kopiecki/anc/docs/polsl/sd1/main.tex

\documentclass{beamer}

\usetheme{Boadilla}
\usepackage{polski}
\usepackage{times}
\usepackage[T1]{fontenc}
\usepackage{graphicx}
\usepackage{listings}
\usepackage{hyperref}
\usefonttheme{serif}

\title{Seminarium dyplomowe}
\subtitle{Układ aktywnego tłumienia hałasu pod nadzorem jądra systemu Linux z rozszerzeniami real-time}

\author{Daniel Kopiecki}
\institute{Politechnika Śląska}
\date{\today}

\begin{document}

\begin{frame}
\titlepage
\end{frame}

\begin{frame}
\frametitle{Część sprzętowa}
\framesubtitle{Uproszczony schemat architektury}
\begin{figure}[H]
\centering
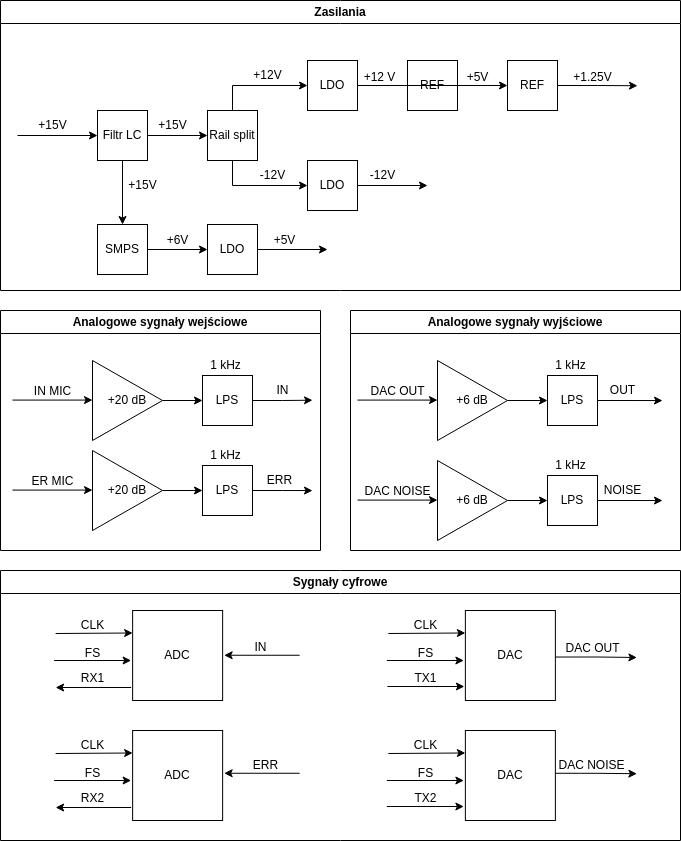
[picture p46: docs/polsl/sd1/build/images/arch.png]

\caption{Architektura sprzętowa}
\end{figure}
\end{frame}

\begin{frame}
\frametitle{Część sprzętowa}
\framesubtitle{Warstwa przednia}

\begin{figure}[H]
\centering
\begin{minipage}{.4\textwidth}
  \centering
  
\end{minipage}%
\begin{minipage}{.4\textwidth}
  \centering
  
\end{minipage}
\caption{Warstwa przednia, 1}
\end{figure}

\end{frame}

\begin{frame}
\frametitle{Część sprzętowa}
\framesubtitle{Warstwa przednia}

\begin{figure}[H]
\centering
\begin{minipage}{.4\textwidth}
  \centering
  
\end{minipage}%
\begin{minipage}{.4\textwidth}
  \centering
  
\end{minipage}
\caption{Warstwa przednia, 2}
\end{figure}

\end{frame}

\begin{frame}
\frametitle{Część sprzętowa}
\framesubtitle{Warstwy środkowe}

\begin{figure}[H]
\begin{minipage}{.4\textwidth}
  \centering
  
\end{minipage}%
\begin{minipage}{.4\textwidth}
  \centering
  
\end{minipage}
\caption{Warstwy środkowe}
\end{figure}

\end{frame}

\begin{frame}
\frametitle{Część sprzętowa}
\framesubtitle{Warstwa dolna}

\begin{figure}[H]
\begin{minipage}{.4\textwidth}
  \centering
  
\end{minipage}%
\begin{minipage}{.4\textwidth}
  \centering
  
\end{minipage}
\caption{Warstwa dolna}
\end{figure}
\end{frame}

\begin{frame}
\frametitle{Część sprzętowa}
\framesubtitle{Kilka ciekawych kwestii implementacyjnych}
\begin{itemize}
\item Wszystko wpływa na wszystko
\item Odległość pomiędzy ścieżkami ma \textbf{kolosalne znaczenie}
\item Kwestie obligatoryjne - rozłożenie warst (\textit{stackup}) oraz umiejscowienie komponentów
\end{itemize}
\begin{figure}[H]
\centering

\end{figure}
\end{frame}

\begin{frame}
\frametitle{Część sprzętowa}
\framesubtitle{Kilka ciekawych kwestii implementacyjnych}
\begin{itemize}
\item Płaszczyzną odniesienia dla relatywnie szybkich sygnałów cyfrowych może w równym stopniu być płaszczyzna masy, jak i płaszczyzna \textbf{zasilania}
\item Z Henry W. Ott, \textit{Electromagnetic Compatibility Engineering} - układ scalony \textbf{nie jest źródłem prądu} sam w sobie, lecz stanowi jedynie jego \textbf{sterownik}. Prawdziwym źródłem jest kondensator odsprzęgający lub/i pasożytnicza pojemność pomiędzy ścieżkami/płaszczyznami.
\end{itemize}
\begin{figure}[H]
\centering
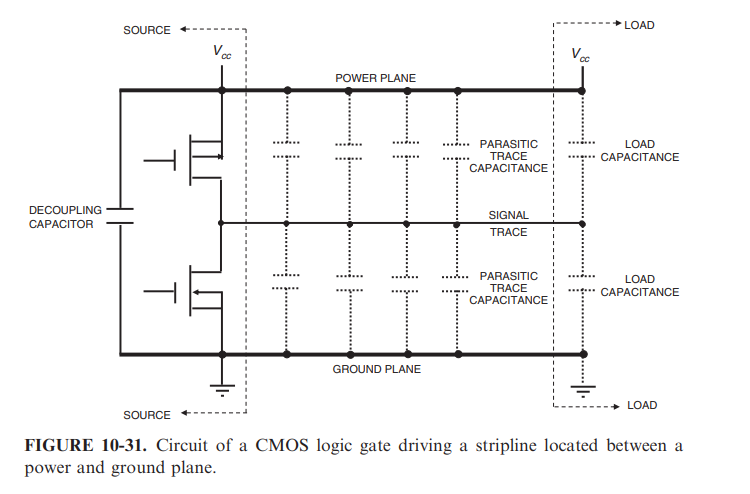
[picture p47: docs/polsl/sd1/images/l_current_flow.png]

\caption{Możliwe drogi sygnałów cyfrowych}
\end{figure}
\end{frame}

\begin{frame}
\frametitle{Część sprzętowa}
\framesubtitle{Wykorzystywany protokół cyfrowy}
\begin{itemize}
\item Bardzo ważną kwestią implementacyjną jest opracowanie synchronicznego próbkowania wszystkich przetworników. Aby to uzyskać, konieczny jest protokół cyfrowy, który zapewni zegar, odpowiednią manipulację selektorem, dwie linie RX oraz dwie linie TX.
\end{itemize}
\begin{figure}[H]
\centering
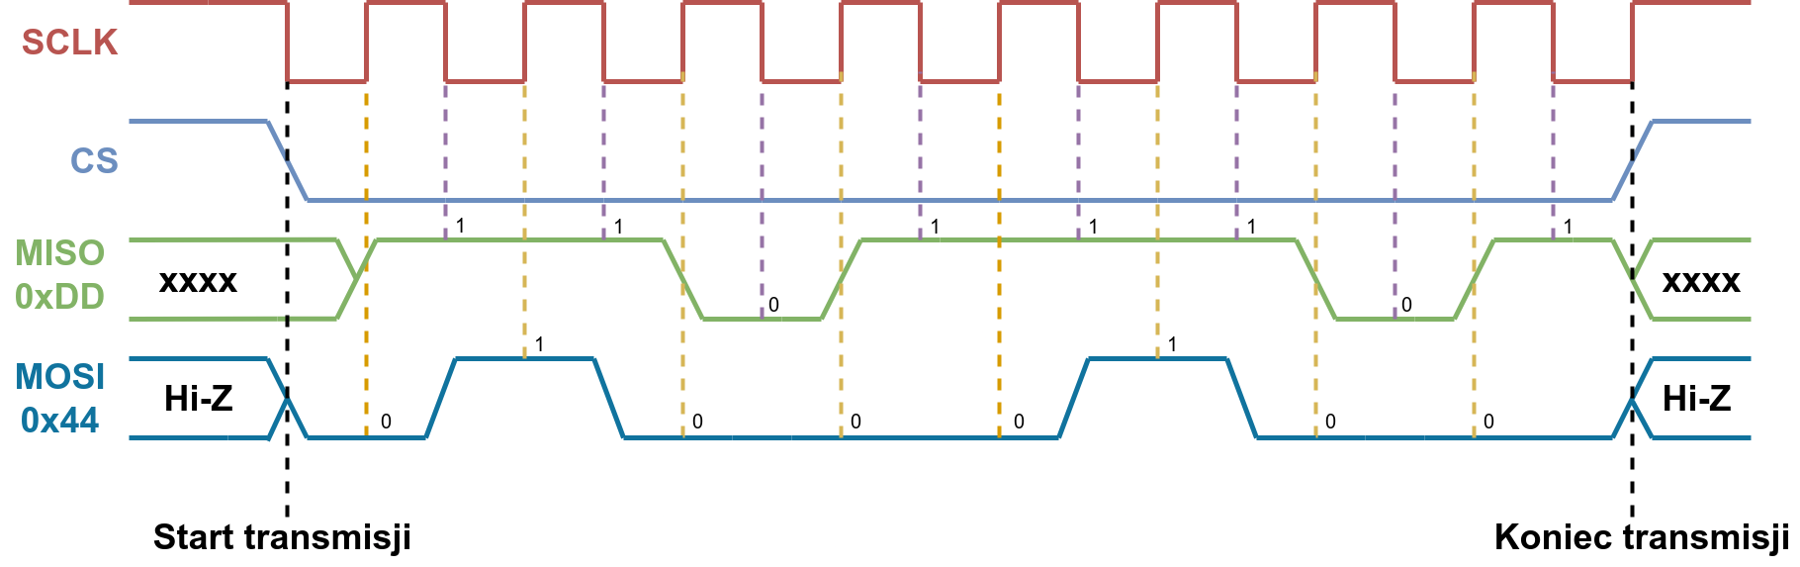
[picture p48: docs/polsl/thesis/graf/hw/spi.png]

\caption{Protokół SPI - \textit{Serial Peripheral Interface}}
\end{figure}

\end{frame}

\begin{frame}
\frametitle{Część sprzętowa}
\framesubtitle{Protokół cyfrowy - możliwe rozwiązania}
\begin{itemize}
\item McASP - protokół cyfrowy opracowany przez Texas Instruments w celu interakcji z wielokanałowymi kartami dźwiękowymi - podejście \textbf{optymalne}
\end{itemize}
\begin{figure}[H]
\centering
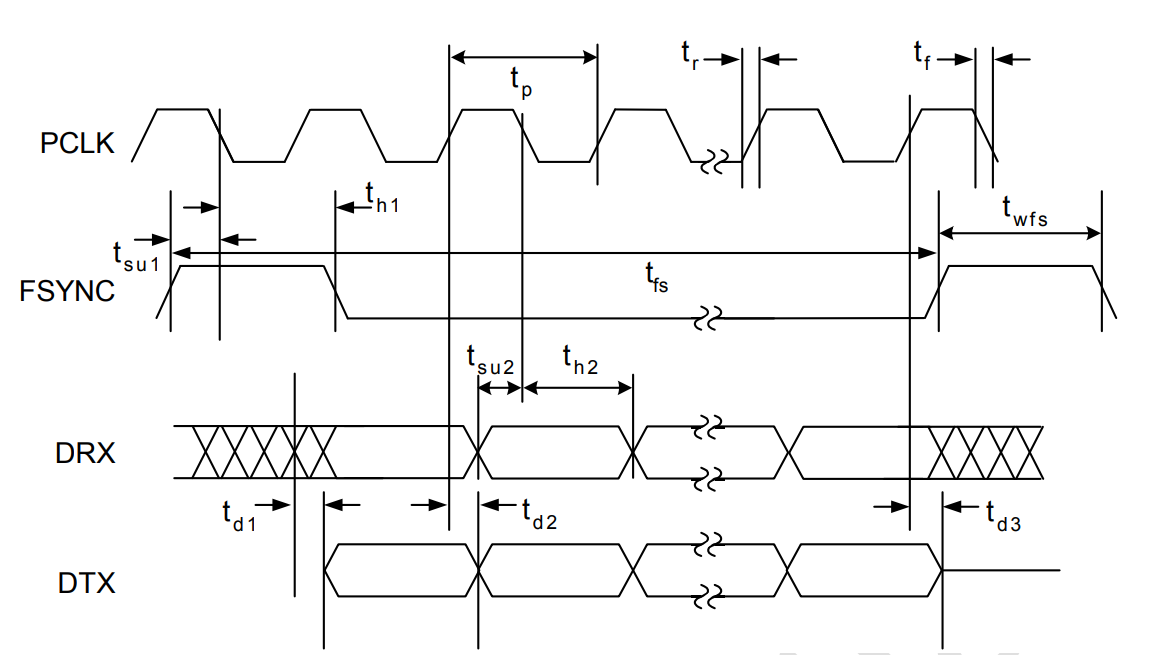
[picture p49: docs/polsl/temporary_project/build/images/mcasp.png]

\caption{Protokół McASP - \textit{Multichannel Audio Serial Port}}
\end{figure}

\end{frame}

\begin{frame}
\frametitle{Część sprzętowa}
\framesubtitle{Protokół cyfrowy - możliwe rozwiązania}
\begin{itemize}
\item \textit{Bit banging} - metoda transmisji danych oparta na implementacji dedykowanego protokołu cyfrowego z wykorzystaniem dwustanowych pinów wejściowo-wyjściowych (\textit{GPIOs}) - podejście \textbf{ostateczne}. Wymaga implementacji sterownika na najniższym poziomie.
\end{itemize}
\end{frame}

\begin{frame}[fragile]
\frametitle{Część sprzętowo-programowa}
\framesubtitle{Protokół cyfrowy - bit banging, przykład}

\begin{lstlisting}[frame=single, language=C, basicstyle=\tiny]
void tx_byte(uint8_t data)
{
	gpio_low(SD_CS);
	for (uint8_t i = 0u; i < 8u; ++i) {
		if (data & 0x80u)
			gpio_high(SD_DI);
		else
			gpio_low(SD_DI);
		
		gpio_low(SD_CLK);
		delay();
		gpio_high(SD_CLK);
		
		data <<= 1u;
	}
	
	gpio_low(SD_CS);
}
\end{lstlisting}
\end{frame}

\begin{frame}
\frametitle{Część programowa}
\framesubtitle{ALSA}
\begin{itemize}
\item Na chwilę obecną wybrana została ścieżka \textbf{optymalna}.
\item Tak jak pisano wcześniej, protokół McASP wykorzystywany jest do interakcji z kartami dźwiękowymi. 
\item Głównym środowiskiem do interakcji z urządzeniami audio pod systemem operacyjnym GNU/Linux jest \textbf{ALSA} (\textit{Advanced Linux Sound Architecture})

\begin{figure}[H]
\centering
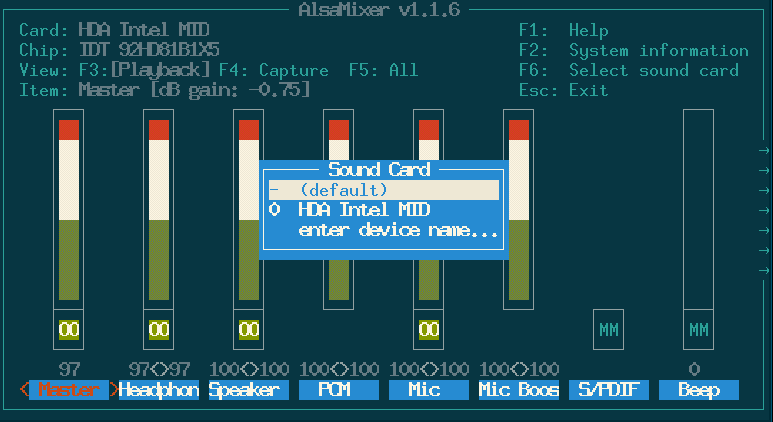
[picture p50: docs/polsl/sd1/images/alsamixer.png]

\caption{ALSA - widok aplikacji \textit{AlsaMixer} (\$ alsamixer)}
\end{figure}

\end{itemize}
\end{frame}

\begin{frame}
\frametitle{Część programowa}
\framesubtitle{ALSA}
\begin{itemize}
\item \textbf{ALSA} udostępnia duże, niskopoziomowe API do interakcji z kartami dźwiękowymi z poziomu przestrzeni użytkownika (\textit{userspace}).
\item Plik nagłówkowy biblioteki nosi nazywę \textit{asoundlib.h} a sama biblioteka \textit{libasound}
\end{itemize}

\begin{figure}[H]
\centering
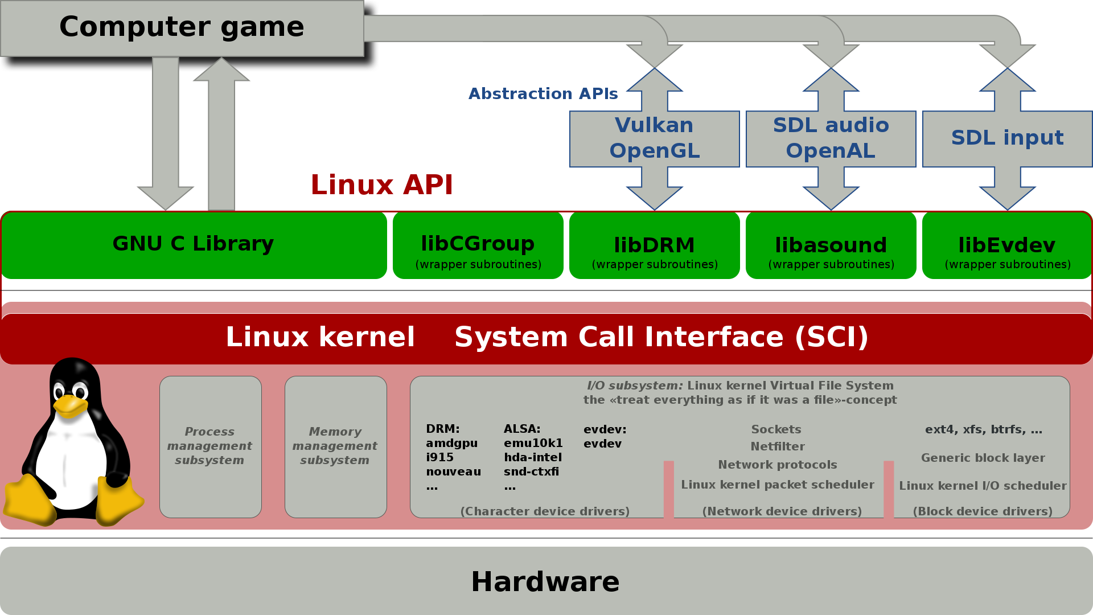
[picture p51: docs/polsl/sd1/images/alsa.png]

\caption{Schemat interkacji jądro - przestrzeń użytkownika}
\end{figure}

\end{frame}

\begin{frame}
\frametitle{Część programowa}
\framesubtitle{Cyfrowa reprezentacja dźwięku}
\begin{itemize}
\item Cyfrową reprezentacją dźwięku, wykorzystywaną przez środowisko \textbf{ALSA} jest modulacja pulsowo-kodowa (\textit{PCM - Pulse Code Modulation})

\begin{figure}[H]
\centering
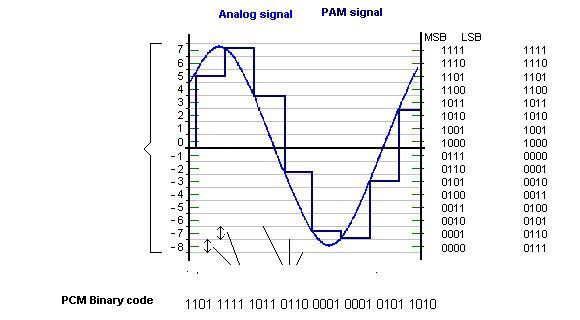
[picture p52: docs/polsl/sd1/build/images/pcm.jpg]

\caption{Modulacja pulsowo-kodowa}
\end{figure}

\end{itemize}

\end{frame}

\begin{frame}
\frametitle{Część programowa}
\framesubtitle{ALSA}
\begin{itemize}
\item ALSA korzysta ze specjalnego nazewnictwa urządzeń dźwiękowych dostępnych dla użytkownika. Mogą to być rzeczywiste urządzenia (karty dźwiękowe), lub ich wirtualne reprezentacje.
\item W przypadku fizycznych urządzeń, korzysta się z formatu \textit{hw:i,j}, gdzie \textit{i} oznacza numer karty, a \textit{j} numer urządzenia kontrolowanego przez kartę, czyli przypkładowo zestawu głośników lub mikrofonu.
\item W przpyadku wirtualnych urządzeń, korzysta się z formatu \textit{plughw:i, j}.
\end{itemize}

\begin{figure}[H]
\centering
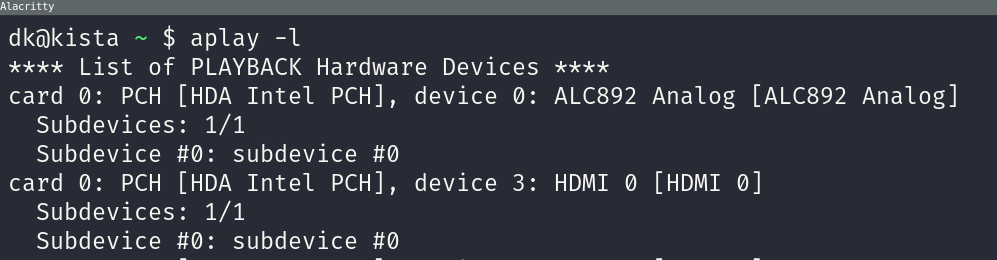
[picture p53: docs/polsl/sd1/build/images/aplay.png]

\caption{Rezultat polecenia \textit{aplay -l}}
\end{figure}

\end{frame}

\begin{frame}
\frametitle{Część programowa}
\framesubtitle{ALSA - lokowanie próbek}
\begin{itemize}
\item Na poziomie sterownika jądra sprzętu audio, \textbf{ALSA} tworzy bufor cykliczny, którego długość można modyfikować używając udostępnionego API.
\item Jeżeli bufor jest zapełniony, sterownik jądra generuje przerwanie. Rolę obsługi przerwania obejmuje DMA (\textit{Direct Memory Access}), które nieblokująco przenosi próbki z bufora sterownika do bufora aplikacji.
\end{itemize}

\begin{figure}[H]
\centering

\caption{Bufor cykliczny}
\end{figure}
\end{frame}

\begin{frame}
\frametitle{Część programowa}
\framesubtitle{ALSA - lokowanie próbek}
\begin{itemize}
\item Bufor tworzony przez sterownik jądra zapełniany jest przez \textbf{fragmenty} (lub okresy, \textit{periods}).
\item \textbf{Fragmenty} składają się z określonej liczby \textbf{ramek} (\textit{frames}).
\item \textbf{Ramka} składa się z próbek dla każdego kanału karty dźwiękowej (liczba kanałów może być wyspecifikowana, tak jak format próbki).
\end{itemize}

\begin{figure}[H]
\centering
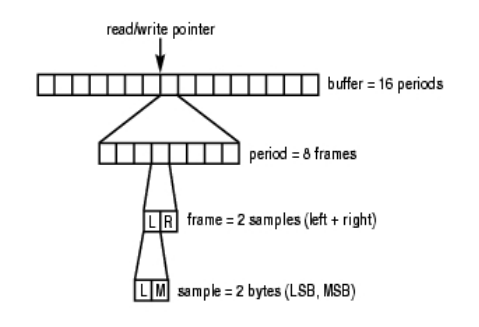
[picture p54: docs/polsl/sd1/images/alsa_frames.png]

\caption{Podział danych}
\end{figure}
\end{frame}
\begin{frame}
\frametitle{Część programowa}
\frametitle{ALSA - bufory}
\begin{itemize}
\item Jeżeli aplikacja jest uruchomiona, to dane w nieprzerwany sposób są transportowane z/do bufora cyklicznego sterownika jądra do/z bufora aplikacji.
\item W przypadku odczytywania danych (\textit{capture}), jeżeli nie są one odpowiednio szybko czytane, to może dojść do sytuacji, kiedy dane w buforze cyklicznym zostaną nadpisane nowymi. Taka sytuacja nosi nazwę \textbf{buffer overrun}.
\item W przypadku zapisywania danych (\textit{playback}), jeżeli nie są one odpowiednio szybko wysyłane, to może dojść do odwrotnej sytuacji, czyli bufor cykliczny w pewnym momencie się całkowicie opróżni. Taka sytuacja nosi nazwę \textbf{buffer underrun}.
\end{itemize}

\end{frame}

\begin{frame}
\frametitle{Część programowa}
\framesubtitle{ALSA - latencja}
\begin{itemize}
\item Bardzo ważnym pojęciem związanym z przetwarzaniem sygnału audio jest \textbf{latencja}
\item \textbf{Latencja} to nic innego jak opóźnienie, które towarzyszy sygnałowi audio od momentu trafienia na wejście systemu do jego opuszczenia.
\item W środowisku \textbf{ALSA} latencja definiowana jest następującą zależnością:
\begin{equation}
	T_L = \frac{n_fF_{rb}}{f_sP_{rb}}
\end{equation}
gdzie $n_f$ - ilość fragmentów, $F_{rb}$ - rozmiar fragmentu w bajtach, $f_s$ - częstotliwość próbkowania, $P_{rb}$ - rozmiar próbki w bajtach. 
\item Licznik równania to nic innego jak zadeklarowany rozmiar bufora w bajtach, czyli całe wyrażenie odpowiada czasowi potrzebnemu na przesłanie całego bufora (zbuforowaniu danych).
\end{itemize}
\end{frame}

\begin{frame}
\frametitle{Część programowa}
\framesubtitle{ALSA - latencja}
Przykładowo
\begin{itemize}
\item Chcąc odtworzyć dźwięk z szesnatostobitowego systemu stereo (dwa kanały, głośnik lewy i prawy, próbki po 16 bitów $=$ 2 bajty) z typową częstotliwością audio równą 44100 kHz, nasza \textbf{ramka} ma rozmiar 4 bajtów (dwie dwu-bajtowe próbki, jedna na kanał). Deklarując rozmiar \textbf{fragmentu} na 2048 \textbf{ramek}, otrzymujemy długość \textbf{fragmentu} w bajtach równą 8192 bajtów.
\item Deklarując rozmiar bufora na dwa fragmenty, otrzymujemy rozmiar bufora równy 16384 bajtów.
\item Zbuforowanie tych danych, definiujące latencję, w tak skonstruowanym systemie zajmie $\frac{16384}{44100 * 4} \approx 0.093$ s.
\end{itemize}
\end{frame}

\begin{frame}[fragile]
\frametitle{Część programowa}
\framesubtitle{ALSA - przykładowy prosty program}
\begin{lstlisting}[language=C, basicstyle=\tiny]
int playback(uint8_t* const buffer, size_t size)
{
        const uint8_t channels        = 1;
        const uint32_t rate           = 48000;
        const char* pcm_name          = "hw:0,0";
        const snd_pcm_stream_t stream = SND_PCM_STREAM_PLAYBACK;
        const snd_pcm_format_t format = SND_PCM_FORMAT_U8;
        const snd_pcm_access_t access = SND_PCM_ACCESS_RW_INTERLEAVED;
        const uint32_t latency_us     = 500000u;

        snd_pcm_t* pcm_handle = NULL;
        int error             = snd_pcm_open(&pcm_handle, pcm_name, stream, 0);
        if (error < 0)
                return error;

        error = snd_pcm_set_params(
                pcm_handle, format, access, channels, rate, true, latency_us);
        if (error < 0)
                return error;

        for (uint8_t i = 0u; i < 16u; ++i) {
                snd_pcm_sframes_t transfered_frames =
                        snd_pcm_writei(pcm_handle, buffer, size);
                if (transfered_frames < 0)
                        xrun_recover(pcm_handle, transfered_frames, 0);
                else if ((transfered_frames > 0) && (transfered_frames < size))
                        LOG_ERROR("Short write!");
        }

        snd_pcm_drain(pcm_handle);
        snd_pcm_close(pcm_handle);
}
\end{lstlisting}

\end{frame}
\begin{frame}
\frametitle{Wykorzystane materiały}
\begin{itemize}
\item Henry W. Ott, \textit{Electromagnetic Compatibillity Engineering}
\item \href{www.alsa-project.org/wiki}{Strona domowa projektu ALSA}
\item \href{https://www.linuxjournal.com/article/6735}{Jeff Tranter, \textit{Introduction to Sound Programming with ALSA}}, Linux Journal
\end{itemize}
\end{frame}

\end{document}
