kopiecki/anc/docs/polsl/SD1.pdf

## UKŁAD AKTYWNEGO TŁUMIENIA HAŁASU POD NADZOREM JĄDRA SYSTEMU LINUX Z ROZSZERZENIAMI REAL-TIME

Daniel Kopiecki
Promotor: dr inż. Krzysztof Mazur

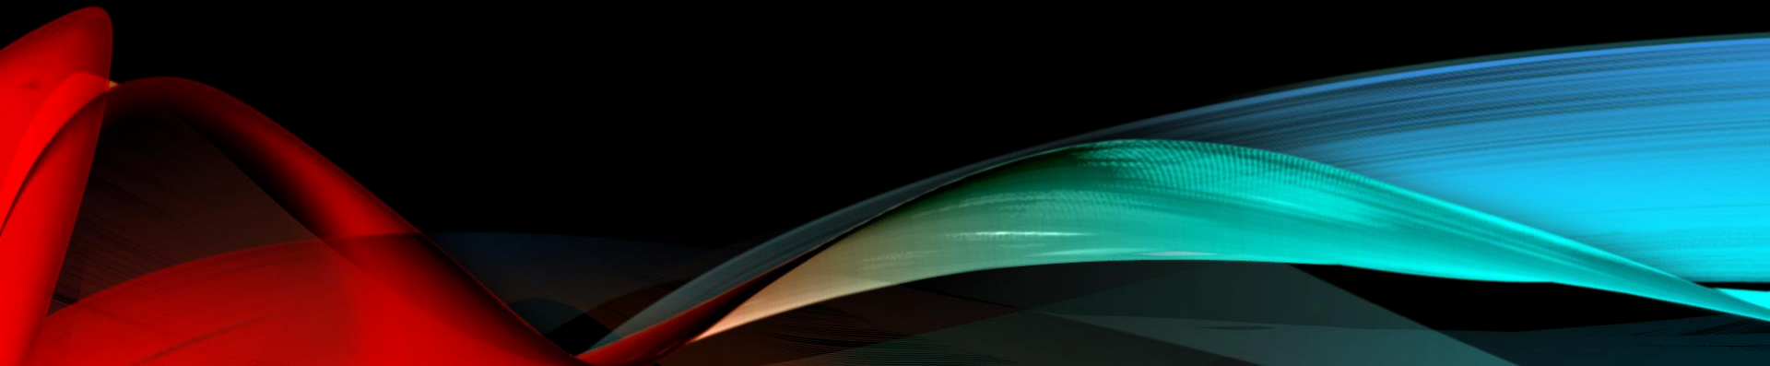
[picture p130: figure]

## PLAN PREZENTACJI

- Główna idea, cel projektu
- Zasada działania
- Schematy ideowe docelowego układu
- Wykorzystywane narzędzia i sprzęt
- Poczynione prace
- Plan na najbliższy czas
- Podsumowanie

## GŁÓWNA IDEA, CEL PROJEKTU

- Zaprojektowanie i sporządzenie sprzętu pozwalającego na akwizycję pomiarów z dwóch mikrofonów, cyfrowe przetwarzanie uzyskanych danych oraz odpowiednie wysterowanie głośnika sygnałem wyjściowym (PCB)
- Kompilacja niestandardowego systemu operacyjnego GNU/Linux na architekturę ARM z uwzględnionymi odpowiednimi sterownikami oraz włączonymi rozszerzeniami real-time
- Implementacja oprogramowania cyfrowego przetwarzania uzyskanych danych, identyfikacji odpowiedzi impulsowej toru dźwięku oraz regulatora adaptacyjnego

CEL: Stworzenie układu pozwalającego na aktywne tłumienie hałasu generowanego sztucznie (zakres do 500 Hz)

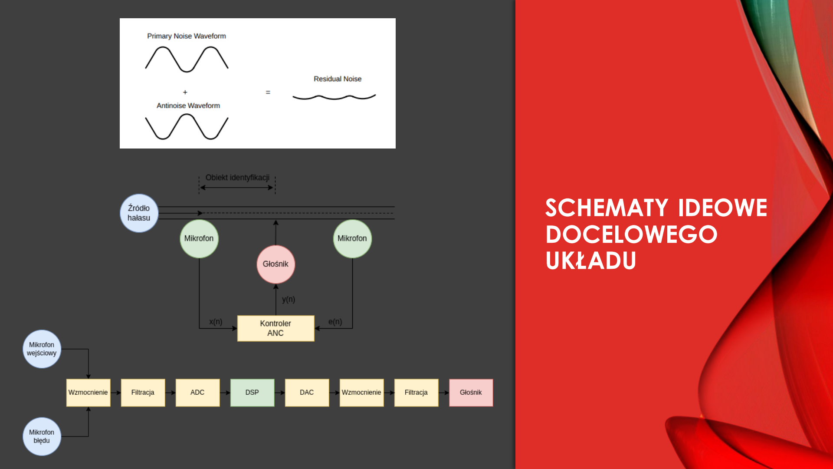
[picture p131: page 4]

SCHEMATY IDEOWE
DOCELOWEGO
UKŁADU

## WYKORZYSTYWANY SPRZĘT

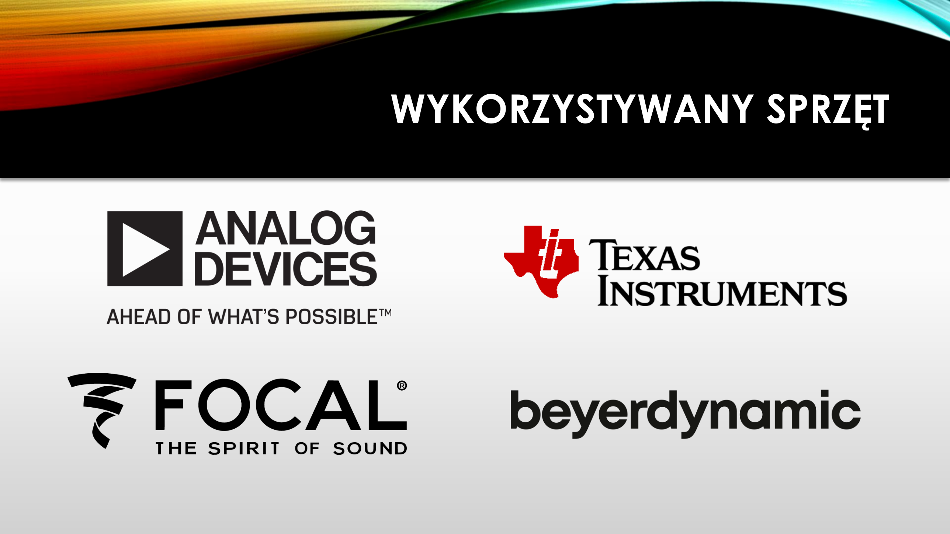
[picture p132: page 5]

## WYKORZYSTYWANE OPROGRAMOWANIE

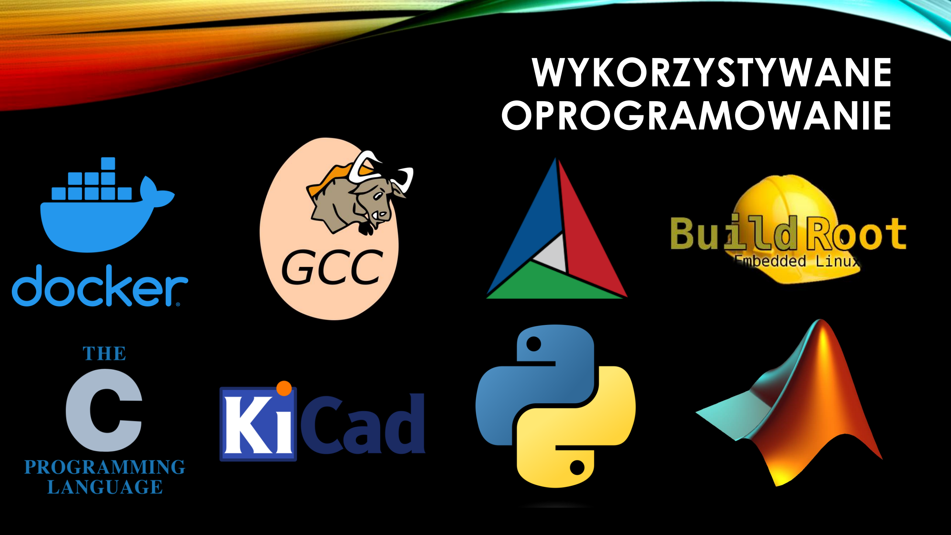
[picture p133: page 6]
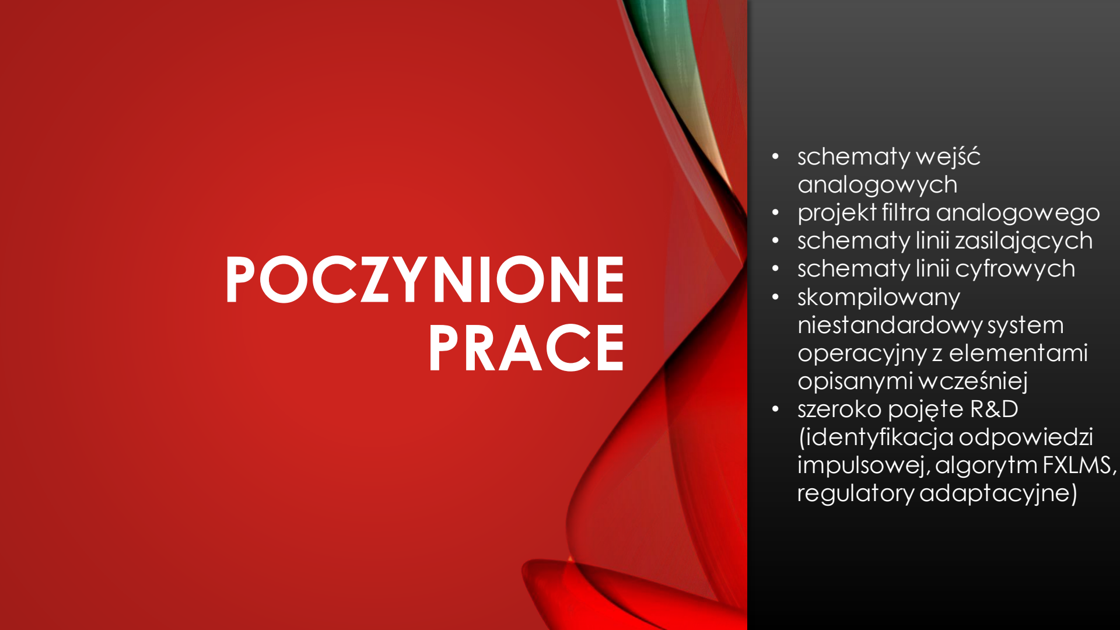
[picture p134: page 7]

# POCZYNIONE PRACE

- schematy wejść
analogowych
- projekt filtra analogowego
- schematy linii zasilających
- schematy linii cyfrowych
- skompilowany
niestandardowy system
operacyjny z elementami
opisanymi wcześniej
- szeroko pojęte R&D
(identyfikacja odpowiedzi
impulsowej, algorytm FXLMS, regulatory adaptacyjne)

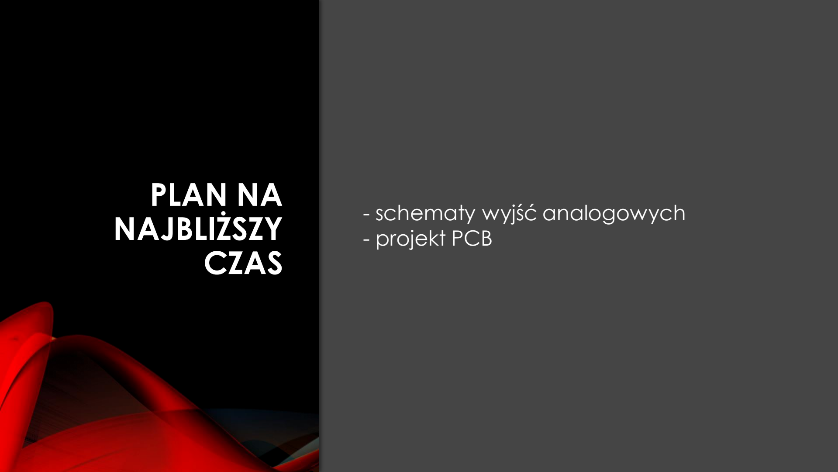
[picture p135: page 8]

## PLAN NA NAJBLIŻSZY CZAS

- schematy wyjść analogowych
- projekt PCB

## DZIEKUJĘ ZA UWAGĘ
