kopiecki/anc/docs/polsl/thesis/chapters/04.tex

\chapter{Implementacja części sprzętowej}

Diagram opisujący zaimplementowaną architekturę sprzętową przedstawiono na
rysunku \ref{hw::arch}:

\begin{figure}[H]
    \centering
    
    \caption{Architektura sprzętowa --- najwyższy poziom.}
    \label{hw::arch}
\end{figure}

\par Jak można zauważyć, na architekturę zaprojekowanej płytki drukowanej
składają się cztery główne sekcje, które komunikują się z~elementami
zewnętrznymi zaznaczonymi na szaro. Z~sekcji można wyróżnić:
\begin{itemize}
    \item Sekcję zasilania (\textbf{PSU}, ang. \textit{Power supply unit}).
    \item Sekcję wejściowych torów analogowych (\textbf{Input}, wejście).
    \item Sekcję wyjściowych torów analogowych (\textbf{Output}, wyjście).
    \item Sekcję przetworników (\textbf{ADC/DAC}).
\end{itemize}

Na diagramie konektory o~najmniejszej grubości reprezentują sygnały analogowe,
z~których można wyróżnić:
\begin{itemize}
    \item $x(t)$ --- sygnał z~mikrofonu referencyjnego przy źródle hałasu.
    \item $e(t)$ --- sygnał z~mikrofonu błędu, mierzącego superpozycję hałasu
    i~antyhałasu.
    \item $y_n(t)$ --- sygnał reperezentujący wygenerowany hałas.
    \item $y_{\text{an}}(t)$ --- sygnał reperezentujący obliczony antyhałas.
\end{itemize}

Każdy z wyszczególnionych wyżej sygnałów analogowych posiada swoje przetworzone
odpowiedniki, które na schemacie zaznaczono z~apostrofem. Pogrubionymi
konektorami zaznaczono szyny zasilania i~są to odpowiednio:
\begin{itemize}
    \item \textbf{AP} (ang. \textit{Analog power}) --- zasilanie sekcji
    analogowych.
    \item \textbf{DP} (ang. \textit{Digital power}) --- zasilanie sekcji
    cyfrowych.
\end{itemize}

Dużą strzałką zaznaczono wykorzystywany protokół cyfrowy, czyli McASP (ang.
\textit{Multi-channel serial port}), który dokładniej opisywany będzie w~sekcji
interfejsu cyfrowego.

\section{Urządzenia zewnętrzne}

\subsection{Mikrofony}

W projekcie wykorzystano mikrofony Behringer ECM8000. Są one bardzo często
wybierane przez amatorów jak i~profesjonalistów w~zastosowaniach pomiarowych
oraz cieszą się dobrymi opiniami. Ich droższym odpowiednikiem jest flagowy
Beyerdynamic MM1, a~najbardziej znaczące parametry \cite{bib:behringer}
przedstawiono poniżej:
\begin{enumerate}
    \item \textbf{Typ} --- pojemnościowy, phantom 15~V do 48 V.
    \item \textbf{Charakterystyka kierunkowa} --- kulista.
    \item \textbf{Odpowiedź częstotliwościowa} --- relatywnie płaska,
    z~pofalowaniami w~paśmie od 5~kHz do 10 kHz i~zakresie od 20~Hz do 20000 Hz.
    \item \textbf{Czułość} --- $15 \text{ }\frac{\text{mV}}{{\text{Pa}}}$.
\end{enumerate}
Czułość mikrofonów informuje o~wartości napięcia dla danego ciśnienia
aktustycznego i~opisuje ją zależność:
\begin{equation} 
        S_{\text{dBV}} = 20 \text{log}_{10} \frac{S_{\text{mV/Pa}}}{U_{\text{ref}}},
        \qquad U_{\text{ref}} = 1000 \text{ }\frac{\text{mV}}{\text{Pa}}.
\end{equation}

Na podstawie tego parametru dobiera się wzmocnienie przedwzmacniacza
\cite{bib:mic}. Dla wybranych mikrofonów z~czułością na poziomie $15 \text{
}\frac{\text{mV}}{{\text{Pa}}}$, uzyskuje się 15~mV dla 1~Pa, co odpowiada 94 dB
SPL. Pracując na hałasach w zakresie od 85 dB SPL do 105 dB SPL, dla górnej
granicy otrzymuje się około 3.5~Pa, czyli odpowiednio około 52.5~mV RMS, co
odpowiada amplitudzie $52.5\sqrt{2}$~mV. W~przypadku przetwornika
analogowo-cyfrowego, pracującego w przedziale od 0 V do 5~V, $52.5\sqrt{2}$~mV z
mikrofonu powinno odpowiadać maksymalnemu zakresowi 2.5~V, co pozwala na
obliczenie wzmocnienia:
\begin{equation}
        k = \frac{U_{\text{out}}}{U_{\text{mic}}} = 
	    \frac{2.5}{0.0525\sqrt{2}} =  33.6717.
        \label{eq::k_preamp}
\end{equation}

\subsection{Zestaw głośnikowy}

Na użytek prywatny, autor posiada parę monitorów studyjnych KRK Classic 8,
spełniających wszystkie wyszczególnione dla zestawu głośników wymagania. Nie
wchodząc w techniczne szczegóły, z~najbardziej znaczących parametrów
\cite{bib:krk} można wyróżnić:

\begin{enumerate}
    \item \textbf{Typ i~konfiguracja} --- aktywny, głośnik wysoko i~nisko tonowy.
    \item \textbf{Maksymalny zakres poziomu akustycznego} --- 103 dB SPL.
    \item \textbf{Charakterystyka częstotliwościowa} --- od 42.5~Hz do 35000 Hz
    do $\pm 3$ dB.
    \item \textbf{SNR} --- powyżej 100 dB.
\end{enumerate}

\subsection{Platforma obliczeniowa}

Analizując rynek w~poszukiwaniu tanich i~popularnych układów spełniających
założone wymagania, wyboru można dokonać tak właściwie spośród dwóch platform.
Jest to oparte na module BCM2837B0 firmy Broadcom Raspberry Pi \cite{bib:rpi}
oraz oparty na module Sitara AM3358 firmy Texas Instruments
BeagleBone\textsuperscript{\textregistered} Black \cite{bib:bbb}. Platformy są
w~podobnych cenach i~wykorzystuje się je w~równie podobnych zastosowaniach. \par
Argumentem przemawiającym za wyborem jednej z~nich były wspierane interfejsy
cyfrowe, których przeglądu i~analizy dokonano na podstawie założeń projektowych.
W trakcie tego przeglądu, przeanalizowana została nota aplikacyjna
\cite{bib:sitara}, opisująca akwizycję danych z~macierzy mikrofonowej w~oparciu
o interfejs McASP (ang. \textit{Multi-channel audio serial port}) z
wykorzystaniem procesora sygnałowego oraz układu
BeagleBone\textsuperscript{\textregistered} Black. Opisywany interfejs jest
dedykowanym mechanizmem komunikacji w~wielokanałowych systemach audio
realizowanych w~układach firmy Texas Instruments i~nie posiada swojego
odpowiednika na platformach Raspberry Pi. Z~tego powodu wybór okazał się prosty
i jako wykorzystaną platformą obliczeniową wykorzystano płytkę
BeagleBone\textsuperscript{\textregistered} Black. Z~kwestii dodatkowych, moduł
Sitara AM3358 posiada sprzętową realizację działań zmiennoprzecinkowych (FPU)
oraz koprocesor NEON\textsuperscript{\texttrademark} (SIMD).

\section{Zasilanie}

Diagram dystrybucji zasilania przedstawiono na rysunku \ref{hw::power_dist}:

\begin{figure}[H]
    \centering
    
    \caption{Diagram dystrybucji zasilania.}
    \label{hw::power_dist}
\end{figure}

Wykorzystane symbole zostały wyjaśnione poniżej:
\begin{itemize}
    \item \textbf{EXT} (ang. \textit{External}) --- zasilanie zewnętrzne.
    \item \textbf{LDO} (ang. \textit{Low dropout regulator}) --- linowy regulator
    napięcia niskiego spadku.
    \item \textbf{REF} (ang. \textit{Reference voltage}) --- generator napięcia
    referencyjnego.
    \item \textbf{SMPS} (ang. \textit{Switching-mode power supply}) --- zasilacz
    impulsowy.
\end{itemize}

\subsection{Sekcja wejściowa}

Układ zasilany jest z~zewnętrznego zasilacza impulsowego o~napięciu wyjściowym
15 V. Zasilacze impulsowe znane są wysokiej, wynikającej z~przełączania
wewnętrznego klucza tranzystorowego, fluktuacji napięcia wyjściowego (ang.
\textit{ripple}), które w~przypadku dobranego zasilacza wynosi maksymalnie 240
mV p-p \cite{bib:xp}. Na uwadze należy również mieć zakłócenia pochodzące
z~sieci, dlatego typowym rozwiązaniem stosowanym w sekcjach wejściowych układów
elektronicznych jest zastosowanie dolnoprzepustowego filtru LC
\cite{bib:tietze}, mającego za zadanie wygładzenie zewnętrznego zasilania jak
i~zapewnienie bufora do dalszych konwersji. Taki filtr opisany jest zależnością,
wynikającą z uogólnionego równania dzielnika napięciowego:
\begin{equation}
    U_{wy}(s) = U_{\text{we}}(s) \frac{Z_1}{Z_1 + Z_2} = U_{we}(s)\frac{\frac{1}{Cs}}{Ls + \frac{1}{Cs}}
        \implies K_{LC}(s) = \frac{1}{LCs^2 + 1}.
    \label{eq:lc_lp}
\end{equation}
w dziedzinie symbolicznej natomiast $(s = j\omega)$:
\begin{equation}
    K_{LC}(j\omega) = \frac{1}{1 - \omega^2LC}.
\end{equation}

Częstotliwość rezonansowa takiego układu wynosi:
\begin{equation}
    \omega_c = 2\pi f_c \implies f_c = \frac{1}{2\pi\sqrt{LC}}.
\end{equation}

Zależność \ref{eq:lc_lp} przedstawia idealny model układu LC. W~rzeczywistości
każdy element pasywny posiada swoją rezystancję, przez co układ LC staje się
układem RLC, określonym zależnością:
\begin{equation}
    U_{wy}(s) = U_{we}(s) \frac{Z_1}{Z_1 + Z_2} = U_{we}(s)\frac{\frac{1}{Cs}}{R + Ls + \frac{1}{Cs}}
        \implies K_{LP}(s) = \frac{1}{LCs^2 + RCs + 1}.
    \label{eq:lc_lp}
\end{equation}

Rezystor w takim układzie wprowadza tłumienie, z~czego wynika współczynnik
tłumienia oraz dobroć. Wielkości te określone są odpowiednio:
\begin{equation}
    \zeta = \frac{1}{2Q}, \qquad
    \label{eq::zeta}
\end{equation}
\begin{equation}
    Q = \frac{1}{R}\sqrt{\frac{L}{C}}.
\end{equation}

Współczynnik tłumienia może znajdować się w~czterech typach zakresów:
\begin{enumerate}
    \item $\zeta = 0$ --- brak tłumienia, nieskończone oscylacje.
    \item $\zeta > 0$ i~$\zeta < 1$ --- tłumienie subkrytyczne, oscylacje są
    wygaszane po pewnym czasie.
    \item $\zeta = 1$ --- tłumienie krytyczne bez oscylacji.
    \item $\zeta > 1$ --- nadmierne tłumienie.
\end{enumerate}

Przy projektowaniu tego typu układów oczekuje się, że będą tłumione krytycznie.
Oznacza to, że układ jest na granicy oscylacji, a~pik rezonansowy na
charakterystyce częstotliwościowej jest nabliższy zakresowi pasma przenoszenia,
które nie jest tłumione (możliwe płaskie) \cite{bib:lc}. Podstawiając $\zeta =
1$ w równaniu \ref{eq::zeta} otrzymuje się:
\begin{equation}
    L = \frac{R\sqrt{2}}{\omega_0}, \qquad 
    C = \frac{1}{\omega_0 R\sqrt{2}}.
\end{equation}

Jako rezystancję przyjęto rezystancję wewnętrzną cewki. W~zaprojektowanym
układzie $L = 4.7 \text{ }\mu$H i~$C = 1080 \text{ }\mu$F, z~czego wynika $f_c
\approx 2.47$ kHz oraz warunek na rezystancję cewki:
\begin{equation}
    R = \sqrt{\frac{L}{2C}} = \sqrt{\frac{4.7}{2160}} \approx 46.6 \text{ m}\Omega.
\end{equation}

W układzie dobrano dostępną wartość najbliższą obliczeniom i~wynosi ona $74.8
\text{ m}\Omega$. Warto zaznaczyć, że przy doborze rzeczywistych wartości
elementów, w~tym przypadku lepiej wybrać element o~wartości zawyżonej niż
zaniżonej, ponieważ bardziej oczekiwane jest uzyskanie większego tłumienia, niż
wzmocnienie pasma rezonansowego. Omawiany schemat układu wraz z dołożonymi
kondensatorami zapewniającymi dodatkowe buforowanie i~filtrację średnich
częstotliwości przedstawiono na rysunku \ref{hw::input}:

\begin{figure}[H]
    \centering
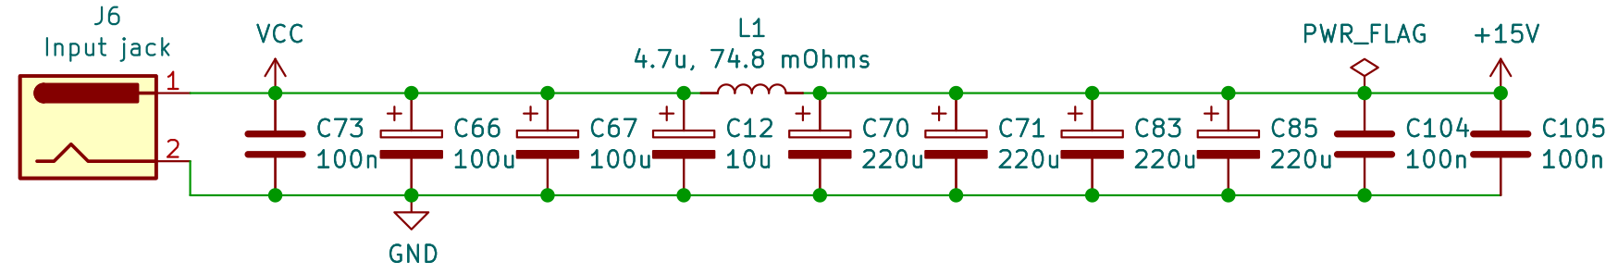
[picture p148: docs/polsl/thesis/graf/hw/input.png]
    
    \caption{Sekcja wejściowa.}
    \label{hw::input}
\end{figure}

Tak przygotowanie napięcie 15 V jest podstawą do generacji pozostałych zasilań
w~układzie, jak i~również wykorzystywane jest jako zasilanie phantomowe
mikrofonów.

\subsection{Symetryzacja szyn zasilających}

Przetwarzany sygnał akustyczny jest symetryczny wokół zera, więc jednym
z~możliwych rozwiązań jest generacja symetrycznego zasilania dla wzmacniaczy w
sekcji torów analogowych, odpowiednio wysokiego, aby nie doporowadzać do
saturacji ich wyjść. Wybranym zasilaniem jest $\pm$12 V, a~szczegóły dotyczące
tego wyboru będą dokładniej opisywane w~sekcji torów analogowych. \par
Stosunkowo sporo czasu poświęcono kwesti generacji ujemnego zasilania.
W~literaturze \cite{bib:art} \cite{bib:tietze} opisanych jest wiele sposobów
implementacji tego typu układów, z~czego najbardziej popularnymi są inwertery
napięciowe zaimplementowane w~oparciu o wzmacniacze operacyjne lub dedykowane
przetwornice (ang. \textit{buck-boost}). Rozwiązanie oparte o~skonstruowanie
układu inwerterów zostało odrzucone z~powodu dodatkowego nakładu pracy. Taki
system, poza układem odwracającym napięcie (ang. \textit{rail splitter})
wymagałby dodatkowego wzmacniacza mocy na wyjściu, co jest spowodowane
zapotrzebowaniem prądowym wzmacniaczy, według specyfikacji wynoszącym typowo 1.4
mA na układ. Jako, że w projekcie wykorzystywanych jest pięć wzmacniaczy
operacyjnych na kanał, a kanałów jest cztery, to wymaganiem jest, aby wydajność
prądowa wykorzystanego generatora ujemnego napięcia wynosiła 28 mA. Wyborów
dedykowanej przetwornicy został odrzucony z powodu niskiej dostępności układów
zgodnych z~założoną specyfikacją na rynku. \par Wynikowo zdecydowano się na
wykorzystanie układu odwracającej pompy ładunków, który spełnia wszystkie
założenia projektowe~i jest wydajna prądowo (maksymalny pobierany prąd równy 100
mA). Minusem układu jest mała dokładność napięcia wyjściowego z~fluktuacjami,
które według dokumentacji \cite{bib:ltc3261} dla wybranego trybu pracy wyniosą
10 mV. Dodatkowo, układ generuje spadek napięcia w zależności od wyjściowego
prądu, który w~przypadku 30 mA wyniesie około 750 mV. Dopuszczenie takiego
napięcia na wzmacniacze w~sekcji analogowej jest niedopuszczalne, między innymi
zważając na wskaźnik PSRR, który dla wybranych wzmacniaczy wynosi około 40 dB
dla częstotliwości 500 kHz \cite{bib:tl071} oraz niską dokładność. W związku
z~tym, napięcie wyjściowe pompy ładunków należy filtrować i~stabilizować. Jako
filtr zastosowano ponownie układ LC (rzeczywisty RLC) o~niższej częstotliwości
rezonansowej, ponieważ celem jest filtracja fluktuacji wprowadzanych przez pompę
ładunków. Dla dobranego $L = 3.3 \text{ }\mu$H i~$C = 57 \text{ }\mu$F uzyskano
$f_c \approx 12.18$ kHz oraz warunek na rezystancję cewki $R \approx 170 \text{
m}\Omega$, który spełniono wybierając najbliższą dostepną wartość równą 250
m$\Omega$. Przefiltrowane ujemne napięcie trafia następnie wraz z~jego dodatnim
odpowiednikim na układy liniowych regulatorów napięcia o~małym spadku (LDO, ang.
\textit{Low-dropout}), których celem jest stabilizacja oraz zwiększenie
dokładności. Wykorzystane układy według specyfikacji dla zakresu pracy od 12 V
do 15 V posiadają dokładność równą 2.5\%, wydajność prądową równą maksymalnie 1
A oraz średni stosunek tłumienia zakłóceń równy 66 dB dla częstotliwości powyżej
100 kHz i~prądu wyjściowego równego 10 mA \cite{bib:lm2940} \cite{bib:lm2990}.
Omawiany układ wraz z~dołożonymi kondensatorami odsprzęgającym, których wartości
dobierane były według not aplikacyjnych producenta przedstawiono na rysunku
\ref{hw::split}.

\begin{figure}[H]
    \centering
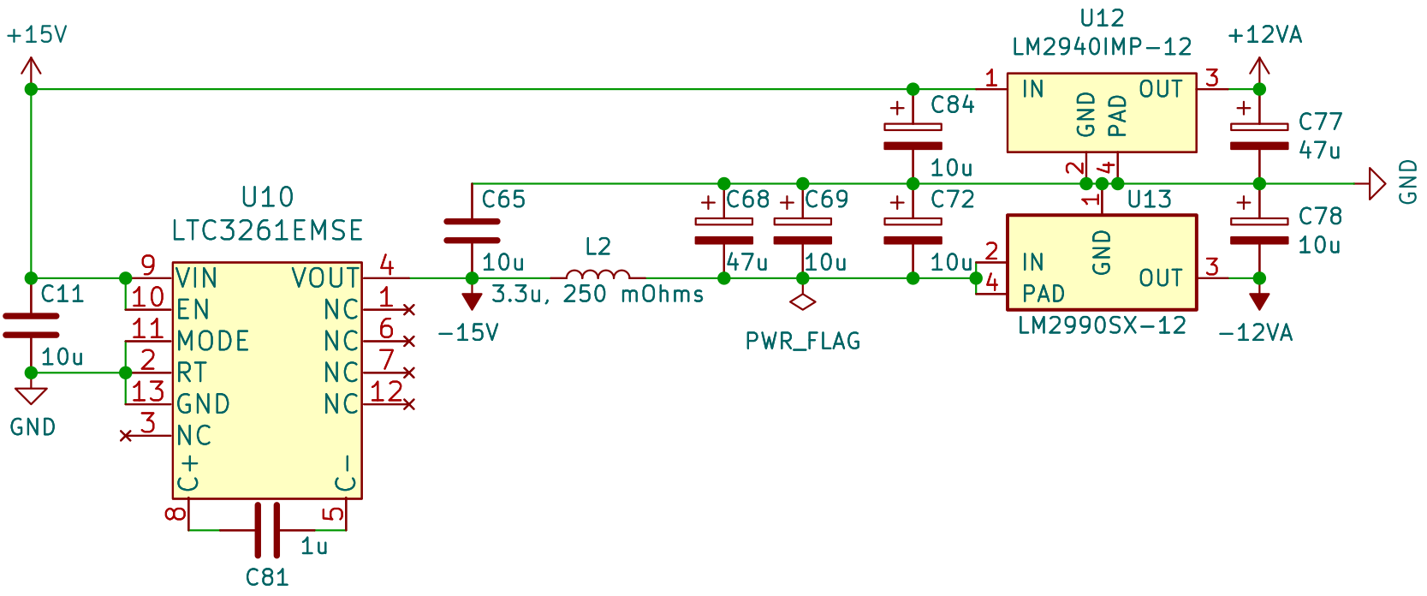
[picture p149: docs/polsl/thesis/graf/hw/split.png]
    
    \caption{Symetryzacja szyn zasilających.}
    \label{hw::split}
\end{figure}

\subsection{Zasilanie domeny cyfrowej}

Celem sekcji jest wygenerowanie napięcia równego 5 V, będącego zasilaniem
przetworników cyfrowo-analogowych oraz wybranej platformy obliczeniowej.
Maksymalne zapotrzebowanie prądowe tych elementów wynosi odpowiednio 200 $\mu$A
\cite{bib:tl071} (100 $\mu$A na układ wzmacniacza) oraz około 2 A na platformę
\cite{bib:bbb}. Wykorzystywana jednostka obliczeniowa posiada własną sekcję
stabilizacji i~filtracji napięcia wejściowego, a~wybrane przetworniki
cyfrowe-analogowe, w~przeciwieństwie do analogowo-cyfrowych, generują wyjście na
podstawie dodatkowego sygnału referencyjnego, więc wymagania nałożone na
dokładność wygenerowanego zasilania są zdecydowanie mniej rygorystyczne niż
w~przypadku zasilań i~referencji domeny analogowej. W celu generacji napięcia
wykorzystano układ impulsowej przetwornicy napięcia (SMPS, ang. \textit{Switched
mode power supply}), który jest tani, prosty w implementacji oraz zapewnia
wysoką wydajność prądową, według dokumentacji wynoszącą do 3 A
\cite{bib:tps562209}. \par Zależność opisująca napięcie wyjściowe wykorzystanego
układu podana jest przez producenta i~zdefiniowana jest poniższym równaniem:
\begin{equation} 
    U_{\text{out}} = 0.765 \cdot (1 + \frac{R_1}{R_2}).
    \label{eq::smps}
\end{equation}

Jak opisywano w sekcji dotyczącej filtracji i~stabilizacji zasilania
wejściowego, przetwornice generują fluktuacje na wyjściu, które należy
filtrować. W przypadku tego układu, producent w~nocie aplikacyjnej
\cite{bib:tps562209} przedstawił zalecane parametry wyjściowego filtru LC,
z~których skorzystano. Napięcie z przetwornicy trafia końcowo na regulator
napięcia o wydajności prądowej równej 3 A \cite{bib:lm1085} w~celu stabilizacji
oraz zostaje wyprowadzone na pozostałe sekcje. Omowiany układ przedstawiono na
rysunku \ref{hw::smps}.

\begin{figure}[H]
    \centering
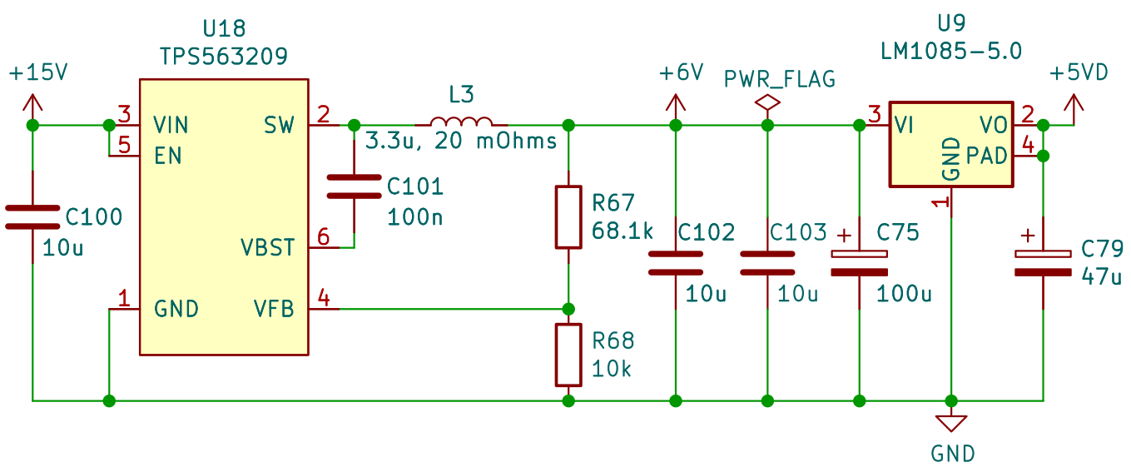
[picture p150: docs/polsl/thesis/graf/hw/smps.png]
    
    \caption{Zasilanie domeny cyfrowej.}
    \label{hw::smps}
\end{figure}

Napięcie wyjściowe przetwornicy zgodnie z~zależnością \ref{eq::smps} dla
wykorzystanych rezystorów wynosi 5.97 V, co pozwala poprawną stabilizację
z~wykorzystaniem regulatora niskiego spadku. Do wygenerowanego zasilania
równolegle wraz z~rezystorem ograniczającym prąd dodatkowo podłączono diodę LED,
działającą jako indykator informujący o~włączonym układzie.

\subsection{Referencja domeny analogowo-cyfrowej}

Wykorzystane przetworniki wymagają zasilania referencyjnego, na bazie którego
przeprowadzane są konwersje. W~przypadku przetworników cyfrowo-analogowych,
zależność wynosi \cite{bib:ad7680}:
\begin{equation}
    U_{out} = \frac{DU_{\text{ref}}}{2^{N}},
\end{equation}
gdzie $D$ to dane załadowane do rejestru przetwornika, a~$N$ to rozdzielczość.
\par W przypadku przetwornika analogowo-cyfrowego, referencja wpływa
bezpośrednio na rozmiar kwantu \cite{bib:ad5541}:
\begin{equation}
    q = \frac{U_{\text{ref}}}{2^{N}}.
\end{equation}

Z powyższych równań wynika, że sygnał referencyjny musi być bardzo dokładny. Aby
to uzyskać, zastosowano precyzyjny regulator napięcia niskiego spadku, zdolny do
generacji napięcia wyjściowego z maksymalnym błędem równym 2 mV i~maksymalnym
obciążeniem równym 30 mA \cite{bib:ref195}, wystarczającym dla wykorzystanych
przetworników. Zakres wejściowych napięć układu zawiera się w przedziale od -0.3
V do +18 V, więc wejściowe napięcie (równe +12 V) jest odpowiednie. Omawiany
układ wraz z~kondensatorami odsprzęgającymi przedstawiono na rysunku
\ref{hw::ref}:

\begin{figure}[H]
    \centering
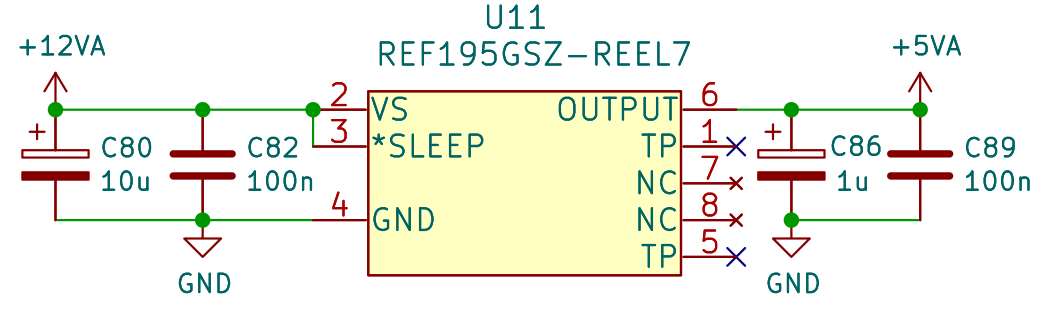
[picture p151: docs/polsl/thesis/graf/hw/ref.png]
    
    \caption{Referencja domeny analogowo-cyfrowej.}
    \label{hw::ref}
\end{figure}

Warto dodać, że napięcie referencyjne, prócz przetworników, trafia również na
ograniczniki diodowe zastosowane w~sekcji wejściowych torów analogowych.

\subsection{Generacja składowej stałej}

Jak dokładniej będzie opisywane w~sekcji torów analogowych, w~celu zapewnienia
pełnego zakresu dynamicznego przetworników analogowo-cyfrowych, niezbędny jest
dokładny i~stabilny sygnał referencyjny zapewniający odpowiednią składową stałą
w~przetworzonym sygnale dźwiękowym trafiającym na wejście przetwornika. Od
układu generującego taki sygnał nie jest wymagana obsługa dużych obciążeń,
ponieważ sygnał na jego wyjściu w~zaimplementowanym rozwiązaniu trafia na
wejście nieodwracające wzmiacniaczy operacyjnych w sekcji analogowej, których
impedancja wejściowa jest liczona w M$\Omega$ (teoretycznie impedancja wejściowa
wzmacniacza operacyjnego jest nieskończona \cite{bib:art}). \par W~celu
generacji takiego sygnału posłużono się układem napięcia odniesienia
\cite{bib:max6001}, który wraz z kondensatorami odsprzęgającymi przedstawiono na
rysunku \ref{hw::off}:

\begin{figure}[H]
    \centering
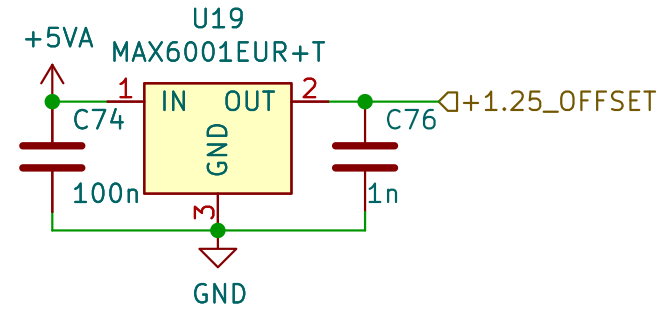
[picture p152: docs/polsl/thesis/graf/hw/off.png]
    
    \caption{Układ napięcia odniesienia.}
    \label{hw::off}
\end{figure}

\section{Wejściowe tory analogowe}

Schemat blokowy wejściowego toru analogowego przedstawiono na rysunku
\ref{hw::analog}:

\begin{figure}[H]
    \centering
    
    \caption{Schemat blokowy wejściowego toru analogowego.}
    \label{hw::analog}
\end{figure}

\subsection{Wejście zbalansowane}

Dźwięk trafia na sekcję torów analogowych poprzez trzy-pinowe złącze XLR. Oprócz
masy, ze złącza odprowadzane są dwa sygnały, z~czego drugi jest odwrócony w
fazie względem pierwszego. Tak zrealizowane połączenia, wraz z~odpowiednim
ekranowaniem w przewodzie, pozwalają na minimalizację zakłóceń oraz strat. \par
Bezpośrednio po doprowadzeniu sygnałów na układ, poprzez rezystory podciągające
(ang. \textit{pull-up resistors}) do sygnałów doprowadzone jest zasilanie
phantomowe o~wartości 15 V. Standard IEC 61938 definiuje wartości rezystancji
dla poszczególnych wartości napięć zasilania phantomowego i~wynoszą one 6.81
k$\Omega$ dla zasilania 48 V, 1.2 k$\Omega$ dla zasilania 24 V i~680 $\Omega$
dla zasilania 12 V. Jako, że wybrana wartość zasilania jest niestandardowa ze
względu na specyfikację mikrofonów, to jako rezystancje dobrano te, dla których
wartości napięcia w standardzie jest najbliższa, czyli 680 $\Omega$. Po
doprowadzeniu zasilania sygnały trafiają na kondensatory odcinające składową
stałą. Omawianą część schematu przedstawiono na rysunku \ref{hw::xlr}:

\begin{figure}[H]
    \centering
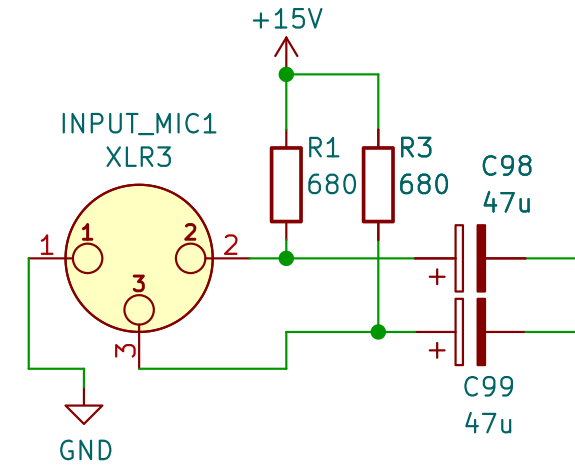
[picture p153: docs/polsl/thesis/graf/hw/xlr.png]
    
    \caption{Wejście zbalansowane.}
    \label{hw::xlr}
\end{figure}

\subsection{Początkowa filtracja i~saturacja}

W celu zabezpieczenia się przed wysokoczęstotliwościowymi zakłóceniami
z~zewnętrznych źródeł, następnym etapem przetwarzania jest zastosowanie
dolnoprzepustowych filtrów EMI (ang. \textit{Electromagnetic-interference
filtering}). Obecność wysokoczęstotliwościowych szumów w~przetwarzanym sygnale
wchodzącym na wejście wzmacniacza różnicowego może doprowadzić do niekorzystnych
zmian sygnału wyjściowego. Takie zachowanie opisywane jest przez wskaźnik CMRR
(ang. \textit{Common-mode rejection ratio}), który zdefiniowany jest jako
stosunek wzmocnienia różnicowego do wzmocnienia sygnału zgodnego \cite{bib:art}.
Dla wykorzystywanych wzmacniaczy powyżej częstotliwości 100 kHz, CMRR osiąga
wartość około 80 dB. Rzeczywiste CMRR, poza obecnością wysokoczęstotliwościowych
szumów w~sygnale wejściowym można również pogorszyć niezbalansowaniem układów
przed wzmacniaczem, co należy mieć na uwadze projektując układ składający się
z~szeregowego połączenia układów scalonych. \par Zaprojektowany filtr jest
dolnoprzepustowym filtrem RC pierwszego rzędu, którego opisuje następująca
zależność \cite{bib:tietze}:
\begin{equation}
    U_{\text{wy}}(s) = U_{\text{we}}(s)\frac{Z_1}{Z_1 + Z_2} = 
    U_{\text{we}}(s)\frac{\frac{1}{Cs}}{R + \frac{1}{Cs}}
        \implies K(s) = \frac{1}{RCs + 1},
    \label{eq::rc}
\end{equation}

Stała czasowa $\tau$ oraz częstotliwość odcięcia 3 dB dane są zależnościami:
\begin{equation}
    \tau = RC, \quad f_c = \frac{1}{2\pi RC}.
\end{equation}

Dobierając $R = 2$ k$\Omega$ i~$C = 10$ nF uzyskano $f_c \approx 7.957$ kHz.
Poza filtrem, w~sekcji zaimplementowano saturację w~postaci ogranicznika
diodowego ograniczającego amplitudy sygnału wejściowego do limitu 12 V.
Omawiany układ przedstawiono na rysunku \ref{hw::emif}:

\begin{figure}[H]
    \centering
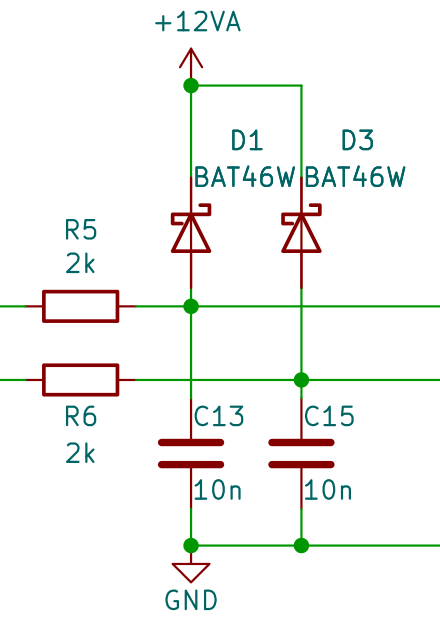
[picture p154: docs/polsl/thesis/graf/hw/emif.png]
    
    \caption{Filtr EMI wraz z ogranicznikiem diodowym.}
    \label{hw::emif}
\end{figure}

\subsection{Wzmocnienie różnicowe}

Symetryczny sygnał z~mikrofonów w~kolejnym etapie należy przekonwertować do
pojedynczej, odpowiednio wzmocnionej sumy. Układem wykorzystywanym do tego typu
zastosowań jest wzmacniacz różnicowy, a~jego topologię przedstawiono na rysunku
\ref{hw::op_diff}.

\begin{figure}[H]
    \centering
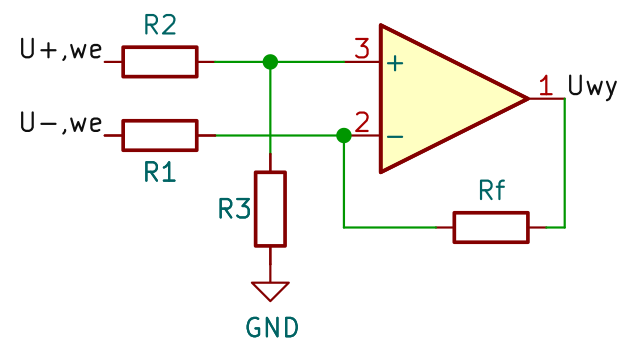
[picture p155: docs/polsl/thesis/graf/hw/op_diff.png]
    
    \caption{Wzmacniacz różnicowy.}
    \label{hw::op_diff}
\end{figure}

\par Zależność opisująca układ opiera się na wykorzystaniu zasady superpozycji.
Równanie opisujące wyjście w~układu w~stosunku do wejścia odwracającego przy
wirtualnie wyzerowanym wejściu nieodwracającym jest zależnością opisującą
wzmocnienie wzmacniacza w~topologii odwracającej \cite{bib:tietze}, opisaną jako:
\begin{equation}
    U_{-,\text{wy}} = -U_{-,\text{we}}\left(\frac{R_f}{R_{1}}\right).
    \label{eq::op_diff_inv}
\end{equation}

Wyjście wzmacniacza w stosunku do wejścia nieodwracającego przy wirtualnie
wyzerowanym wejściu odwracającym jest zdefiniowane zależnością opisującą
wzmacniacz w~topologii nieodwracającej w połączeniu z~dzielnikiem występującym
na wejściu nieodwracającym:
\begin{equation}
    U_{+,\text{wy}} = U_{+,\text{we}}\left(\frac{R_3}{R_2 + R_3}\right)
    \left(1 + \frac{R_f}{R_1}\right).
    \label{eq::op_diff_ninv}
\end{equation}

Korzystając z zasady superpozycji otrzymuje się
\begin{equation}
    U_{\text{wy}} = U_{+,\text{we}} - U_{-,\text{wy}} = U_{+,\text{we}}
    \left(\frac{R_3}{R_2 + R_3}\right)\left(1 + \frac{R_f}{R_1}\right)
    - U_{-,\text{we}}\left(\frac{R_f}{R_{1}}\right).
    \label{eq::op_diff}
\end{equation}

Dla $R_1 = R_2$ i~$R_3 = R_f$ równanie \ref{eq::op_diff} upraszcza się do
postaci:
\begin{equation}
    U_{\text{wy}} = \frac{R_f}{R_1}(U_{+,\text{we}} - U_{-,\text{we}}).
\end{equation}

Jako wzmocnienie wybrano obliczone wcześniej \ref{eq::k_preamp} z~zaokrągleniem
w~górę, przyjmując $k = 40$, oraz $R_f = 100$ k$\Omega$ i~$R_1 = 2.5$ k$\Omega$
w~symobolach schematu \ref{hw::op_diff}. Omawiany układ przedstawiono na rysunku
\ref{hw::preamp}.

\begin{figure}[H]
    \centering
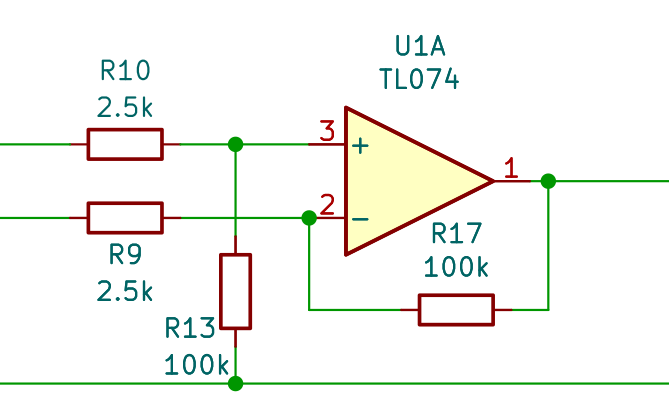
[picture p156: docs/polsl/thesis/graf/hw/preamp.png]
    
    \caption{Wzmocnienie różnicowe.}
    \label{hw::preamp}
\end{figure}

\subsection{Filtracja antyaliasingowa}

Jako, że pasmo interesujących częstotliwości, wynikających z~założeń
projektowych zamyka się w~500 Hz, zdecydowano się na implementację analogowego
filtru Butterwortha szóstego rzędu o~częstotliwości graniczej $f_c = 500$ Hz.
Filtr ten spełnia rolę filtru antyaliasingowego, umożliwijąc próbkowanie
\cite{bib:lyons} wynikające z~twierdzenia Nyquista-Shannona:
\begin{equation}
    f_p > 2f_s.
\end{equation}

Dla $f_s = f_g = 500$ Hz sygnał może zostać spróbkowany z~częstotliwościami
większymi niż 1 kHz. \par Projektując układ posłużono się topologią Sellena-Keya
z~jednostkowym wzmocnieniem \cite{bib:tietze}, którą przedstawiono na rysunku
\ref{hw::sellen_key}:

\begin{figure}[H]
    \centering
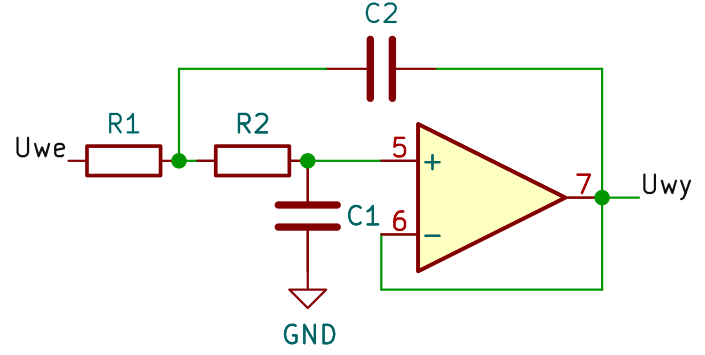
[picture p157: docs/polsl/thesis/graf/hw/sellen_key.png]
    
    \caption{Topologia Sellena-Keya z jednostkowym wzmocnieniem.}
    \label{hw::sellen_key}
\end{figure}

Transmitancję takiego układu, będącego aktywnym filtrem dolnoprzepustowym
drugiego rzędu opisuje:
\begin{equation}
    K_f(s) = \frac{1}{b_1s^2 + a_1s + 1},
    \label{eq::filter}
\end{equation}
gdzie:
\begin{equation}
    b_1 = R_1R_2C_1C_2, \quad a_1 = C_1(R_1 + R_2).
    \label{eq::ba}
\end{equation}

Transmitancję filtru szóstego rzędu można zapisać jako iloczyn trzech filtrów:
\ref{eq::filter}
\begin{equation}
    K(s) = K_1(s)K_2(s)K_3(s) = \prod_{i = 1}^{3} \frac{1}{(b_is^2 + a_is + 1)}.
    \label{eq::ffilter}
\end{equation}

Z wykorzystaniem funkcji wspomagających projektowanie filtrów analogowych języka
programowania Python (biblioteka \textit{SciPy}, funkcje \textit{signal.butter}
i~\textit{signal.zp2tf}) uzyskano wartości współczynników transmitancji
\ref{eq::ffilter} dla $f_c = 500$ Hz:
\begin{equation}
    b_1 = b_2 = b_3 = 1.0132\text{e-07},
\end{equation}
\begin{equation}
    \textbf{A} = \begin{bmatrix}
        a_1 \\
        a_2 \\
        a_3
    \end{bmatrix} = \begin{bmatrix}
        6.1493\text{e-04} \\
        4.5016\text{e-04} \\
        1.6477\text{e-04}
    \end{bmatrix}.
\end{equation}

Mając policzone współczynniki transmitancji \ref{eq::ffilter}, z~równań
\ref{eq::ba} można obliczyć wartości poszczególnych elementów układu. Dla
przyjętych pojemności wartości rezystancji określone są zależnościami:
\begin{equation}
    R_{1_{i},2_{i}} = \frac{C_2a_i \pm \sqrt{C_2(C_2a^2_i - 4C_1b_i)}}{2C_1C_2},
    \qquad \text{dla } i = 1,2,3.
\end{equation}

Dla następujących rzeczywistych wartości pojemności:
\begin{equation}
    \textbf{C} = \begin{bmatrix}
        C_{1,1} & C_{1,2} \\
        C_{2,1} & C_{2,2} \\
        C_{3,1} & C_{3,2}
    \end{bmatrix} = \begin{bmatrix}
        4.7\text{e-09}& 5.6\text{e-09} \\
        2.7\text{e-09} & 6.8\text{e-09} \\
        560\text{e-12} & 22\text{e-09}
    \end{bmatrix} \text{ F},
\end{equation}
otrzymano następujące teoretyczne wartości rezystancji:
\begin{equation}
        \textbf{R} = \begin{bmatrix}
            R_{1,1} & R_{1,2} \\
            R_{2,1} & R_{2,2} \\
            R_{3,1} & R_{3,2}
        \end{bmatrix} = \begin{bmatrix}
            4.4683\text{e+04} & 8.6151\text{e+04} \\
            4.5537\text{e+04} & 1.2118\text{e+05} \\
            3.1276\text{e+04} & 2.6295\text{e+05}
        \end{bmatrix} \text{ }\Omega.
\end{equation}

Charakterystykę amplitudową i~fazową układu przedstawiono na rysunku
\ref{hw::freqs}:

\begin{figure}[H]
    \centering
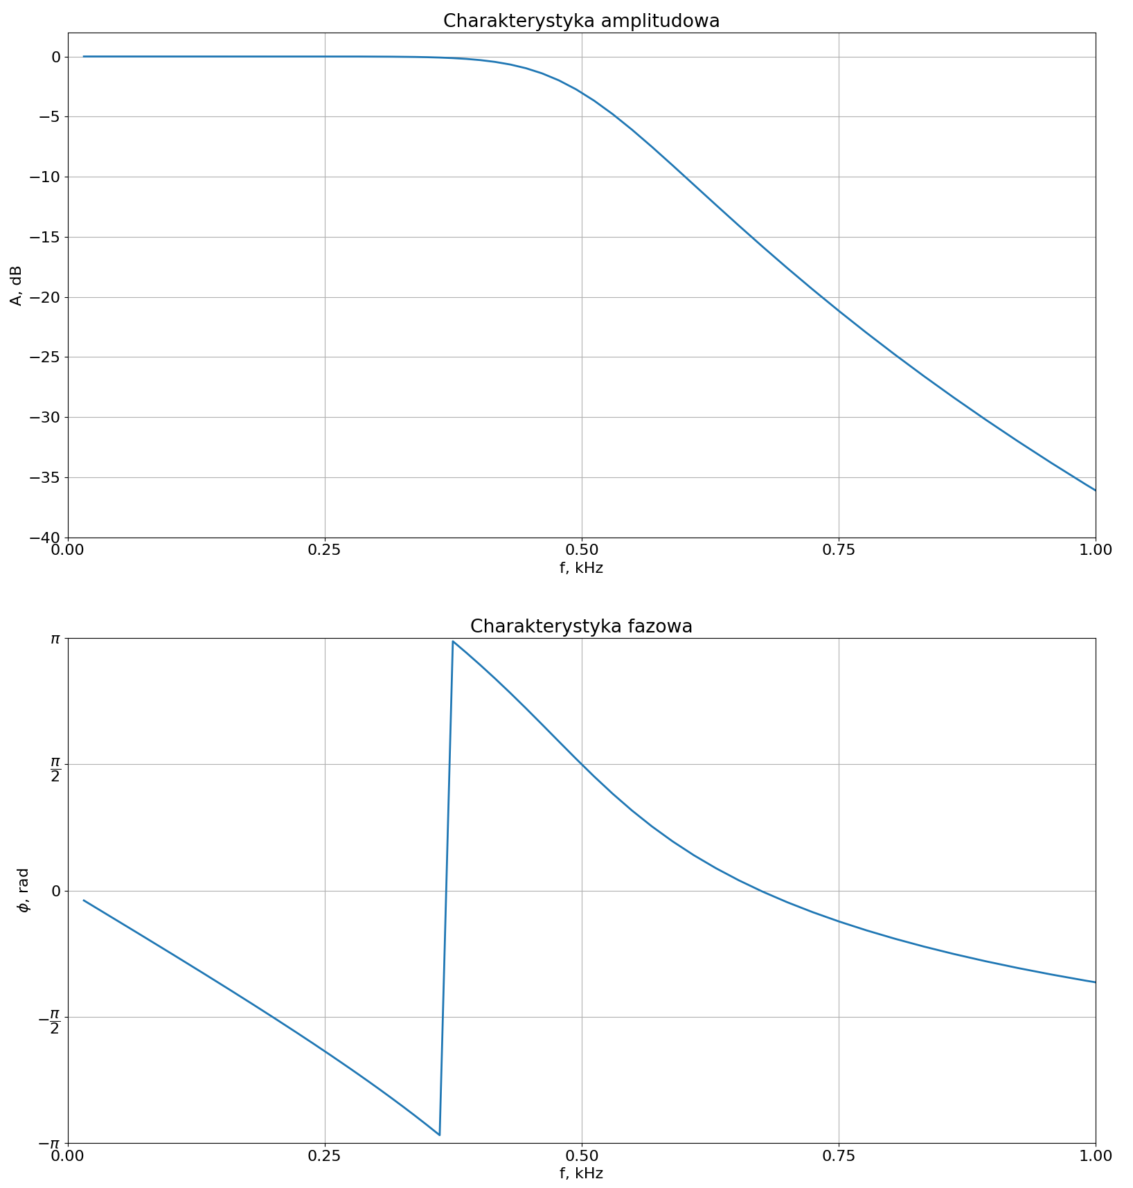
[picture p158: docs/polsl/thesis/graf/hw/freqs.png]
    
    \caption{Charakterystyka aplitudowa i~fazowa układu filtra.}
    \label{hw::freqs}
\end{figure}

Po wybraniu rzeczywistch wartości rezystancji najbliższych teoretycznym,
omawiany układ przedstawiono na rysunku \ref{hw::filt}.

\begin{figure}[H]
    \centering
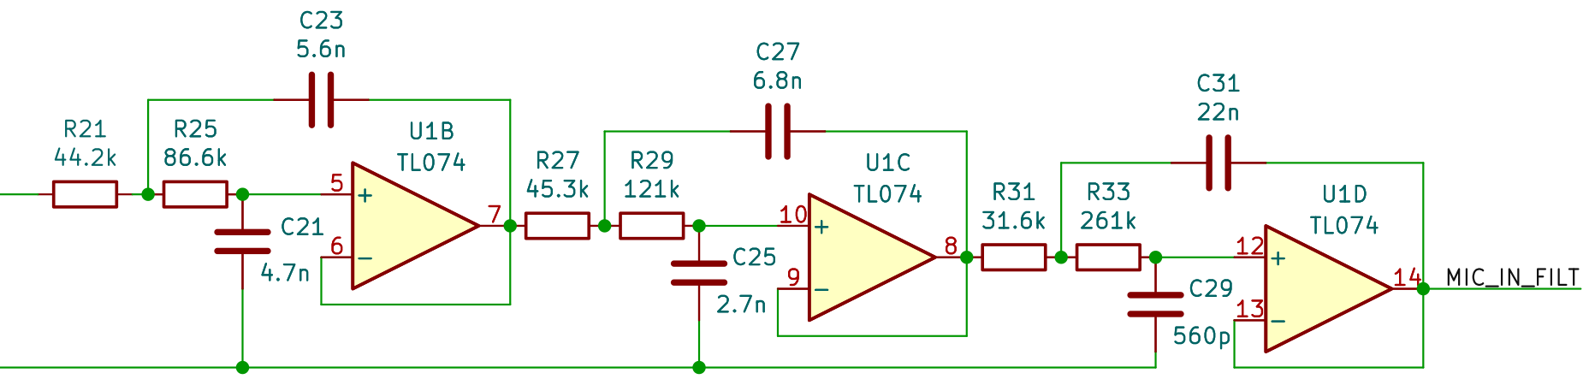
[picture p159: docs/polsl/thesis/graf/hw/filter.png]
    
    \caption{Filtr antyaliasingowy.}
    \label{hw::filt}
\end{figure}

\subsection{Pozycjonowanie}

Celem układu pozycjonującego jest zapewnienie, że sygnał wejściowy przetwornika
analogowo-cyfrowego jest wyskalowany do jego pełnego zakresu dynamicznego,
wynoszącego od 0 V do 5 V. Sygnał przed trafieniem na omawianą sekcję jest już
odpowiednio wzmocniony i~przefiltrowany, więc jedynym zadaniem układu jest
dodanie do niego składowej stałej, będącej środkiem zakresu przetwornika. \par
Zadanie te zrealizowano poprzez zastosowanie układu wzmacniacza różnicowego
przedstawionego na rysunku \ref{hw::op_diff}, z~modyfikacją wykluczającą
dzielnik napięciowy złożony z~rezystorów $R_1$ i~$R_2$. To implikuje zmianę
równania \ref{eq::op_diff_ninv} na klasyczną zależność opisującą wzmocnienie
wzmacniacza w~topologii nieodwracającej \cite{bib:tietze}:
\begin{equation}
    U_{+,\text{wy}} = U_{+,\text{we}}\left(1 + \frac{R_f}{R_1}\right).
    \label{eq::op_ninv}
\end{equation}
gdzie zależność opisująca wyjście ze względu na wejście $U_{-,\text{we}}$ pozostaje
niezmienna. \par Zważając na powyższe, wyjście układu wynikające z~zasady
superpozycji jest opisane zmodyfikowaną zależnością \ref{eq::op_diff}:
\begin{equation}
    U_{\text{wy}} = U_{+, \text{we}} - U_{-,\text{wy}} = U_{+, \text{we}}\left(1 + \frac{R_f}{R_1}\right) - 
        U_{-, \text{we}}\left(\frac{R_f}{R_1}\right).
\end{equation}

Dla arbitralnej wartości $R_f = R_1$ otrzymuje się:
\begin{equation}
    U_{wy} = 2U_{+, \text{we}} - U_{-, \text{we}}.
    \label{eq::offset}
\end{equation}

Chcąc uzyskać stałe przesunięcie sygnału $U_{-, we}$ o~środek zakresu
przetwornika~$U_c = 2.5$~V uzyskuje się warunek na pierwszy składnik równania
\ref{eq::offset}:
\begin{equation}
    2U_{+,\text{we}} = 2.5 \text{ V} \implies U_{+, \text{we}} = 1.25 \text{ V}.
\end{equation}

Jak można zauważyć z~równiania \ref{eq::offset} sygnał $U_{-, \text{we}}$ zostaje w tym
etapie odwrócony. Omawiany układ wraz z~kondensatorem pełniącym rolę lokalnego
bufora składowej stałej przedstawiono na rysunku \ref{hw::offset}.

\begin{figure}[H]
    \centering
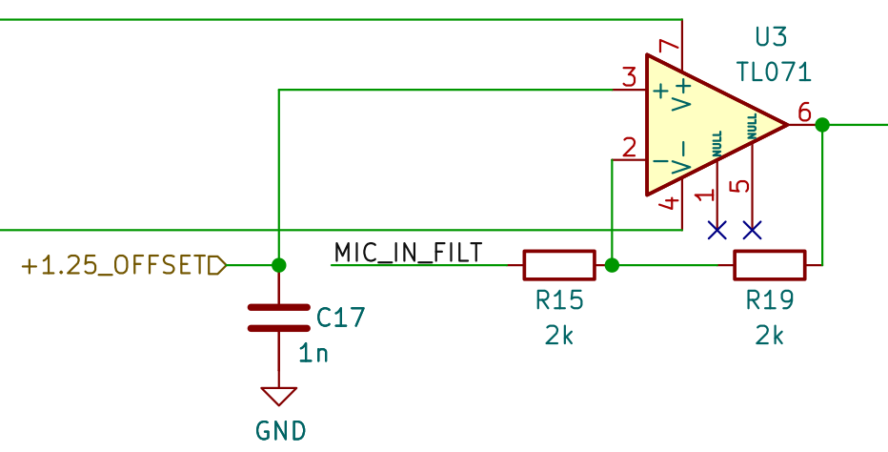
[picture p160: docs/polsl/thesis/graf/hw/offset.png]
    
    \caption{Układ pozycjonujący.}
    \label{hw::offset}
\end{figure}

\subsection{Filtr końcowy i~saturacja}

\par Bezpośrednio przed wejściem przetwornika dołączono dodatkowy filtr
dolnoprzepustowy RC pierwszego rzędu \ref{eq::rc}, odcinający możliwe szumy
powstałe w~wyniku zastosowanych wzmacniaczy operacyjnych oraz zapewniający
lokalny bufor energii dla kondensatora próbkującego wewnątrz przetwornika.
Wymagania na taki filtr nie są surowe, ponieważ niechciane pasmo zostało
odfiltrowane przez wcześniejszy filtr antyaliasingowy, dlatego zdecydowano się
na wartości $R = 1$ k$\Omega$ i~$C = 10$ nF, uzyskując w~ten sposób $f_c \approx
15.91$ kHz. \par Wejście przetwornika analogowo-cyfrowego należy zabezpieczyć
przed napięciami przekraczającymi jego zakres. O~układzie realizującym to
zadanie wspominano już w~sekcji wejścia zbalansowanego, lecz w~tym przypadku,
limiter ogranicza amplitudy sygnału wejściowego do zakresu przetwornika. Z~tego
wynika, że diody w~układzie będą połączone z~zasilaniem 5 V i~masą (0 V).
Omawiany układ przedstawiono na rysunku \ref{hw::safe}:

\begin{figure}[H]
    \centering
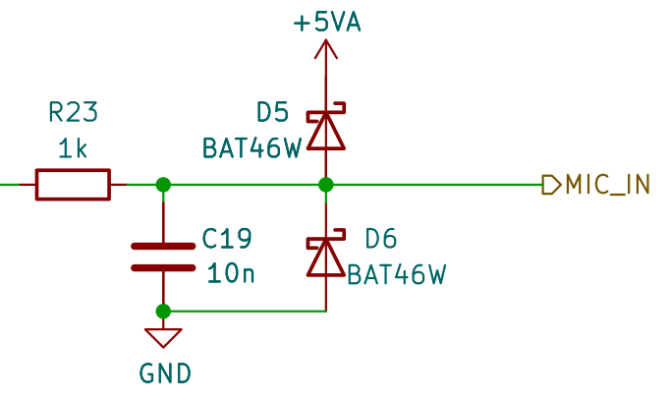
[picture p161: docs/polsl/thesis/graf/hw/safe.png]
    
    \caption{Filtr dolnoprzepustowy i~limiter.}
    \label{hw::safe}
\end{figure}

\subsection{Pełen schemat sekcji}

Pełen schemat omawianej sekcji przedstawiono na rysunku
\ref{hw::analog_in_full}:

\begin{figure}[H]
    \centering
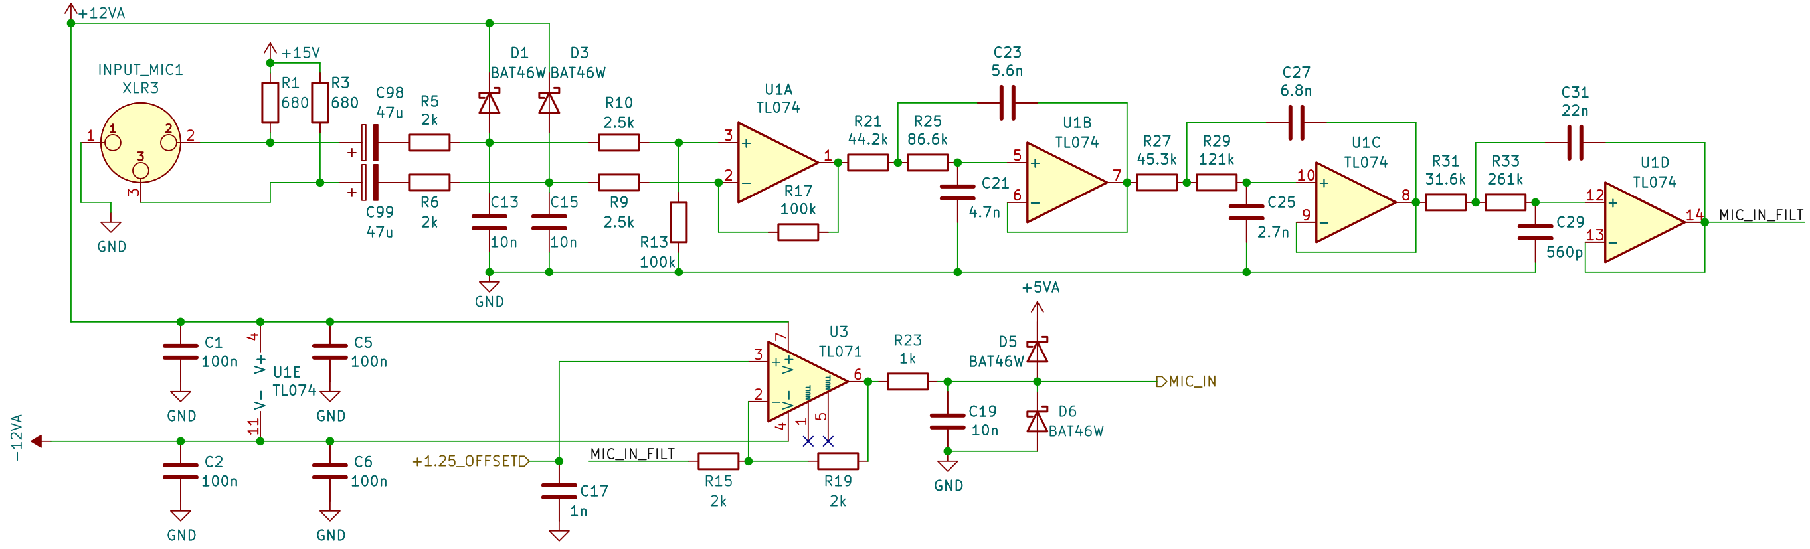
[picture p162: docs/polsl/thesis/graf/hw/analog_in_full.png]
    
    \caption{Pełen schemat wejściowej sekcji analogowej.}
    \label{hw::analog_in_full}
\end{figure}

Do symetrycznych linii zasilających wzmacniaczy operacyjnych dołączono
kondensatory odsprzęgające, filtrujące szumy zasilania. Jako wartości dobrano
typowe $100$ nF na każdy pin zasilający wzmacniacza.

\section{Wyjściowe tory analogowe}

Schemat blokowy wyjściowego toru analogowego przedstawiono na rysunku
\ref{hw::analog_out}:

\begin{figure}[H]
    \centering
    
    \caption{Schemat blokowy wyjściowego toru analogowego.}
    \label{hw::analog_out}
\end{figure}

\subsection{Filtracja początkowa}

Sygnał wychodzący bezpośrednio z przetwornika cyfrowo-analogowego wymaga
wstępnej filtracji, mającej na celu usunięcie wysokoczęstotliwościowych
artefaktów kowersji jak i~składowej stałej 2.5 V wynikającej z~zakresu od 0 V do
5 V. Jako, że późniejszym etapem przetwarzania jest stromy dolnoprzepustowy
filtr rekonstukcyjny, to wymagania stawiane omawianemu układowi nie są surowe.
\par Jako układ realizujący opisane wyżej zadanie wybrano pasywny filtr
pasmowoprzepustowy, złożony z~szeregowego połączenia dolnoprzepustowego
i~górnoprzepustowego filtru RC. Dla sekcji dolnoprzepustowej dobrano $R = 1$
k$\Omega$ i~$C = 10$~nF, uzyskujac w~ten sposób $f_c \approx 15.91$ kHz,
natomiast dla sekcji górnoprzepustowej dobrano $R = 100$ k$\Omega$ i~$C = 47
\text{ }\mu$F, uzyskując $f_c < 1$ Hz. Omawiany układ przedstawiono na rysunku
\ref{hw::in_bandpass}:

\begin{figure}[H]
    \centering
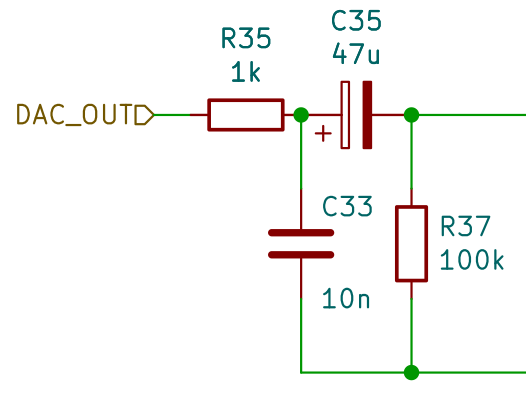
[picture p163: docs/polsl/thesis/graf/hw/in_bandpass.png]
    
    \caption{Wejściowy filtr pasmowoprzepustowy.}
    \label{hw::in_bandpass}
\end{figure}

\subsection{Wzmocnienie}

Przefiltrowany sygnał w następnej kolejności trafia na sekcję wzmacniacza
zaimplementowanego w topologii nieodwracającej \ref{eq::op_ninv}. Z~racji, że
wykorzystywane głośniki posiadają regulację głośności, jedynym obligatoryjnym
wymaganiem przy doborze wzmocnienia układu jest uniknięcie saturacji wyjścia,
które ograniczone jest przez symetryczne zasilanie układu, równe $\pm$12 V. W
związku z~tym, zdecydowano się wzmocnienie $k = 4$ poprzez zastosowanie
rezystorów $R_1 = 6$ k$\Omega$ i~$R_f = 18$ k$\Omega$. Taki wybór skutkuje
$U_{\text{wy}} = 10$~V dla $U_{\text{we}} = 2.5$~V, czyli górnego zakresu
przetwornika, co daje zalecane dla tego układu 2~V zapasu. Omawiany układ
przedstawiono na rysunku \ref{hw::gain_out}:

\begin{figure}[H]
    \centering
    
    \caption{Wzmocnienie sekcji wyjściowej.}
    \label{hw::gain_out}
\end{figure}

\subsection{Filtracja rekonstrukcyjna}

Zaimplementowany filtr rekonstrukcyjny jest powieleniem filtru antyaliasingowego
implementowanego w sekcji analogowych torów wejściowych. Jest to typowe
podejście przy projektowaniu układów, posiadających analogowe wejście i~wyjście
\cite{bib:art} będące efektem przetwarzania wejścia. W wyniku tej decyzji,
wyjście układu jest ograniczone do założonego pasma wejściowego.

\subsection{Symetryzacja}

Wyjście analogowe projektowane jest z myślą o złączach XLR, co oznacza, że
sygnał wyjściowy, tak jak wejściowy, musi być symetryczny (zbalansowany). W celu
jego wytworzenia zastosowano układ wzmacniacza operacyjnego w topologii
odwracającej z jednostkowym wzmocnieniem \ref{eq::op_diff_inv} ($R_1 = R_f$).
Sygnał wyjściowy ($-$) takiego układu jest odwrócony w fazie względem
wejściowego ($+$), co pozwala na uzyskanie symetrycznej pary wyprowadzanej
docelowo na złącze XLR. Przy wykorzystaniu takiego układu należy mieć na uwadze,
że wzmacniacz generujący sygnał odwrócony ($-$) jest elementem nie mającym
odpowiednika w~torze sygnału nieodwróconego ($+$). Układy sterujące wyjściem tej
sekcji, czyli odpowiednio ostatni wzmacniacz w układzie filtra dla sygnału
nieodwróconego ($+$) oraz wzmacniacz odwracający dla sygnału odwróconego ($-$)
mogą zachowywać się znacząco inaczej. Możliwym rozwiązaniem byłoby dodanie
wtórnika napięciowego w~ścieżce sygnału nieodwróconego ($+$), lecz wiązałoby się
to z~dodatkowymi wzmacniaczami operacyjnymi na kanał wyjściowy. Jako,
że~wykorzystywanych wzmacniaczy na tym etapie jest już stosunkowo dużo (pięć na
kanał), z~pomysłu zrezygnowano, mając świadomość kompromisu. Omawiany fragment
schematu przedstawiono na rysunku \ref{hw::synch}:

\begin{figure}[H]
    \centering
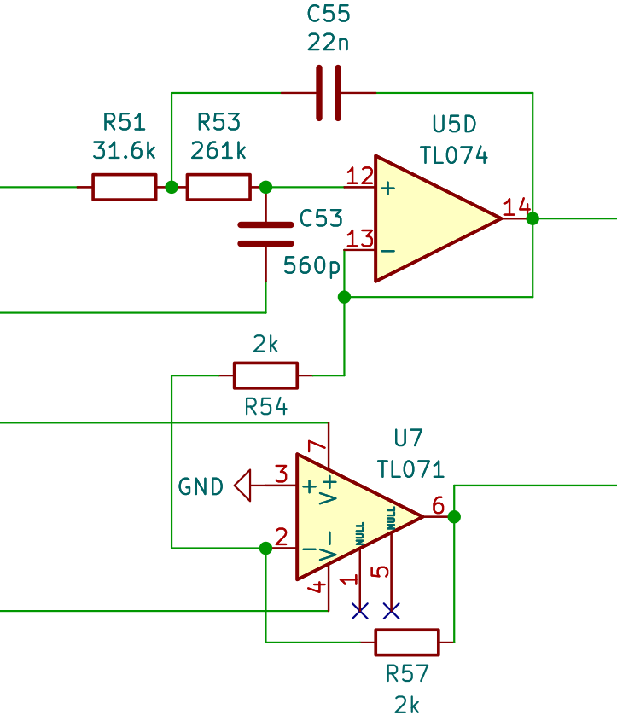
[picture p164: docs/polsl/thesis/graf/hw/synch.png]
    
    \caption{Układy sterujące wyjściem analogowym.}
    \label{hw::synch}
\end{figure}

\subsection{Filtracja końcowa}

Bezpośrednio przed złączem XLR zastosowano filtr pasmowoprzepustowy, chroniący
przed możliwie wystąpującymi w~przetworzonym sygnale szumami powstałymi w~wyniku
zastosowanych wzmacniaczy operacyjnych, jak i~możliwie występującą składową
stałą, której obecność może okazać się destrukcyjna dla głośnika. \par Przyjęte
parametry są podobne do filtra na wejściu sekcji, jednak w~tym przypadku
zmniejszono rezystancję opornika w~układzie dolnoprzepustowym, aby nie zwiększać
impedancji wyjściowej toru. Skutkuje to przemnożeniem częstotliwości granicznej
filtru przez 10, co daje $f_c \approx 159.1$ kHz. Dodatkowo, zmieniono kolejność
elementów w~układzie, starając się umieścić kondensator równolegle jak najbliżej
złącza. Omawianą część schematu przedstawiono na rysunku \ref{hw::out_filter}:

\begin{figure}[H]
    \centering
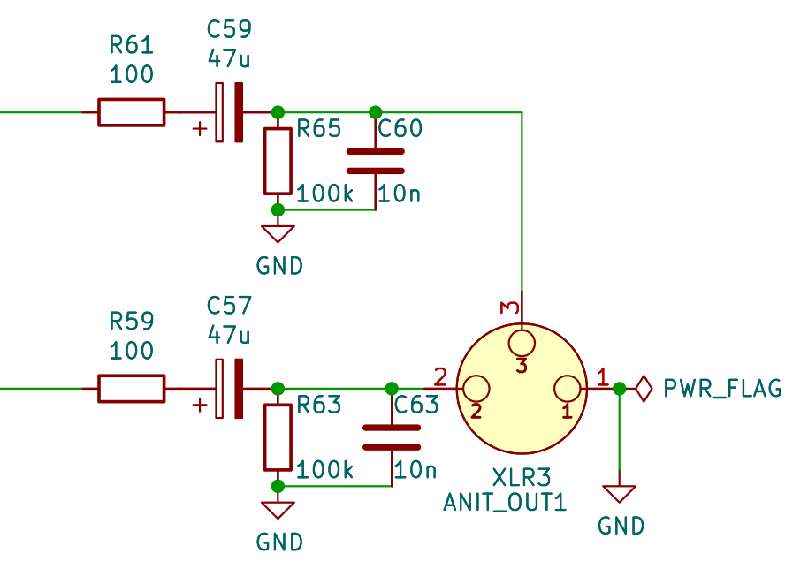
[picture p165: docs/polsl/thesis/graf/hw/out_filter.png]
    
    \caption{Filtracja końcowa toru analogowego.}
    \label{hw::out_filter}
\end{figure}

\subsection{Pełen schemat sekcji}
Pełen schemat omawianej sekcji przedstawiono na rysunku
\ref{hw::analog_out_full}:

\begin{figure}[H]
    \centering
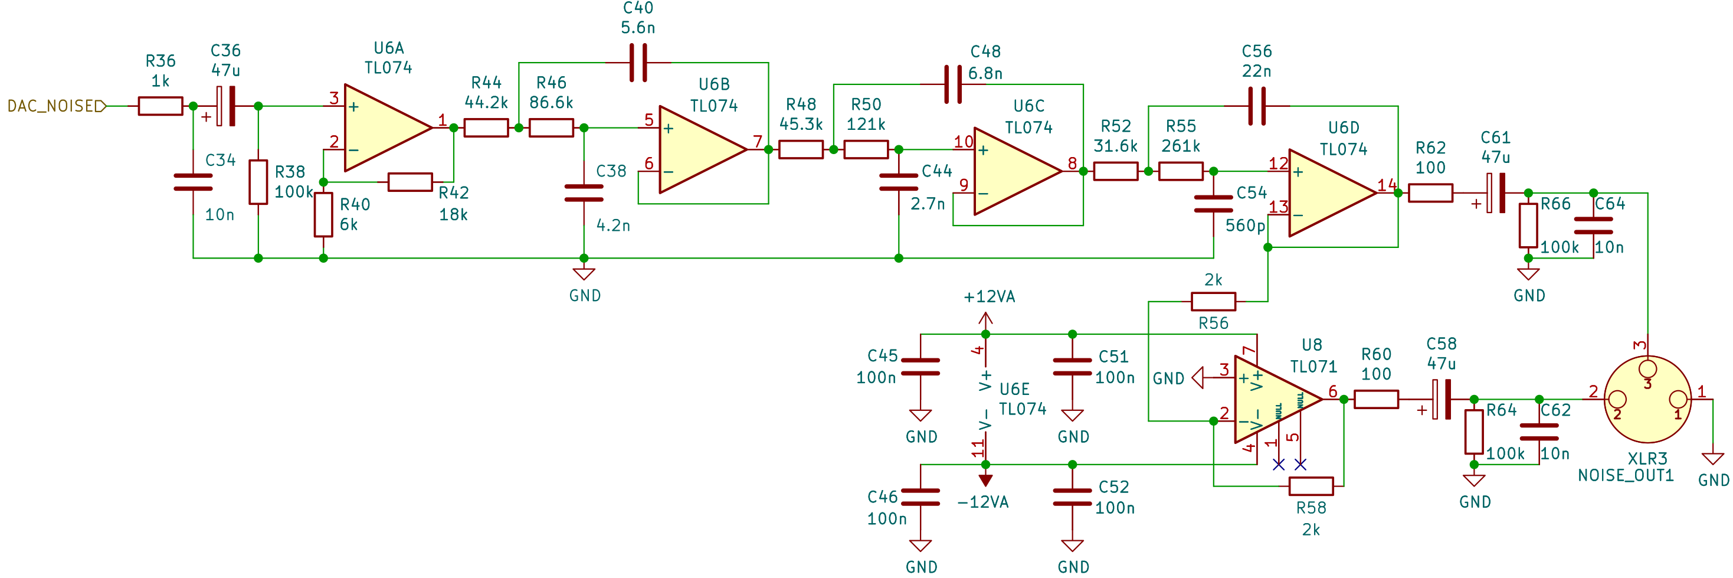
[picture p166: docs/polsl/thesis/graf/hw/analog_out_full.png]
    
    \caption{Pełen schemat wyjściowej sekcji analogowej.}
    \label{hw::analog_out_full}
\end{figure}

Analogicznie jak w~wejściowej sekcji analogowej, na każdy pin zasilania
wzmacniaczy zastosowano kondensator odsprzęgający o~typowej wartości $100$ nF.

\section{Sekcja cyfrowa}

\subsection{Interfejs cyfrowy}

McASP (ang. \textit{Multi-channel audio serial port}) jest cyfrowym interfejsem
komunikacyjnym opracowanym przez firmę Texas Instruments w~celu obsługi
wielokanałowych systemów audio. W zależności od aplikacji, interfejs
wykorzystywany jest do realizacji transferów multipleksowanych metodą TDM (ang.
\textit{Time-division Multiplexing}) z wyszczególnieniem konfiguracji I$^2$S
(ang. \textit{Inter-IC Sound}), będących standardowym protokołem komunikacyjnym
z~urządzeniami wysyłającymi dane cyfrowe reprezentujące dźwięk w~formacie PCM
(ang. \textit{Pulse Code Modulation}). Piny obsługiwane przez interfejs McASP
można podzielić na trzy grupy \cite{bib:mcasp}:
\begin{enumerate}

    \item \textbf{Piny zegarowe} - dzielone na trzy podgrupy:
    \begin{enumerate}

        \item Wysokoczęstotliwościowe (\textbf{AHCLK}) --- wykorzystywane do
        generacji zegarów bitowych (\textbf{ACLK}) i~selektorów (\textbf{AFS})
        poprzez wykorzystanie odpowiednio skonfigurowanych dzielników
        częstotliwości.

        \item Bitowe (\textbf{ACLK}) --- wykorzystywane do taktowania danych
        wejściowych i~wyjściowych względem odpowiednich zboczy.

        \item Selektory (\textbf{AFS}) --- definują aktualnie wysyłany kanał.
        W~terminologii dla trybu stereo (dwukanałowego), w~stanie niskim
        przesyłane jest lewy, a~w~wysokim prawy kanał. Oznacza to, że na jednej
        linii danych można wysłać dane pochodzące z~dwóch kanałów audio.

    \end{enumerate}

    \item \textbf{Piny resetujące} --- umożliwiają wyłączanie (w~kontekście
    audio wyciszanie) peryferiów w~zależności od zdefiniowanej logiki. Sygnały
    zazwyczaj podpinane są do wejść resetujących dane cyfrowe układy audio.

    \item \textbf{Piny danych} (\textbf{ARX}) --- nazwa jest samo wyjaśniająca. 

\end{enumerate}

Każdy pin z~przedstawionych wyżej grup może zostać skonfigurowany w~trybie
wejściowym lub wyjściowym. Dla trybu wejściowego, terminologia McASP definuje
nazwę z~postfiksem R, a dla wyjściowego z~postfiksem X (przykładowo
\textbf{ACLKX} jako wyjściowy zegar bitowy, \textbf{AFSR} jako wejściowy
selektor). Interfejs pracuje na bazie modelu \textit{master-slave}, gdzie
\textit{master} jest urządzeniem zapewniający główny zegar (\textbf{AHCLK})
służący do generacji pozostałych.

\subsubsection{Metody komunikacji}

Transfery z~wykorzystaniem trybu I$^2$S i~jego pochodnych realizowane są
z~wykorzystaniem linii zegarowej (ang. \textit{Bit Clock}, \textbf{BCLK}),
selektora kanału (ang. \textit{Frame Select}, \textbf{FS}) oraz danych (ang.
\textit{Serial Data}, \textbf{SDATA}). Dane przesyłane są w~formacie
definiującym najbardziej znaczący bit na początku transmisji (ang. \textit{MSB
First}), której rozpoczęcie definiowane jest przez określony stan selektora
kanału (\textbf{FS}). Typowo zbocze opadające selektora definuje transmisję
kanału lewego, a~narastające prawego, lecz możliwe są inne konfiguracje.

\par Zapis może odbywać na zboczu narastającym lub opadającym zegara
(\textbf{BCLK}), jednak wymagane jest, aby odbiornik czytał dane na zboczu
narastającym, co powoduje pewne komplikacje, kiedy zapis odbywa się w~identyczny
sposób. Domyślnie, zmiany selektora kanału (\textbf{FS}) odbywają się na
zboczach opadających. Standardowy tryb posiada charakterystyczne, zdefiniowane
w~standardzie opóźnienie o~jeden cykl zegara (\textbf{BCLK}), powodujące, że
najbardziej znaczący bit jest odczytywany dopiero na jego drugim zboczu
narastającym, liczonym od momentu rozpoczęcia transmisji dla określonego kanału.
Diagram czasowy transmisji z~wykorzystaniem trybu I$^2$S w domyślnej
konfiguracji przedstawiono na rysunku \ref{hw::i2s}.

\begin{figure}[H]
    \centering
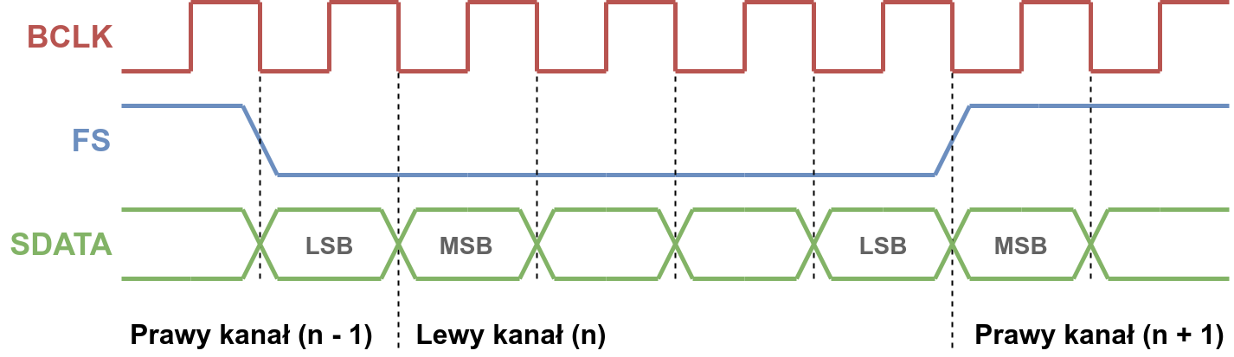
[picture p167: docs/polsl/thesis/graf/hw/i2s.png]
    
    \caption{Diagram czasowy komunikacji I$^2$S.}
    \label{hw::i2s}
\end{figure}

Zależność opisująca częstotliwość zegara bitowego (\textbf{BCLK}) zdefiniowana
jest:
\begin{equation}
    f_{\text{BCLK}} = NLf_{s},
\end{equation}
gdzie $N$ to ilość kanałów (od 1 do 2 dla jednej linii), $L$ to bitowa długość
transferu (typowo od 16 bitów do 32 bitów) a~$f_{s}$ to częstotliwość
próbkowania, za którą bezpośrednio odpowiada częstotliwość selektora kanałów:
\begin{equation}
    f_s = f_{\text{FS}}.
\end{equation}

W przypadku, kiedy komunikacja odbywa się z~peryferiami, dla których opóźnienie
standardowego trybu jest problematyczne, istnieje możliwość skorzystania z~trybu
pochodnego (ang. \textit{Left justified} I$^2$S), który umożliwa odczyt danych
na pierwszym wystąpieniu zbocza narastającego liczonego od momentu zmiany
selektora. Elimiuje to opóźnienie jednego cyklu, gdzie pozostała charakterystyka
komunikacji pozostaje taka sama. Diagram czasu z~wykorzystaniem omawianego trybu
pochodnego przedstawiono na rysunku \ref{hw::l_j}.

\begin{figure}[H]
    \centering
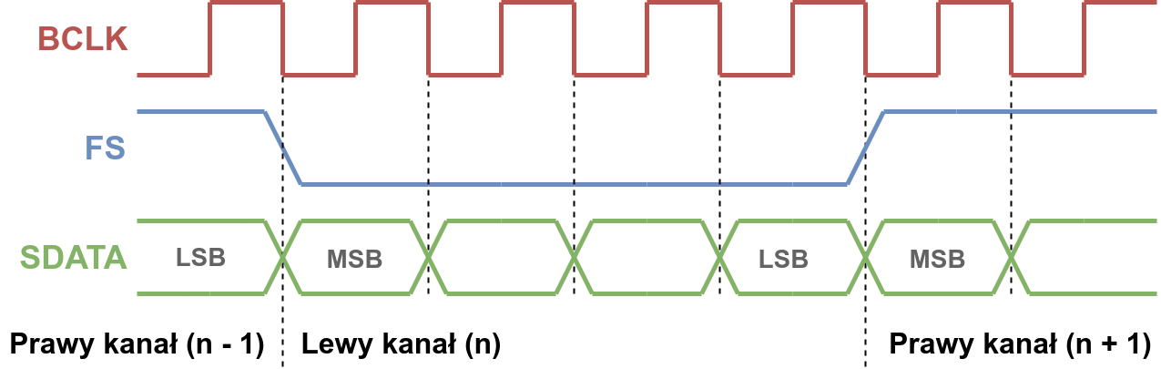
[picture p168: docs/polsl/thesis/graf/hw/l_j.png]
    
    \caption{Diagram czasowy komunikacji \textit{Left justified} I$^2$S.}
    \label{hw::l_j}
\end{figure}

\subsection{Interakcja z przetwornikami}

Wykorzystanie interfejsu McASP jest niezwykle elastyczne, głównie ze względu na
dostępne opcje zegarowe i~ilość możliwych linii danych. Nota \cite{bib:mcasp}
specyfikuje 16 serializatorów, co umożliwia uzyskanie aż 32 kanałów, jeżeli
wykorzystywany jest tryb I$^2$S. Główny zegar (\textbf{AHCLK}), na podstawie
którego generowane są pozostałe, pozwala na pełną synchronizację wszystkich
podpiętych urządzeń w systemie, co jest niezbędne dla systemu wymagającego
stałej częstotliwości próbkowania.

\par Kwestią o którą należy zadbać, jest sposób realizacji transferów.
W~przypadku przetworników analogowo-cyfrowych i~cyfrowo-analogowych,
najwcześniej wykorzystywanym interfejsem jest SPI (ang. \textit{Serial
Peripheral Interface}). Transmisja z~użyciem takiego interfejsu odbywa się
synchronicznie w~sposób dwukierunkowy z~wykorzystaniem linii danych wyjściowych
(ang. \textit{Master output, slave input}, \textbf{MOSI}), danych wejściowych
(ang. \textit{Master input, slave output}, \textbf{MISO}), zegarowej (ang.
\textit{Serial clock}, \textbf{SCLK}), oraz~selektora układu (ang. \textit{Chip
select}, \textbf{CS}). Interfejs SPI nie posiada ściśle zdefiniowanego standardu
działania. Charakterystykę transmisji typowo definiuje peryferium podrzędne
(\textit{slave}), do~której układ nadrzędny (\textit{master}) musi się
przystosować. Charakterystyki transmisji przyjęto definiować w~postaci czterech
trybów, które zależą od wartości parametrów opisujących polaryzację zegara
w~stanie bezczynności (\textit {idle state}, parametr \textbf{CPOL}), oraz~fazy
zegara (parameter \textbf{CPHA}), czyli rodzaju zbocza, na którym odbywa się
zapis/odczyt. 

Wpływ parametrów na charakterystykę transmisji przedstawiono w~tabelach
\ref{tab::cpol} i~\ref{tab::cpha}:

\begin{table}[H]
    \centering
    \begin{tabular}{|| c | c ||} 
        \hline
        \textbf{Wartość CPOL} & \textbf{Wpływ} \\ [0.5ex] \hline\hline
        0 & Zegar w stanie niskim (stan bezczynności) \\
        \hline
        1 & Zegar w stanie wysokim (stan bezczynności) \\
        \hline\hline
    \end{tabular}
    \caption{Wpływ wartości CPOL na charakterystyke transmisji.}
    \label{tab::cpol}
\end{table}

\begin{table}[H]
    \centering
    \begin{tabular}{|| c | c ||} 
        \hline
        \textbf{Wartość CPHA} & \textbf{Wpływ} \\ [0.5ex] \hline\hline
        0 & Zapis na zboczu opadającym, odczyt na narastającym \\
        \hline
        1 & Zapis na zboczu narastającym, odczyt na opadającym \\
        \hline\hline
    \end{tabular}
    \caption{Wpływ wartości CPHA na charakterystyke transmisji.}
    \label{tab::cpha}
\end{table}

Numer trybu otrzymywany jest poprzez połączenie wartości \textbf{CPOL}
i~\textbf{CPHA} w postać dwubitową, gdzie wartość \textbf{CPOL} definuje
najbardziej znaczący bit, a~\textbf{CPHA} najmniej. Przykładowo, ustawienie
$\textbf{CPOL} = 1$ i~$\textbf{CPHA} = 0$ da wynikowo tryb 2.

\par Transmisja SPI rozpoczyna się typowo od wyboru układu linią selektora
(\textbf{CS}), który schodząc na stan niski, inicjalizuje komunikację.
Niezależne selektory, których może być więcej niż jeden, pozwalają na
wykorzystanie pozostałych linii do komunikacji z~wieloma układami. Przykładowy
diagram czasowy komunikacji SPI w~trybie 3 przedstawiono na rysunku
\ref{hw::spi}:

\begin{figure}[H]
    \centering
    
    \caption{Ideowy diagram transmisji SPI w trybie 3.}
    \label{hw::spi}
\end{figure}

Bazując na powyższym opisie można stwierdzić, że transfer I$^2$S (w trybie
\textit{Left justified } I$^2$S). jest tak właściwie szczególnym,
jednokierunkowym transferem SPI realizowanym w trybie 3 (odczyt na zbocze
narastające, zapis na opadające, domyślnie wysoki stan zegara). W~związku z~tym,
interakcja układów komunikujących się po interfejsie SPI w~systemie bazującym na
transferach I$^2$S nie powinna być problematyczna. Realizację połączeń po
stronie dwóch interfejsów przedstawiono w tabeli \ref{tab::spi_to_i2s}:

\begin{table}[H]
    \centering
    \begin{tabular}{|| c | c ||} 
        \hline
        \textbf{Domena SPI} & \textbf{Domena I$^2$S} \\ [0.5ex] \hline\hline
        SCLK & BCLK \\
        \hline
        CS & FS \\
        \hline
        MISO/MOSI & SDATA \\
        \hline\hline
    \end{tabular}
    \caption{Realizacja połączeń SPI do I$^2$S.}
    \label{tab::spi_to_i2s}
\end{table}

Rolę selektora układu (\textbf{CS}) w~tak zrealizowanym połączeniu pełni
selektor kanału (\textbf{FS}) co powoduje, że dane otrzymywane są periodycznie
i~interpretowane jako jeden kanał (domyślnie lewy). Obligatoryjne jest, żeby
wykorzystane w~ten sposób układy nie wymagały dwukierunkowych transferów.
W~przypadku zapisywania/odczytywania danych, układy nie mogą wymagać dodatkowych
odczytów/zapisów. Podpinając jeden zegar (\textbf{BCLK}) i~selektor kanału
(\textbf{FS}) do wielu układów uzyskuje się synchroniczną transmisję
wielokanałową, gdzie jeden układ odpowiada jednemu kanałowi, wejściowemu, jeżeli
jest przetwornikiem analogowo-cyfrowym, lub wyjściowemu, jeżeli jest
przetwornikem cyfrowo-analogowym. Przy doborze przetworników należy zwrócić
szczególną uwagę na zgodność transferów. Tryb I$^2$S jest konfigurowany
globalnie dla całego interfejsu McASP, co oznacza, że konwencja zapisu na zbocze
narastające, odczytu na opadające oraz ilości bitów na transfer zostaje przyjęta
przez wszystkie linie danych. Diagram połączeń sekcji przetworników
przedstawiono na rysunku \ref{hw::adc_dac}:

\begin{figure}[H]
    \centering
    
    \caption{Diagram połączeń sekcji przetworników.}
    \label{hw::adc_dac}
\end{figure}

Wykorzystane przetworniki w~obu przypadkach posiadają rozdzielczość 16 bitów,
więc zapewniony jest wspólny format przetwarzanych danych.

\subsubsection{Przetworniki analogowo-cyfrowe}

W celu minimalizacji opóźnień w torze przetwarzania, wybrane przetworniki
analogowo-cyfrowe zrealizowane są w~architekturze SAR i~posiadają niski czas
konwersji, wynoszący 8 $\mu$s dla transferu 24 bitowego \cite{bib:ad7680}. Ich
specyfikacja komunikacji określa, że każdy transfer rozpoczynany jest czterami
bitami zerowymi liczonymi od momentu pojawienia się zbocza opadającego na
selektorze, po których następuje zapisanie wyniku konwersji. Jeżeli transmisja
jest dłuższa niż optymalne 20 bitów, to w~dodatkowe miejsca wpisywane są zera.
Wykorzystywany przez przetwornik sposób transmisji wprowadza zatem wymaganie
transferów równych lub dłuższych niż 20 bitów. Zapis odbywa się na zboczu
opadającym, a~dane przesyłane są w~formacie najbardziej znaczącego bitu na
początku (ang. \textit{MSB first}). Maksymalna prędkość transmisji wynosi 100
kSPS, a~układ zasilany jest napięciem 5 V, które pełni rolę referencji i~określa
zakres dynamiczny.

\subsubsection{Przetworniki cyfrowo-analogowe}

Komunikacja z~wybranymi przetwornikami cyfrowo-analogowymi odbywa się poprzez
transfery o~długości 16 bitów w~formacie najbardziej znaczącego bitu na
początku, gdzie ładowanie do wewnętrznego rejestru przetwornika odbywa się na
zboczach narastających, licząc od momentu wystąpienia zbocza opadającego na
selektorze \cite{bib:ad5541}. Wartość wyjściowa wystawiana jest w momencie
wystąpienia zbocza narastającego na selektorze~i jeżeli transfer jest dłuższy
niż 16 bitów, dodatkowe wartości są ignorowane. Umożliwia to komunikację z
przetwornikiem transferami dłuższymi niż 16 bitów. Przetwornik poza zasilaniem~o
wartości 5 V wymaga napięcia referencyjnego, które defniniuje wartości
wyjściowe~i zakres. Jako napięcie referencyjne wykorzystano również 5 V. 

\section{Dodatkowe kwestie sprzętowe}

Projektując płytkę drukowaną autor starał podążać się szeregiem zasad
projektowych \cite{bib:ott}, które opisano poniżej:

\begin{enumerate}

    \item \textbf{Minimalizacja długości scieżek} --- elementy powinny być
    umieszczone jak najbliżej siebie. Im dłuższa ścieżka, tym wpływ pojemności
    i~indukcyjności pasożytniczych większy, co powoduje niechciane efekty
    filtracji. Szczególną uwagę należy zwrócić na sekcje krytyczne, takie jak
    sprzężenia zwrotne wzmacniaczy operacyjnych i~wyjście przełączające
    przetwornic impulsowych.

    \item \textbf{Grubości ścieżek} --- im grubsza scieżka, tym jej impedancja
    mniejsza. Grubość należy dobierać na podstawie płynącego prądu, który zwykle
    większy jest dla ścieżek którymi poprowadzone jest zasilanie. W projekcie
    zastosowano 0.5 mm grubości na ścieżki sygnałowe i~1 mm grubości na ścieżki
    zasilania.

    \item \textbf{Kondensatory odsprzęgające} --- powinny być możliwie najbliżej
    docelowych układów. Jako, że mają zapewnić filtrację zasilania i~lokalny
    bufor energii, im dalej od docelowego układu, tym swoje zadanie spełniają
    gorzej. Mogą również służyć jako mosty pomiędzy wartstwami i~płaszczyznami,
    kiedy droga sygnału może wymagać ich zmiany, co przedstawiono na rysunkach
    \ref{hw::cap_1} i~\ref{hw::cap_0}:

    \begin{figure}[H]
        \centering
        
        \caption{Zapewnienie powrotów przez kondensatory odsprzęgające.}
        \label{hw::cap_1}
    \end{figure}

    \begin{figure}[H]
        \centering
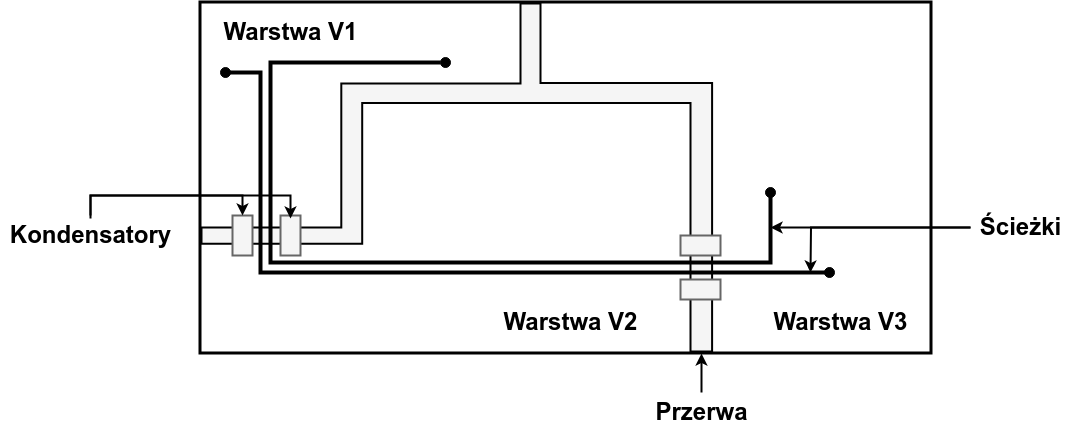
[picture p169: docs/polsl/thesis/graf/hw/cap_0.png]
        
        \caption{Zmiany warst przez kondensatory odsprzęgające.}
        \label{hw::cap_0}
    \end{figure}

    Omawianą sytuację w projekcie wykorzystano do zapewnienia częściowego
    powrotu sygnałów cyfrowych przez bliższą warstwę zasilania, co zaskutkowało
    krótszą drogą oraz stabilniejszą masą (brak spadków związanych ze szybkim
    przełączaniem sygnałów cyfrowych).

    \item \textbf{Powroty sygnałów i~rozmieszczenie elementów} --- sygnały
     najczęściej, jeżeli pod lub nad jest warstwa odniesienia, jako drogę
     powrotną wybiorą tą bezpośrednio pod lub nad ścieżką sygnałową, ponieważ
     jest to dla nich droga o~najmniejszej induktancji \cite{bib:ott}. Mając to
     na uwadze, elementy i~przelotki należy układać tak, aby nie zaburzać drogi
     powrotnej sygnałów. Duża ilość przelotek lub otworów (przykładowo na
     elementy THT) może skutkować zablokowaniem bezpośredniego powrotu, tworząc
     sloty. Dodatkowo, elementy należy ustawiać w~sposób zapewniający unikanie
     warstwowego krzyżowania się sygnałów różnych sekcji i~domen. Układając
     sekcje cyfrową należy zwrócić uwagę, czy sygnały powrotne, jeżeli
     odniesione są do tej samej płaszczyzny co sygnały analogowe, nie będą
     przechodzić bezpośrednio pod lub nad ścieżkami oraz układami analogowymi
     i~odwrotnie. Szybkozmienne sygnały cyfrowe w~powrocie mogą zakłócać sygnały
     analogowe. Opisywane sytuacje przedstawiono na rysunkach \ref{hw::returns}
     i~\ref{hw::sections}:

    \begin{figure}[H]
        \centering
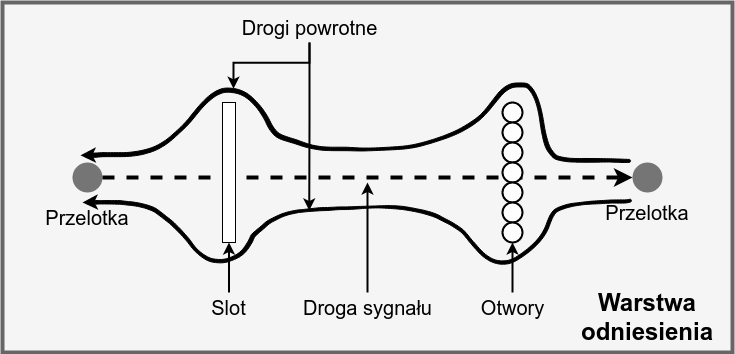
[picture p170: docs/polsl/thesis/graf/hw/return.png]
        
        \caption{Problematyczne powroty --- nieciągłość plaszczyzny odniesienia.}
        \label{hw::returns}
    \end{figure}

    \begin{figure}[H]
        \centering
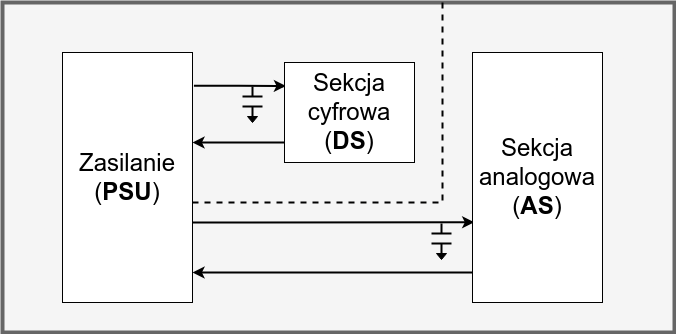
[picture p171: docs/polsl/thesis/graf/hw/sections.png]
        
        \caption{Poprawne ułożenie sekcji.}
        \label{hw::sections}
    \end{figure}

    \item \textbf{Rozmieszczenie warstw} (ang. \textit{stackup}) --- dla płytek
    wielowarstwowych powinno być realizowane z~myślą o~optymalnych powrotach
    sygnałów i~najniższej emisji, a~grubości warstw dobierane na podstawie
    docelowej impedancji ścieżek. Przy projektowaniu rozmieszczenia należy
    kierować się następującymi zasadami \cite{bib:ott}:
    \begin{enumerate}

        \item Warstwa sygnałowa powinna być zawsze bezpośrednio sąsiadująca
        z~warstwą odniesienia.
        
        \item Odległość między warstwą sygnałową i~odpowiedającą jej warstwą
        odniesienia powinna być jak najmniejsza.
        
        \item Warstwy odniesienia (zasilania i~masa) powinny być jak najbliżej
        siebie.

        \item Wysokoczęstotliwościowe sygnały powinny znajdować pomiędzy
        warstwami odniesienia.

        \item Im więcej warstw masy, tym lepiej.

        \item Kiedy sygnały krytyczne są prowadzone na więcej niż jednej
        wartswie, to nie powinny przechodzić przez więcej niż dwie bezpośrednio
        sąsiadujące.

    \end{enumerate}

    Większość płytek drukowanych nie może spełniać wszystkich sześciu warunków
    przedstawionych powyżej, dlatego sposób projektowania jest kompromisem.
    Przykładowo, projektując płytkę czterowarstwową, nie sposób spełnić dwóch
    pierwszych zasad jednocześnie. Wykorzystane w projekcie rozmieszczenie
    przedstawiono na rysunku \ref{hw::stackup}:

    \begin{figure}[H]
        \centering
        
        \caption{Rozłożenie warstw.}
        \label{hw::stackup}
    \end{figure}

    Rozmieszczenie \ref{hw::stackup} nie jest zbyt dobre, ponieważ każda warstwa
    odzielona jest od siebie o taką samą odległość. W takim przypadku
    ustatysfakcjonowana jest tylko pierwsza zasada i~znacznie lepiej byłoby,
    gdyby warstwy sygnałowe umieścić bliżej ich warst odniesienia, tak, aby
    również spełnić trzecią.

    \item \textbf{Terminatory} --- należy stosować w~celu kontroli impedancji
    ścieżek transmisyjnych. Dla szybkozmiennych sygnałów i~długich ścieżek
    z~powodu pojemności i~idukcyjności pasożytniczych w~torze mogą wystąpić
    niechcianie oscylacje, które należy wytłumić. Terminatory docelowo dobiera
    się na podstawie impedancji charakterystycznej ścieżki. Wykorzystane sygnały
    cyfrowe w~projekcie, mimo że~wolnozmienne częstotliwościowo, posiadają
    bardzo szybkie zbocze, więc wykorzystano terminatory szeregowe w~postaci
    rezystorów o~rezystancji 100 $\Omega$ bezpośrednio przy ich źródle.

    \item \textbf{Pola masowe} --- puste powierzchnie na warstwach sygnałowych
    należy wypełniać masą i~łączyć przelotkami z~warstwą masy (jeżeli jest).
    Przy układaniu przelotek należy uważać, żeby nie stworzyć odciętych od
    reszty powierzchni (slotów), powodujących problematyczne powroty, które
    przedstawiono na rysunku \ref{hw::returns}. Wypełnienie masą tworzy ekran
    jak i~również może zapewniać dodatkowe drogi powrotne dla sygnałów.
    
\end{enumerate}
