kopiecki/anc/docs/polsl/thesis/chapters/06.tex

\chapter{Testy i~badania}

\section{Weryfikacja części sprzętowej}

Sporządzoną płytkę drukowaną przedstawiono na rysunku \ref{ver::board}:

\begin{figure}[H]
    \centering
    
    \caption{Sporządzona płytka drukowana.}
    \label{ver::board}
\end{figure}

Widoczne na płyce przewody montażowe (kynary) są wynikiem błędu sprzętowego
związanego z~zasilaniem phantom, dla którego bez modyfikacji poprowadzono 12~V.
Z~racji, że wykorzystane mikrofony są wyspecyfikowane na zakres od 15~V do 48~V,
zasilanie 15~V dostarczono przez przewody z~dużych kondensatorów sekcji
filtrującej główne zasilanie. Później zweryfikowano, że wybrane mikrofony
również działają dobrze dla zasilania 12~V, pomiomo, że nie są na niego
wyspecyfikowane, więc finalnie przewody można usunąć i~zostawić początkowe
połączenia.

\subsection{Sekcja zasilania}

Pomiary sekcji zasilania przedstawiono w tabeli \ref{tab::psu}:
\begin{table}[H]
    \centering
    \begin{tabular}{|| c | c | c ||} 
        \hline
        \textbf{Nazwa} & \textbf{Spodziewany wynik} [V] & \textbf{Pomiar} [V] \\
        [0.5ex] \hline\hline
        +15V & 15 $\pm$ 0.75 (5\%) & 15.255 \\ 
        \hline
        -15V & -15 $\pm$ 0.75 (5\%) & \textbf{-13.784} \\
        \hline
        +12VA & 12 $\pm$ 0.24 (2\%) & 11.993 \\
        \hline
        -12VA & -12 $\pm$ 0.36 (3\%) & -11.971 \\
        \hline
        +5VD & 5 $\pm$ 0.1 (2\%) & 5.037 \\
        \hline
        +5VA & 5 $\pm$ 0.002 & 4.998 \\
        \hline
        +1.25\_OFFSET & 1.25 $\pm$ 0.0125 (1\%) & 1.252 \\
        \hline\hline
    \end{tabular}

    \caption{Pomiary sekcji zasilania.}
    \label{tab::psu}
\end{table}

Jak można zauważyć, zasilanie $-$15 V jest poza spodziewaną skalą. Jest to
problem, który nie wpływa drastycznie na pracę pozostałych sekcji, ponieważ
zasilanie później jest filtrowane i~stabilizowane przez liniowy regulator
napięcia niskiego spadku. Pozostałe wartości mieszczą się w~wyspecyfikowanych
zakresach.

\subsection{Wyjściowe sekcje analogowe i~przetworniki}

Pomiary wejść i~wyjść wzmacniacza \ref{hw::gain_out} dla wejściowego sinusa o
częstotliwości 200~Hz i~ampitudzie równej połowie zakresu przetwornika
przedstawiono na rysunku \ref{ver::gain_out}:

\begin{figure}[H]
    \centering
    
    \caption{Pomiary wzmacniacza wyjściowej sekcji analogowej.}
    \label{ver::gain_out}
\end{figure}

Przebieg zielony przedstawia wyjście, a~żółty wejście wzmacniacza
\ref{hw::gain_out}. Jak można zauważyć, wzmocnienie dość dobrze pokrywa się
z~obliczoną teoretycznie wartością $k \approx 4$, nie powoduje saturacji
i~pozostawia bezpieczny zakres 2 V. \par Pomiary wejść i~wyjść filtra
\ref{hw::filt} dla wejściowych sinusów o~częstotliwościach 100~Hz i~500~Hz oraz
amplitudach równych połowie zakresu przetwornika przedstawiono na rysunkach
\ref{ver::filter}:

\begin{figure}[H]
    \centering
    \begin{subfigure}[b]{\textwidth}
        \centering
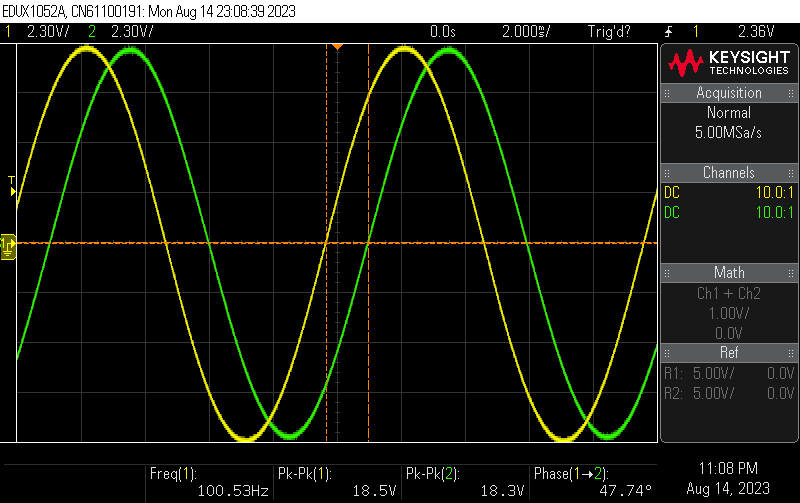
[picture p184: docs/polsl/thesis/graf/verification/100hz_out.png]
        
        \caption{Przebiegi dla częstotliwości 100 Hz.}
    \end{subfigure}
    \hfill
    \begin{subfigure}[b]{\textwidth}
        \centering
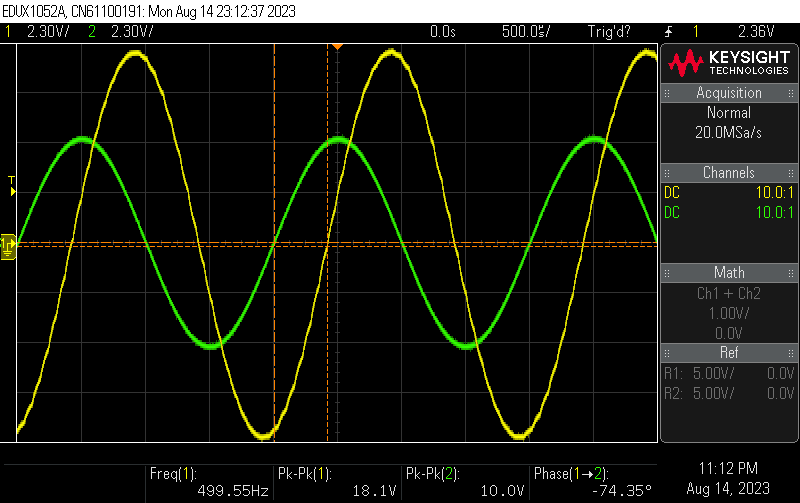
[picture p185: docs/polsl/thesis/graf/verification/500hz_out.png]
        
        \caption{Przebiegi dla częstotliwości 500 Hz.}
    \end{subfigure}
       \caption{Pomiary filtra wyjściowej sekcji analogowej.}
       \label{ver::filter}
\end{figure}
Przebiegi żółte są wyjściami wzmacniacza \ref{hw::gain_out}, a~przebiegi zielone
wyjściami filtra \ref{hw::filt}. Dla sygnału o częstotliwości 500 Hz, która jest
częstotliwością graniczną filtru \ref{hw::filt} można zaobserwować tłumienie
w~okolicach 5 dB. Oznacza to, że pasmo zaporowe zaczyna się wcześniej niż
obliczono, co może być spowodowane rzeczywistymi wartościami elementów wraz
z~ich niedokładnościami. Bliższe pasmo zaporowe filtrów sekcji wyjściowych nie
powoduje problemów, ponieważ sygnały do 500 Hz w dalszym ciągu są użyteczne.
\par Wyjście różnicowe sekcji analogowej dla sygnału sinusoidalnego
o~częsotliwości 200 Hz i~pełnego zakresu przetwornika cyfrowo-analogowego
przedstawiono na rysunku \ref{ver::diff_out}:

\begin{figure}[H]
    \centering
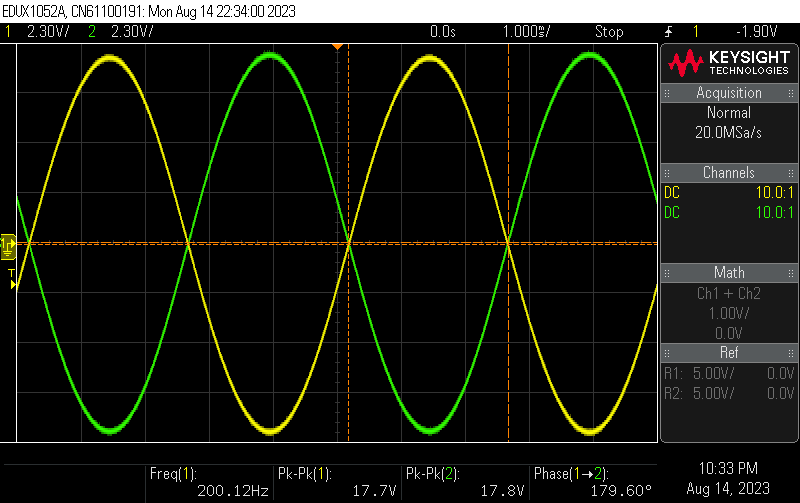
[picture p186: docs/polsl/thesis/graf/verification/diff_out.png]
    
    \caption{Wyjście różnicowe wyjściowej sekcji analogowej.}
    \label{ver::diff_out}
\end{figure}

Sygnały są względem siebie dokładnie odwrócone, a~ich amplituda jest jednakowa,
więc sekcja spełnia swoje zadanie tak jak w~teorii.

\subsection{Wejściowe sekcje analogowe i~przetworniki}

\par Pomiary wejść i~wyjść pełnego toru dla wejściowego sinusa o~częstotliwości
200 Hz i~natężeniu około 85 dB SPL przedstawiono na rysunku \ref{ver::200hz_in}.
Dźwięk odtworzono z~głośnika wykorzystywanego w systemie, a~mikrofon ustawiono
bezpośrednio przy membranie w~cichym pokoju.

\begin{figure}[H]
    \centering
    
    \caption{Pomiary wejściowego toru analogowego dla $f_s = 200$ Hz.}
    \label{ver::200hz_in}
\end{figure}

Przebieg zielony przedstawia wejście przetwornika analogowo-cyfrowego, a~żółty
wyjście wzmacniacza \ref{hw::preamp}. Sygnał na wejściu przetwornika jest
odpowiednio przesunięty o~dodaną składową stałą, a~amplitudy obu sygnałów są
takie same. Gęstość widmową mocy obliczoną metodą Welcha z~oknem Hanna dla $f_s
= 8$ kHz przedstawiono na rysunku \ref{ver::200hz_in_psd}:

\begin{figure}[H]
    \centering
    
    \caption{Gęstość widmowa mocy pomiaru dla $f_s = 200$ Hz.}
    \label{ver::200hz_in_psd}
\end{figure}

Na przebiegu \ref{ver::200hz_in_psd} dobrze widać wpływ filtra \ref{hw::filt},
który mocno wytłumia zakres powyżej 500 Hz. Pik nagranego sinusa jest dużej
mocy, widać jego harmoniczne a~tło szumu akceptowalne.

\par Pomiary wejść i~wyjść pełnego toru dla wejściowego sinusa o~częstotliwości
500 Hz i~natężeniu około 85 dB SPL przedstawiono na rysunku \ref{ver::500hz_in}.
Dźwięk odtworzono analogicznie jak w~poprzednim pomiarze.

\begin{figure}[H]
    \centering
    
    \caption{Pomiary wejściowego toru analogowego dla $f_s = 500$ Hz.}
    \label{ver::500hz_in}
\end{figure}

Przebieg zielony przedstawia wejście przetwornika analogowo-cyfrowego, a~żółty
wyjście wzmacniacza \ref{hw::preamp}. Poza obserwacjami analogicznymi jak
w~punkcie wyżej, można zaobserwować, że~filtr \ref{hw::filt} w~tej sekcji
zachowuje się zgodniej z~obliczeniami. Tłumienie dla sygnału o~częstotliwości
granicznej wynosi około 3.22 dB. Gęstość widmową mocy obliczoną metodą Welcha
z~oknem Hanna dla $f_s = 8$ kHz przedstawiono na rysunku
\ref{ver::500hz_in_psd}:

\begin{figure}[H]
    \centering
    
    \caption{Gęstość widmowa mocy pomiaru dla $f_s = 500$ Hz.}
    \label{ver::500hz_in_psd}
\end{figure}

Nagrany sinus jest mniejszej mocy niż na \ref{ver::500hz_in_psd}, a~jego
najbliższe harmoniczne mniej widoczne, co może być spodowowane kombinacją
filtracji i~jakością nagrania.

\section{Weryfikacja części programowej}

Sporządzony układ, stanowiący wykorzystane do badań stanowisko pomiarowe
przedstawiono na rysunku \ref{ver::stand}:

\begin{figure}[H]
    \centering
    
    \caption{Stanowisko pomiarowe.}
    \label{ver::stand}
\end{figure}

\subsection{Identyfikacja toru wtórnego}

Aby zweryfikować wpływ rozmiaru fragmentów na długość opóźnienia, identyfikację
przeprowadzono dla $n_f = 32$ i~$n_f = 64$. Sygnały wejściowe wygenerowano za
pomocą generatora \textit{xoroshiro16++}, a~eksperymenty przeprowadzano za pomocą
metody korelacyjnej w pięciosekundowym oknie. Zidentyfikowane odpowiedzi
impulsowe ograniczone do dwustu wartości przedstawiono na rysunku \ref{ver::ident}:

\begin{figure}[H]
    \centering
    
    \caption{Indentyfikacja toru wtórnego --- wpływ $n_f$.}
    \label{ver::ident}
\end{figure}

Jak można zauważyć z \ref{ver::ident}, buforowanie wpływa na zidentyfikowaną
odpowiedź impulsową, opóźniając ją o~ilość próbek równą długości fragmentu. Poza
opóźnieniem wynikającym z~buforowania, na przebiegu odpowiedzi impulsowej można
zaobserwować wpływ torów analogowych, objawiający się dodatkowym opóźnieniem,
wynikającym głównie z~filtracji.

\subsection{Badania procesu ANC --- wpływ parametrów}

Pomiary przeprowadzono na trzech sygnałach wejściowych zdefiniowanych poniżej:
\begin{enumerate}
    \item Sygnały sinusoidalne o~częstotliwościach $f = 120$ Hz i~$f = 220$ Hz,
    których nagrania mikrofonem błędu przedstawiono na rysunkach
    \ref{ver::sig_sine}:
    \begin{figure}[H]
        \centering
        \begin{subfigure}[b]{0.49\textwidth}
            \centering
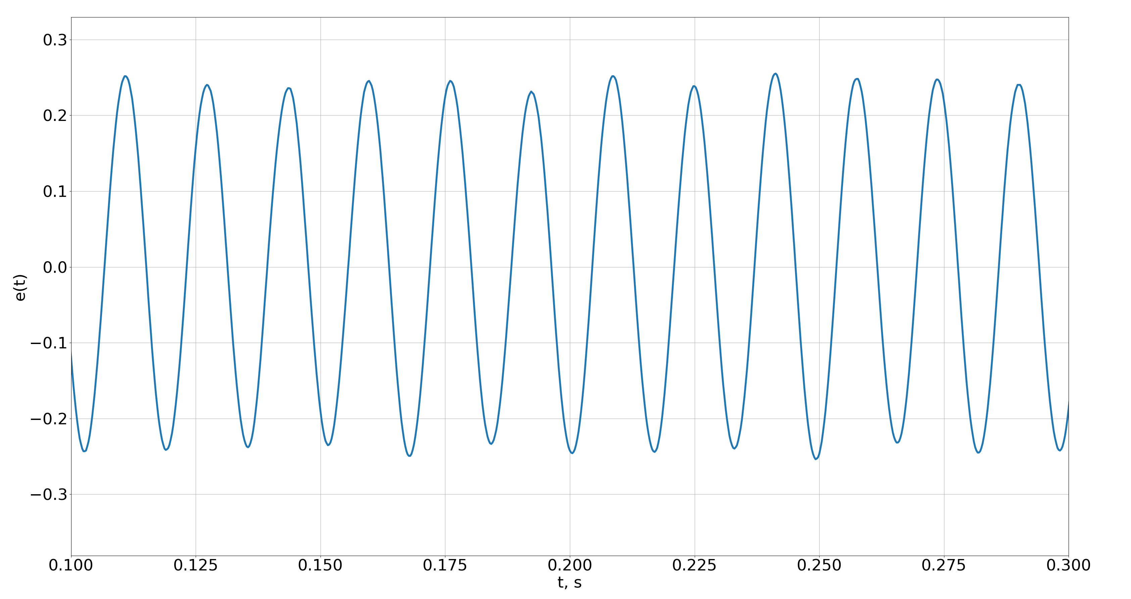
[picture p187: docs/polsl/thesis/graf/verification/raw_120hz.png]
            
            \caption{Sinusoida o $f = 120$ Hz.}
            \label{ver::120hz}
        \end{subfigure}
        \begin{subfigure}[b]{0.49\textwidth}
            \centering
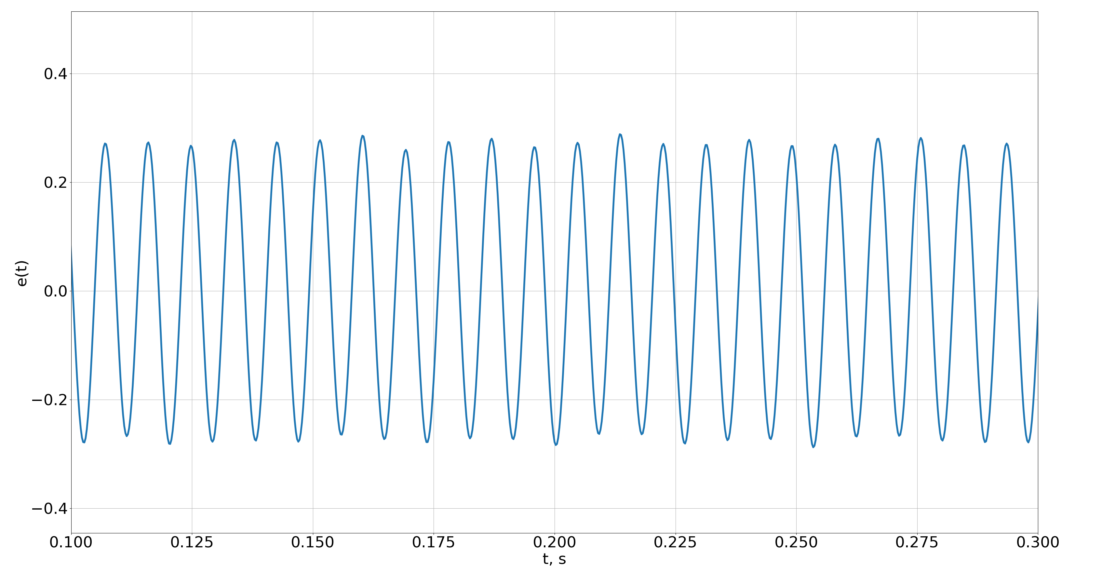
[picture p188: docs/polsl/thesis/graf/verification/raw_220hz.png]
            
            \caption{Sinusoida o $f = 220$ Hz.}
            \label{ver::220hz}
        \end{subfigure}
           \caption{Przebiegi referencyjne.}
           \label{ver::sig_sine}
    \end{figure}

    \item Sumy dwóch sinusoid o~częstotliwościach $f_0 = 120$ Hz i~$f_1 = 160$
    Hz, których nagranie mikrofonem błędu przedstawiono na rysunku
    \ref{ver::sig_sum}:

    \begin{figure}[H]
        \centering
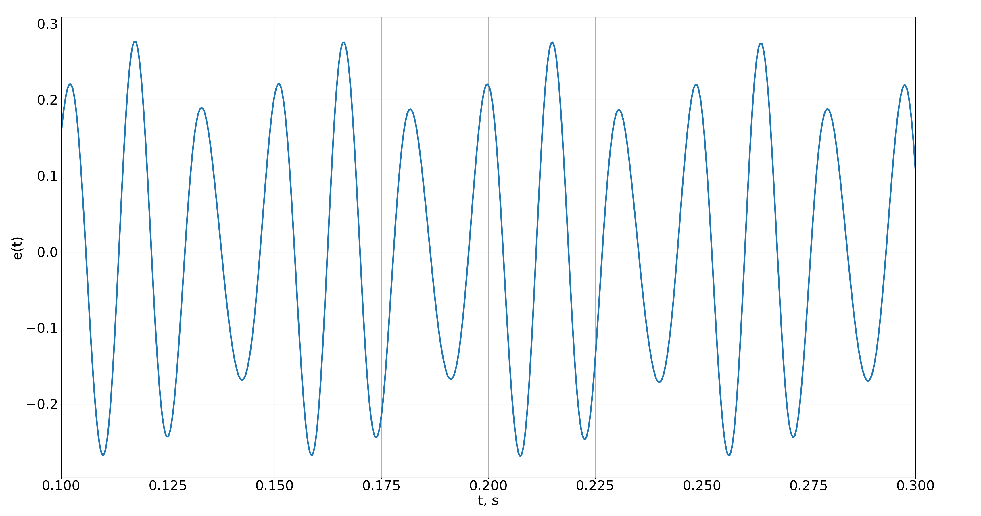
[picture p189: docs/polsl/thesis/graf/verification/raw_sum.png]
        
        \caption{Suma sinusoid o $f_0 = 120$ Hz i~$f_1 = 160$ Hz.}
        \label{ver::sig_sum}
    \end{figure} 
\end{enumerate}

Dla każdego sygnału starano utrzymać nateżenie w~okolicach 80 dB SPL, badania
przeprowadzano w~oknie czasowym o~długości pięciu sekund, a~wyniki poddawno
skalowaniu do zakresu -1 do 1. Z parametrów poddawanych ocenie wyróżniono:
\begin{enumerate}
    \item Wielkość kroku adaptacji $\alpha$ algorytmu NLMS 
    \item Długość filtra $W(z^{-1})$ 
    \item Długość fragmentu $n_f$
    \item Częstotliwość próbkowania $f'_s$
    \item Poziom priorytetu $P$ i~wytyczna planisty
\end{enumerate}

Oceny wpływów poszczególnych parametrów realizowano dla stałych wartości
pozostałych. Zestaw parametrów stanowiących punkt referencjny
do reszty badań przedstawiono w tabeli \ref{tab::ref}:

\begin{table}[H]
    \centering
    \begin{tabular}{|| c | c | c | c | c | c ||} 
        \hline
        $f'_s$, Hz & $n_f$, ramki & $\alpha$ & $L$ & $P$ & Wytyczna planisty \\ 
        \hline\hline
        $2000$ & $32$ & 0.1 & $128$ & 99 & SCHED\_RR \\
        \hline\hline
    \end{tabular}
    \caption{Wybrany zestaw parametrów referencyjnych.}
    \label{tab::ref}
\end{table}

Częstotliwość $f'_s$ w tabeli \ref{tab::ref} jest częstotliwością uzyskiwaną po
przeprowadzeniu decymacji z $M = 4$ i~tak określony dzielnik pozostał niezmienny
w trakcie badań. W celu dobrania odpowiedniego kroku, wstępnie przeprowadzono
serię kilku pomiarów, mających na celu wyłonienie wartości $\alpha$, dla której
układ zachowuje się najzgodniej z oczekiwaniami. W ich trakcie zauważono, że dla
kroku $\alpha > 0.1$ system zaczyna działać niepoprawnie, co~objawia się
kompletnym brakiem tłumienia i~generacją sygnału wyjściowego, powodującego
sumarycznie większy hałas, niż w przypadku wyłączonego układu. W związku z~tym,
krok $\alpha = 0.1$ przyjęto jako granicę, stanowiącą parametr referencyjny oraz
ogaraniczenie dla reszty badań. \par Aby uniknąć duplikacji wykresów, dla
parametrów zdefiniowanych w \ref{tab::ref} uzyskane przebiegi błędu $e(n)$
przedstawiono na rysunkach \ref{ver::ref_sig}.

\begin{figure}[H]
    \centering
    \begin{subfigure}[b]{0.49\textwidth}
        \centering
        
        \caption{Pierwszy sygnał testowy.}
    \end{subfigure}
    \begin{subfigure}[b]{0.49\textwidth}
        \centering
        
        \caption{Drugi sygnał testowy.}
    \end{subfigure}
    \begin{subfigure}[b]{0.49\textwidth}
        \centering
        
        \caption{Trzeci sygnał testowy.}
    \end{subfigure}
       \caption{Przebiegi referencyjne $e(n)$ dla sygnałów testowych.}
       \label{ver::ref_sig}
\end{figure}

Jak można wywnioskować z rysunków \ref{ver::ref_sig}, sinusoidy są idealnie
tłumione, a~czas zbieżności można oszacować na około 0.4 s w obu przypadkach.
Dlu sumy sinusów algorytm zbiega się zdecydowanie dłużej i~czas, do którego błąd
osiąga wartości bardzo bliskie zeru, można oszacować na około 2 s, a tłumienie,
realizowane przez system jest wyczuwalne przez słuchacza, nawet kiedy nie stoi
bezpośrednio przy mikrofonie błędu.

\subsubsection{Wpływ wielkości kroku}

Do badania wpływu wielkości kroku $\alpha$ przyjęto zestaw parametrów
referencyjnych zgodnie z~tabelą \ref{tab::ref}, a~krok algorytmu NLMS $\alpha$
dobierano zgodnie z~zależnością:
\begin{equation}
    \alpha(i) = \frac{i}{50}, \qquad \text{dla } i = 1, 2, 3, 4.
\end{equation}

Rezultaty dla pierwszego sygnału testowego \ref{ver::120hz} przedstawiono na
rysunkach \ref{ver::alpha_120hz}:

\begin{figure}[H]
    \centering
    \begin{subfigure}[b]{0.49\textwidth}
        \centering
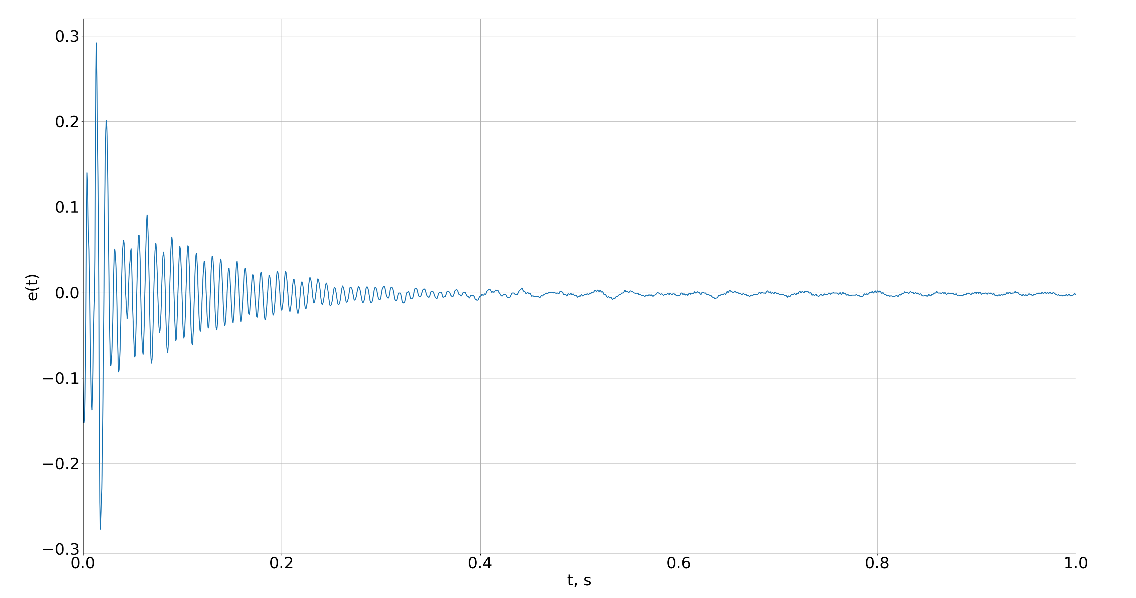
[picture p190: docs/polsl/thesis/graf/verification/alpha_120hz_08.png]
        
        \caption{$\alpha = 0.08$.}
    \end{subfigure}
    \begin{subfigure}[b]{0.49\textwidth}
        \centering
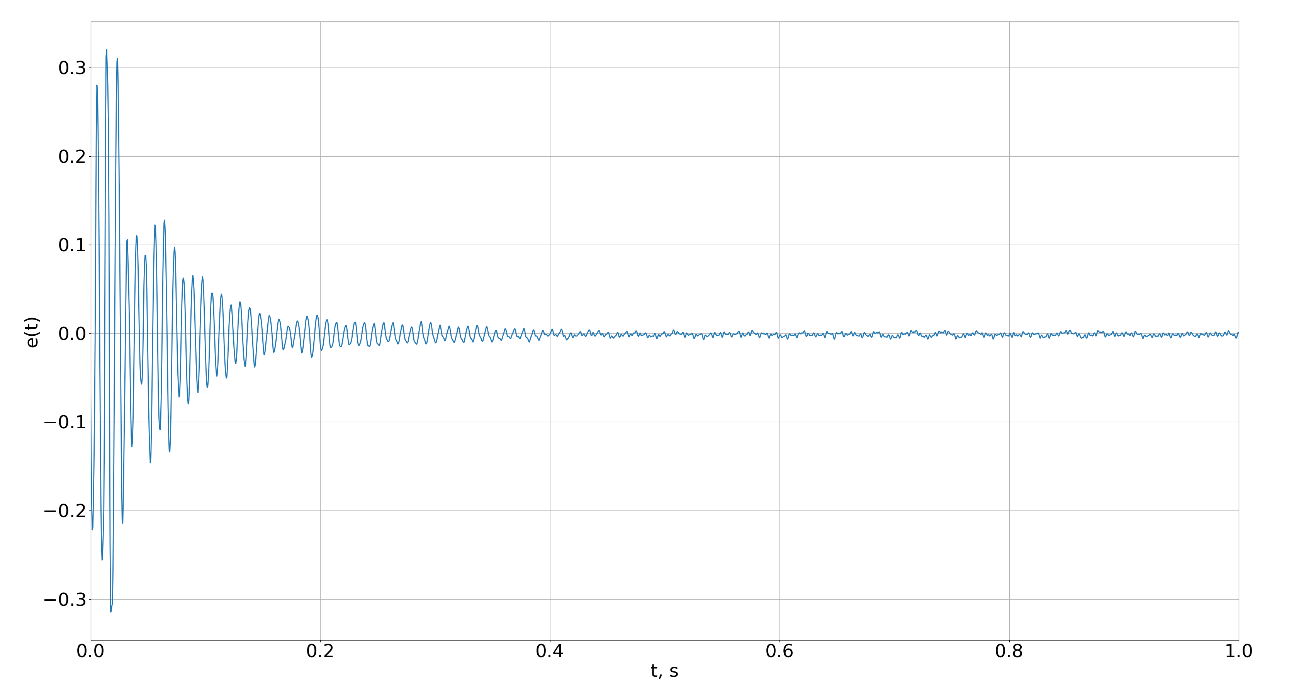
[picture p191: docs/polsl/thesis/graf/verification/alpha_120hz_06.png]
        
        \caption{$\alpha = 0.06$.}
    \end{subfigure}
    \begin{subfigure}[b]{0.49\textwidth}
        \centering
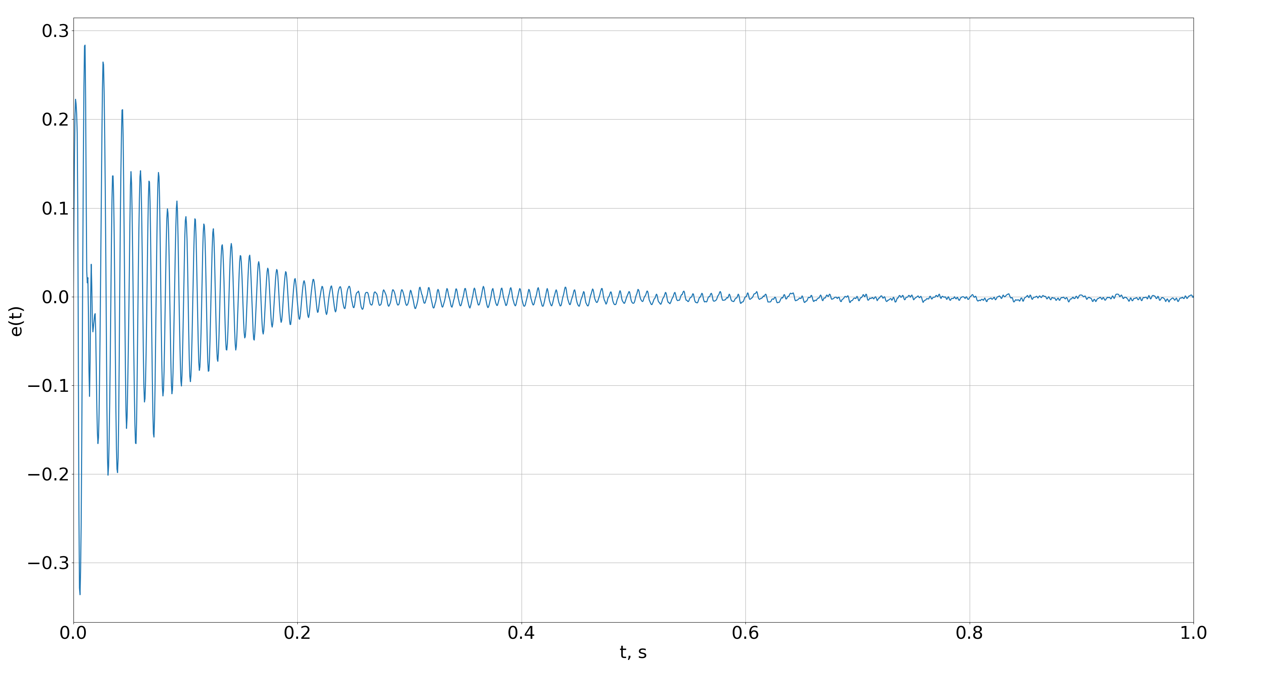
[picture p192: docs/polsl/thesis/graf/verification/alpha_120hz_04.png]
        
        \caption{$\alpha = 0.04$.}
    \end{subfigure}
    \begin{subfigure}[b]{0.49\textwidth}
        \centering
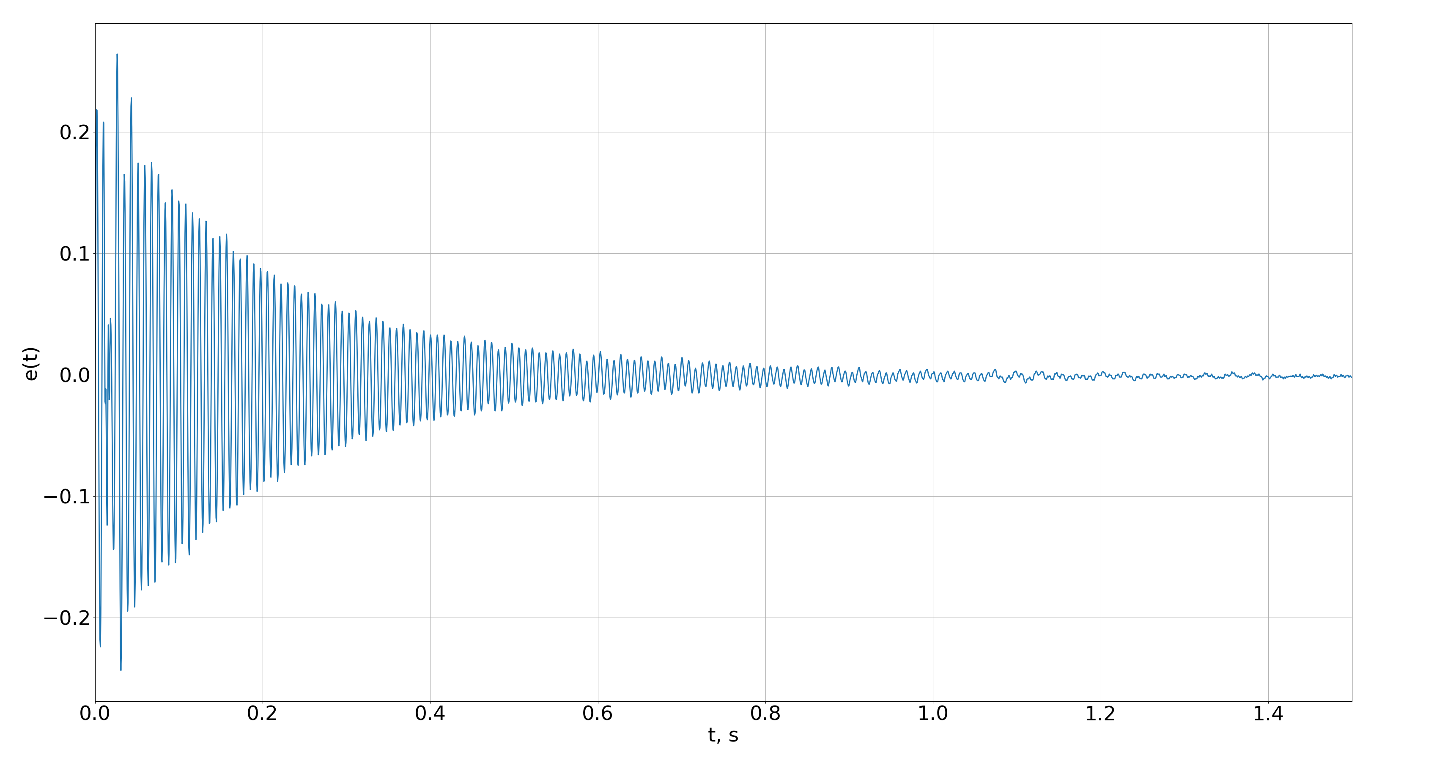
[picture p193: docs/polsl/thesis/graf/verification/alpha_120hz_02.png]
        
        \caption{$\alpha = 0.02$.}
    \end{subfigure}
    \caption{Przebiegi $e(t)$ dla sygnału pierwszego --- wpływ $\alpha$.}
       \label{ver::alpha_120hz}
\end{figure}

Rezultaty dla drugiego sygnału testowego \ref{ver::220hz} przedstawiono na
rysunkach \ref{ver::alpha_220hz}:

\begin{figure}[H]
    \centering
    \begin{subfigure}[b]{0.49\textwidth}
        \centering
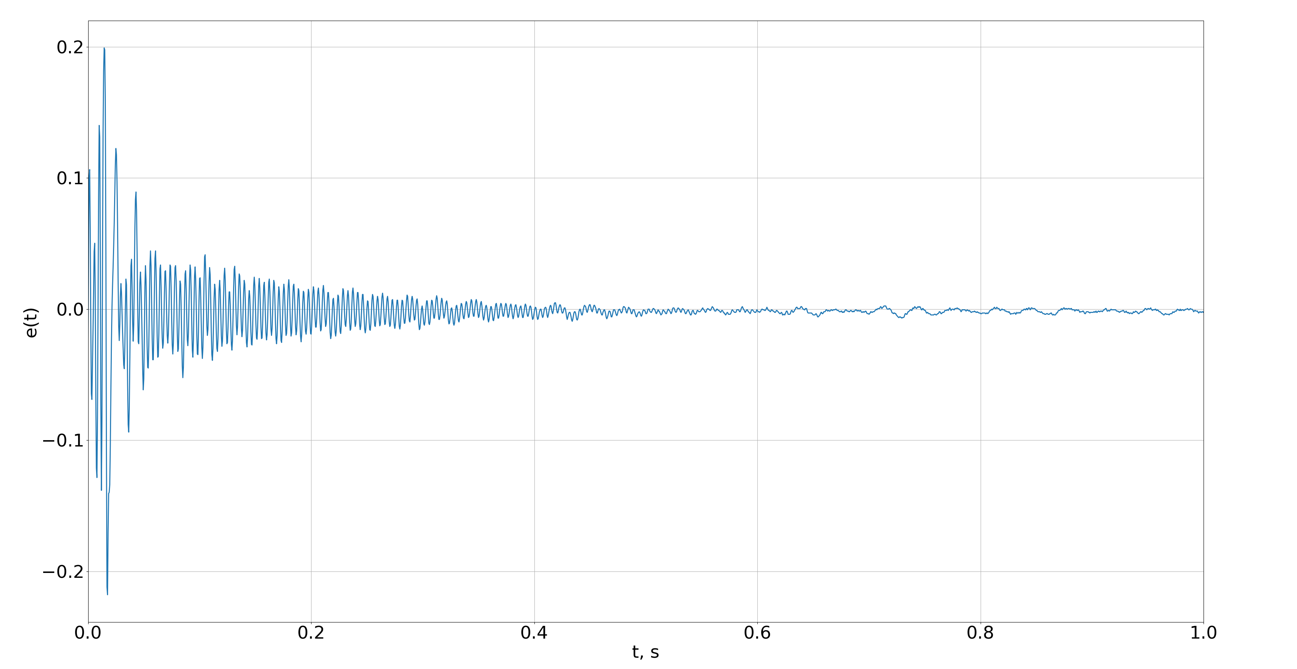
[picture p194: docs/polsl/thesis/graf/verification/alpha_220hz_08.png]
        
        \caption{$\alpha = 0.08$.}
    \end{subfigure}
    \begin{subfigure}[b]{0.49\textwidth}
        \centering
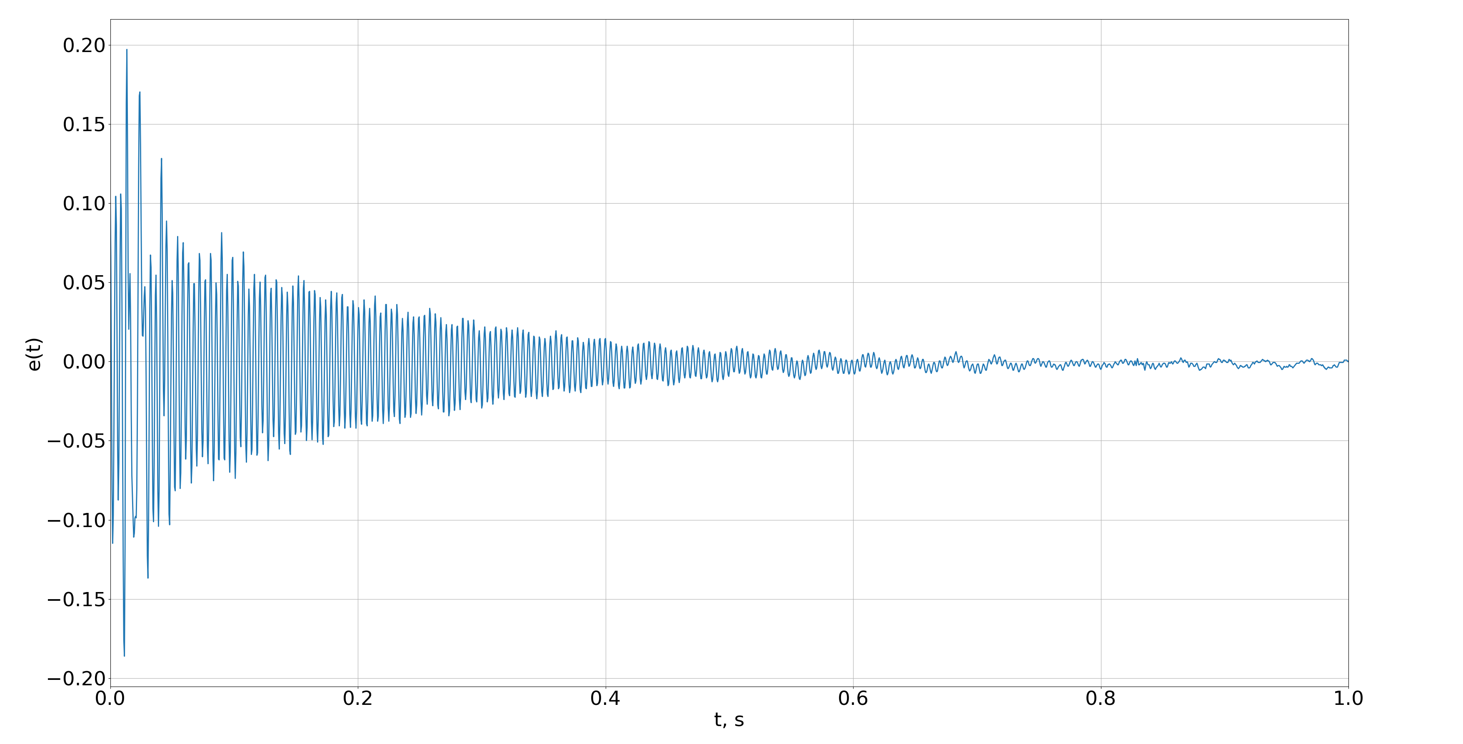
[picture p195: docs/polsl/thesis/graf/verification/alpha_220hz_06.png]
        
        \caption{$\alpha = 0.06$.}
    \end{subfigure}
    \begin{subfigure}[b]{0.49\textwidth}
        \centering
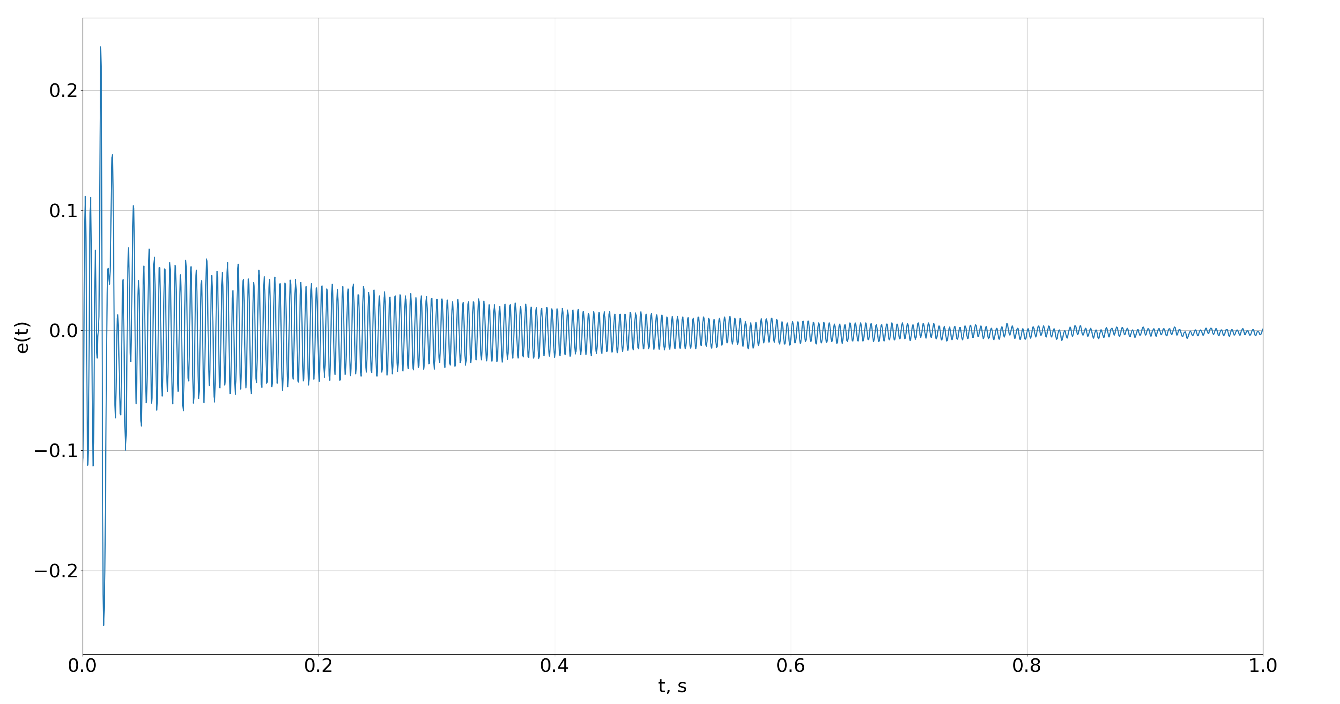
[picture p196: docs/polsl/thesis/graf/verification/alpha_220hz_04.png]
        
        \caption{$\alpha = 0.04$.}
    \end{subfigure}
    \begin{subfigure}[b]{0.49\textwidth}
        \centering
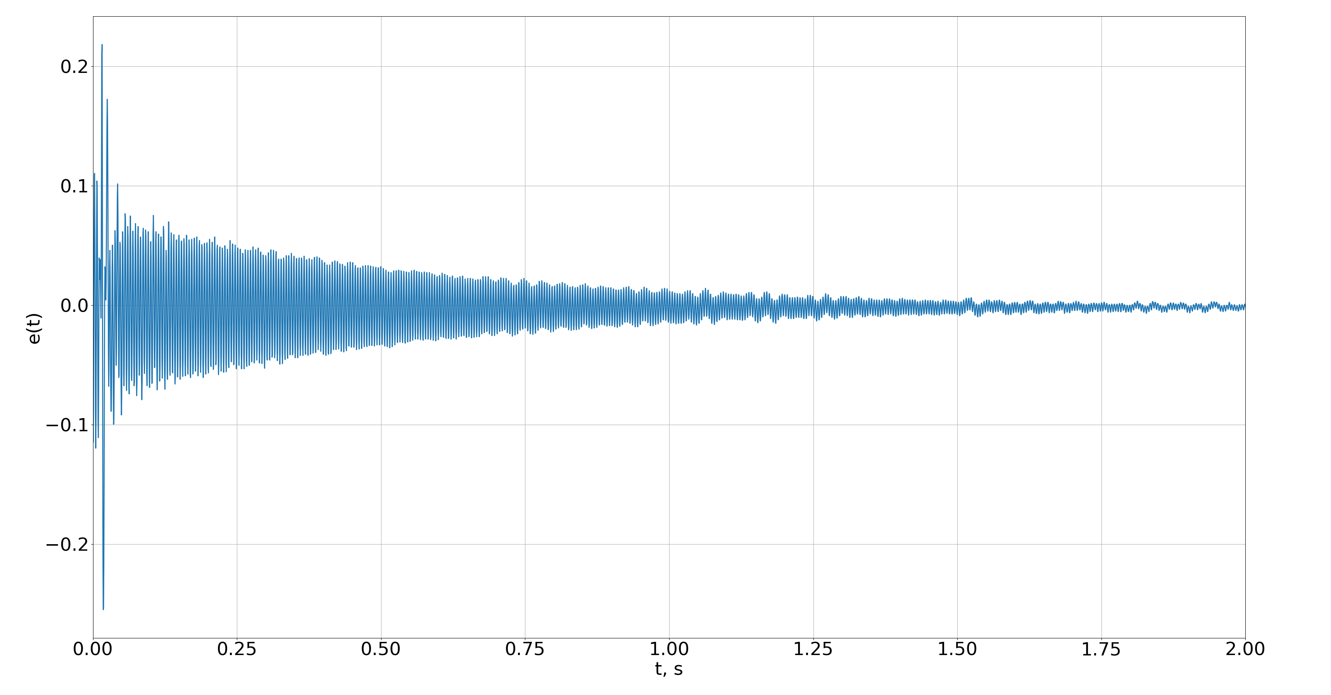
[picture p197: docs/polsl/thesis/graf/verification/alpha_220hz_02.png]
        
        \caption{$\alpha = 0.02$.}
    \end{subfigure}
    \caption{Przebiegi $e(t)$ dla sygnału drugiego --- wpływ $\alpha$.}
       \label{ver::alpha_220hz}
\end{figure}

Rezultaty dla trzeciego sygnału testowego \ref{ver::sig_sum} przedstawiono na
rysunkach \ref{ver::alpha_sum}:

\begin{figure}[H]
    \centering
    \begin{subfigure}[b]{0.49\textwidth}
        \centering
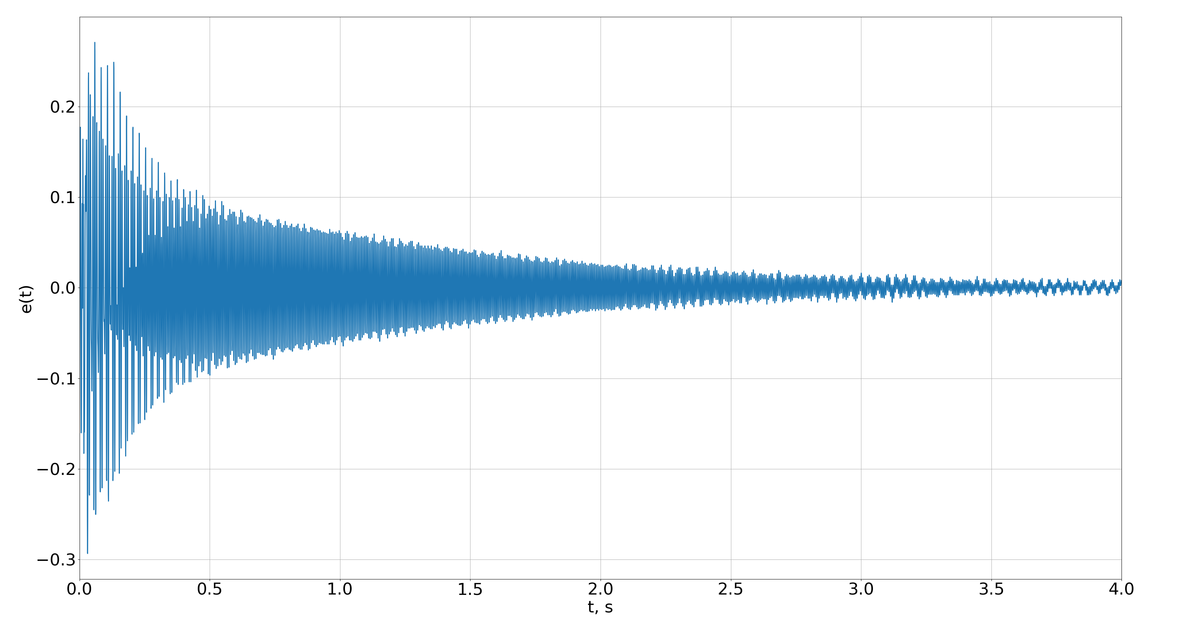
[picture p198: docs/polsl/thesis/graf/verification/alpha_sum_08.png]
        
        \caption{$\alpha = 0.08$.}
    \end{subfigure}
    \begin{subfigure}[b]{0.49\textwidth}
        \centering
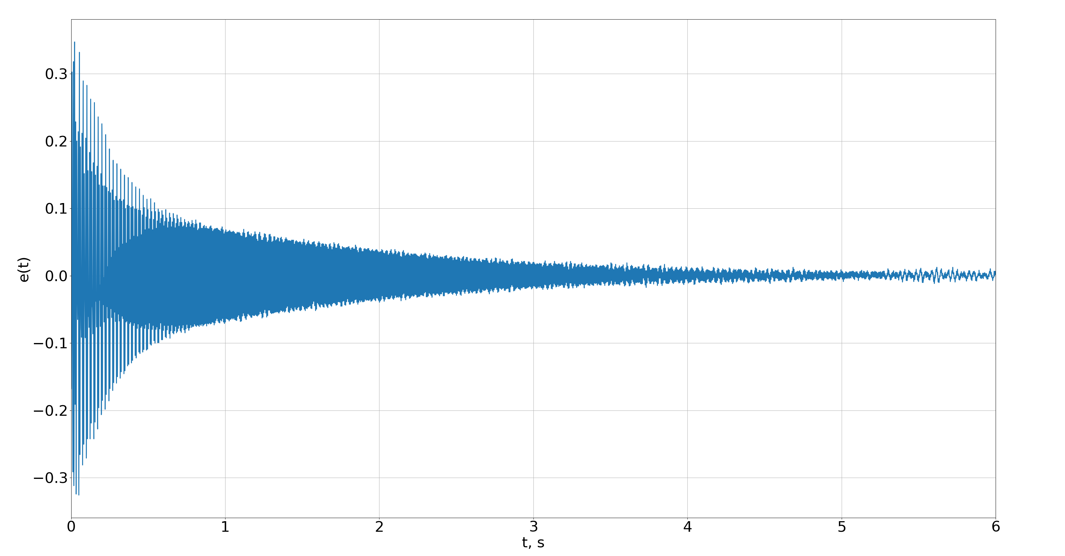
[picture p199: docs/polsl/thesis/graf/verification/alpha_sum_06.png]
        
        \caption{$\alpha = 0.06$.}
    \end{subfigure}
    \begin{subfigure}[b]{0.49\textwidth}
        \centering
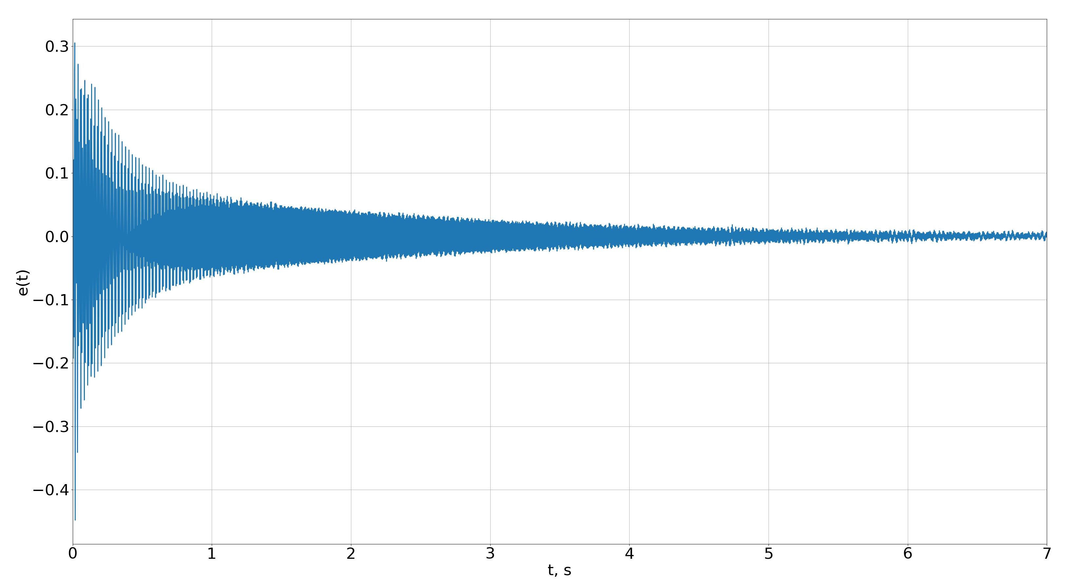
[picture p200: docs/polsl/thesis/graf/verification/alpha_sum_04.png]
        
        \caption{$\alpha = 0.04$.}
    \end{subfigure}
    \begin{subfigure}[b]{0.49\textwidth}
        \centering
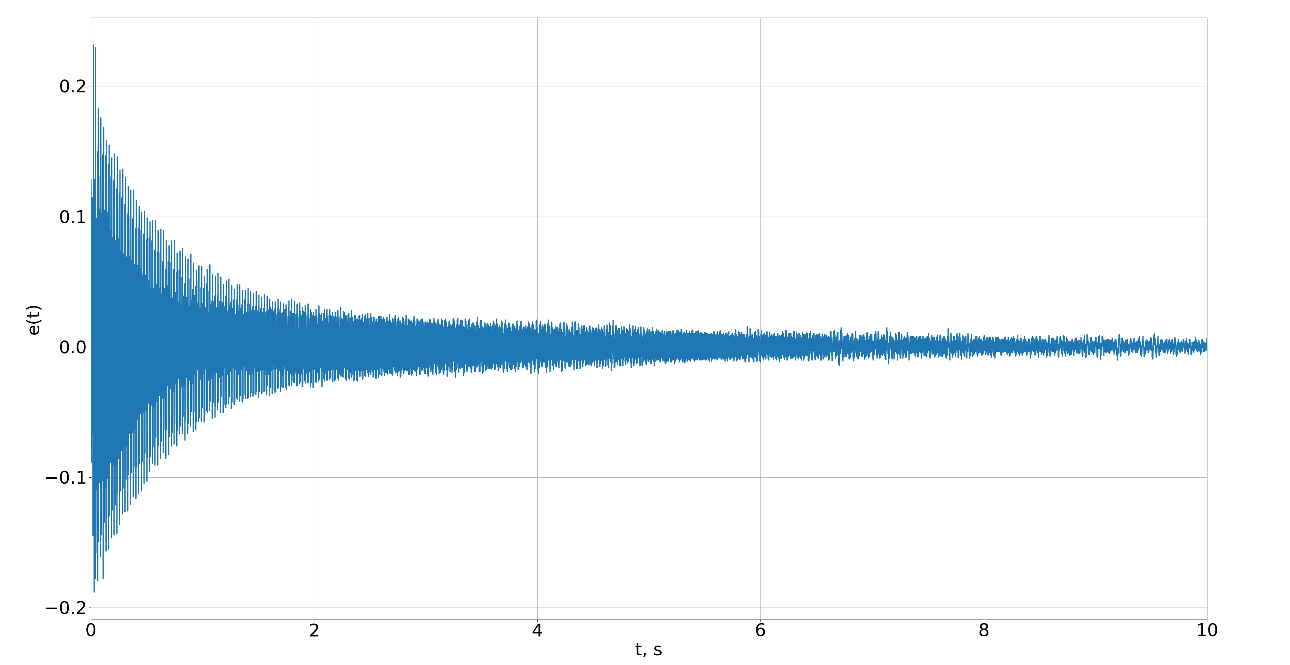
[picture p201: docs/polsl/thesis/graf/verification/alpha_sum_02.png]
        
        \caption{$\alpha = 0.02$.}
    \end{subfigure}
    \caption{Przebiegi $e(t)$ dla sygnału trzeciego --- wpływ $\alpha$.}
       \label{ver::alpha_sum}
\end{figure}

Jak można zauważyć z rysunków \ref{ver::alpha_120hz}, \ref{ver::alpha_220hz} i
\ref{ver::alpha_sum}, krok $\alpha$ algorytmu NLMS wpływa na szybkość zbieżności, co
pokrywa się z teorią. Szacowane czasy zbieżności dla poszczególnych wartości
kroku i~sygnałów testowych przedstawiono w tabeli \ref{tab::alpha}:

\begin{table}[H]
    \centering
    \begin{adjustbox}{width=\textwidth}
        \begin{tabular}{|| c | c | c | c | c | c ||} 
        \hline
        Sygnał & $t_z$ dla $\alpha = 0.1$ & $t_z$ dla $\alpha = 0.08$ & $t_z$
        dla $\alpha = 0.06$ & $t_z$ dla $\alpha = 0.04$ & $t_z$ dla $\alpha =
        0.02$ \\ 
        \hline
        Sinusoida o $f = 120$ Hz & 0.36 & 0.42 & 0.56 & 0.67 & 1.11 \\
        \hline
        Sinusoida o $f = 120$ Hz & 0.46 & 0.55 & 0.80 & 0.92 & 1.87 \\
        \hline
        Suma sinusoid & 1.8 & 3.6 & 4.54 & 6.16 & $>10$ \\
        \hline\hline
    \end{tabular}
    \end{adjustbox}
    \caption{Wybrany zestaw parametrów referencyjnych.}
    \label{tab::alpha}
\end{table}

Zmniejszenie kroku powoduje wolniejsze zbieganie się algorytmu, a największą
różnicę widać w momencie zmiany kroku z 0.04 na 0.02. Jak można zauważyć z
\ref{tab::ref}, z sygnałów testowych najwolniej zbiega się suma sinusoid i~dla
tego sygnału zaobserwowano również największe różnice pomiędzy kolejnymi
wartościami kroku.

\subsubsection{Wpływ długości filtrów}

Do badania wpływu długości $L$ filtra $W(z^{-1})$ przyjęto zestaw parametrów
referencyjnych zgodnie z tabelą \ref{tab::ref}, a wartość $L$ dobierano zgodnie
z zależnością:
\begin{equation}
    L(i) = 2^i \qquad \text{dla } i = 8, 9, 10.
\end{equation}

Rezultaty dla pierwszego sygnału testowego \ref{ver::120hz} przedstawiono na
rysunkach \ref{ver::l_120hz}:

\begin{figure}[H]
    \centering
    \begin{subfigure}[b]{0.49\textwidth}
        \centering
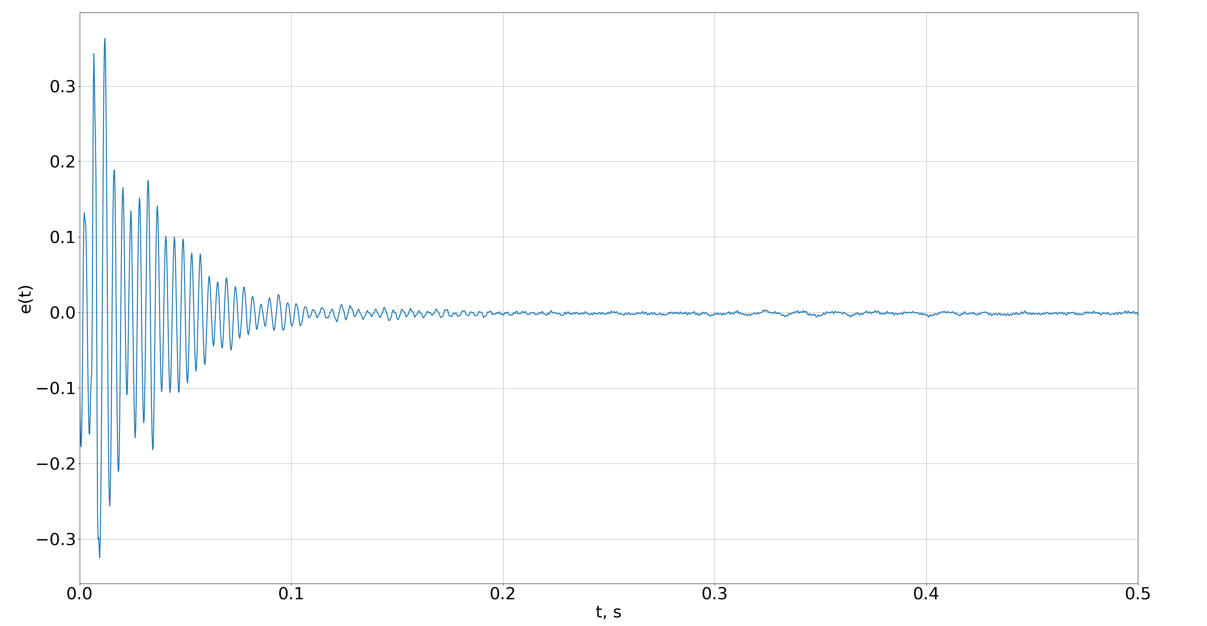
[picture p202: docs/polsl/thesis/graf/verification/l_120hz_256.png]
        
        \caption{$L = 256$.}
    \end{subfigure}
    \begin{subfigure}[b]{0.49\textwidth}
        \centering
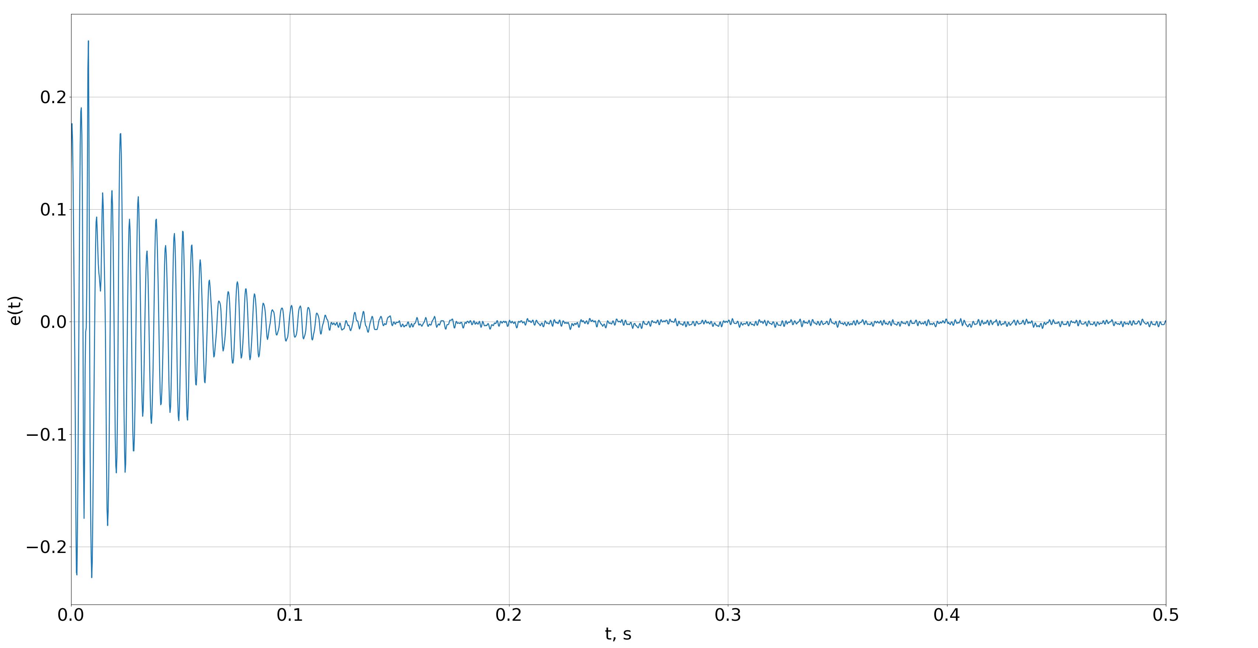
[picture p203: docs/polsl/thesis/graf/verification/l_120hz_512.png]
        
        \caption{$L = 512$.}
    \end{subfigure}
    \begin{subfigure}[b]{0.49\textwidth}
        \centering
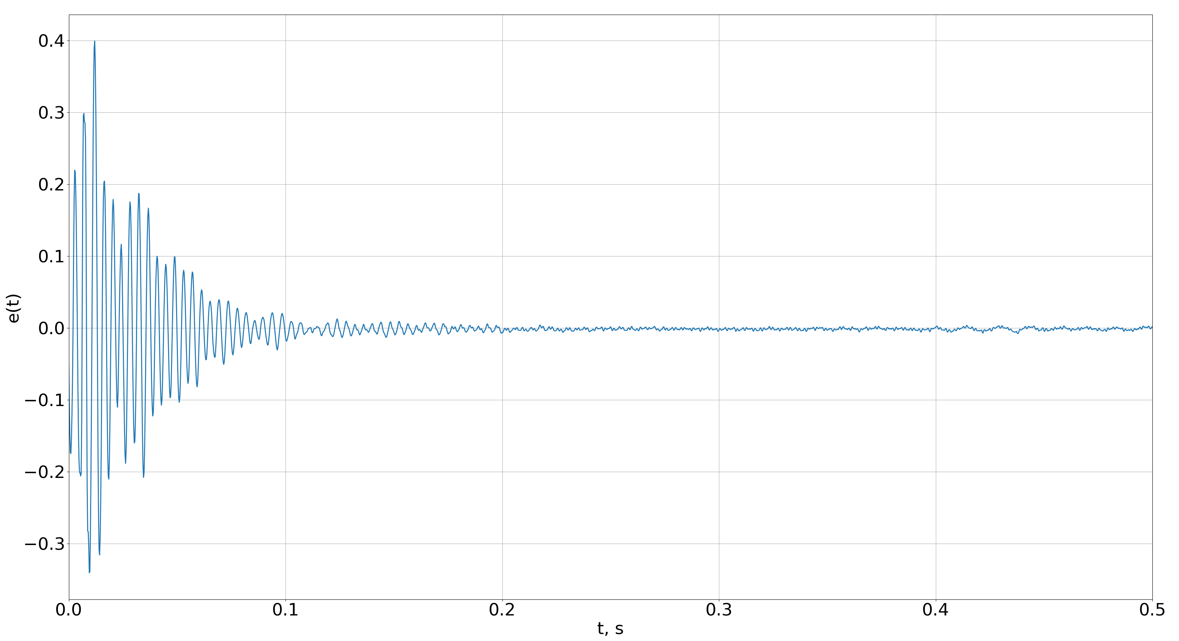
[picture p204: docs/polsl/thesis/graf/verification/l_120hz_1024.png]
        
        \caption{$L = 1024$.}
    \end{subfigure}
    \caption{Przebiegi $e(t)$ dla sygnału pierwszego --- wpływ $L$.}
       \label{ver::l_120hz}
\end{figure}

Rezultaty dla drugiego sygnału testowego \ref{ver::220hz} przedstawiono na
rysunkach \ref{ver::l_220hz}:

\begin{figure}[H]
    \centering
    \begin{subfigure}[b]{0.49\textwidth}
        \centering
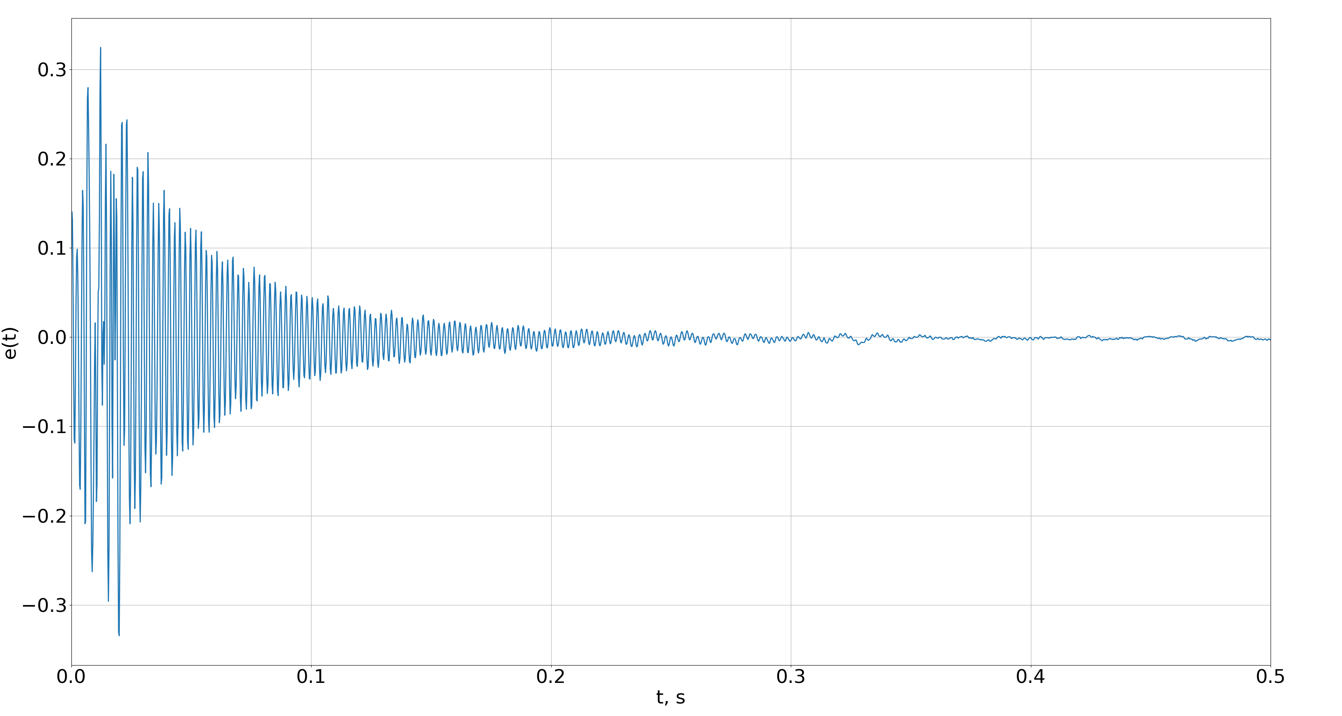
[picture p205: docs/polsl/thesis/graf/verification/l_220hz_256.png]
        
        \caption{$L = 256$.}
    \end{subfigure}
    \begin{subfigure}[b]{0.49\textwidth}
        \centering
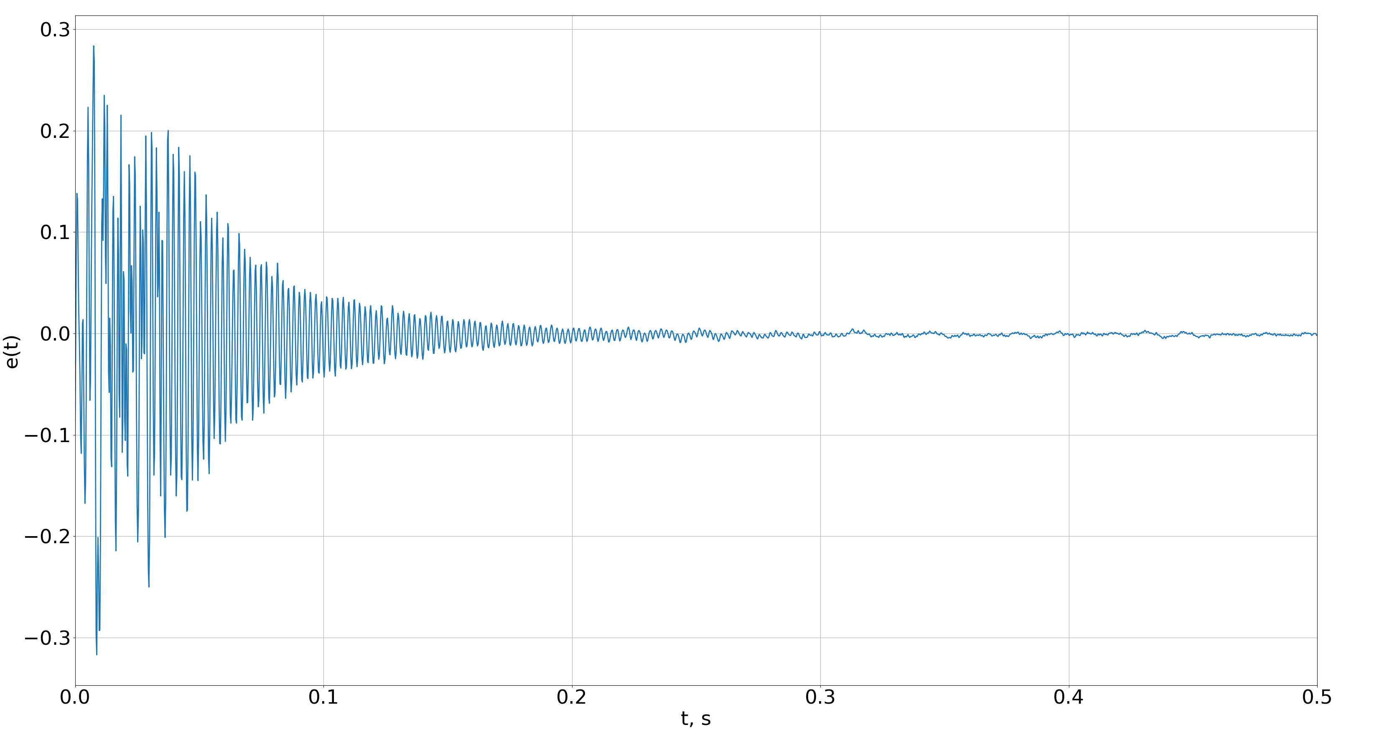
[picture p206: docs/polsl/thesis/graf/verification/l_220hz_512.png]
        
        \caption{$L = 512$.}
    \end{subfigure}
    \begin{subfigure}[b]{0.49\textwidth}
        \centering
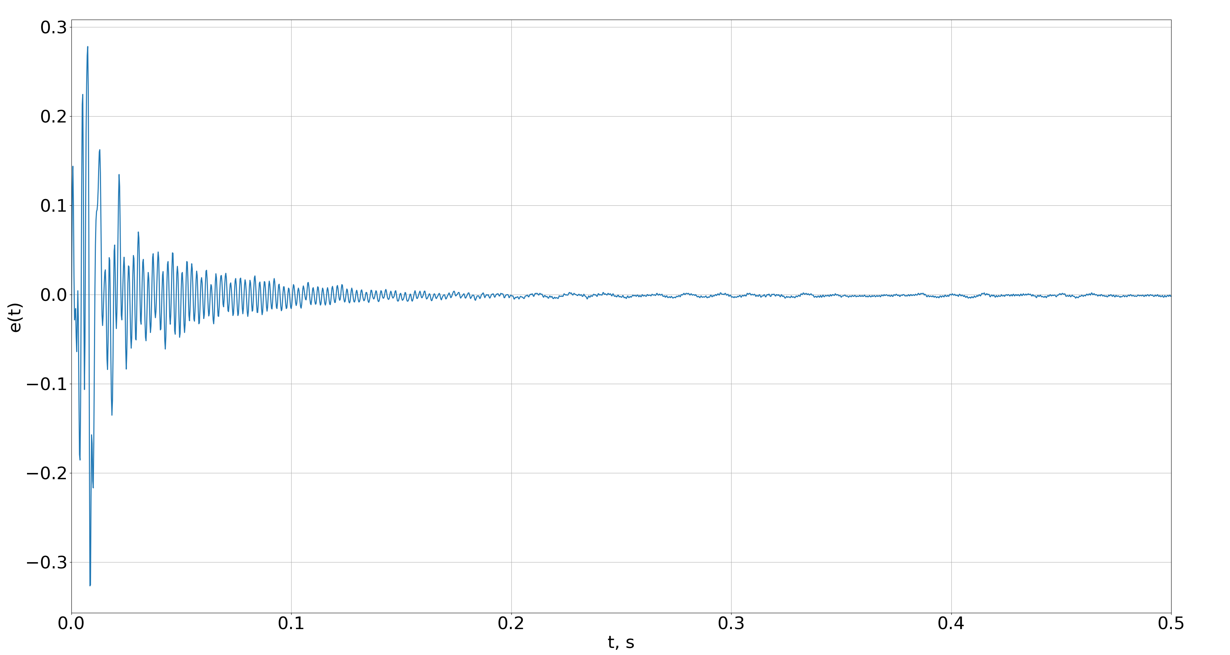
[picture p207: docs/polsl/thesis/graf/verification/l_220hz_1024.png]
        
        \caption{$L = 1024$.}
    \end{subfigure}
    \caption{Przebiegi $e(t)$ dla sygnału drugiego --- wpływ $L$.}
    \label{ver::l_220hz}
\end{figure}

Rezultaty dla trzeciego sygnału testowego \ref{ver::sig_sum} przedstawiono na
rysunkach \ref{ver::l_sum}:

\begin{figure}[H]
    \centering
    \begin{subfigure}[b]{0.49\textwidth}
        \centering
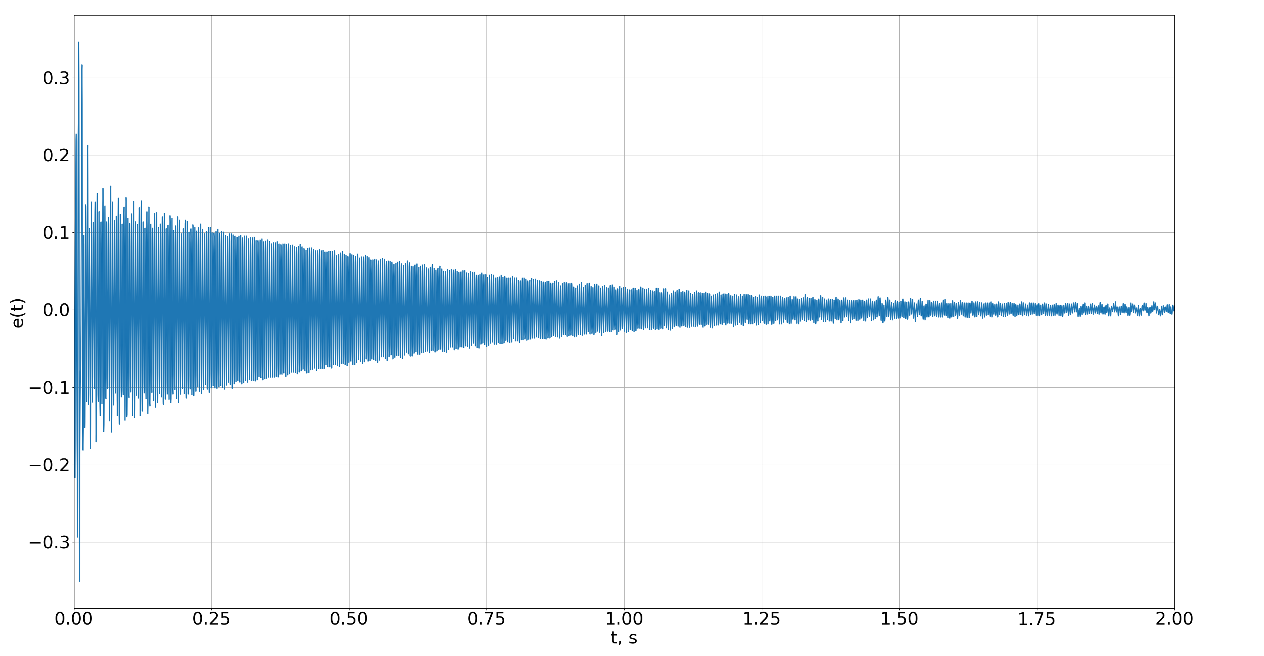
[picture p208: docs/polsl/thesis/graf/verification/l_sum_256.png]
        
        \caption{$L = 256$.}
    \end{subfigure}
    \begin{subfigure}[b]{0.49\textwidth}
        \centering
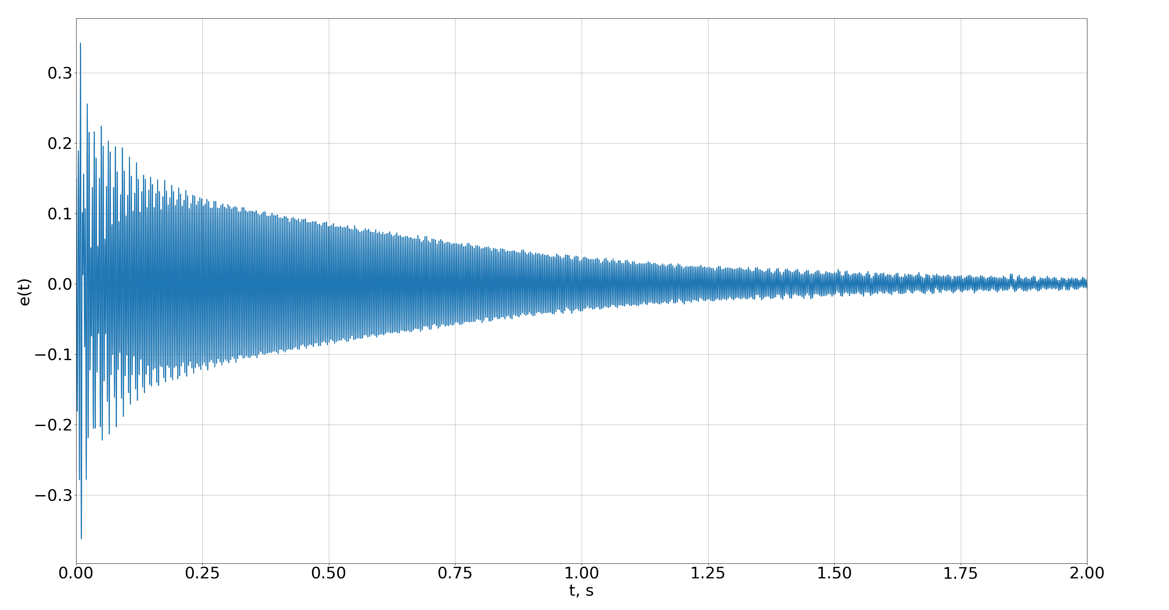
[picture p209: docs/polsl/thesis/graf/verification/l_sum_512.png]
        
        \caption{$L = 512$.}
    \end{subfigure}
    \begin{subfigure}[b]{0.49\textwidth}
        \centering
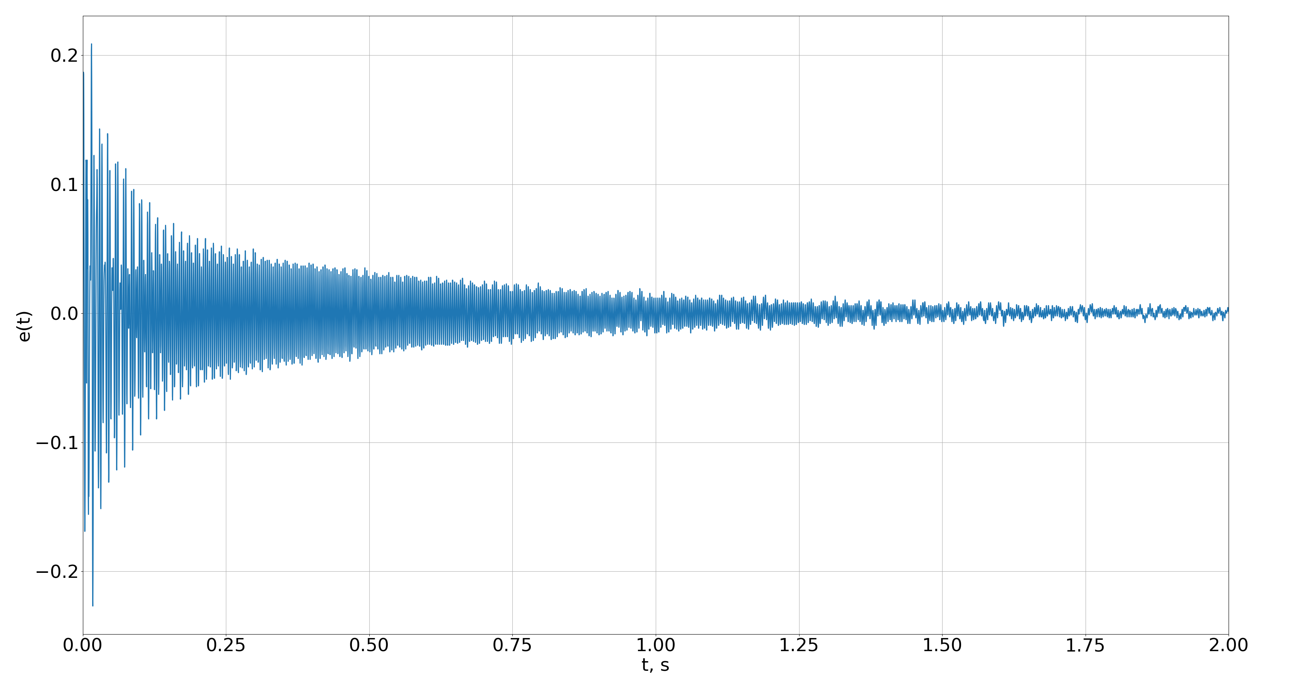
[picture p210: docs/polsl/thesis/graf/verification/l_sum_1024.png]
        
        \caption{$L = 1024$.}
    \end{subfigure}
        \caption{Przebiegi $e(t)$ dla sygnału trzeciego --- wpływ $L$.}
       \label{ver::l_sum}
\end{figure}

Jak można zauważyć z rysunków \ref{ver::l_120hz}, \ref{ver::l_220hz} i
\ref{ver::l_sum}, długość filtra wpływa nieznacznie na zebrane przebiegi. Czas
zbieżności jest w przybliżeniu taki sam w przypadku różnych wartości $L$ dla
poszczególnych sygnałów testowych. \par Kwestią znaczącą przy doborze wartości
$L$ jest natomiast długość okna czasowego w którym przetwarzane są dane.
Zwiększenie wartości $L$ powoduje zwiększenie ilości obliczeń w pętli
przetwarzania (więcej obliczeń na wykonanie filtracji i obliczenie algorytmu
NLMS) i w czasie pomiarów zaobserwowano, że dla długości filtra $W(z^{-1})$
większej niż 1024 ($L > 1024$) obliczenia zaczynają trwać zbyt długo, co
skutkuje przerwami w transmisji, spowodowanymi stanami \textit{xrun\_recovery}
systemu ALSA (próbki nie są odpowiednio szybko czytane/zapisywane). Takie
przerwy wpływają destrukcyjnie na działanie systemu i objawiają się
destabilizacją pętli przetwarzania, co skutkuje generacją dodatkowego hałasu
przez głośnik mający emitować antyhałas.

\subsubsection{Wpływ częstotliwości próbkowania}

Do badania wpływu częstotliwości próbkowania $f_s$ przyjęto zestaw parametrów
referencyjnych zgodnie z tabelą \ref{tab::ref}, a~jako nową wartość $f_s$
przyjęto:
\begin{equation}
    f'_s = 2f'_{s,\text{ref}} = 4000 \text{ Hz}.
\end{equation}

Rezultaty dla sygnałów testowych \ref{ver::120hz}, \ref{ver::220hz} i
\ref{ver::sig_sum} przedstawiono na rysunkach \ref{ver::16_khz}:

\begin{figure}[H]
    \centering
    \begin{subfigure}[b]{0.49\textwidth}
        \centering
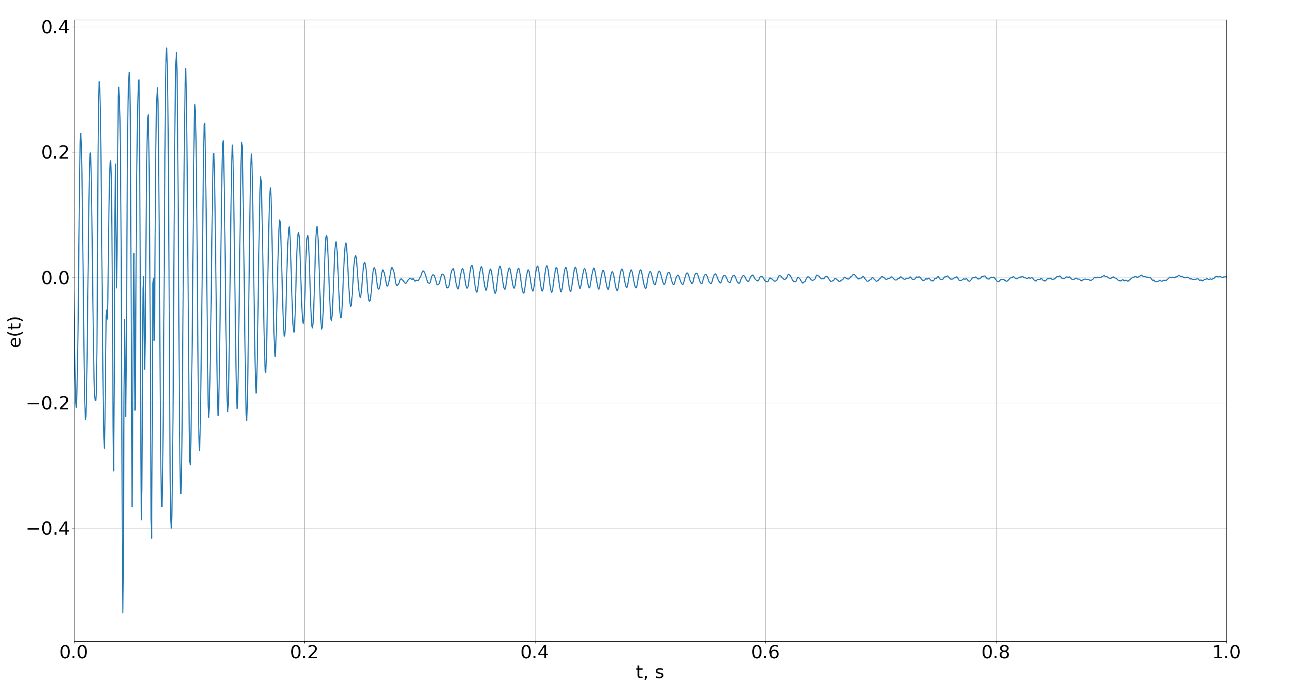
[picture p211: docs/polsl/thesis/graf/verification/120hz_128.png]
        
        \caption{Pierwszy sygnał testowy.}
    \end{subfigure}
    \begin{subfigure}[b]{0.49\textwidth}
        \centering
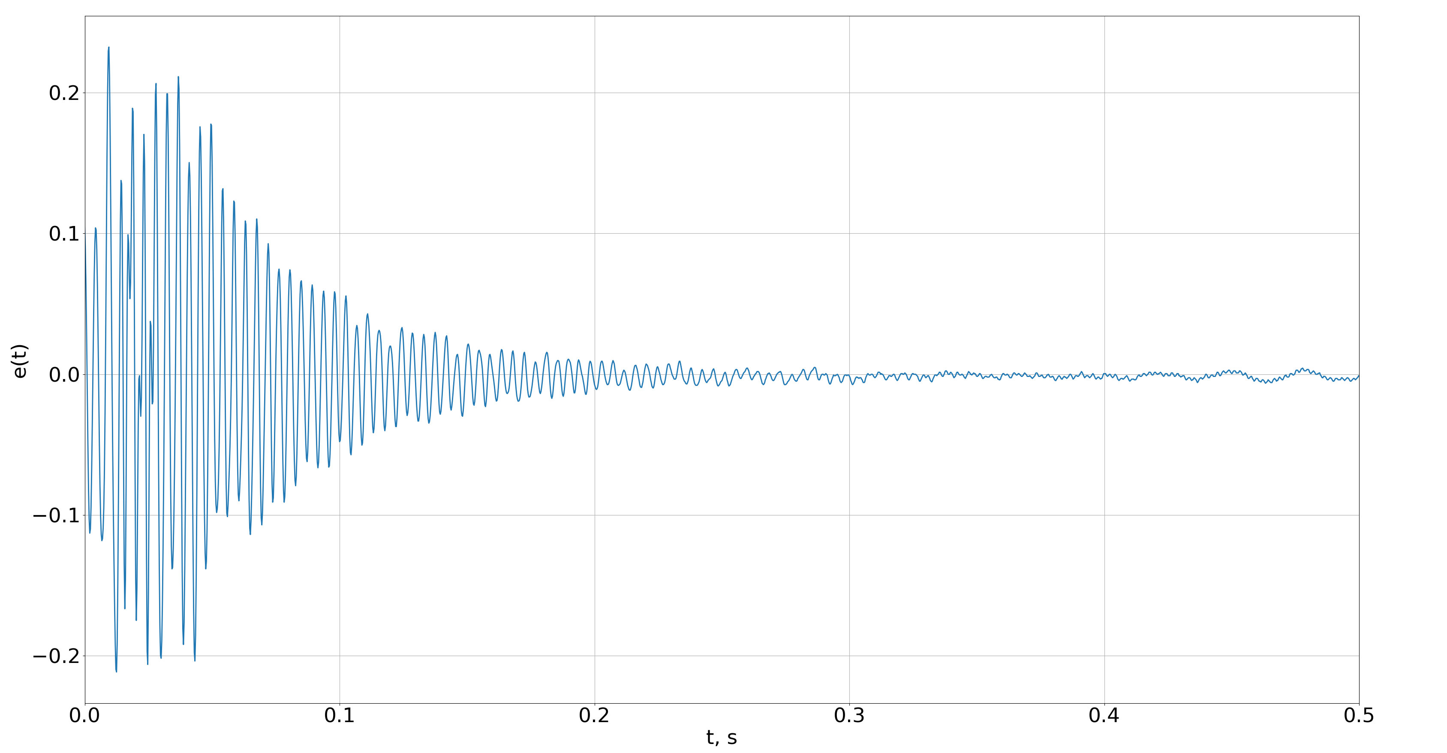
[picture p212: docs/polsl/thesis/graf/verification/220hz_16000.png]
        
        \caption{Drugi sygnał testowy.}
    \end{subfigure}
    \begin{subfigure}[b]{0.49\textwidth}
        \centering
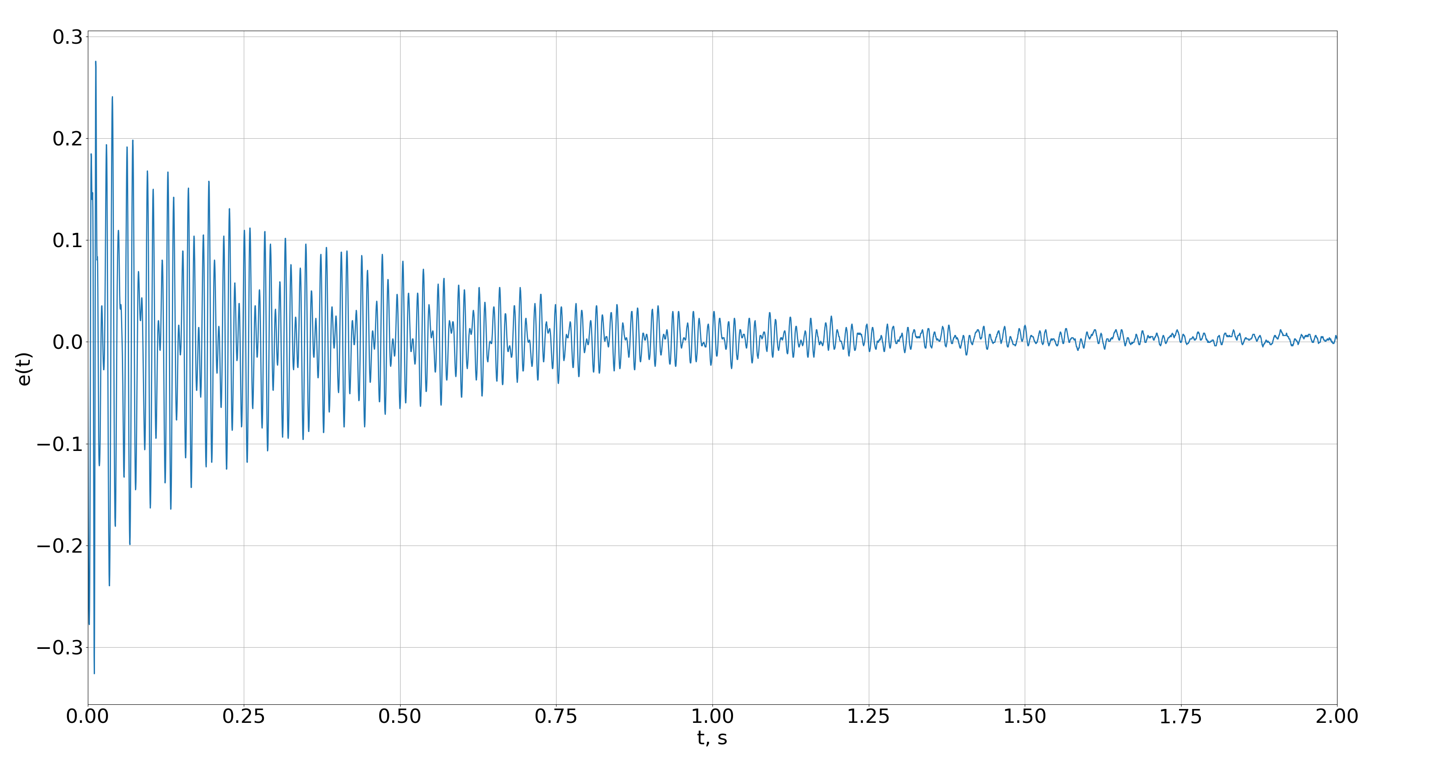
[picture p213: docs/polsl/thesis/graf/verification/sum_16000.png]
        
        \caption{Trzeci sygnał testowy.}
    \end{subfigure}
    \caption{Przebiegi $e(t)$ dla sygnałów testowych --- wpływ $f'_s$.}
    \label{ver::16_khz}
\end{figure}

Analizując przebiegi \ref{ver::16_khz} można stwierdzić, że zwiększona
częstotliwość próbkowania nie spowodowała drastycznych zmian w porównaniu
z~poprzednią (mniejszą). Czas zbieżności algorytmu dla poszczególnych sygnałów
testowych jest zbliżony z~rezultatami uzyskanymi na przebiegach referencyjnych
dla $f'_s = 2000$~Hz.\par Pomimo, że w~zaprojektowanym układzie częstotliwość
próbkowania nie wpływa znacząco na przebiegi, to~jej wzrost objawia się
mniejszym czasem na wykonanie obliczeń. W trakcie badań krotność decymacji
pozostawała niezmienna, więc w związku z dwukrotnym zwiększeniem częstotliwości
próbkowania, ilość obliczeń w pętli przetwarzania również zwiększyła się
dwukrotnie. Zaobserwowano, że~dla częstotliwości większej niż 4000~Hz ($f's >
4000$ Hz) system zaczyna nie nadążać z wykonywaniem obliczeń, co~skutkuje,
analogicznie jak w~przypadku zbyt długich filtrów, przerwaniem transmisji
i~destabilizacją pętli przetwarzania.

\subsubsection{Wpływ rozmiaru fragmentu}

Do badania wpływu rozmiaru fragmentu $n_f$ przyjęto zestaw parametrów
referencyjnych zgodnie z tabelą \ref{tab::ref}, a~jako nową wartość $n_f$
przyjęto:
\begin{equation}
    n_f = 2n_{f,\text{ref}} = 128 \text{ ramek}.
\end{equation}

Rezultaty dla sygnałów testowych \ref{ver::120hz}, \ref{ver::220hz} i
\ref{ver::sig_sum} przedstawiono na rysunkach \ref{ver::nf128}:

\begin{figure}[H]
    \centering
    \begin{subfigure}[b]{0.49\textwidth}
        \centering
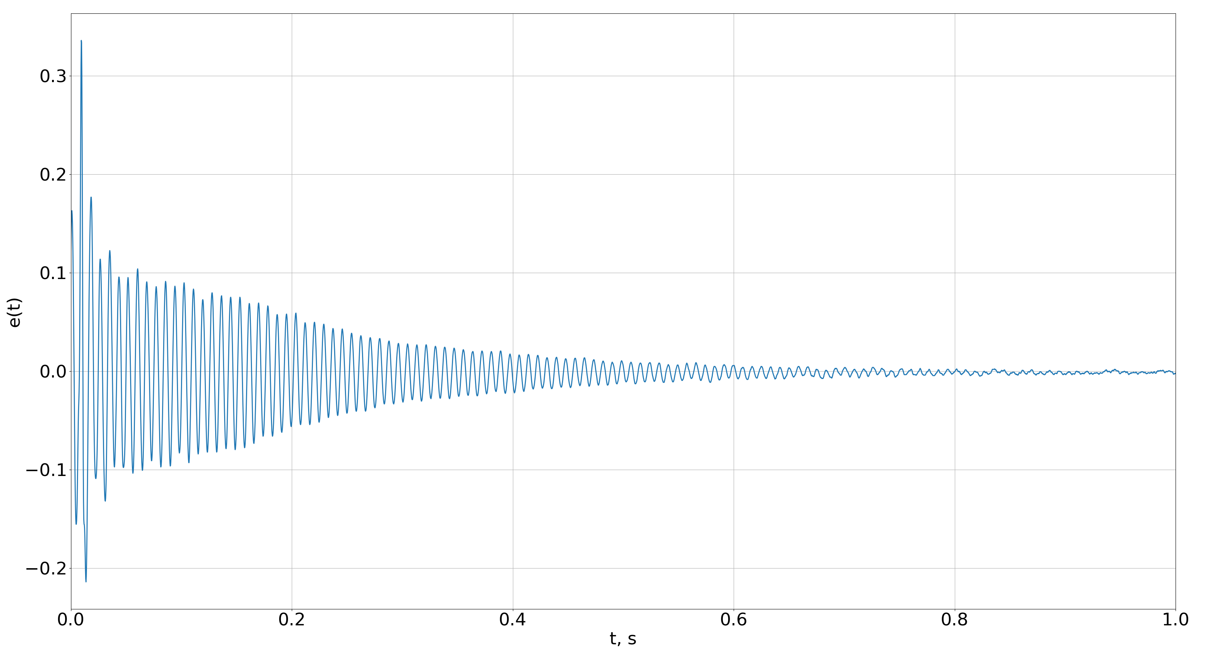
[picture p214: docs/polsl/thesis/graf/verification/120hz_16000.png]
        
        \caption{Pierwszy sygnał testowy.}
    \end{subfigure}
    \begin{subfigure}[b]{0.49\textwidth}
        \centering
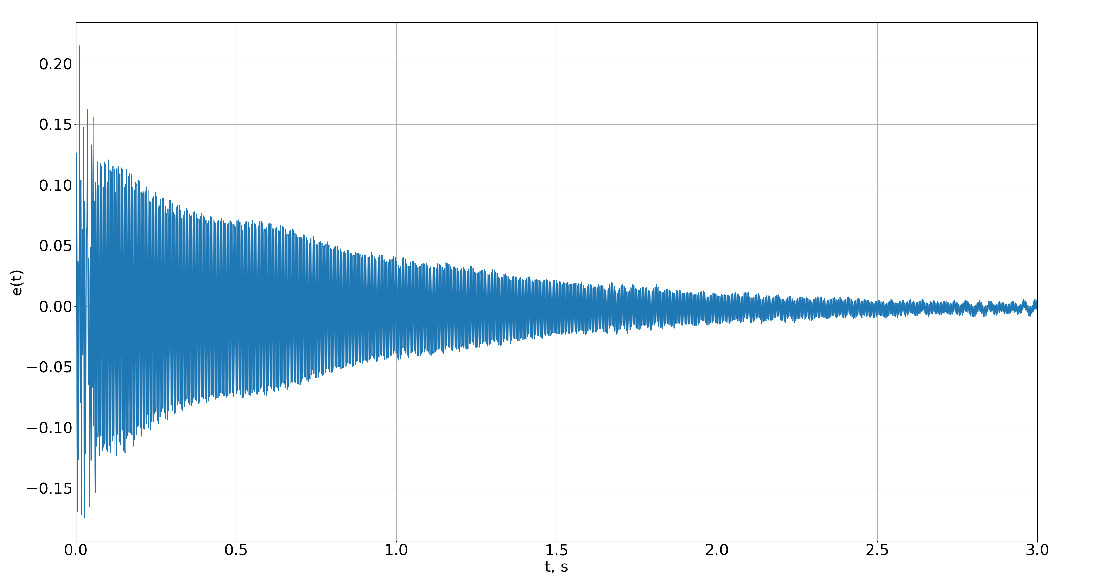
[picture p215: docs/polsl/thesis/graf/verification/220hz_128.png]
        
        \caption{Drugi sygnał testowy.}
    \end{subfigure}
    \begin{subfigure}[b]{0.49\textwidth}
        \centering
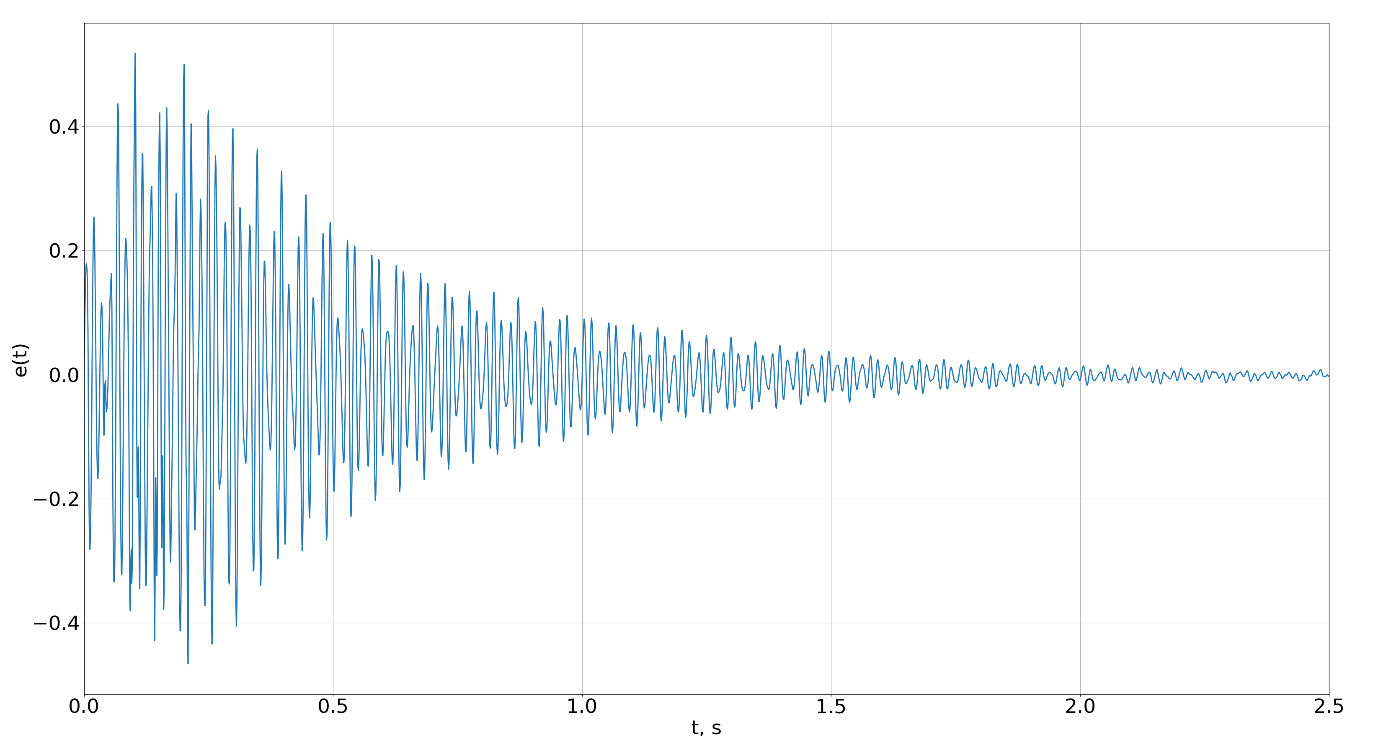
[picture p216: docs/polsl/thesis/graf/verification/sum_128.png]
        
        \caption{Trzeci sygnał testowy.}
    \end{subfigure}
        \caption{Przebiegi $e(t)$ dla sygnałów testowych --- wpływ $n_f$.}
        \label{ver::nf128}
\end{figure}

Wnioskując z~\ref{ver::nf128} można stwierdzić, że zwiększony rozmiar fragmentu
znacząco pogorszył jakość tłumienia. Algorytmy zbiegają się dłużej, co jest
najbardziej widoczne w~przypadku sygnału drugiego, dla którego algorytm zbiega
się w~przybliżeniu trzy razy wolniej, niż algorytm z~parametrami referencyjnymi.
Jak pokazano na rysunku \ref{ver::ident}, zwiększony rozmiar fragmentu powoduje
większe opóźnienie, co może być głównym powodem zaobserwowanego w tej serii
badań zachowania. \par Realizując badania dla innej wielkości fragmentu należy
pamiętać o wpływie rozmiaru omawianego parametru na charakterystykę toru
wtórnego. Identyfikacyję odpowiedzi impulsowej toru wtórnego trzeba
przeprowadzić ponownie dla nowej wartości parametru i taką samą procedurę należy
wykonać również dla nowej wartości próbkowania $f's$, co oczywiście wykonano,
realizując poprzednią serię badań.

\subsubsection{Wpływ poziomu priorytetu}

Do badania wpływu poziomu priorytetu $P$ procesu przyjęto zestaw parametrów
referencyjnych zgodnie z tabelą \ref{tab::ref}, a poziom $P$ dobierano zgodnie
z~zależnością:
\begin{equation}
    P(i) = 100\frac{i}{5}, \qquad \text{dla } i = 1, 2, 3, 4.
\end{equation}

Rezultaty dla pierwszego sygnału testowego \ref{ver::120hz} przedstawiono na
rysunkach \ref{ver::p_120hz}:

\begin{figure}[H]
    \centering
    \begin{subfigure}[b]{0.49\textwidth}
        \centering
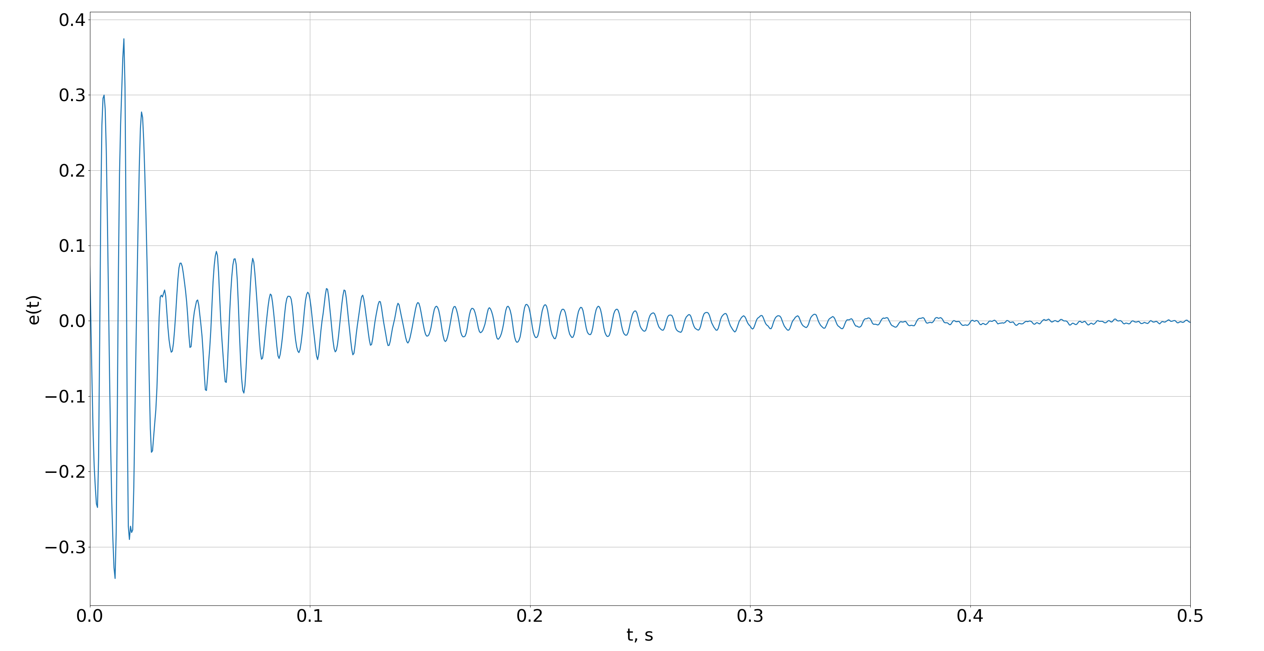
[picture p217: docs/polsl/thesis/graf/verification/P_120hz_80.png]
        
        \caption{$P = 80$.}
    \end{subfigure}
    \begin{subfigure}[b]{0.49\textwidth}
        \centering
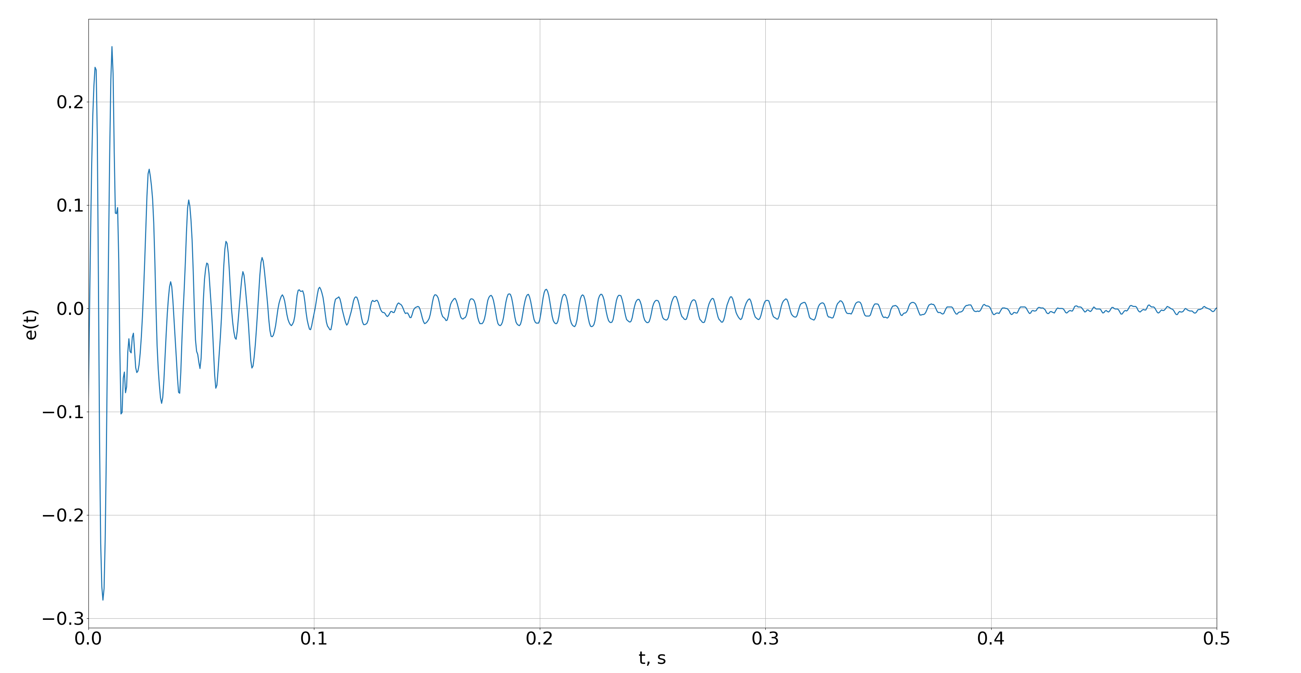
[picture p218: docs/polsl/thesis/graf/verification/P_120hz_60.png]
        
        \caption{$P = 60$.}
    \end{subfigure}
    \begin{subfigure}[b]{0.49\textwidth}
        \centering
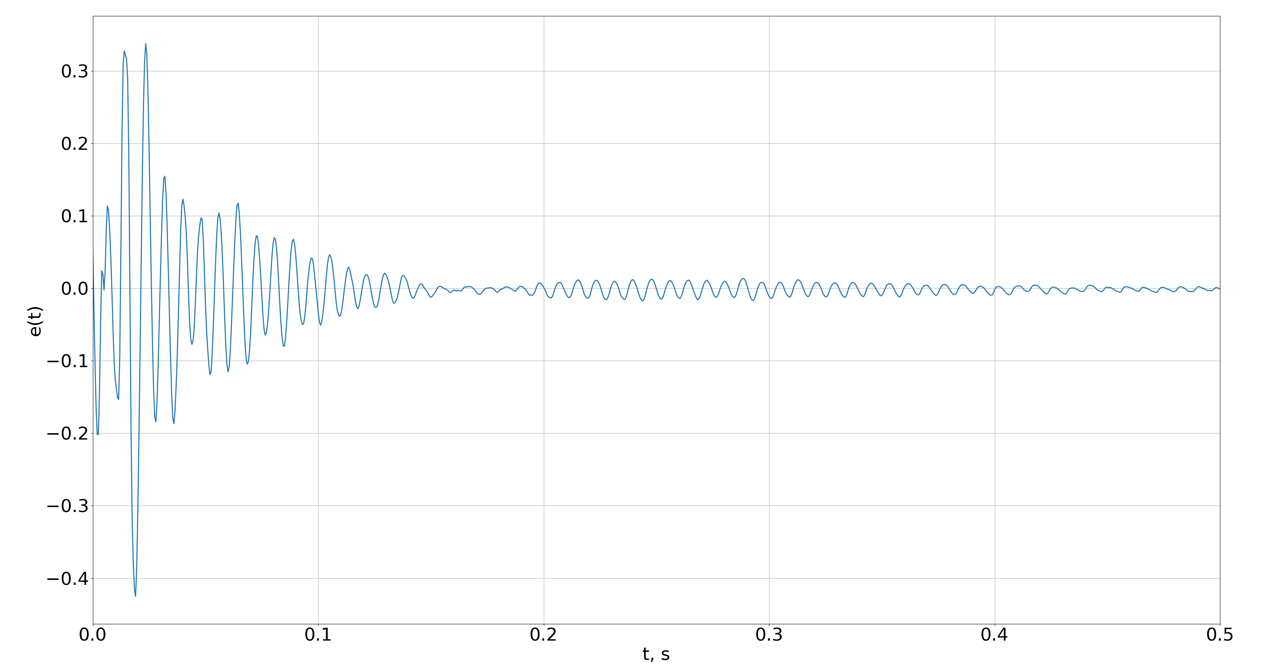
[picture p219: docs/polsl/thesis/graf/verification/P_120hz_40.png]
        
        \caption{$P = 40$.}
    \end{subfigure}
    \begin{subfigure}[b]{0.49\textwidth}
        \centering
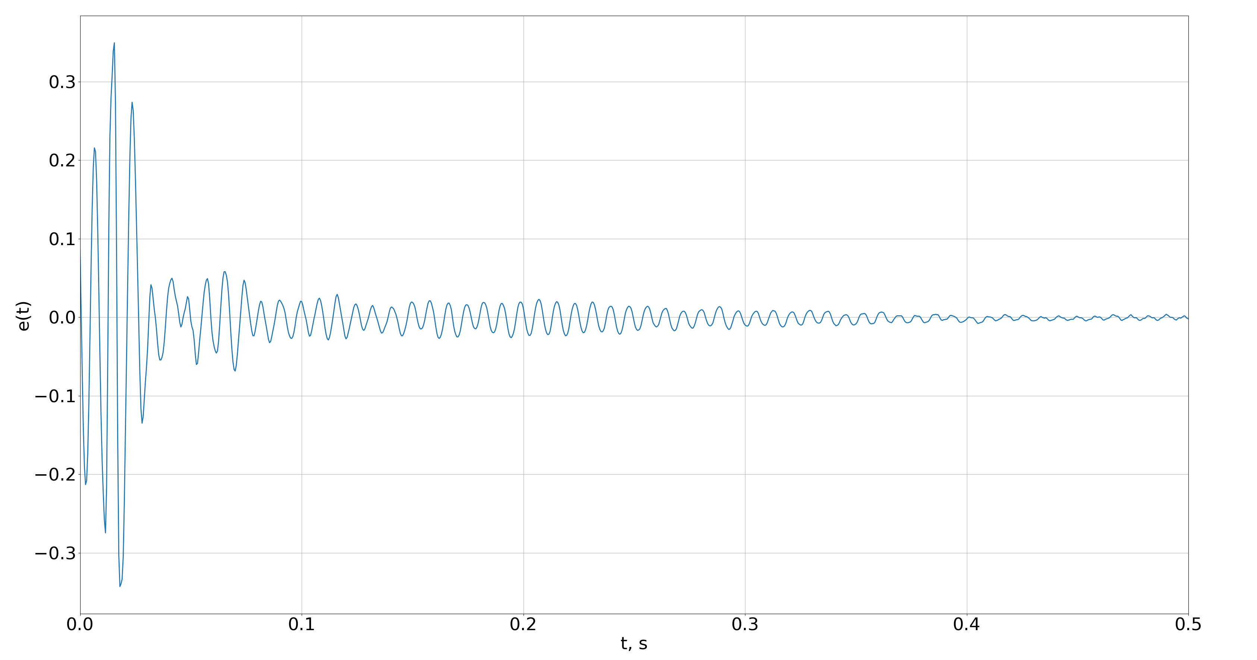
[picture p220: docs/polsl/thesis/graf/verification/P_120hz_20.png]
        
        \caption{$P = 20$.}
        \label{ver::120hz_boom}
    \end{subfigure}
    \caption{Przebiegi $e(t)$ dla sygnału pierwszego --- wpływ $P$.}
    \label{ver::p_120hz}
\end{figure}

Rezultaty dla drugiego sygnału testowego \ref{ver::220hz} przedstawiono na
rysunkach \ref{ver::p_120hz}:

\begin{figure}[H]
    \centering
    \begin{subfigure}[b]{0.49\textwidth}
        \centering
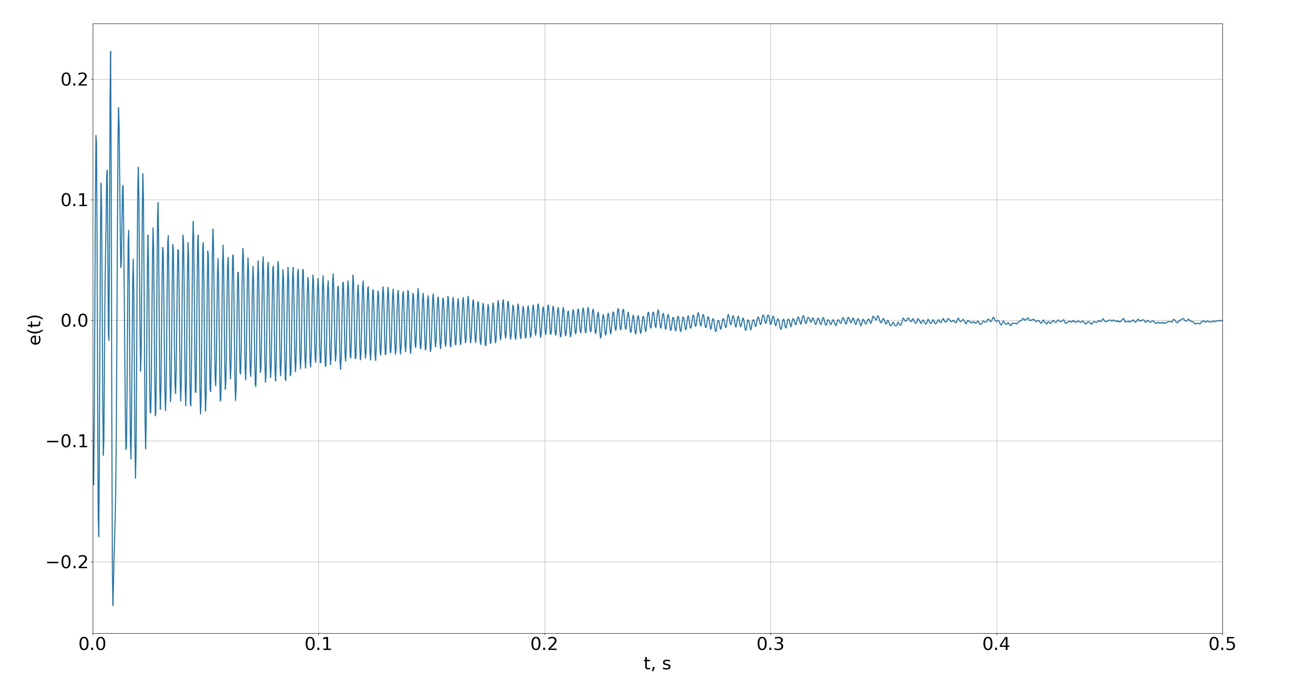
[picture p221: docs/polsl/thesis/graf/verification/P_220hz_80.png]
        
        \caption{$P = 80$.}
    \end{subfigure}
    \begin{subfigure}[b]{0.49\textwidth}
        \centering
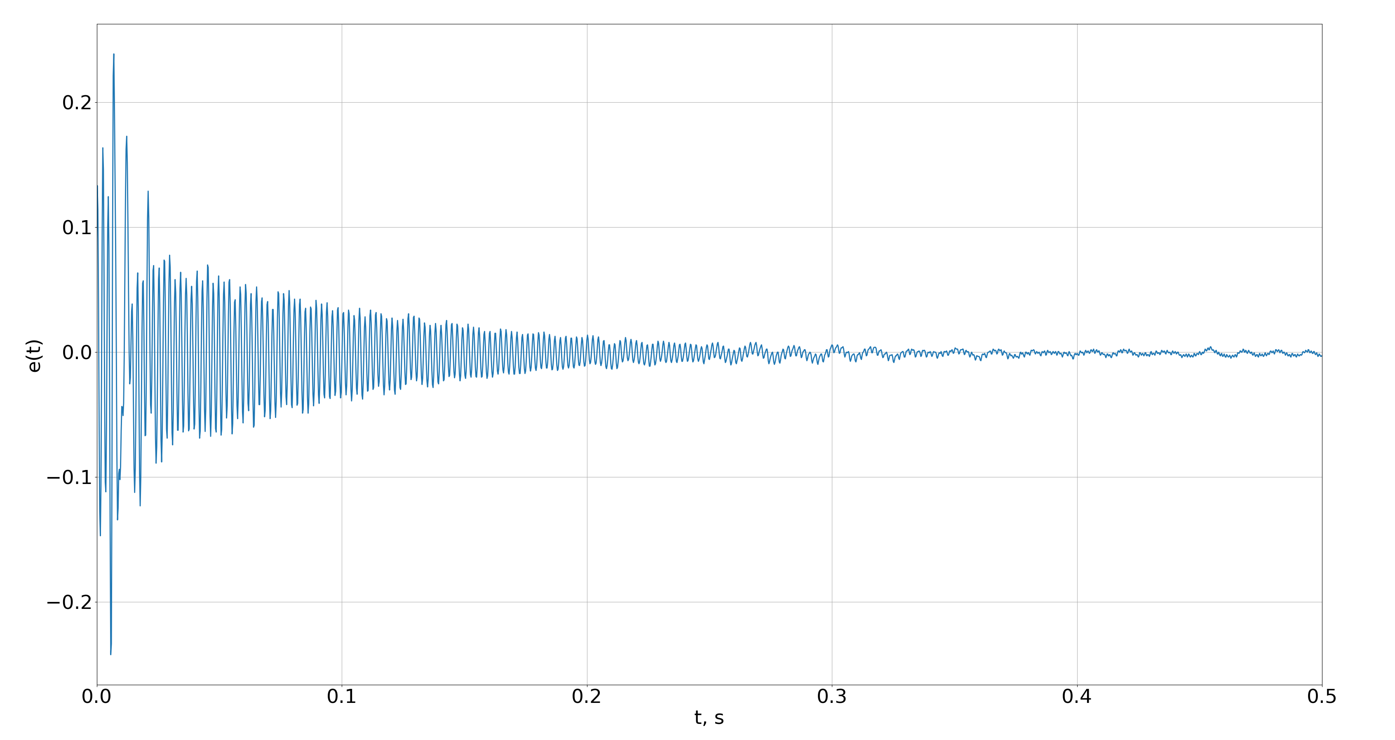
[picture p222: docs/polsl/thesis/graf/verification/P_220hz_60.png]
        
        \caption{$P = 60$.}
    \end{subfigure}
    \begin{subfigure}[b]{0.49\textwidth}
        \centering
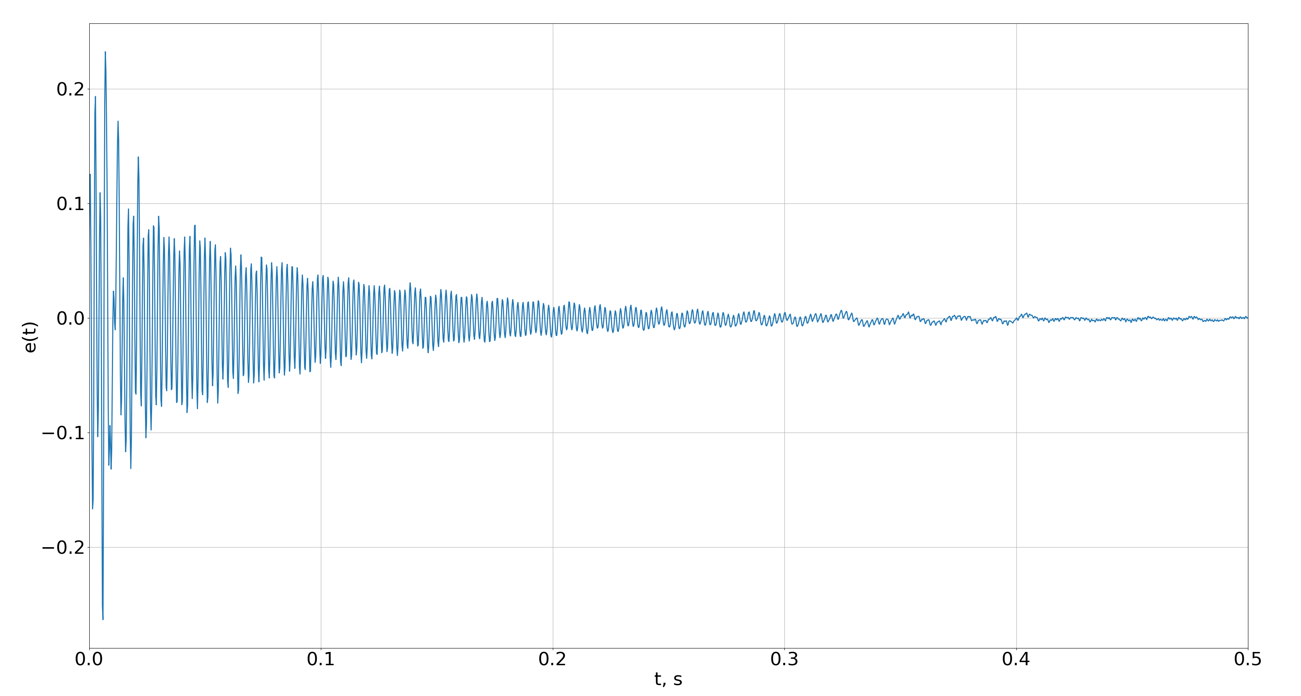
[picture p223: docs/polsl/thesis/graf/verification/P_220hz_40.png]
        
        \caption{$P = 40$.}
    \end{subfigure}
    \begin{subfigure}[b]{0.49\textwidth}
        \centering
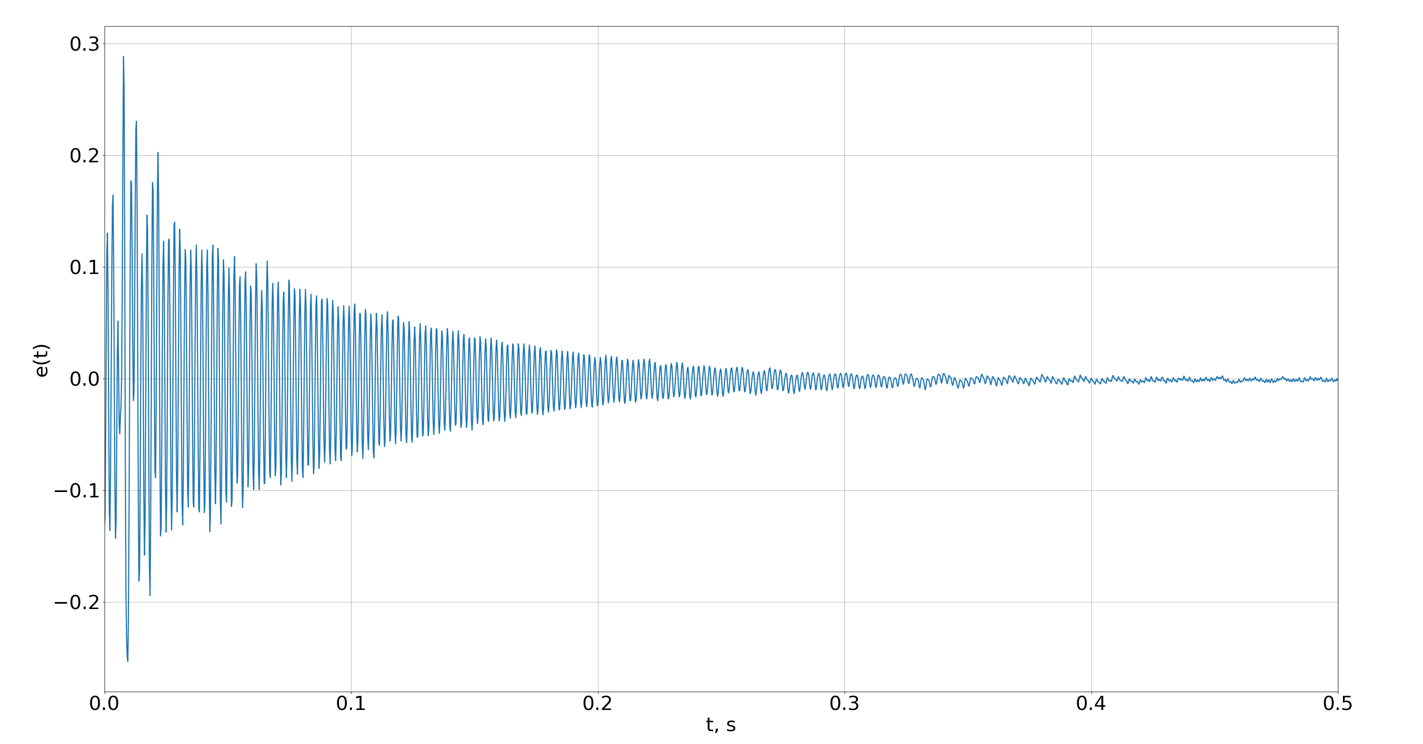
[picture p224: docs/polsl/thesis/graf/verification/P_220hz_20.png]
        
        \caption{$P = 20$.}
    \end{subfigure}
    \caption{Przebiegi $e(t)$ dla sygnału drugiego --- wpływ $P$.}
    \label{ver::p_220hz}
\end{figure}

Rezultaty dla trzeciego sygnału testowego \ref{ver::sig_sum} przedstawiono na
rysunkach \ref{ver::p_sum}:

\begin{figure}[H]
    \centering
    \begin{subfigure}[b]{0.49\textwidth}
        \centering
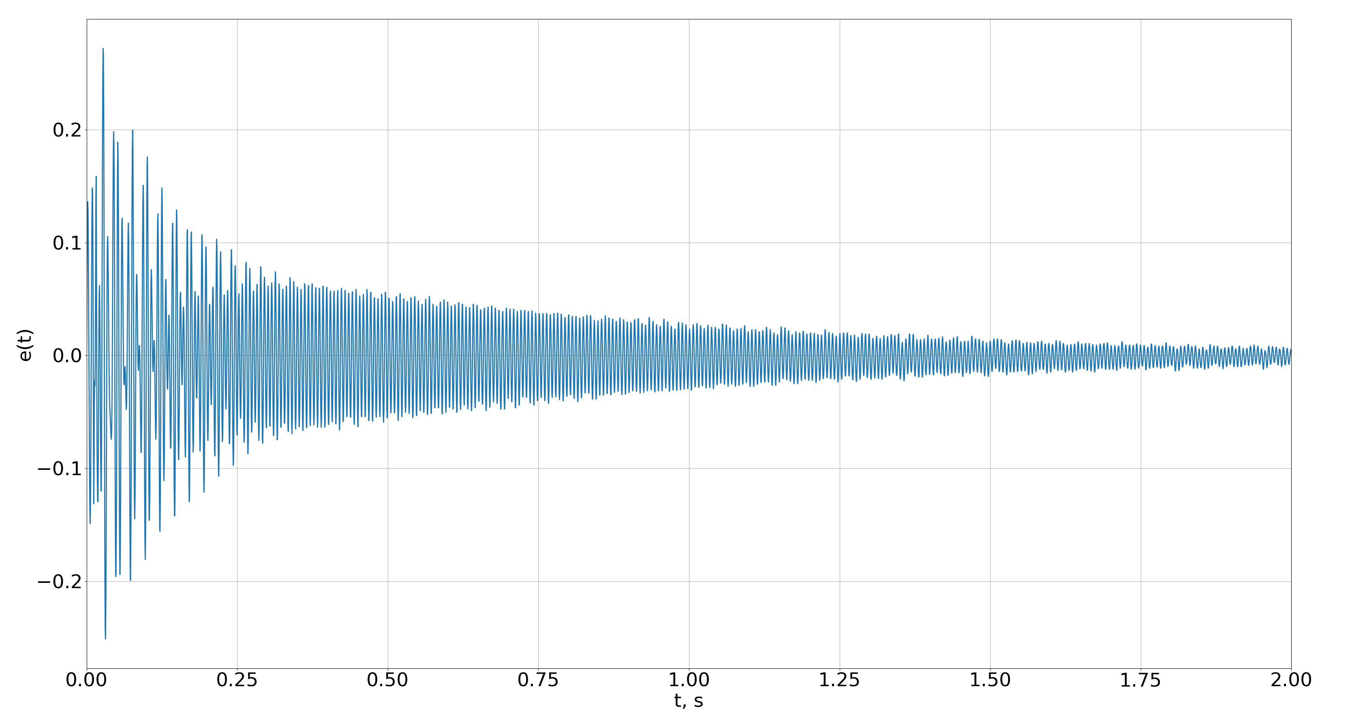
[picture p225: docs/polsl/thesis/graf/verification/P_sum_80.png]
        
        \caption{$P = 80$.}
    \end{subfigure}
    \begin{subfigure}[b]{0.49\textwidth}
        \centering
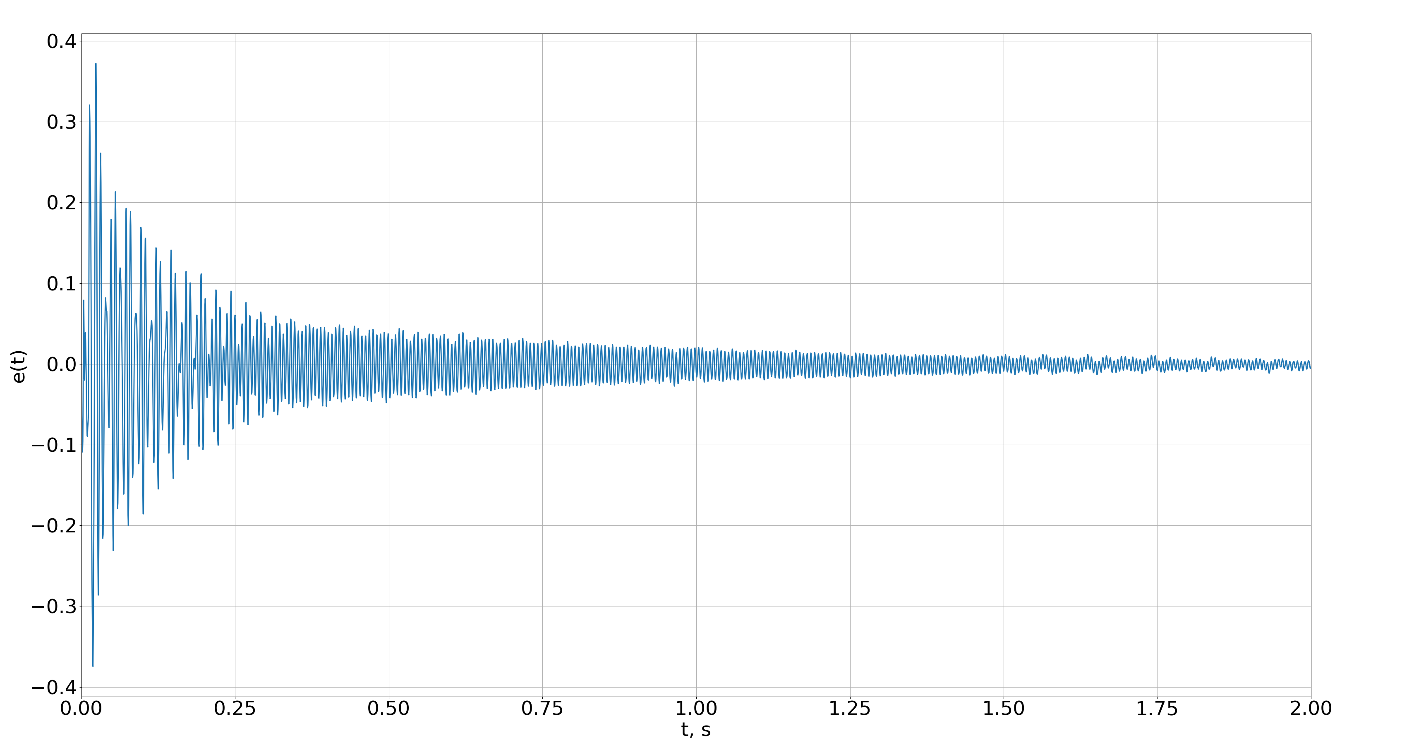
[picture p226: docs/polsl/thesis/graf/verification/P_sum_60.png]
        
        \caption{$P = 60$.}
    \end{subfigure}
    \begin{subfigure}[b]{0.49\textwidth}
        \centering
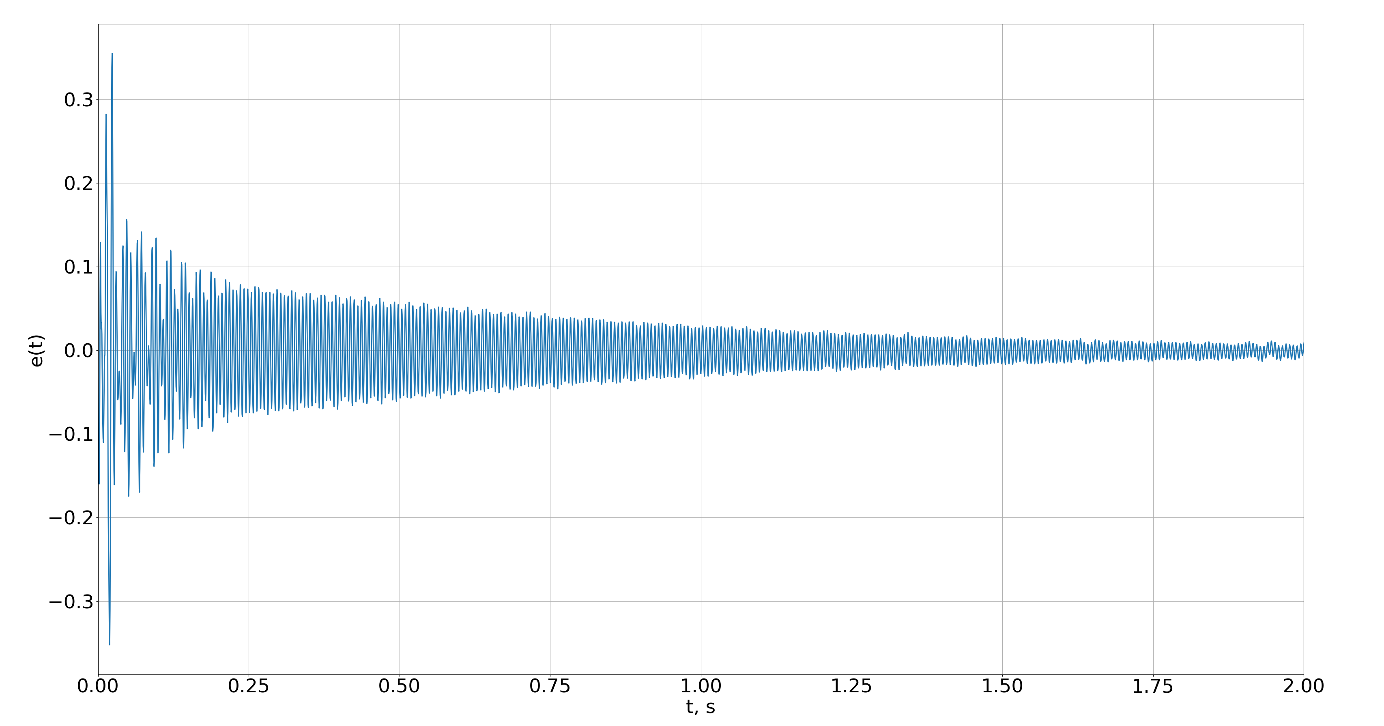
[picture p227: docs/polsl/thesis/graf/verification/P_sum_40.png]
        
        \caption{$P = 40$.}
    \end{subfigure}
    \begin{subfigure}[b]{0.49\textwidth}
        \centering
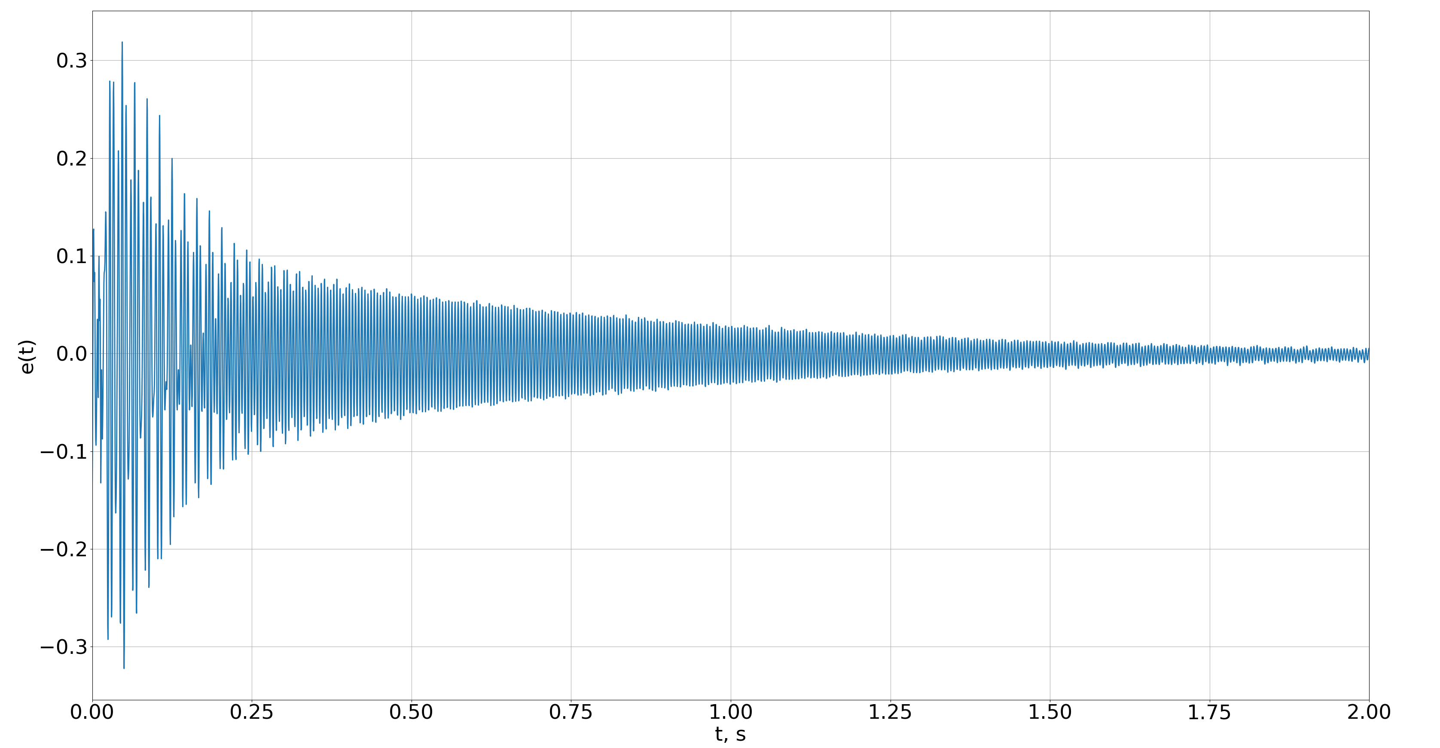
[picture p228: docs/polsl/thesis/graf/verification/P_sum_20.png]
        
        \caption{$P = 20$.}
    \end{subfigure}
       \caption{Przebiegi $e(t)$ dla sygnału trzeciego --- wpływ $P$.}
       \label{ver::p_sum}
\end{figure}

\par Na rysunkach \ref{ver::fifo} przedstawiono przebiegi dla sygnałów testowych
\ref{ver::120hz}, \ref{ver::220hz} i \ref{ver::sig_sum} uzyskane dla zmiany
wytycznej planisty z~SCHED\_RR na SCHED\_FIFO:

\begin{figure}[H]
    \centering
    \begin{subfigure}[b]{0.49\textwidth}
        \centering
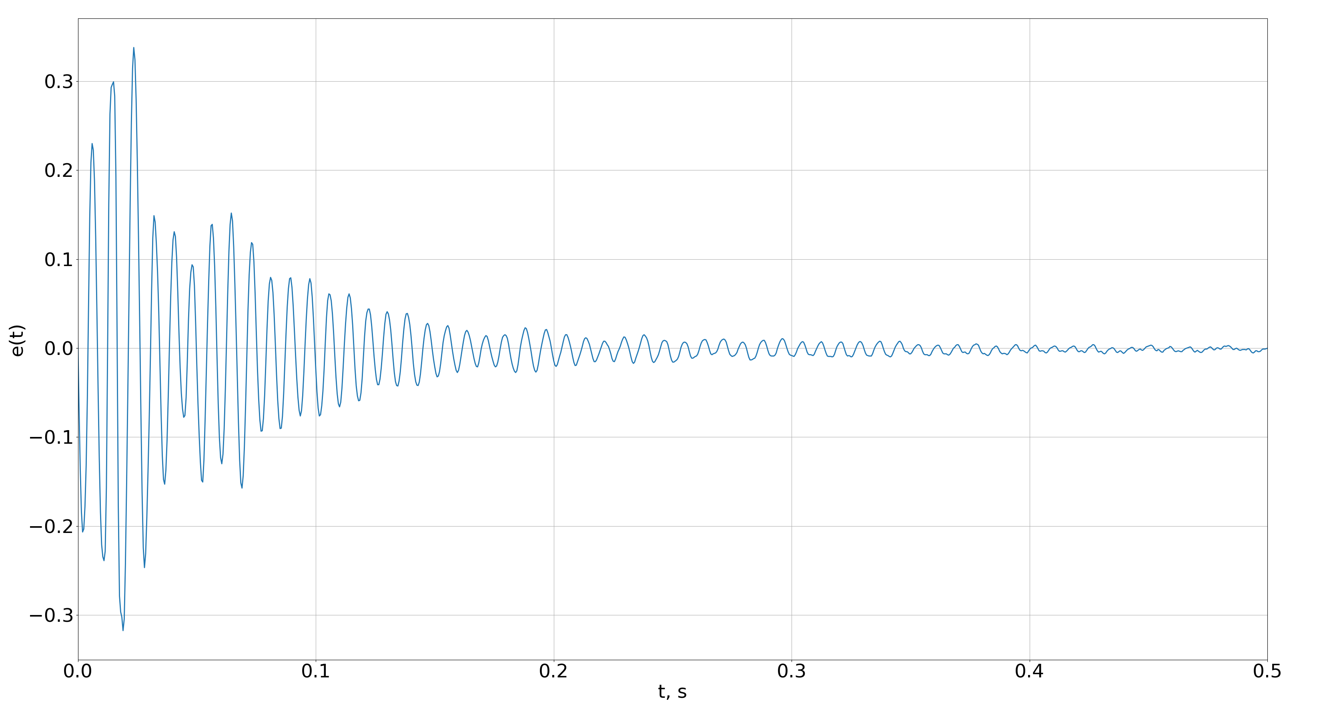
[picture p229: docs/polsl/thesis/graf/verification/P_120hz_fifo.png]
        
        \caption{Pierwszy sygnał testowy.}
    \end{subfigure}
    \begin{subfigure}[b]{0.49\textwidth}
        \centering
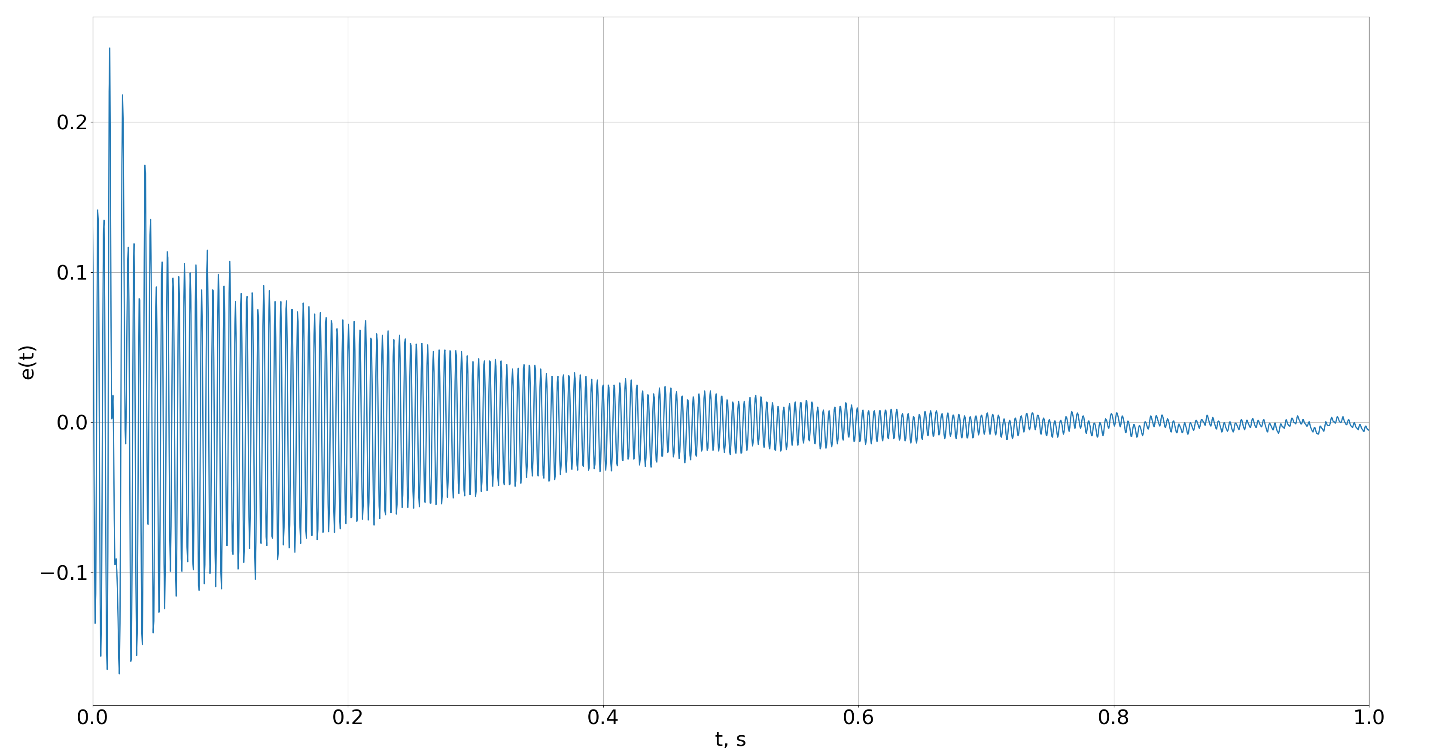
[picture p230: docs/polsl/thesis/graf/verification/P_220hz_fifo.png]
        
        \caption{Drugi sygnał testowy.}
    \end{subfigure}
    \begin{subfigure}[b]{0.49\textwidth}
        \centering
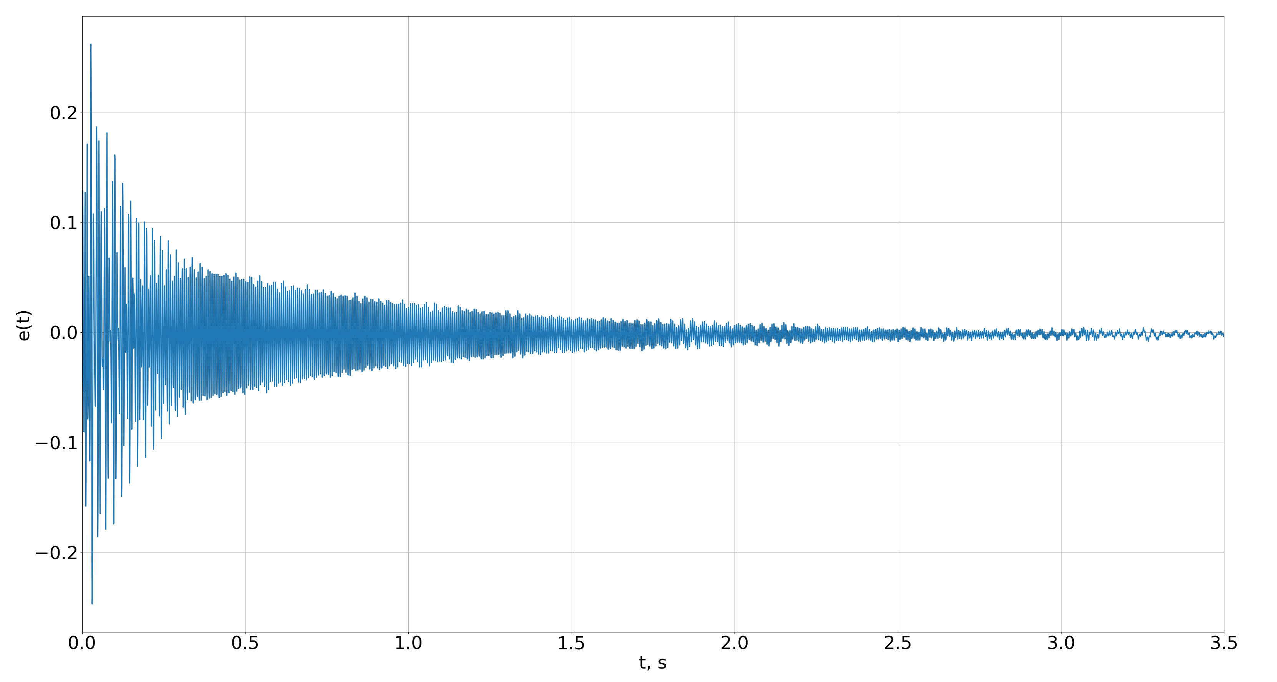
[picture p231: docs/polsl/thesis/graf/verification/P_sum_fifo.png]
        
        \caption{Trzeci sygnał testowy.}
    \end{subfigure}
       \caption{Przebiegi $e(t)$ --- zmiana wytycznej planisty.}
       \label{ver::fifo}
\end{figure}

Jak pokazano na \ref{ver::p_120hz}, \ref{ver::p_220hz} i~\ref{ver::p_sum},
zmniejszanie poziomu priorytetu w~analizowanym zakresie kompletnie nie wpływa
jakość wynikowego tłumienia. Czasy zbieżności w~każdym przypadku są prawie
identyczny, w~porównaniu z~przebiegami uzyskanymi dla maksymalnego priorytetu.
Powodem, dla którego tak się dzieje, jest z~pewnością rozkład procesów
pracujących w systemie. Analizując rozkład procesów podczas działania pętli ANC
z~wykorzystaniem polecenia \textit{top} zaobserwowano, że prócz procesu o~nazwie
\textit{migration/0}, odpowiadającego za dystrybucję czasu pracy pomiędzy
rdzenie procesora oraz tych, odpowiadających za obsługę przerwań (procesy
\textit{irq/*}), żadne inne nie posiadają priorytetu większego niż $P = 20$, z
czego wynika, że proces ANC nie może zostać wywłaszczony przez inny pracujący
równolegle. \par Analizując rysunki \ref{ver::p_120hz}, \ref{ver::p_220hz}
i~\ref{ver::p_sum} dokładniej można jednak zadać pytanie, dlaczego przebiegi nie
są całkowicie identyczne, skoro w analizowanej sytuacji nic w systemie nie
powinno wpływać na jakość działania algorytmu. Jednym z możliwych powodów jest
zmienność stanu środowiska, w którym przeprowadzano pomiary. Jako, że
pomieszczenie, w którym ustawiony jest system, nie jest całkowicie odizolowane
od świata zewnętrznego, wpływ na pomiar mogą mieć zmiany wilgotności powietrza,
ciśnienia, temperatury jak i aktualne rozmieszczenie elementów. W działającym
systemie poszczególne układy elektroniczne rozpraszają część energii poprzez
ciepło, co w szczególności zaobserwowano w przypadku głośników, których
wbudowany wzmacniacz mocy w trakcie badań mocno się nagrzewał, powodując
rozgrzanie obudowy głośnika. Dodatkową, wartą przedstawienia sytuacją, była chęć
przeprowadzenia pomiaru kiedy zapomniano zamknąć drzwi do pomieszczenia, w
którym odbywały się badania. Wpływ otwarych drzwi został natychmiastowo
zauważony na uzyskanych w tamtym czasie rezultatach, które znacząco odbiegały od
pozostałych i pozostawiały sporo do życzenia w kwestii pokrywania się z
założeniami teoretycznymi. Sumarycznie, omawianych kwestie zdaniem autora
powodują, że przeprowadzone po sobie pomiary, nawet jeżeli konfiguracja jest
taka sama, nie są całkowicie identyczne, a przebiegi mogą nieznacznie się od
siebie różnić. \par Zmiany wytycznej planisty lekko pogorszyła zbieżność
algorytmu, co przedstawiono na rysunkach \ref{ver::fifo}. Tłumienie drugiego
i~trzeciego sygnału testowego odbywa się nieznacznie dłużej niż w~przypadku
wykorzystania SCHED\_RR. Poza dłuższym czasem zbieżności, nie zaobserwowano
dodatkowych zmian.

\subsection{Dodatkowe eksperymenty i~podsumowanie badań}

\subsubsection{Eksperyment --- pseudolosowe pobudzenia sinusoidalne}

Eksperyment opiera się na wykorzystaniu sygnału testowego, który składa się
z~pobudzeń sinusoidalnych z zakresu od 100 Hz do 400 Hz generowanych w~pewnych
odstępach czasu. Pomiędzy pobudzeniami stosowano arbitralne okresy ciszy,
manualnie włączając i~wyłączając głośnik, stanowiący symulowane źródło hałasu
w~systemie. Przebieg błędu $e(n)$ dla tak opisanego sygnału wejściowego
przedstawiono na rysunku \ref{ver::rand_sin}:

\begin{figure}[H]
    \centering
    
    \caption{Przebieg $e(t)$ dla pobudzeń sinusoidalnych.}
    \label{ver::rand_sin}
\end{figure}

Jak można zauważyć z \ref{ver::rand_sin}, każdy nowo pojawiający się hałas
tonalny zostaje stłumiony idealnie, a czas zbieżności nie przekracza jednej
sekundy. Okresy ciszy (hałas nie jest emitowany) nie powodują niechcianych
pobudzeń systemu. \par Analizując układ dla hałasów totalnych o innych
częstotliwościach niż te, które wykorzystano jako sygnały testowe do badania
wpływu algorytmów, zauważono, że system jest w stanie w dobrym stopniu tłumić
sinusoidy do założonego pasma. Poza nim, system nie działa prawidłowo i~zaczyna
generować sygnały powodujące większy hałas niż wejściowy.

\subsubsection{Eksperyment --- hałas pseudolosowy}

W przeprowadzonym eksperymencie, korzystając z zestawu parametrów referencyjnych
określonych w tabeli \ref{tab::ref}, jako hałas wykorzystano sygnał losowy
wygenerowany generatorem \textit{xoroshiro16++}, którego nagranie mikrofonem
błędu sygnału przedstawiono na rysunku \ref{ver::sig_rand}:

\begin{figure}[H]
    \centering
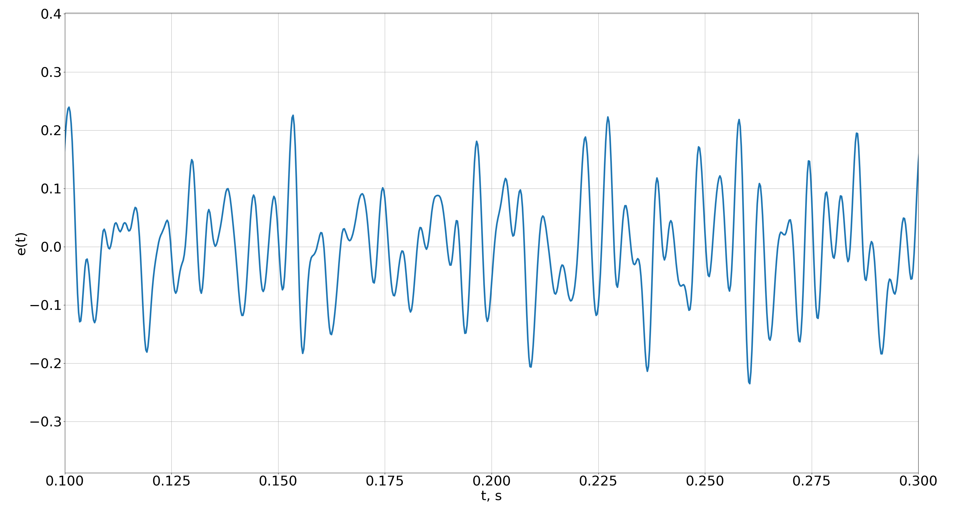
[picture p232: docs/polsl/thesis/graf/verification/raw_rand.png]
    
    \caption{Przebieg $e(t)$ dla sygnału pseudolosowego.}
    \label{ver::sig_rand}
\end{figure}

Porównanie gęstości widmowej mocy sygnału $e(n)$ w przypadku włączonego i
wyłączonego ANC dla wejściowego hałasu losowego obliczoną metodą Welcha z oknem
Hanna dla $f'_s = 2$ kHz przedstawiono na rysunku \ref{ver::anc_rand_psd}:

\begin{figure}[H]
    \centering
    
    \caption{Porównanie --- GWM $e(t)$ dla sygnału pseudolosowego.}
    \label{ver::anc_rand_psd}
\end{figure}

Jak można zauważyć z \ref{ver::anc_rand_psd}, system nie działa poprawnie dla
hałasów losowych. Takie zachowanie układu można wywnioskować na podstawie
przeprowadzonych wcześniej badań, z których wynika, że algorytm zbiega się
zdecydowanie zbyt wolno, żeby poprawnie reagować na szybkozmienny, pseudolosowy
sygnał wejściowy. W przypadku włączonego systemu, pasmo do 500 Hz jest w wielu
miejscach o większej mocy, niż w przypadku wyłączonego, co świadczy o tym, że
włączone ANC tylko pogarsza sprawę i powoduje większy hałas, co jest również
odczuwalne przez słuchacza znajdującego się niedaleko mikrofonu błędu.

\subsubsection{Eksperyment --- hałasy rzeczywiste}

W przeprowadzonym eksperymencie sprawdzono, jak układ zachowuje się dla
rzeczywistych hałasów pochodzących z elektrowni. Nagrania w formacie
\textit{.wav} odtwarzano z głośnika symulującego źródło hałasu, natężenie
dźwieku starano utrzymać się na poziomie 80 dB SPL i do eksperymentu
wykorzystano zestaw parametrów referencyjnych określonych w tabeli
\ref{tab::ref}, analogicznie jak w przypadku reszty badań. Analizy
przeprowadzano z wykorzystaniem przebiegów gęstości widmowych mocy oblicznych
metodą Welcha z oknem Hanna dla $f'_s = 2$ kHz dla włączonego i~wyłączonego
systemu. \par Porównanie przebiegów gęstości widmowych mocy w przypadku
włączonego i wyłączonego systemu dla pierwszego hałasu, będącego nagraniem
pracujących młynów kulowych, przedstawiono na rysunku \ref{ver::mlyny}:

\begin{figure}[H]
    \centering
    
    \caption{Porównanie --- GWM sygnału $e(t)$ dla hałasu młynów kulowych.}
    \label{ver::mlyny}
\end{figure}

Działanie układu dla drugiego sygnału, będącego nagraniem pracujących pomp wody
w analogiczny sposób przedstawiono na rysunku \ref{ver::pompy}:

\begin{figure}[H]
    \centering
    
    \caption{Porównanie --- GWM sygnału $e(t)$ dla hałasu pomp wody.}
    \label{ver::pompy}
\end{figure}

Jak można zauważyć z rysunku \ref{ver::mlyny}, układ był w stanie wytłumić mocno
odznaczającą się składową występujacą w okolicach częstotliwości 400 Hz o około
14 dB. Poza osłabieniem odznaczającej się składowej, moc reszty przy włączonym
tłumieniu jest na podobnym poziomie co przy wyłączonym systemie. \par Dla
drugiego eksperymentu, wprost z rysunku \ref{ver::pompy} można zauważyć, że dla
tego typu sygnału układ nie działa w sposób przewidywalny. Włączony system
podwyższa moc wielu składowych pasma do 500 Hz, gdzie najbardziej odznaczającymi
są te z przedziału od około 250 Hz do 300 Hz. Zachowanie, uchwycone na przebiegu
\ref{ver::pompy} wizualnie i słyszalnie przypomina te, które uzyskano dla hałasu
pseudolosowego na rysunku \ref{ver::anc_rand_psd}.

\subsubsection{Eksperyment --- działanie algorytmu na jądrze bez łatki PREEMPT\_RT}

Aby dodatkowo zweryfikować wpływ rozszerzeń czasu rzeczywistego, jądro systemu
operacyjnego na wykorzystywanej platformie obliczeniowej podmieniono na takie
bez wprowadzonej łatki PREEMPT\_RT. Uruchamiając program, priorytet procesu
pozostawiono jako domyślny oraz nie zmienianio wytycznej planisty. \par
Realizując badania dla wykorzystanych wcześniej sygnałów testowych od razu
zauważono, że system zachowuje się mniej deterministycznie niż wcześniej, co
uchwycono na rysunkach \ref{ver::no_rt}:

\begin{figure}[H]
    \centering
    \begin{subfigure}[b]{0.49\textwidth}
        \centering
        
        \caption{Pierwszy sygnał testowy.}
    \end{subfigure}
    \begin{subfigure}[b]{0.49\textwidth}
        \centering
        
        \caption{Drugi sygnał testowy.}
    \end{subfigure}
    \begin{subfigure}[b]{0.49\textwidth}
        \centering
        
        \caption{Trzeci sygnał testowy.}
    \end{subfigure}
       \caption{Eksperyment - jądro bez łatek PREEMPT\_RT.}
       \label{ver::no_rt}
\end{figure}

Jednym z najbardziej znaczących powodów, dla którego system mógł zacząć
zachowywać się znacząco gorzej, jest domyślny priorytet, który jest nadawany
procesowi, wynoszący $P = 0$. Proces z~takim priorytetem jest łatwo
wywłaszczalny przez inne (z większym), co z pewnością powoduje problemy
z~synchronizacją w trakcie działania algorytmu. Przeprowadzając dodatkowe
pomiary stwierdzono, że~w~przypadku realizacji dziesięciu eksperymentów, cztery
z nich skutkowały niedeterministycznym działaniem systemu.

\subsubsection{Podsumowanie badań}

Wpływy poszczególnych parametrów na działanie systemu
przedstawiono poniżej:

\begin{enumerate}
    \item \textbf{Wielkość kroku adaptacji algorytmu NLMS} $\alpha$ --- decyduje
    o~szybkości zbiegania się algorytmu. Algorytm najszybciej zbiega się dla:
    \begin{equation}
        \alpha_{ref} = 0.1,
    \end{equation}
    staje się niestabilny dla większych wartości i zbiega się wolniej im wartość
    jest mniejsza.

    \item \textbf{Długość filtra} $W(z^{-1})$ --- nie wpływa znacząco na jakość
    tłumienia, ale ma duży wpływ na szybkość wykonywania obliczeń. Dla długości
    większych niż 1024 ($L > 1024$) obliczenia zaczynają trwać zbyt długo, co
    skutkuje przerwami w~transmisji i~destabilizacją pętli przetwarzania.

    \item \textbf{Częstotliwość próbkowania} $f'_s$ --- podobnie jak długość filtra
    $W(z^{-1})$, nie wpływa znacząco na jakość tłumienia, ale im jest większa,
    tym okno czasowe na wykonanie obliczeń mniejsze. Zweryfikowano,
    że~zaprojektowany układ zaczyna nie nadążać z~obliczeniami dla
    częstotliwości większej niż 4000 Hz ($f'_s > 4000$ Hz), z uwzględnieniem
    czterokrotnej decymacji ($M = 4$).

    \item \textbf{Długość fragmentu} $n_f$ --- im większa, tym system działa gorzej.
    Zwiększenie długości powoduje zwiększenie opóźnienia w~torze przetwarzania,
    co ma mocno negatywny wpływ na jakość tłumienia.

    \item \textbf{Poziom priorytetu} $P$ --- do momentu, jeżeli nie przekracza się
    poziomu, w~którym pracują inne procesy w systemie, nie powoduje zmian. Poza
    tym poziomem, który dla przeprowadzonych pomiarów zdefiniowany był na $P =
    20$, istnieje szansa, że algorytm się rozsynchronizuje.

    \item \textbf{Wytyczna planisty} --- w~wykonanych badaniach nie
    zaobserwowano decydującego wpływu, jednak jak można zaobserwować, SCHED\_RR
    działa nieznacznie lepiej.
\end{enumerate}

W dodatkowych eksperymentach zweryfikowano, że:
\begin{enumerate}
    \item \textbf{System jest w stanie tłumić hałasy tonalne w postaci
    pojedynczych sinusoid i~ich sum dla założonego pasma (do 500 Hz)} --- poza
    tym pasmem, układ zaczyna generować sygnały nie powodujące tłumienia.
    Poprawnie tłumione są również sygnały składające się z~sum sinusoid, jednak
    warunkiem jest, aby hałas nie zmieniał swojej częstotliwości szybciej niż w
    czasie około jednej sekundy.
    \item \textbf{System nie jest w stanie tłumić hałasów losowych i tych nie
    posiadających wyróżniających się składowych częstotliwosciowych} ---
    zbieżność algorytmu dla takich sygnałów jest zbyt wolna.
    \item \textbf{System jest w stanie wytłumić mocno odznaczające się składowe
    częstotliwościowe hałasów rzeczywistych o około 14 dB} --- w przypadku
    nagrania młynów kulowych, odznaczający się pik w~okolicach 400 Hz został
    wytłumiony o~około 14 dB.
\end{enumerate}
