kopiecki/anc/docs/polsl/thesis/graf/analysis/main.pdf

PRACA MAGISTERSKA; Daniel KOPIECKI; Nr albumu: 281324; Gliwice 2023

Układ aktywnego tłumienia hałasu pod nadzorem jądra systemu Linux

z rozszerzeniami real-time

Kierunek: Automatyka i Robotyka

Specjalność: Systemy Pomiarowe i Informacyjne

PROWADZĄCY PRACĘ
dr inż. Krzysztof Mazur

KATEDRA Pomiarów i Systemów Sterowania
Wydział Automatyki, Elektroniki i Informatyki

Tytuł pracy

Układ aktywnego tłumienia hałasu pod nadzorem jądra systemu Linux z rozszerzeniami real-time

Streszczenie

Praca opisuje proces projektowania i implementacji układu aktywnej redukcji hałasu na bazie wbudowanego systemu Linux z roszerzeniami czasu rzeczywistego w oparciu o samodzielnie skonstruowaną elektronikę komunikującą się z zainstalowanym na platformie obliczeniowej systemem operacyjnym i aplikacją działającą w trybie użytkownika. W treści szczegółowo wyjaśnione zostały zasady działania systemów aktywnej redukcji hałasu, przedstawiony został przebieg realizacji części sprzętowej i programowej układu wraz z weryfikacją ich działania. Na skonstruowanym układzie wykonany został zestaw badań sprawdzający wpływ konfiguracji systemu na uzyskany poziom tłumienia oraz przedstawione zostały obserwacje dotyczące możliwych usprawnień.

Słowa kluczowe

aktywne tłumienie hałasu, filtracja adaptacyjna, identyfikacja systemów, jądro Linux, system czasu rzeczywistego, płytka drukowana

Thesis title

Active noise reduction system under the supervision of the Linux kernel with real-time extensions

Abstract

The thesis describes the design and implementation process of active noise control system based on embedded Linux with real-time extensions using self-constructed electronic circuit communicating with operating system installed on chosen computing platform and user-space application. The content explains in detail the principles of active noise control systems, the course of hardware and software parts implementation was presented along with verificiation of their operation. On the constructed system a set of tests was performed to check the influence of system configuration on the obtained attenuation level. Finally, observations regarding possible improvements have been made and presented.

Key words

active noise control, adaptive filtering, Linux kernel, system identification, real-time operating system, printed circuit board

# Spis treści

1 Wstęp | 1
2 Analiza tematu | 7
3 Założenia i proponowane rozwiązanie | 23
4 Implementacja części sprzętowej | 31

5 Implementacja części programowej | 61

6 Testy i badania | 79
7 Podsumowanie | 103
Bibliografia | 107
Spis skrótów i symboli | 111
Pliki uzupełniające | 113
Spis rysunków | 117
Spis tabel | 119

# Rozdział 1

# Wstęp

## 1.1 Wprowadzenie

Wstępne koncepcje systemów realizujących aktywne tłumienie hałasu (ang. Active noise control, ANC) zaczęły pojawiać się już w latach 30. XX wieku, jednak z powodu braku odpowiednich narzędzi pozwalających na praktyczną implementację rozwiązania w tamtych czasach, znaczące postępy zaczęto obserwować dopiero w latach 80. i 90. XX wieku, kiedy raptowny rozwój technologiczny umożliwił projektowane coraz to dokładniejszych i bardziej niezawodnych układów automatyki [11] Powodem takiego przebiegu wydarzeń był wyłaniający się zza horyzontu początek epoki cyfrowej, która udowodniła, że z użyciem kodu binarnego można opisać i wpływać na otaczający nas świat z dużą precyzją i elastycznością, wynikającą głównie z determinizmu błędów przetwarzania, na których wielkość projektant ma pełen wpływ. Zastosowanie układów cyfrowych w systemach ANC umożliwiło ich szersze wykorzystanie w praktyce. Znalazły one swoje zastosowanie w redukcji hałasów akustycznych, rozchodzących się w powietrzu w zamkniętej lub otwartej przestrzeni, redukcji hałasów hydroakustycznych, rozchodzących się w płynach oraz redukcji hałasów wibracyjnych, czyli aktywnym tłumieniu drgań. Jak to zazwyczaj bywa z nowymi technologiami, pierwsze praktyczne realizacje ANC zaobserwowano w militariach, między innymi w tłumieniu hałasu akustycznego propagującego się wewnątrz odrzutowca.

Jak opisuje prawo Moore’a [21], optymalna liczba tranzystorów w układach scalonych w kolejnych latach zwiększa się z zgodnie z trendem wykładniczym i takie zachowanie można zaobserwować do czasów bliskim teraźniejszych (aktualnie prawo nie jest już ściśle zachowane). Ekstremalna miniaturyzacja, optymalizacja zapotrzebowania energetycznego jak i niskie koszta układów cyfrowych spowodowały ich globalizację. Obecnie ANC można zaobserwować na rynku konsumenckim, w postaci słuchawek redukujących hałas z otoczenia, wytłumiaczy otwartych pomieszczeń biurowych czy systemów tworzących przestrzenną strefę ciszy w środku pojazdu. Na tego typu systemy rośnie popyt, spowodo-

Daniel Kopiecki

wany między innymi wzrostem populacji oraz industrializacji, zwiększajcej ogólny hałas wokół nas.

## 1.2 Uogólniona koncepcja

Hałas w systemach ANC może rozchodzić się w różnych ośrodkach i w zależności od nich definiowany jest obszar zastosowania, z których wyróżnić można systemy akustyczne, hydroakustyczne lub wibracyjne [11]. Od tego momentu, autor używając zwrotów ANC i hałas, będzie miał na myśli jednokanałowe systemy aktywnej redukcji hałasu w ujęciu akustycznym i wokół tej tematyki skupia się dalsza część pracy.

### 1.2.1 Obszar zastosowania

Tradycyjne podejście do redukcji hałasu można uogólnić do wykorzystania pasywnych wytłumiaczy, takich jak szczelne bariery odgradzające, tłumiki czy izolacje akustyczne. Takie rozwiązania, pomimo że cenione za wysokie tłumienie w szerokim paśmie częstotliwości, w większości przypadków są drogie oraz wymagają instalacji dużych rozmiarów, mocno przy tym ingerując w środowisko pracy [11].
Największą wadą pasywnych rozwiązań jest jednak kwestia tłumienia hałasów o niskich częstotliwościach. Z racji, że ośrodek, w którym propaguje się fala dźwiękowa wraz z przeszkodami, które napotyka na swojej drodze, zachowują się jak filtry dolnoprzepustowe dla sygnałów akustycznych, to trudno zrealizować ściśle mechaniczny system zdolny wytłumiać hałasy o największej energii w pasmach niskich. Długość fali jest odwrotnie proporcjonalna do jej częstotliwości [7]

λ =

v
f

(1.1)

więc wolnozmienna fala akustyczna propagująca w powietrzu (v ≈ 343 m
s

) o przykładowej częstotliwości 343 Hz osiągnie długość jednego metra. Zadanie tłumienia fal długich znacząco zwiększa koszta i złożoność realizacji pasywnego systemu tłumienia, ponieważ takie fale wymagają rozległych, grubych i wykonanych ze specjalnych materiałów, mocno absorbujących niechciany hałas, barier akustycznych.
Zważając na powyższe, systemy ANC wykorzystywane są głównie w celu tłumienia hałasów niskoczęstotliwościowych, tam, gdzie rozwiązania pasywne są najmniej efektywne. Typowe pasmo zainteresowań zamyka się w przedziale od 50 Hz do 500 Hz [11]. Niskie częstotliwości powodują, że wymagania czasowe i koszta nałożone na system ANC są z reguły mniejsze, próbkowanie może odbywać się rzadziej, co skutkuje dłuższym czasem na wykonanie obliczeń i wypracowaniem sterowania. Typowo, jeżeli hałas jest tonalny, ANC jest zdolne do osiągania tłumienia na poziomie 30 dB, gdzie w przypadku hałasów sze-

Rozdział 1. Wstęp

rokopasmowych lub losowych, tłumienie jest zazwyczaj gorsze o połowę. Zakres poziomu ciśnienia akustycznego (ang. Sound pressure level, SPL) jest dobierany na podstawie charakterystyki źródła i zazwyczaj, ze względu na parametry typowego hałasu i stosowanych urządzeń, zamyka się w przedziale od 80 dB SPL do 100 dB SPL.
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
