kopiecki/anc/docs/polsl/thesis/graf/impl/Laboratorium_Metod_Optymalizacji___raport_projektowy.pdf

# Laboratorium Metod Optymalizacji Raport projektowy

Reaktor

### Daniel Kopiecki, Paweł Orszulik

### 17 sierpnia 2023

## 1 Wstęp

Przedmiotem wszystkich zadań jest optymalizacja pracy reaktora chemicznego, opisanego następującymi równaniami:
dw
dt = Fa − F | (1)

dT
dt =

FA
w

(TA − T) + 1
wcw

H −

h1
cw

k1CA +

h2
cw
k2CB | (2)

dCA
dt =

1 − CA
w
FA − k1CA | (3)

dCB
dt = −

CB
w
FA + k1CA − k2CB | (4)

gdzie:
k1 = k10e

−

−E1
RT , k2 = k20e

−

−E2
RT | (5)

H =

aFb+1
g
Fg +

aFb
g
2cg
(Tgwe − T) | (6)

Jako, że analizowane będą tylko stany ustalone określonych zmiennych stanu reaktora, równania modelu matematycznego przyjmują postać:

F = Fa | (7)

h1
cw

k1CA −

h2
cw

k2CB =

FA
W

(TA − T) + 1
wcw
H | (8)

k1CA =

1 − CA
w
FA | (9)

CB
w
FA = k1CA − k2CB | (10)

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

## 2 Zadanie 1

2.1 Wyprowadzenie równań

Z równania 9 po przekształceniach otrzymano:

CA(Fa, w, T) = Fa
k1w + Fa

(13)

Podstawiając 13 do równania 10 otrzymano:

Cb(Fa, w, T) =

w
Fa

k1
(

w
Fa

k1 + 1)( w
Fa
| | k2 + 1) | (14)

Obliczając pochodne cząstkowe po określonych parametrach i przyrównując do zera otrzymano:
∂Cb ∂Fa | = 0 =⇒ w
| Fa | =
| | 1
√
| | k1k2

(15)

∂Cb
∂w = 0 =⇒
| w
| Fa | =
| | 1
√
| | k1k2

(16)

| ∂Cb
| ∂T ̸= 0 | | (17)
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
