kopiecki/anc/docs/polsl/final/images/anc_opc.png

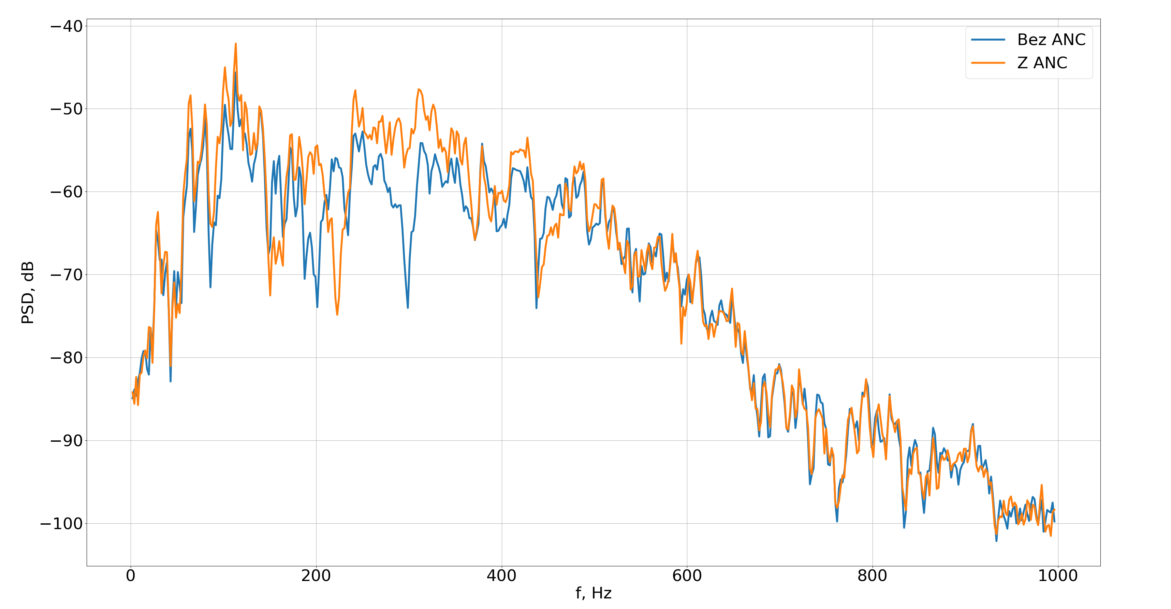
docs/polsl/final/images/anc_opc.png
