kopiecki/anc/docs/polsl/final/images/anc_rand_0.png

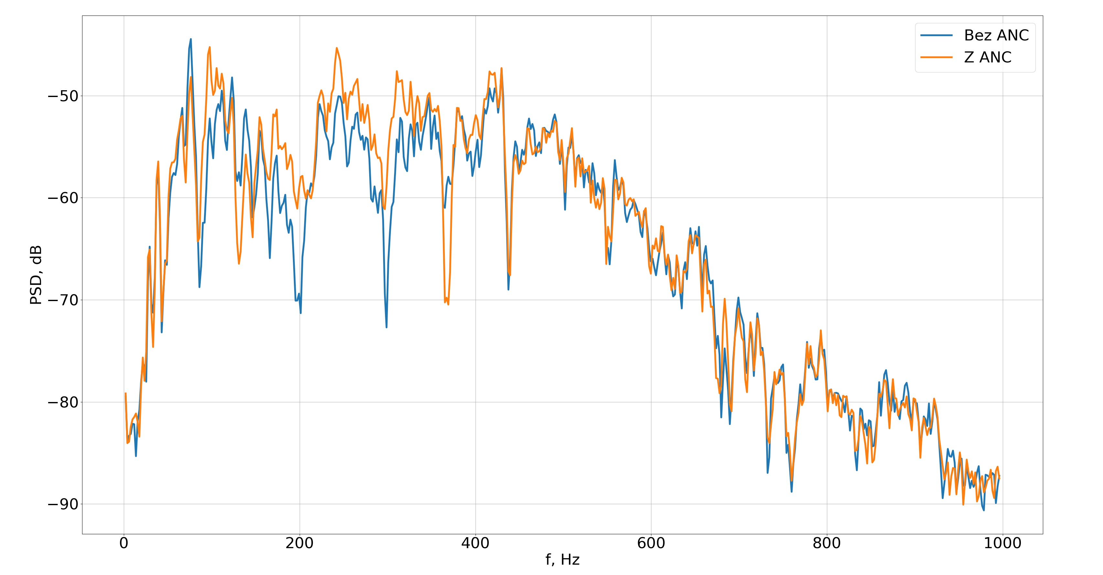
docs/polsl/final/images/anc_rand_0.png
