kopiecki/anc/docs/polsl/final/images/mlyny.png

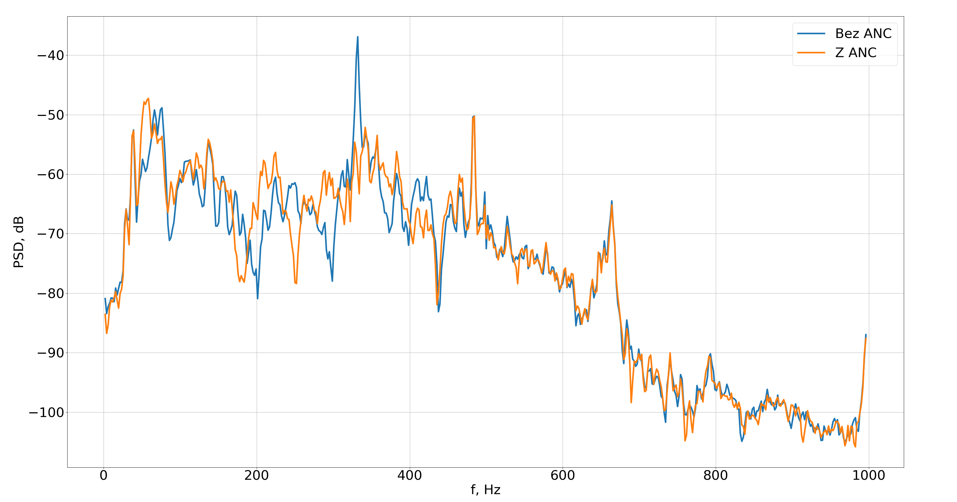
docs/polsl/final/images/mlyny.png
