kopiecki/anc/docs/polsl/sd1/images/stackup.png

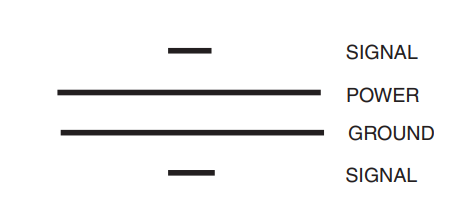
docs/polsl/sd1/images/stackup.png
