kopiecki/anc/docs/polsl/sd2/images/feedback.png

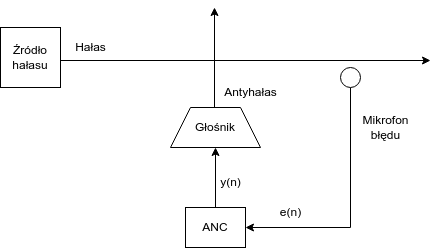
docs/polsl/sd2/images/feedback.png
