kopiecki/anc/docs/polsl/sd3/images/car0.png

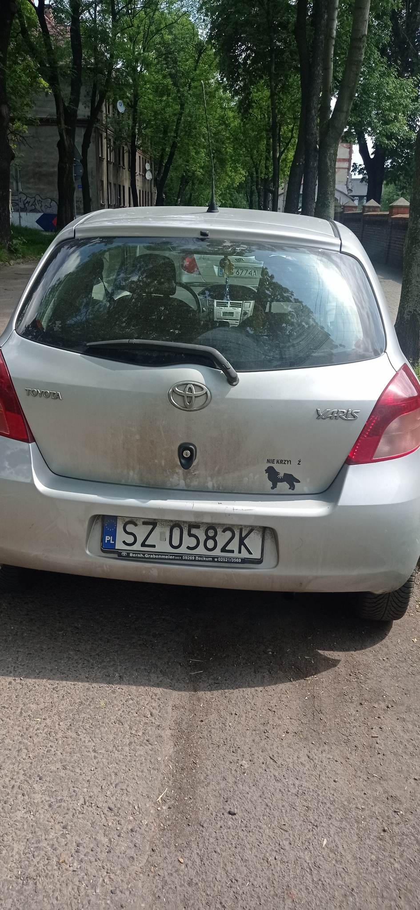
docs/polsl/sd3/images/car0.png
