kopiecki/anc/docs/polsl/sd3/images/car1.png

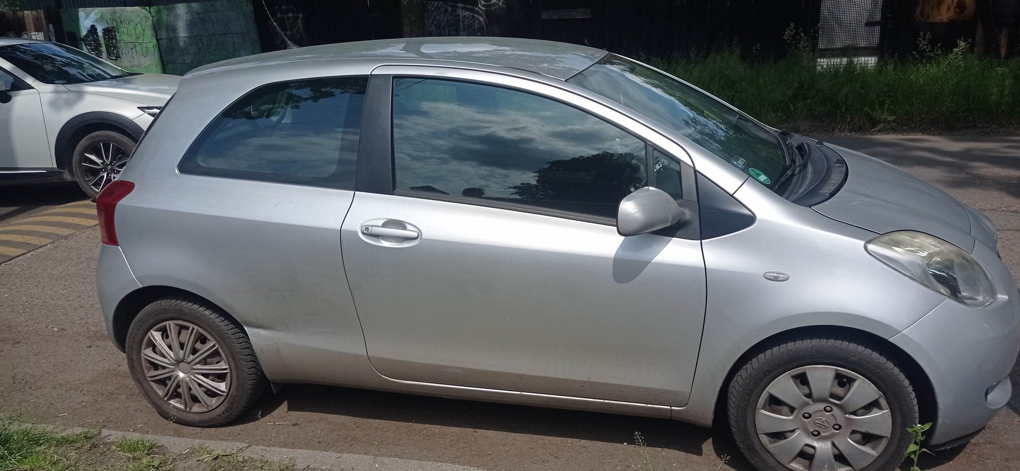
docs/polsl/sd3/images/car1.png
