kopiecki/anc/docs/polsl/sd3/images/images.png

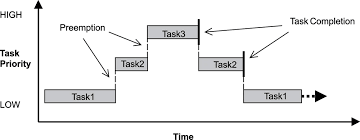
docs/polsl/sd3/images/images.png
