kopiecki/anc/docs/polsl/sd3/images/preempt_1.png

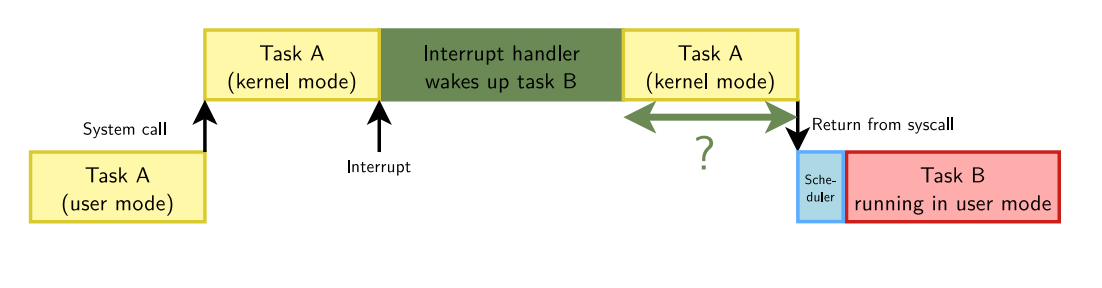
docs/polsl/sd3/images/preempt_1.png
