kopiecki/anc/docs/polsl/thesis/graf/impl/anc.png

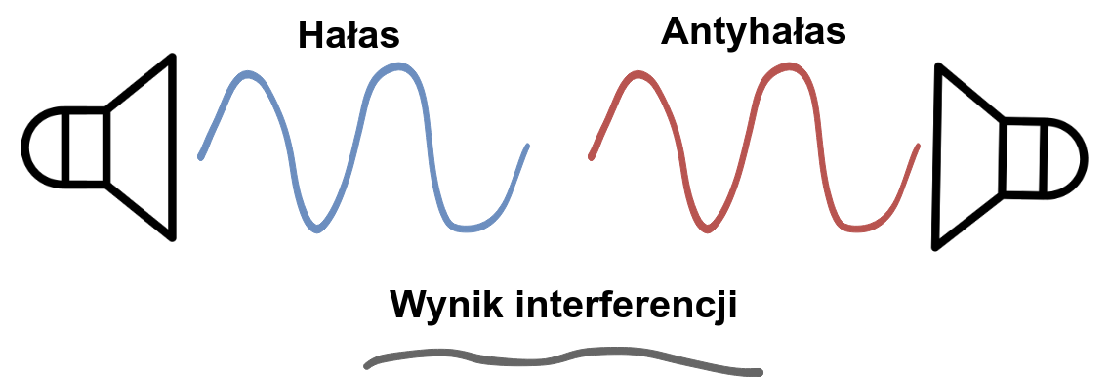
docs/polsl/thesis/graf/impl/anc.png
