kopiecki/anc/docs/polsl/thesis/graf/intro/anc.png

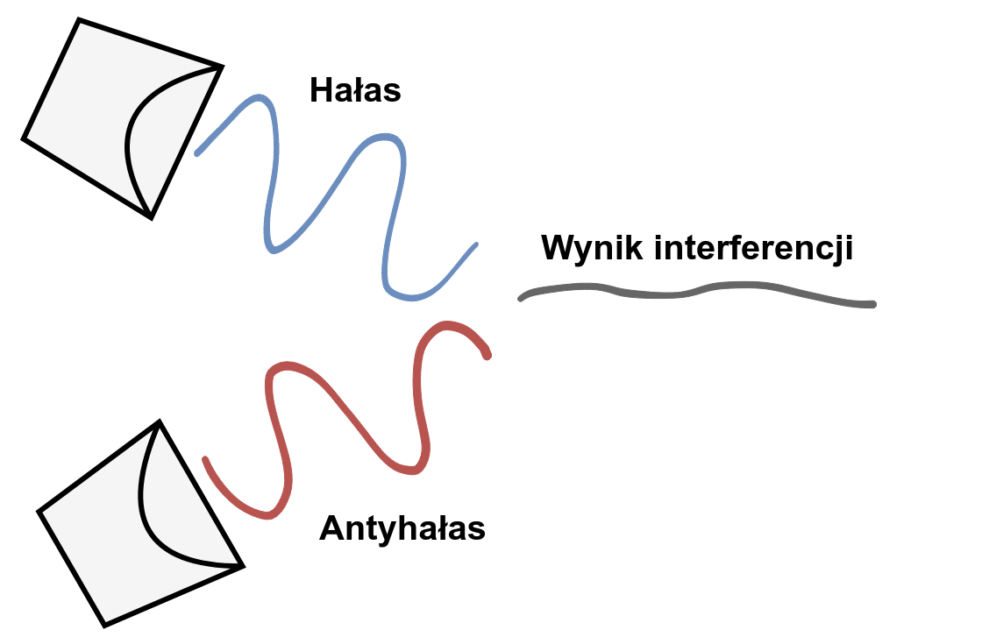
docs/polsl/thesis/graf/intro/anc.png
