kopiecki/anc/docs/polsl/thesis/graf/sw/app_top.png

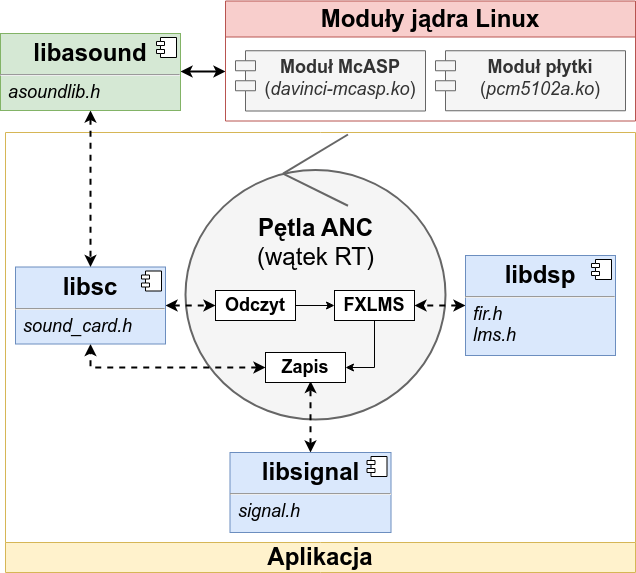
docs/polsl/thesis/graf/sw/app_top.png
