kopiecki/anc/docs/polsl/thesis/graf/sw/preempt_1.png

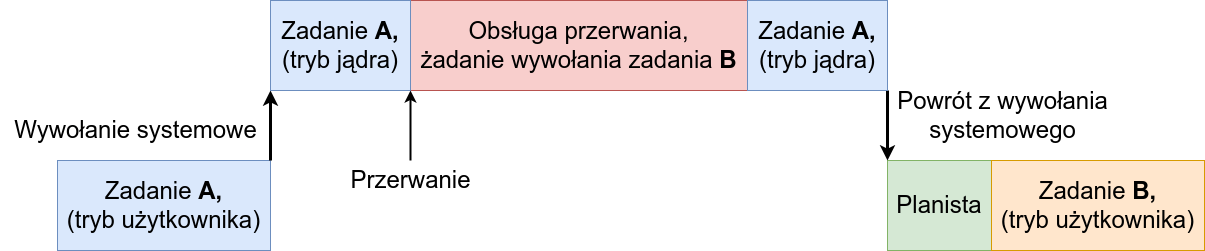
docs/polsl/thesis/graf/sw/preempt_1.png
