kopiecki/anc/tools/scripts/freqResponse.jpg

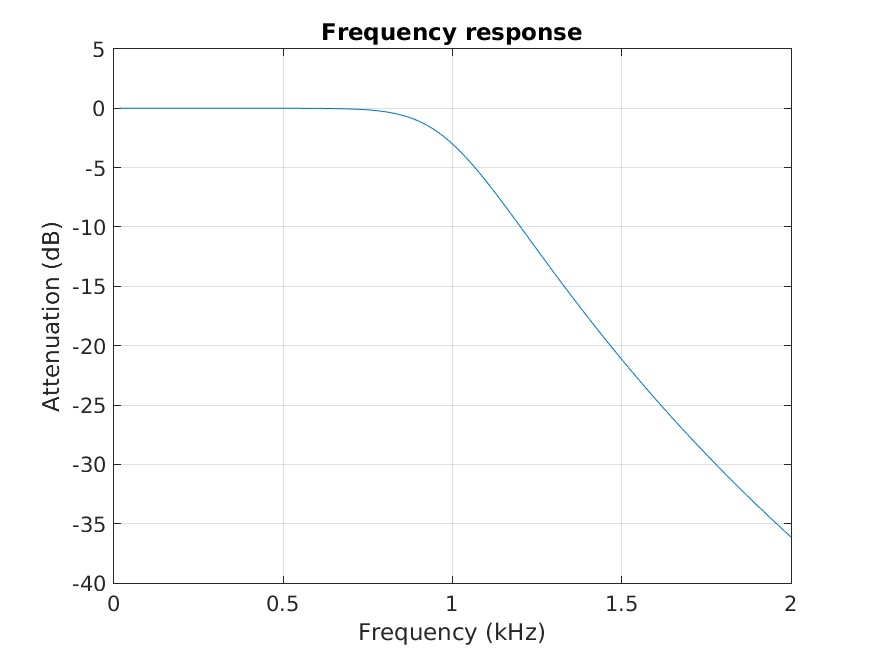
tools/scripts/freqResponse.jpg
