kopiecki/anc/docs/polsl/temporary_project/build/csv/main.csv

Source: | /home/dk/projects/thesis/anc/hardware/kicad/main.kicad_sch
Date: | wto, 14 lut 2023, 10:35:41
Tool: | Eeschema 6.0.10-86aedd382b~118~ubuntu22.04.1
Generator: | /usr/share/kicad/plugins/bom_csv_grouped_by_value.py
Component Count: | 236
Individual Components:
Item | Qty | Reference(s) | Value | LibPart | Footprint | Datasheet
 |  | ANIT_OUT1 | XLR3 | Connector:XLR3 | Connector_Audio:Jack_XLR_Neutrik_NC3MAH-0_Horizontal | ~
 |  | C1 | 100n | Device:C | Capacitor_SMD:C_0603_1608Metric | ~
 |  | C2 | 100n | Device:C | Capacitor_SMD:C_0603_1608Metric | ~
 |  | C3 | 100n | Device:C | Capacitor_SMD:C_0603_1608Metric | ~
 |  | C4 | 100n | Device:C | Capacitor_SMD:C_0603_1608Metric | ~
 |  | C5 | 100n | Device:C | Capacitor_SMD:C_0603_1608Metric | ~
 |  | C6 | 100n | Device:C | Capacitor_SMD:C_0603_1608Metric | ~
 |  | C7 | 100n | Device:C | Capacitor_SMD:C_0603_1608Metric | ~
 |  | C8 | 100n | Device:C | Capacitor_SMD:C_0603_1608Metric | ~
 |  | C9 | 47u | Device:C_Polarized | Capacitor_SMD:CP_Elec_6.3x7.7 | ~
 |  | C10 | 47u | Device:C_Polarized | Capacitor_SMD:CP_Elec_6.3x7.7 | ~
 |  | C11 | 10u | Device:C | Capacitor_SMD:C_0805_2012Metric | ~
 |  | C12 | 10u | Device:C_Polarized | Capacitor_SMD:CP_Elec_6.3x5.8 | ~
 |  | C13 | 10n | Device:C | Capacitor_SMD:C_0603_1608Metric | ~
 |  | C14 | 10n | Device:C | Capacitor_SMD:C_0603_1608Metric | ~
 |  | C15 | 10n | Device:C | Capacitor_SMD:C_0603_1608Metric | ~
 |  | C16 | 10n | Device:C | Capacitor_SMD:C_0603_1608Metric | ~
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
 |  | C121 | 100n | Device:C | Capacitor_SMD:C_0603_1608Metric | ~
 |  | D1 | BAT46W | Diode:BAT46 | Diode_SMD:D_SOD-123F | http://www.vishay.com/docs/85662/bat46.pdf
 |  | D2 | BAT46W | Diode:BAT46 | Diode_SMD:D_SOD-123F | http://www.vishay.com/docs/85662/bat46.pdf
 |  | D3 | BAT46W | Diode:BAT46 | Diode_SMD:D_SOD-123F | http://www.vishay.com/docs/85662/bat46.pdf
 |  | D4 | BAT46W | Diode:BAT46 | Diode_SMD:D_SOD-123F | http://www.vishay.com/docs/85662/bat46.pdf
 |  | D5 | BAT46W | Diode:BAT46 | Diode_SMD:D_SOD-123F | http://www.vishay.com/docs/85662/bat46.pdf
 |  | D6 | BAT46W | Diode:BAT46 | Diode_SMD:D_SOD-123F | http://www.vishay.com/docs/85662/bat46.pdf
 |  | D7 | BAT46W | Diode:BAT46 | Diode_SMD:D_SOD-123F | http://www.vishay.com/docs/85662/bat46.pdf
 |  | D8 | BAT46W | Diode:BAT46 | Diode_SMD:D_SOD-123F | http://www.vishay.com/docs/85662/bat46.pdf
 |  | D10 | LED | Device:LED | LED_SMD:LED_0603_1608Metric | ~
 |  | ERROR_MIC1 | XLR3 | Connector:XLR3 | Connector_Audio:Jack_XLR_Neutrik_NC3MAH-0_Horizontal | ~
 |  | H1 | MountingHole_Pad | Mechanical:MountingHole_Pad | MountingHole:MountingHole_2.7mm_Pad | ~
 |  | INPUT_MIC1 | XLR3 | Connector:XLR3 | Connector_Audio:Jack_XLR_Neutrik_NC3MAH-0_Horizontal | ~
 |  | J1 | Conn_01x02_Male | Connector:Conn_01x02_Male | Connector_PinHeader_2.54mm:PinHeader_1x02_P2.54mm_Vertical | ~
 |  | J2 | Output jack | Connector:Jack-DC | Connector_BarrelJack:BarrelJack_Horizontal | ~
 |  | J3 | Conn_01x06_Male | Connector:Conn_01x06_Male | Connector_PinHeader_2.54mm:PinHeader_1x06_P2.54mm_Vertical | ~
 |  | J6 | Input jack | Connector:Jack-DC | Connector_BarrelJack:BarrelJack_Horizontal | ~
 |  | L1 | 4.7u, 74.8 mOhms | Device:L | Inductor_SMD:L_Wuerth_MAPI-4020 | ~
 |  | L2 | 3.3u, 250 mOhms | Device:L | Inductor_SMD:L_0805_2012Metric | ~
 |  | L3 | 3.3u, 20 mOhms | Device:L | Inductor_SMD:L_Wuerth_WE-PD2-Typ-L | ~
 |  | NOISE_OUT1 | XLR3 | Connector:XLR3 | Connector_Audio:Jack_XLR_Neutrik_NC3MAH-0_Horizontal | ~
 |  | R1 | 680 | Device:R | Resistor_SMD:R_0805_2012Metric | ~
 |  | R2 | 680 | Device:R | Resistor_SMD:R_0805_2012Metric | ~
 |  | R3 | 680 | Device:R | Resistor_SMD:R_0805_2012Metric | ~
 |  | R4 | 680 | Device:R | Resistor_SMD:R_0805_2012Metric | ~
 |  | R5 | 2k | Device:R | Resistor_SMD:R_0603_1608Metric | ~
 |  | R6 | 2k | Device:R | Resistor_SMD:R_0603_1608Metric | ~
 |  | R7 | 2k | Device:R | Resistor_SMD:R_0603_1608Metric | ~
 |  | R8 | 2k | Device:R | Resistor_SMD:R_0603_1608Metric | ~
 |  | R9 | 10k | Device:R | Resistor_SMD:R_0603_1608Metric | ~
 |  | R10 | 10k | Device:R | Resistor_SMD:R_0603_1608Metric | ~
 |  | R11 | 10k | Device:R | Resistor_SMD:R_0603_1608Metric | ~
 |  | R12 | 10k | Device:R | Resistor_SMD:R_0603_1608Metric | ~
 |  | R13 | 100k | Device:R | Resistor_SMD:R_0603_1608Metric | ~
 |  | R14 | 100k | Device:R | Resistor_SMD:R_0603_1608Metric | ~
 |  | R15 | 2k | Device:R | Resistor_SMD:R_0603_1608Metric | ~
 |  | R16 | 2k | Device:R | Resistor_SMD:R_0603_1608Metric | ~
 |  | R17 | 100k | Device:R | Resistor_SMD:R_0603_1608Metric | ~
 |  | R18 | 100k | Device:R | Resistor_SMD:R_0603_1608Metric | ~
 |  | R19 | 2k | Device:R | Resistor_SMD:R_0603_1608Metric | ~
 |  | R20 | 2k | Device:R | Resistor_SMD:R_0603_1608Metric | ~
 |  | R21 | 44.2k | Device:R | Resistor_SMD:R_0603_1608Metric | ~
 |  | R22 | 44.2k | Device:R | Resistor_SMD:R_0603_1608Metric | ~
 |  | R23 | 1k | Device:R | Resistor_SMD:R_0603_1608Metric | ~
 |  | R24 | 1k | Device:R | Resistor_SMD:R_0603_1608Metric | ~
 |  | R25 | 86.6k | Device:R | Resistor_SMD:R_0603_1608Metric | ~
 |  | R26 | 86.6k | Device:R | Resistor_SMD:R_0603_1608Metric | ~
 |  | R27 | 45.3k | Device:R | Resistor_SMD:R_0603_1608Metric | ~
 |  | R28 | 45.3k | Device:R | Resistor_SMD:R_0603_1608Metric | ~
 |  | R29 | 121k | Device:R | Resistor_SMD:R_0603_1608Metric | ~
 |  | R30 | 121k | Device:R | Resistor_SMD:R_0603_1608Metric | ~
 |  | R31 | 31.6k | Device:R | Resistor_SMD:R_0603_1608Metric | ~
 |  | R32 | 31.6k | Device:R | Resistor_SMD:R_0603_1608Metric | ~
 |  | R33 | 261k | Device:R | Resistor_SMD:R_0603_1608Metric | ~
 |  | R34 | 261 | Device:R | Resistor_SMD:R_0603_1608Metric | ~
 |  | R35 | 1k | Device:R | Resistor_SMD:R_0603_1608Metric | ~
 |  | R36 | 1k | Device:R | Resistor_SMD:R_0603_1608Metric | ~
 |  | R37 | 100k | Device:R | Resistor_SMD:R_0603_1608Metric | ~
 |  | R38 | 100k | Device:R | Resistor_SMD:R_0603_1608Metric | ~
 |  | R39 | 6k | Device:R | Resistor_SMD:R_0603_1608Metric | ~
 |  | R40 | 6k | Device:R | Resistor_SMD:R_0603_1608Metric | ~
 |  | R41 | 18k | Device:R | Resistor_SMD:R_0603_1608Metric | ~
 |  | R42 | 18k | Device:R | Resistor_SMD:R_0603_1608Metric | ~
 |  | R43 | 44.2k | Device:R | Resistor_SMD:R_0603_1608Metric | ~
 |  | R44 | 44.2k | Device:R | Resistor_SMD:R_0603_1608Metric | ~
 |  | R45 | 86.6k | Device:R | Resistor_SMD:R_0603_1608Metric | ~
 |  | R46 | 86.6k | Device:R | Resistor_SMD:R_0603_1608Metric | ~
 |  | R47 | 45.3k | Device:R | Resistor_SMD:R_0603_1608Metric | ~
 |  | R48 | 45.3k | Device:R | Resistor_SMD:R_0603_1608Metric | ~
 |  | R49 | 121k | Device:R | Resistor_SMD:R_0603_1608Metric | ~
 |  | R50 | 121k | Device:R | Resistor_SMD:R_0603_1608Metric | ~
 |  | R51 | 31.6k | Device:R | Resistor_SMD:R_0603_1608Metric | ~
 |  | R52 | 31.6k | Device:R | Resistor_SMD:R_0603_1608Metric | ~
 |  | R53 | 261k | Device:R | Resistor_SMD:R_0603_1608Metric | ~
 |  | R54 | 2k | Device:R | Resistor_SMD:R_0603_1608Metric | ~
 |  | R55 | 261k | Device:R | Resistor_SMD:R_0603_1608Metric | ~
 |  | R56 | 2k | Device:R | Resistor_SMD:R_0603_1608Metric | ~
 |  | R57 | 2k | Device:R | Resistor_SMD:R_0603_1608Metric | ~
 |  | R58 | 2k | Device:R | Resistor_SMD:R_0603_1608Metric | ~
 |  | R59 | 100 | Device:R | Resistor_SMD:R_0603_1608Metric | ~
 |  | R60 | 100 | Device:R | Resistor_SMD:R_0603_1608Metric | ~
 |  | R61 | 100 | Device:R | Resistor_SMD:R_0603_1608Metric | ~
 |  | R62 | 100 | Device:R | Resistor_SMD:R_0603_1608Metric | ~
 |  | R63 | 100k | Device:R | Resistor_SMD:R_0603_1608Metric | ~
 |  | R64 | 100k | Device:R | Resistor_SMD:R_0603_1608Metric | ~
 |  | R65 | 100k | Device:R | Resistor_SMD:R_0603_1608Metric | ~
 |  | R66 | 100k | Device:R | Resistor_SMD:R_0603_1608Metric | ~
 |  | R67 | 68.1k | Device:R | Resistor_SMD:R_0805_2012Metric | ~
 |  | R68 | 10k | Device:R | Resistor_SMD:R_0805_2012Metric | ~
 |  | R69 | 100 | Device:R | Resistor_SMD:R_0603_1608Metric | ~
 |  | R70 | 1k | Device:R | Resistor_SMD:R_0603_1608Metric | ~
 |  | R71 | 100 | Device:R | Resistor_SMD:R_0603_1608Metric | ~
 |  | R72 | 100 | Device:R | Resistor_SMD:R_0603_1608Metric | ~
 |  | R73 | 100 | Device:R | Resistor_SMD:R_0603_1608Metric | ~
 |  | R74 | 100 | Device:R | Resistor_SMD:R_0603_1608Metric | ~
 |  | R75 | 100 | Device:R | Resistor_SMD:R_0603_1608Metric | ~
 |  | U1 | TL074 | Amplifier_Operational:TL074 | tl074:TL074CD | http://www.ti.com/lit/ds/symlink/tl071.pdf
 |  | U2 | TL074 | Amplifier_Operational:TL074 | tl074:TL074CD | http://www.ti.com/lit/ds/symlink/tl071.pdf
 |  | U3 | TL071 | Amplifier_Operational:TL071 | tl071:TL071CD | http://www.ti.com/lit/ds/symlink/tl071.pdf
 |  | U4 | TL071 | Amplifier_Operational:TL071 | tl071:TL071CD | http://www.ti.com/lit/ds/symlink/tl071.pdf
 |  | U5 | TL074 | Amplifier_Operational:TL074 | tl074:TL074CD | http://www.ti.com/lit/ds/symlink/tl071.pdf
 |  | U6 | TL074 | Amplifier_Operational:TL074 | tl074:TL074CD | http://www.ti.com/lit/ds/symlink/tl071.pdf
 |  | U7 | TL071 | Amplifier_Operational:TL071 | tl071:TL071CD | http://www.ti.com/lit/ds/symlink/tl071.pdf
 |  | U8 | TL071 | Amplifier_Operational:TL071 | tl071:TL071CD | http://www.ti.com/lit/ds/symlink/tl071.pdf
 |  | U9 | LM1085-5.0 | LM2990:LM1085-5.0 | lm1085:LM1085IS-12&slash_NOPB | http://www.ti.com/lit/ds/symlink/lm1085.pdf
 |  | U10 | LTC3261EMSE | ltc3261emse-pbf:LTC3261EMSE | ltc3261emse-pbf:ltc3261emse-pbf | https://www.analog.com/media/en/technical-documentation/data-sheets/3261fb.pdf
 |  | U11 | REF195GSZ-REEL7 | ref195:REF195GSZ-REEL7 | ref195:REF195GSZ-REEL7
 |  | U12 | LM2940IMP-12 | dk:LM2940IMP-12 | lm2940:LM2940IMP-10&slash_NOPB
 |  | U13 | LM2990SX-12 | LM2990:LM2990SX-12 | lm2990:LM2990S-12 | http://www.ti.com/lit/ds/symlink/lm2990.pdf
 |  | U14 | AD7680BRJZ-REEL7 | ad7680:AD7680BRJZ-REEL7 | ad7680:AD7680BRJZ-REEL7 | https://www.mouser.pl/datasheet/2/609/AD7680-1502134.pdf
 |  | U15 | AD7680BRJZ-REEL7 | ad7680:AD7680BRJZ-REEL7 | ad7680:AD7680BRJZ-REEL7 | https://www.mouser.pl/datasheet/2/609/AD7680-1502134.pdf
 |  | U16 | AD5541LRZ | ad5541:AD5541LRZ | ad5541:AD5541LRZ | https://www.analog.com/media/en/technical-documentation/data-sheets/AD5541_5542.pdf
 |  | U17 | AD5541LRZ | ad5541:AD5541LRZ | ad5541:AD5541LRZ | https://www.analog.com/media/en/technical-documentation/data-sheets/AD5541_5542.pdf
 |  | U18 | TPS563209 | dk:TPS563209 | tps563209:TPS563209DDCR | https://www.ti.com/lit/ds/symlink/tps563209.pdf?ts=1667246962963
 |  | U19 | MAX6001EUR+T | dk:MAX6001EUR+T | Package_TO_SOT_SMD:SOT-23
Collated Components:
Item | Qty | Reference(s) | Value | LibPart | Footprint | Datasheet
1 | 4 | ANIT_OUT1, ERROR_MIC1, INPUT_MIC1, NOISE_OUT1 | XLR3 | Connector:XLR3 | Connector_Audio:Jack_XLR_Neutrik_NC3MAH-0_Horizontal | ~
2 | 45 | C1, C2, C3, C4, C5, C6, C7, C8, C42, C43, C45, C46, C49, C50, C51, C52, C73, C74, C82, C89, C90, C91, C93, C95, C96, C97, C101, C104, C105, C106, C107, C108, C109, C110, C111, C112, C113, C114, C115, C116, C117, C118, C119, C120, C121 | 100n | Device:C | Capacitor_SMD:C_0603_1608Metric | ~
3 | 13 | C9, C10, C35, C36, C57, C58, C59, C61, C68, C77, C79, C98, C99 | 47u | Device:C_Polarized | Capacitor_SMD:CP_Elec_6.3x7.7 | ~
4 | 5 | C11, C65, C100, C102, C103 | 10u | Device:C | Capacitor_SMD:C_0805_2012Metric | ~
5 | 10 | C12, C69, C72, C78, C80, C84, C87, C88, C92, C94 | 10u | Device:C_Polarized | Capacitor_SMD:CP_Elec_6.3x5.8 | ~
6 | 12 | C13, C14, C15, C16, C19, C20, C33, C34, C60, C62, C63, C64 | 10n | Device:C | Capacitor_SMD:C_0603_1608Metric | ~
7 | 3 | C17, C18, C76 | 1n | Device:C | Capacitor_SMD:C_0603_1608Metric | ~
8 | 3 | C21, C22, C37 | 4.7n | Device:C | Capacitor_SMD:C_0603_1608Metric | ~
9 | 4 | C23, C24, C39, C40 | 5.6n | Device:C | Capacitor_SMD:C_0603_1608Metric | ~
10 | 4 | C25, C26, C41, C44 | 2.7n | Device:C | Capacitor_SMD:C_0603_1608Metric | ~
11 | 4 | C27, C28, C47, C48 | 6.8n | Device:C | Capacitor_SMD:C_0603_1608Metric | ~
12 | 4 | C29, C30, C53, C54 | 560p | Device:C | Capacitor_SMD:C_0603_1608Metric | ~
13 | 4 | C31, C32, C55, C56 | 22n | Device:C | Capacitor_SMD:C_0603_1608Metric | ~
14 | 1 | C38 | 4.2n | Device:C | Capacitor_SMD:C_0603_1608Metric | ~
15 | 3 | C66, C67, C75 | 100u | Device:C_Polarized | Capacitor_SMD:CP_Elec_6.3x7.7 | ~
16 | 4 | C70, C71, C83, C85 | 220u | Device:C_Polarized | Capacitor_SMD:CP_Elec_10x10 | ~
17 | 1 | C81 | 1u | Device:C | Capacitor_SMD:C_0603_1608Metric | ~
18 | 1 | C86 | 1u | Device:C_Polarized | Capacitor_SMD:CP_Elec_4x5.4 | ~
19 | 8 | D1, D2, D3, D4, D5, D6, D7, D8 | BAT46W | Diode:BAT46 | Diode_SMD:D_SOD-123F | http://www.vishay.com/docs/85662/bat46.pdf
20 | 1 | D10 | LED | Device:LED | LED_SMD:LED_0603_1608Metric | ~
21 | 1 | H1 | MountingHole_Pad | Mechanical:MountingHole_Pad | MountingHole:MountingHole_2.7mm_Pad | ~
22 | 1 | J1 | Conn_01x02_Male | Connector:Conn_01x02_Male | Connector_PinHeader_2.54mm:PinHeader_1x02_P2.54mm_Vertical | ~
23 | 1 | J2 | Output jack | Connector:Jack-DC | Connector_BarrelJack:BarrelJack_Horizontal | ~
24 | 1 | J3 | Conn_01x06_Male | Connector:Conn_01x06_Male | Connector_PinHeader_2.54mm:PinHeader_1x06_P2.54mm_Vertical | ~
25 | 1 | J6 | Input jack | Connector:Jack-DC | Connector_BarrelJack:BarrelJack_Horizontal | ~
26 | 1 | L1 | 4.7u, 74.8 mOhms | Device:L | Inductor_SMD:L_Wuerth_MAPI-4020 | ~
27 | 1 | L2 | 3.3u, 250 mOhms | Device:L | Inductor_SMD:L_0805_2012Metric | ~
28 | 1 | L3 | 3.3u, 20 mOhms | Device:L | Inductor_SMD:L_Wuerth_WE-PD2-Typ-L | ~
29 | 4 | R1, R2, R3, R4 | 680 | Device:R | Resistor_SMD:R_0805_2012Metric | ~
30 | 12 | R5, R6, R7, R8, R15, R16, R19, R20, R54, R56, R57, R58 | 2k | Device:R | Resistor_SMD:R_0603_1608Metric | ~
31 | 4 | R9, R10, R11, R12 | 10k | Device:R | Resistor_SMD:R_0603_1608Metric | ~
32 | 10 | R13, R14, R17, R18, R37, R38, R63, R64, R65, R66 | 100k | Device:R | Resistor_SMD:R_0603_1608Metric | ~
33 | 4 | R21, R22, R43, R44 | 44.2k | Device:R | Resistor_SMD:R_0603_1608Metric | ~
34 | 5 | R23, R24, R35, R36, R70 | 1k | Device:R | Resistor_SMD:R_0603_1608Metric | ~
35 | 4 | R25, R26, R45, R46 | 86.6k | Device:R | Resistor_SMD:R_0603_1608Metric | ~
36 | 4 | R27, R28, R47, R48 | 45.3k | Device:R | Resistor_SMD:R_0603_1608Metric | ~
37 | 4 | R29, R30, R49, R50 | 121k | Device:R | Resistor_SMD:R_0603_1608Metric | ~
38 | 4 | R31, R32, R51, R52 | 31.6k | Device:R | Resistor_SMD:R_0603_1608Metric | ~
39 | 3 | R33, R53, R55 | 261k | Device:R | Resistor_SMD:R_0603_1608Metric | ~
40 | 1 | R34 | 261 | Device:R | Resistor_SMD:R_0603_1608Metric | ~
41 | 2 | R39, R40 | 6k | Device:R | Resistor_SMD:R_0603_1608Metric | ~
42 | 2 | R41, R42 | 18k | Device:R | Resistor_SMD:R_0603_1608Metric | ~
43 | 10 | R59, R60, R61, R62, R69, R71, R72, R73, R74, R75 | 100 | Device:R | Resistor_SMD:R_0603_1608Metric | ~
44 | 1 | R67 | 68.1k | Device:R | Resistor_SMD:R_0805_2012Metric | ~
45 | 1 | R68 | 10k | Device:R | Resistor_SMD:R_0805_2012Metric | ~
46 | 4 | U1, U2, U5, U6 | TL074 | Amplifier_Operational:TL074 | tl074:TL074CD | http://www.ti.com/lit/ds/symlink/tl071.pdf
47 | 4 | U3, U4, U7, U8 | TL071 | Amplifier_Operational:TL071 | tl071:TL071CD | http://www.ti.com/lit/ds/symlink/tl071.pdf
48 | 1 | U9 | LM1085-5.0 | LM2990:LM1085-5.0 | lm1085:LM1085IS-12&slash_NOPB | http://www.ti.com/lit/ds/symlink/lm1085.pdf
49 | 1 | U10 | LTC3261EMSE | ltc3261emse-pbf:LTC3261EMSE | ltc3261emse-pbf:ltc3261emse-pbf | https://www.analog.com/media/en/technical-documentation/data-sheets/3261fb.pdf
50 | 1 | U11 | REF195GSZ-REEL7 | ref195:REF195GSZ-REEL7 | ref195:REF195GSZ-REEL7
51 | 1 | U12 | LM2940IMP-12 | dk:LM2940IMP-12 | lm2940:LM2940IMP-10&slash_NOPB
52 | 1 | U13 | LM2990SX-12 | LM2990:LM2990SX-12 | lm2990:LM2990S-12 | http://www.ti.com/lit/ds/symlink/lm2990.pdf
53 | 2 | U14, U15 | AD7680BRJZ-REEL7 | ad7680:AD7680BRJZ-REEL7 | ad7680:AD7680BRJZ-REEL7 | https://www.mouser.pl/datasheet/2/609/AD7680-1502134.pdf
54 | 2 | U16, U17 | AD5541LRZ | ad5541:AD5541LRZ | ad5541:AD5541LRZ | https://www.analog.com/media/en/technical-documentation/data-sheets/AD5541_5542.pdf
55 | 1 | U18 | TPS563209 | dk:TPS563209 | tps563209:TPS563209DDCR | https://www.ti.com/lit/ds/symlink/tps563209.pdf?ts=1667246962963
56 | 1 | U19 | MAX6001EUR+T | dk:MAX6001EUR+T | Package_TO_SOT_SMD:SOT-23
