kopiecki/anc/docs/polsl/temporary_project/build/raport_DanielKopiecki.pdf

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

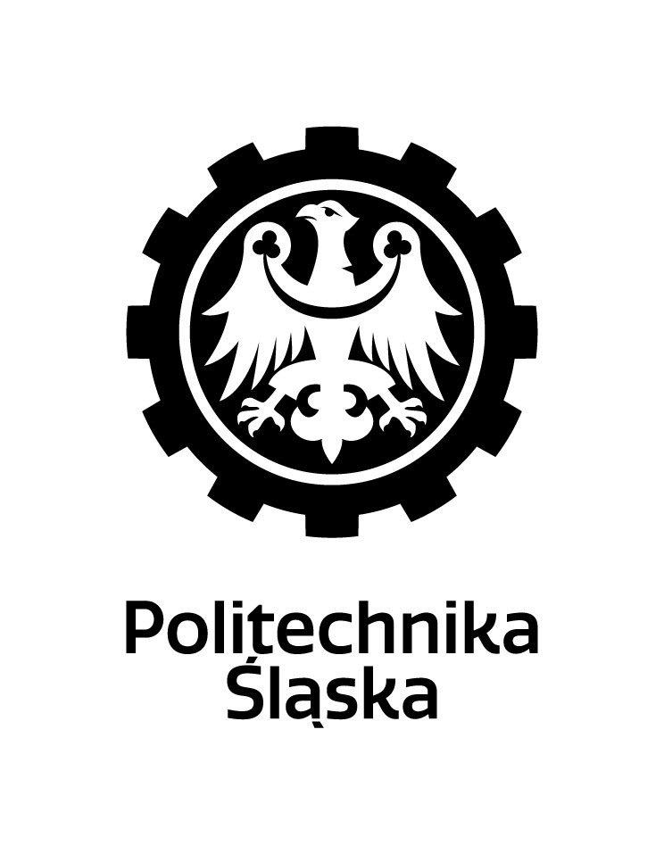
[picture p307: figure]

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

## 1 Wst¦p

Zrealizowany projekt przej±ciowy jest ±ci±le powi¡zany z realizowanym projektem magisterskim, w którego skªad wchodzi implementacja metod aktywnego tªumienia haªasu od strony sprz¦towej oraz programowej.

Istnieje sporo gotowych ukªadów scalonych, zaopatrzonych w odpowiednio dobrane przetworniki, zasilania oraz interfejsy analogowe jak i cyfrowe, zdolnych do bezproblemowego rozwi¡zania sprz¦towych problemów implementacyjnych, których rozwi¡zanie wybraª sobie autor niniejszego dokumentu. Id¡c krok dalej, caª¡ warstw¦ sprz¦tow¡ mo»na zamkn¡¢ w najprostszej karcie d¹wi¦kowej, zdolnej obsªugiwa¢ dwa wej±cia i dwa wyj±cia audio, z któr¡ bezproblemowo docelowa platforma dogada si¦ po uniwersalnych protokoªach cyfrowych. Takie wyj±cie byªoby z pewno±ci¡ optymalne, jednak autor z niego zrezygnowaª, implementuj¡c caª¡ elektronik¦ od podstaw.

Powodem takiego wyboru byªy szerokie horyzonty edukacyjne. Zdaniem autora nic tak nie uczy, jak realizacja postawionego sobie celu od fundamentów. Mówi¡c tutaj o fundamentach, za najni»szy poziom abstrakcji sprz¦towej wybrano niezale»ne od siebie, ale pracuj¡ce w ko«cowym ukªadzie razem, przetworniki AD i DA, wzmacniacze operacyjne wchodz¡ce w skªad zaprojektowanych samodzielnie ltrów, regulatory oraz przetwornice napi¦cia, jak i równie» wªasny, niestandardowy protokóª cyfrowy do komunikacji z przetwornikami.

1.1 Cel projektu

Odnosz¡c si¦ bezpo±rednio do opisanej wy»ej my±li przewodniej, celem projektu jest zaprojektowanie wªasnego ukªadu elektronicznego b¦d¡cego baz¡ pod implementacje programowe metod aktywnego tªumienia haªasu. Zaprojektowany i zasymulowany ukªad zostanie nast¦pnie odwzorowany na pªycie PCB, której wykonanie zostanie zlecone zewn¦trznej rmie. Na tak uzyskanych pªytach zostan¡ nast¦pnie przez autora obsadzone podzespoªy elektroniczne i caªo±¢ po zªo»eniu zostanie werykowana pod k¡tem dziaªania do momentu uzyskania akceptowalnych, zaªo»onych wcze±niej rezultatów.

1.2 Zaªo»enia projektowe

Poza opisanymi wy»ej zaªo»eniami gªównymi, czyli implementacj¡ elektroniki na niskim poziomie abstrakcji, z zaªo»e« projektowych mo»na wyró»ni¢:

1. Obsªug¦ dwóch wej±ciowych, jednokanaªowych torów audio próbkowanych przez osobne przetworniki analogowo-cyfrowe stosunkowo wysokiej jako±ci.
2. Obsªug¦ dwóch wyj±ciowych, jednokanaªowych torów audio obsªugiwanych przez osobne przetworniki cyfrowo-analogowe stosunkowo wysokiej jako±ci.
3. Odpowiednie przetwarzanie kanaªów analogowych, zapewnienie odpowiedniej ltracji oraz wzmocnie«.
4. Zapewnienie odpowiednich zasila« oraz napi¦¢ referencyjnych dla caªego ukªadu oraz zewn¦trznej centralnej jednostki obliczeniowej.
5. Zapewnienie obsªugi opracowanego interfejsu cyfrowego, dost¦pu do sygnaªów wej-±ciowych i wyj±ciowych zastosowanych przetworników.
6. Synchronizacja ukªadów analogowo-cyfrowych.

1.3 Wykorzystane narz¦dzia

W trakcie projektowania ukªadu wykorzystano nast¦puj¡ce narz¦dzia:

1. KiCAD - jako gªówne ±rodowisko projektowe
2. Ngspice - jako gªówne ±rodowisko symulacyjne
3. GNU Octave - jako narz¦dzie wspomagaj¡ce projektowanie ltrów
4. Vim - jako gªówny edytor tekstu
5. Git - jako gªówny system kontroli wersji

## 2 Implementacja

Zaprojektowany ukªad mo»na podzieli¢ na cztery najwa»niejsze sekcje, przedstawione na rysunku 1.

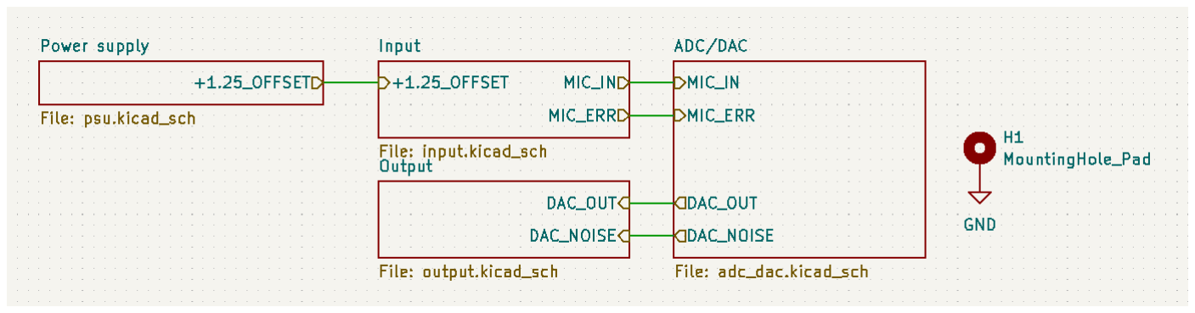
[picture p308: figure]

Rysunek 1: Schemat warstwy nadrz¦dnej

Sekcje poª¡czone s¡ ze odpowiednimi sygnaªami wej±ciowymi i wyj±ciowymi. Warto wspomnie¢, »e zasilania na schemacie nie s¡ wyszczególnione, poniewa» w ±rodowisku Ki-CAD napi¦cia zasilaj¡ce maj¡ globalny zasi¦g i nie s¡ deniowane przez lokalne etykiety.

Poszczególne sekcje i ich sygnaªy wej±ciowe/wyj±ciowe mo»na zdeniowa¢ nast¦puj¡co:

1. Input - sekcja wej±¢ audio
a) Wej±cie - sygnaª staªonapi¦ciowy o potencjale +1.25 V wzgl¦dem masy
b) Wyj±cie - przetworzony sygnaª audio mikrofonu wej±ciowego (MIC_IN) i przetworzony sygnaª audio mikrofonu bª¦du (MIC_ERR).
2. Output - sekcja wyj±¢ audio
a) Wej±cie - bezpo±rednie wyj±cia przetworników cyfrowo-analogowych (sygnaªy DAC_OUT i DAC_NOISE)
3. Power supply (PSU, Power supply unit) - sekcja zasila«
a) Wyj±cie - Sygnaª staªonapi¦ciowy o potencjale +1.25 V wzgl¦dem masy
4. ADC/DAC - sekcja sygnaªów cyfrowych i przetworników
a) Wej±ciowe i wyj±ciowe przetworzone sygnaªy audio.

Prócz bloków reprezentowanych przez poszczególne sekcje, na 1 mo»na równie» zauwa»y¢ symbol globalnego otworu monta»owego. Przyj¦ªo si¦, »e elementy monta»owe deniuje si¦ w warstwie nadrz¦dnej projektu.

2.1 Najwa»niejsze ukªady i wymagania z nich wynikaj¡ce

Przed przyst¡pieniem do projektowania okre±lonych cz¦±ci ukªadu autor musiaª podj¡¢ decyzj¦ o wyborze najbardziej znacz¡cych czipów w ukªadzie, jakimi s¡ przetworniki analogowo-cyfrowe i cyfrowo-analogowe. Baz¡ do wyboru tych ukªadów byªy nast¦puj¡ce, wynikaj¡ce z pó¹niejszej, docelowej implementacji cz¦±ci programowej, wymagania:

1. Relatywnie niska cz¦stotliwo±¢ próbkowania - na bazie literatury oraz konsultacjach z promotorem projektu okre±lono, »e cz¦stotliwo±¢ próbkowania zastosowana w projekcie nie b¦dzie przekraczaªa 1 kHz. Powodem jest w¡skie zastosowanie ukªadów aktywnej redukcji haªasu, które w wyniku swojej zªo»ono±ci, a co za tym idzie, wysokich kosztów, nie s¡ optymalnym wyborem przy zadaniach tªumienia sygnaªów relatywnie szybko zmiennych (w takich sytuacjach lepiej wykorzysta¢ rozwi¡zania mechaniczne).
2. Cyfrowy interfejs komunikacyjny z przetwornikami musi by¢ jednakowy i wspierany przez wybran¡ platform¦ (jednostk¦ obliczeniow¡). Trzeba tutaj równie» uwzgl¦dni¢, »e wybrane przetworniki musz¡ by¢ skongurowane tak, aby jednostka obliczeniowa posiadaªa wystarczaj¡c¡ ilo±¢ wolnych linii wybranego interfejsu, tak, aby wszystkie obsªu»y¢.
3. Wybrane przetworniki musz¡ by¢ stosunkowo wysokiej rozdzielczo±ci. Sygnaª d¹wi¦-kowy jest do±¢ skomplikowanym sygnaªem i wymagane jest, aby strumie« danych b¦d¡cy wynikiem jego próbkowania byª stosunkowo wysokiej dokªadno±ci.
4. Stosunkowo niska cena, wysoka dost¦pno±¢ i prostota implementacji projektowej na PCB.

Zwa»aj¡c na wyszczególnione wy»ej wymagania, autor zdecydowaª si¦ na wykorzystanie przetworników rmy Analog Devices, a dokªadniej ukªadów AD7680 jako przeworniki AD i ukªadów AD5541 jako przetworniki DA.

2.1.1 Wybrany przetwornik AD

Ukªad AD7680 spod szyldu rmy Analog Devices jest 16 bitowym przetwornikiem analogowo-cyfrowym typu SAR o maksymalnej cz¦stotliwo±ci próbkowania równej fs = 100 kSPS oraz maksymalnym zapotrzebowaniu mocy równym 3 mW. Sposób interakcji przeprowadzany jest przez protokóª SPI, gdzie gªówny sygnaª zegarowy SCLK odpowiada za cz¦stotliwo±¢ próbkowania przetwornika. Ukªad ten jest dost¦pny masowo w internetowych sklepach elektronicznych, a jego cena nie zwala z nóg.

Piny ukªadu przedstawiono na rysunku 2


Rysunek 2: Piny wybranego przetwornika AD

Jak mo»na wywnioskowa¢ bezpo±rednio z rysunku 2, wybrany przetwornik jest prostym ukªadem. Poza trzema sygnaªami cyfrowymi protokoªu SPI trzeba mu zapewni¢ dost¦p do masy ukªadu (GND), napi¦cia zasilania (Vdd) oraz próbkowanego przez niego napi¦cia wej±ciowego.

Przy obsªudze tego przetwornika nasuwaj¡ si¦ jednak dwie wa»ne kwestie.

1. Wej±ciowy sygnaª napi¦ciowy próbkowany przez przetwornik (sygnaª Vin) musi by¢ w zakresie potencjaªów masy i napi¦cia referencyjnego. Bior¡c za mas¦ potencjaª zerowy, oraz standardowe napi¦cie zasilaj¡ce przetwornik wynikaj¡ce z dokumentacji, czyli +5 V zrozumiaªe jest, »e sygnaª Vin musi by¢ z przedziaªu (0, +5) V. Bezpo±rednio st¡d wynika, »e wej±ciowy sygnaª napi¦ciowy musi zosta¢ odpowiednio wyskalowany tak, aby znalazª si¦ w ±rodku przedziaªu przetwornika.
2. Sygnaª zasilaj¡cy Vdd peªni funkcj¦ sygnaªu Vref . Oznacza to, »e zasilanie musi równie» peªni¢ funkcj¦ referencji. Jako, »e zapotrzebowanie energetyczne ukªadu jest maªe, do zasilania przetwornika mo»na wykorzysta¢ bezpo±rednio ¹ródªa napi¦¢ referencyjnych o maªej wydajno±ci pr¡dowej (nota z dokumentacji).

Podsumowuj¡c, wymagania wynikaj¡ce z doboru ukªadu AD7680 mo»na stre±ci¢ nast¦puj¡co:

1. Wyskalowanie próbkowanego napi¦cia wej±ciowego do ±rodka zakresu przetwornika (0, +5) V.
2. Zapewnienie czystego napi¦cia zasilaj¡cego +5 V peªni¡cego równocze±nie funkcj¦ referencji ukªadu.
3. Protokóª SPI jako gªówny cyfrowy interfejs komunikacyjny.

2.1.2 Wybrany przetwornik DA

Ukªad AD5541 spod szyldu rmy Analog Devices jest 16 bitowym, napi¦ciowo wyj±ciowym przetwornikiem cyfrowo-analogowym o niskim maksymalnym zapotrzebowaniu energetycznym równym 0.625 mW. Identycznie jak w dobranym przetworniku analogowo-cyfrowym, cyfrowym interfejsem komunikacyjnym ukªadu jest protokóª SPI.

Piny ukªadu przedstawiono na rysunku 3

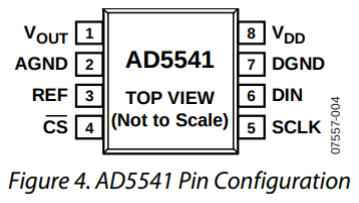
[picture p309: figure]

Rysunek 3: Piny wybranego przetwornika DA

Jak mo»na wywnioskowa¢ bezpo±rednio z rysunku 3, poza standardowymi sygnaªami potrzebnymi przy tego typu ukªadów, u»ywany przetwornik poza zasilaniem posiada swoj¡ oddzieln¡ referencje (sygnaª REF) mog¡c¡ osi¡ga¢ warto±ci z zakresu (2, Vdd). Wynikaj¡ st¡d nast¦puj¡ce wymagania projektowe:

1. Potrzeba zapewnienia czystego referencyjnego zasilania o okre±lonym potencjale oraz okre±lonego napi¦cia zasilania ((2, 5) V).
2. Protokóª SPI jako gªówny cyfrowy interfejs komunikacyjny.

2.1.3 Podsumowanie wymaga« narzuconych przez dobrane przetworniki

Reasumuj¡c sprawy poruszane w poprzednich sekcjach, na pewno podsumowa¢ mo»na nast¦puj¡ce kwestie:

1. Sumarycznie potrzebne s¡ dwa sygnaªy zasilaj¡ce, z czego jeden peªni¢ b¦dzie funkcj¦ napi¦cia referencyjnego dla ukªadu przetwornika DA jak i funkcj¦ referencyjnozasilaj¡c¡ dla ukªadu AD. Z racji standardowych warto±ci zdecydowano si¦ tutaj na napi¦cie +5 V. Wydajno±¢ pr¡dowa sygnaªu wynikaj¡ca z dokumentacji ukªadów oraz tego, »e sumarycznie do tego sygnaªu b¦d¡ podpi¦te cztery ukªady nie mo»e by¢ mniejsza ni» 10 mA.
2. Ukªadowi DA poza referencj¡ trzeba zagwarantowa¢ zasilanie. Tutaj równie» zdecydowano si¦ na klasyczne +5 V. Ten sygnaª nie musi by¢ równie czysty jak wy»ej opisywane napi¦cie referencyjne.
3. Interfejsem komunikacyjnym dla wszystkich przetworników jest SPI, wi¦c trzeba zapewni¢, a» cztery wolne linie protokoªu na docelowej jednostce obliczeniowej.

Pierwsze dwa punkty s¡ mo»liwe i proste w realizacji, trzeci natomiast spowodowaª dodatkowe problemy projektowe. Platforma, na której b¦dzie realizowana cz¦±¢ programowa projektu (procesor Sitara AM3357 na pªytce rozwojowej BeagleBone Black) posiada tylko dwa kanaªy SPI, po których dodatkowo niemo»liwa jest jednoczesna transmisja bez u»ycia zewn¦trznego kontrolera (DMA lub RPU). Prowadzi to do kolejnej sekcji, a mianowicie okre±lenia protokoªu komunikacyjnego, zdolnego zast¡pi¢ cztery osobne kanaªy RX/TX SPI.

2.1.4 Protokóª cyfrowy

Wymagania dla protokoªu cyfrowego wynikaj¡ce z podj¦tych decyzji projektowych s¡ nast¦puj¡ce:

1. Potrzebna ilo±¢ linii TX - 2
2. Potrzebna ilo±¢ linii RX - 2
3. Wymagana jest linia zegarowa, synchronizuj¡ca ukªady i zapewniaj¡ce okre±lone cz¦-stotliwo±ci próbkowania
4. Wymagany jest sygnaª symuluj¡cy CS SPI (stan niski oznacza zacz¦cie rozmowy z ukªadem).
5. Interfejs powinien by¢ mo»liwy do realizacji od strony programowej, tzn. biblioteki do komunikacji po tym interfejsie powinny by¢ zapewnione od strony wykorzystywanego systemu operacyjnego.

Zwa»aj¡c na wyszczególnione wy»ej wymagania, autor po okresie poszukiwa« zdecydowaª si¦ na protokóª McASP (Multichannel Audio Serial Port). Przebiegi czasowe poszczególnych linii protokoªu przedstawione s¡ na rysunku


Rysunek 4: Linie McASP

Protokóª jest u»ywany jako gªówne medium interakcji systemu operacyjnego GNU/Linux z kartami d¹wi¦kowymi za po±rednictwem bibliotek ALSA. Stre±ci¢ go mo»na nast¦puj¡co:

1. X linii RX oznaczonych jako DRX. Wykorzystywana jednostka ma ich cztery.
2. X linii TX oznaczonych jako DTX. Wykorzystywana jednostka ma ich cztery.
3. Gªówna linia zegarowa o wysokiej cz¦stotliwo±ci (sygnaª PCLK).
4. Linia synchronizuj¡ca b¦d¡ca zegarem o niskiej cz¦stotliwo±ci (FSYNC)

Protokóª jest wykorzystywany do interakcji z wielokanaªowymi kartami d¹wi¦kowymi, wi¦c X linii RX i TX jest niezb¦dnych. Dodatkowo, cz¦stotliwo±¢ sygnaªów PCLK i FSYNC jest w peªni kongurowalna. Korzystaj¡c z bibliotek ALSA istnieje mo»liwo±¢ jednoczesnego odczytu i zapisu.

Dzi¦ki wykorzystaniu tego protokoªu, gªówny problem, który pojawiª si¦ po wyborze przetworników zostaª za»egnany. Sygnaª FSYNC mo»na traktowa¢ jako globalny sygnaª CS SPI dla wszystkich u»ywanych przetworników, gwarantuj¡c tym samym peªn¡ synchronizacj¦ oraz odczyt/zapis w tym samym momencie. Interakcja z czipami b¦dzie zaczynaªa si¦ na zboczu opadaj¡cym sygnaªu.

Odpowiednie sygnaªy SPI dzi¦ki skorzystaniu z McASP przyjmuj¡ zatem nast¦puj¡c¡ form¦:

1. SCLK - PCLK
2. CS - FSYNC
3. MISO - DRX
4. MOSI - DTX

Przykªadowy schemat komunikacji jednego mastera (w aktualnym przypadku masterem jest BBB) z dwoma slave'ami przedstawiono na rysunku 5.


Rysunek 5: Komunikacja master - multislave

2.2 Zasilanie

Sekcja zasilania przedstawiono na rysunku 6. 1 | 2 | 3 | 4 | 5 | 6
1 | 2 | 3 | 4 | 5 | 6 A

BC

D

A

BC

D Date: 2022-11-20 KiCad E.D.A. kicad 6.0.10-86aedd382b~118~ubuntu22.04.1 Size: A4 | Rev: 0.1
Id: 2/5 Title: Active noise reduction development board - power supply

File: psu.kicad_sch

Sheet: /Power supply/

# Daniel Kopiecki C104

100n D¹⁰ LED GND

C76

1n | C82
100n | TP 1 VS 2
*SLEEP 3 GND 4 | TP 5 OUTPUT 6 NC 7 NC 8 U11 REF195GSZ-REEL7

+15V C105

100n C70

220u | C71
220u | PWR_FLAG

C85
220u GND

C81

1u | +15V C100
10u | GND 1 | SW 2 VIN 3 | VFB 4 EN 5 | VBST 6 U18 TPS563209 | C101

100n

L3

3.3u, 20 mOhms | R68
10k | +6V R67
68.1k | C102

10u C69

10u C68

47u C65

10u

L2

3.3u, 250 mOhms

-15V | C84
| 10u C72

10u C11

10u GND

1

2

J6
Input jack | C73

100n PWR_FLAG

C83

220u VCC NC 1 EN 10 MODE 11 | NC 12 GND 13 RT 2 NC 3 | VOUT 4 C⁻ 5 NC 6 NC 7 C⁺

# 8 VIN 9 U10

LTC3261EMSE

GND

C66
100u +15V

L1
4.7u, 74.8 mOhms C12

10u C67
100u | +12VA C80

10u

IN 1 GND

2 OUT 3 PAD

4 U12
LM2940IMP-12 C74

100n

IN 1 OUT 2 GND

3 U19 MAX6001EUR+T GND
+5VA

+5VD

+5VA R70

1k | C89
100n | C75

100u C103

## 10u PWR_FLAG

C77
47u GND

1

IN 2 | OUT 3 PAD 4 | U13
LM2990SX-12 | C86
1u C78
10u | GND | GND

+5VD

-12VA

+12VA | GNDGND

1 VO 2 VI 3 PAD 4 U9
LM1085-5.0 C79

47u +1.25_OFFSET PSU

Simple LED for information purposes.

+15 V / +6 V SMPS, up to 3 A.

+1.25 V offset voltage reference

+/- 12 V rail split

LED

High precision LDO, +/- 2 mV maximum accuracy. Iout up to 30 mA.

+15 V switching power supply, noisy.

LC filter (fc = 12.18 kHz)

Input filter

-15 V / -12 V LDO, up to 1 A.

+1.25 V offset

+5 V reference
+15 V / +12 V LDO, up to 1 A.

+6 V / +5 V LDO, up to 3 A.

LC filter (fc = 2.47 kHz). 74.8 coil resistance for critical dumping.

+5 V power supply

Inverting charge pump.
High ripple (500 kHz, 100 mV p-p),
Iout up to 100 mA. | C86
1u GND

C75

# 100u +5VA C89

100n | C79

47u U9
LM1085-5.0 GND

1 VO 2 VI 3 PAD 4 C102

10u R67

68.1k L3

3.3u, 20 mOhms C101

100n U18 TPS563209 GND 1 | SW 2 VIN 3 | VFB 4 EN 5 | VBST 6 C100
10u | C104

100n C83

220u C85 220uPWR_FLAG

C71

220u C70

220u | C105

100n +15V U11 REF195GSZ-REEL7TP 1 VS 2

*SLEEP 3 GND 4 | TP 5 OUTPUT 6 NC 7 NC 8 C82

100n GND

C80

10u +12VA U10

LTC3261EMSENC 1 EN 10 MODE 11 | NC 12 GND 13 RT 2 NC 3 | VOUT 4 C⁻ 5 NC 6 NC 7 C⁺

8 VIN 9 C69

10u PWR_FLAG

GND

C11

10u | C72

10u C84

| 10u

-15V

L2

3.3u, 250 mOhms C65

10u | C68
47u | C73
100n VCC | GND

C66
100u

L1
4.7u, 74.8 mOhms C12

10u C67

# 100u D¹⁰ LED GND

C81

1u | U19 MAX6001EUR+T
IN 1 | OUT 2 GND
3 C74
100n | GND
+5VA | U12 LM2940IMP-12
IN 1 | GND
| 2 OUT 3 PAD 4 +12VA C77

47u

-12VA C78

10u U13
LM2990SX-12 GND

1
IN 2 | OUT 3 PAD 4

Rysunek 6: Sekcja zasilania

Jak mo»na zauwa»y¢ z 6, sekcja zasilania skªada si¦ z sze±ciu podsekcji, z których mo»na wyró»ni¢:

1. Sekcj¦ wej±ciow¡.
2. Sekcj¦ rozdzielacza napi¦cia.
3. Sekcj¦ referencji +5 V.
4. Sekcj¦ zasilania +5 V.
5. Sekcj¦ skªadowej staªej +1.25 V.
6. Sekcj¦ LED.

2.2.1 Sekcja wej±ciowa

Sekcja wej±ciowa skªada si¦ z zª¡cza Barrel Jack, do którego wpinane zewn¦trzne zasilanie +15 V pochodz¡ce z przetwornicy impulsowej. Jako, »e przetwornice impulsowe nie sªyn¡ z czystego napi¦cia wyj±ciowego (relatywnie wysoki, typowo w okolicach 200 mV p-p i wysokocz¦stoliwo±ciowy ripple, zale»ny od cz¦stotliwo±ci przeª¡czania przetwornicy), aby zasilanie wyczy±ci¢, zastosowano ltr π, skªadaj¡cy si¦ z buforuj¡cych kondensatorów bezpo±rednio na wej±ciu o sumarycznej pojemno±ci równej 210.1 µF oraz cz¦stotiwo±ci odci¦cia równej:

fc =

1
2π

√
LC
= 2233.8774 Hz | (1)

Wa»ne jest, aby przy projektowaniu tego typu ltrów zapewni¢ tªumienie krytyczne, z którego dla danych parametrów wynika rezystancja cewki okre±lona zale»no±ci¡:

RL =

s
L
C
= 65.9685 mΩ | (2)

Zastosowana cewka posiada wewn¦trzny opór równy 74.8 mΩ, wi¦c zapewniono lekki zapas.

2.2.2 Sekcja rozdzielacza napi¦cia

Sekcja ma za zadanie rozdzieli¢ napi¦cie wej±ciowe na dwa symetryczne zasilania ±12 V. W tym celu, do wygenerowania ujemnego zasilania zastosowano ukªad LTC3261, b¦d¡cy ujemn¡ pomp¡ ªadunków o wydajno±ci pr¡dowej równej 100 mA. Ukªad generuje wysoki ripple (500 kHz, 100 mV p-p), dlatego dla wyj±ciowego napi¦cia wymagana jest ltracja. Tutaj równie», »eby nie generowa¢ strat zastosowano ltr π (fc = 10703.4987 Hz). Wej±ciowe napi¦cie +15 V oraz przeltrowane ujemne napi¦cie −15 V traa nast¦pnie na ukªad dwóch symetrycznych regulatorów LDO (low dropout), zapewniaj¡cych stabilizacj¦ i utrzymanie napi¦cia ±5 V. Z dodatkowych rzeczy w tej sekcji mo»na wyró»ni¢ równie» niezb¦dne dla ka»dego ukªadu kondensatory odsprz¦gaj¡ce, których pojemno±ci wynikaj¡ z dokumentacji ukªadów.

2.2.3 Sekcja referencji

Prosta sekcja napi¦cia referencyjnego skªada si¦ z ukªadu REF195, zapewniaj¡cego bardzo stabilne (dokªadno±¢ ±2 mV) napi¦cie wyj±ciowe +5 V. Ukªad ma maksymaln¡ wydajno±¢ pr¡dow¡ równ¡ 30 mA, co jest wystarczaj¡ce, »eby zapewni¢ referencj¦ dla przetworników, jak i zasilanie dla przetworników AD. Tutaj równie», na bazie dokumentacji ukªadu, zastosowano kondensatory odsprz¦gaj¡ce.

2.2.4 Sekcja zasilania

Celem sekcji jest zapewnienie wysokopr¡dowego zasilania +5 V dla przetworników cyfowoanalogowych, jak i zewn¦trznej jednostki obliczeniowej. W tym celu, dla wej±ciowego napiecia +15 V pochodz¡cego bezpo±rednio z przeltrowanego wej±cia zastosowano ukªad SMPS (Switching Mode Power Supply) skogurowany przez dobór odpowiednich rezystancji, pojemno±ci i induktancji do osi¡gni¦cia napi¦cia wyj±ciowego +6 V. Nie bez powodu zdecydowano si¦ na takie napi¦cie wyj±ciowe, poniewa» ukªady SMPS znane s¡ nieczystego napi¦cia wyj±ciowego (ripple), dlatego »eby napi¦cie wygªadzi¢, wyj±cie przetwornicy przez kondensatory buforuj¡ce podª¡czono do wysokopr¡dowego regulatora LDO, tak, aby osi¡-gno±¢ wysokopr¡dowe, relatywnie czyste napi¦cie +5 V zdolne zasila¢ przetworniki DA i zewn¦trzn¡ jednostk¦ obliczeniow¡.

2.2.5 Sekcja skªadowej staªej

Jak pó¹niej oka»e si¦ w sekcji opisuj¡cej tory analogowe, aby odpowiednio wyskalowa¢ napi¦cie wej±ciowe przetworników, tak aby znalazªo si¦ w ±rodku ich zakresu, odpowiednia jest odpowiednia skªadowa staªa dodawana do zmiennego, wej±ciowego sygnaªu próbkowanego przez przetworniki. Z oblicze« autora wynika, »e musi ona wynosi¢ Uc = 1.25 V i aby taki potencjaª uzyska¢, zastosowano ukªad MAX6001 zapewniaj¡cy referencj¦ napi¦ciow¡ na takim wªa±nie poziomie. Ukªad ma bardzo nisk¡ wydajno±¢ pr¡dow¡, ale w tym przypadku nie jest to istotne. Na wej±cie i wyj±cie ukªadu doªo»one odpowiednie kondensatory odsprz¦gaj¡ce.

2.2.6 Sekcja LED

Sekcja skªada si¦ jedynie z limituj¡cego pr¡d rezystora oraz diody LED, maj¡cej za zadanie poinformowa¢ u»ytkownika, »e zasilanie jest wª¡czone.

44.2k R12

# TL074 R26

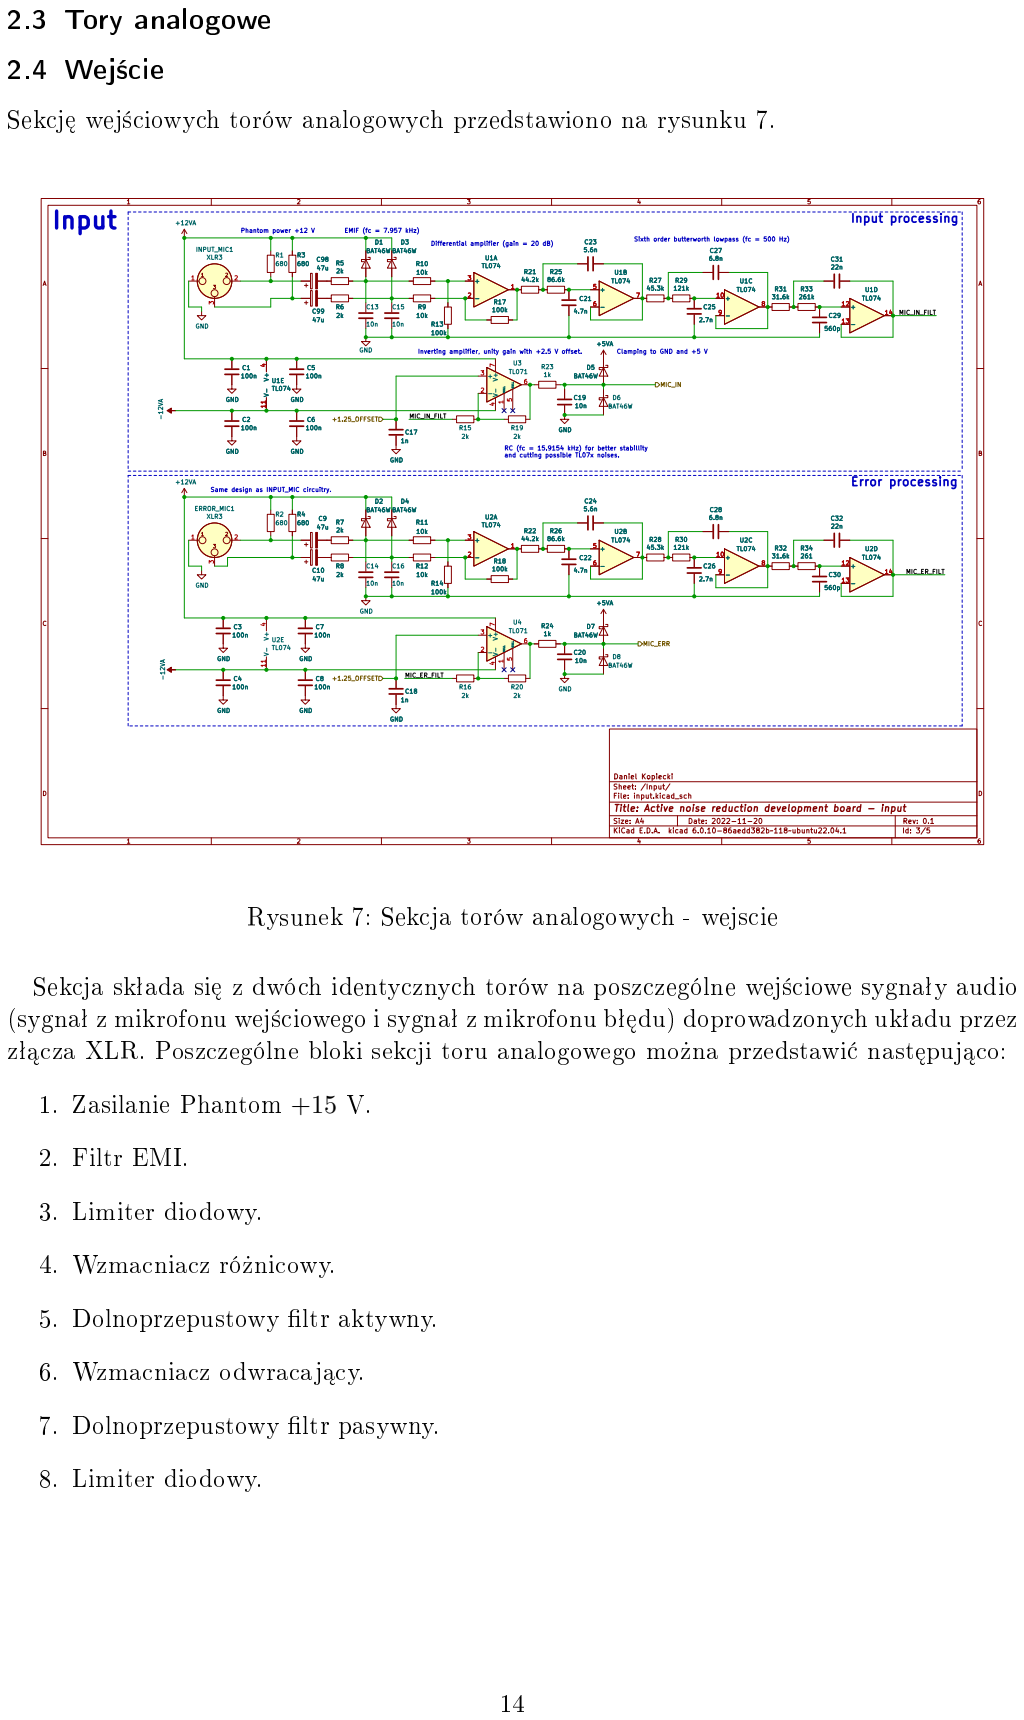
[picture p310: page 14]

Differential amplifier (gain = 20 dB)

Sixth order butterworth lowpass (fc = 500 Hz)

Inverting amplifier, unity gain with +2.5 V offset.

Clamping to GND and +5 V

RC (fc = 15.9154 kHz) for better stabillity
and cutting possible TL07x noises.

Same design as INPUT_MIC circuitry. R4

Sheet: /Input/
File: input.kicad_sch
Id: 3/5 Title: Active noise reduction development board - input

Rysunek 7: Sekcja torów analogowych - wejscie

Sekcja skªada si¦ z dwóch identycznych torów na poszczególne wej±ciowe sygnaªy audio
(sygnaª z mikrofonu wej±ciowego i sygnaª z mikrofonu bª¦du) doprowadzonych ukªadu przez
zª¡cza XLR. Poszczególne bloki sekcji toru analogowego mo»na przedstawi¢ nast¦puj¡co:

2.4.1 Zasilanie Phantom

Mikrofony wykorzystywane w projekcie to wysokojako±ciowe mikrofony pojemno±ciowe Bayerdynamic MM1. Takie mikrofony wymagaj¡ zasilania i ukªad je zapewniaj¡cy nosi nazw¦ zasilania Phantomowego. Wedªug dokumentacji, standardowe +12 V w tym przypadku wystarcza i typowe rezystancje dla takiego napi¦cia to 680 Ω. Dodana skªadowa staªa zostaje nast¦pnie usuni¦ta przez wpi¦te szeregowo kondensatory elektrolityczne tak, aby nie zaburza¢ dalszej pracy ukªadu.

2.4.2 Filtr EMI

Zadaniem dolnoprzepustowego ltru EMI jest niwelacja wysokocz¦stotliwo±ciowych zakªóce« mog¡cych wyst¦powa¢ w surowym sygnale wej±ciowym. Wysokocz¦stotliwo±ciowe skªadowe sygnaªu wej±ciowego ¹le wpªywaj¡ na prac¦ pó¹niejszych wzmacniaczy operacyjnych, posiadaj¡cych niski wska¹nik CMRR (Common Mode Rejection Ratio) dla wysokich cz¦-stotliwo±ci. Aby te skªadowe usun¡¢, zastosowano dolnoprzepustowy ltr EMI z fc = 7.957 Hz.

2.4.3 Limiter diodowy

Zadaniem ukªadu limitera jest, jak sama nazwa wskazuje, ograniczenie napi¦cia do okre-±lonej, staªej warto±ci. W tym przypadku t¡ warto±ci¡ jest +12 V. Ukªad limitera w tym przypadku skªada si¦ z dwóch diod prostowniczych, jednej na jeden tor sygnaªu wej±ciowego (XLR zapewnia sygnaª ró»nicowy, gdzie + i − s¡ odpowiednio odwrócone w fazie wzgl¦dem siebie).

2.4.4 Wzmacniacz ró»nicowy

Ró»nicowy sygnaª ze zª¡cza XLR nale»y przekonwertowa¢ do pojedynczego oraz odpowiednio wzmocni¢, tak, aby znalazª si¦ w ±rodku zakresu przetwornika. Wzmacniacz ró»nicowy deniuje nast¦puj¡ca zale»no±¢:

Uout =

R3
R1
(U2 − U1) | (3)

Dla zastosowanych oporno±ci wzmocnienie zaprojektowanego wzmacniacza wynosi 10, czyli 20 dB. Wyj±ciowy sygnaª jest wi¦c odpowiednio wzmocniony i pozbawiony wej±ciowych zakªóce«, poprzez zastosowanie ró»nicy sygnaªów odwróconych wzgledem siebie w fazie.

2.4.5 Dolnoprzepustowy ltr aktywny

Zaprojektowany ltr do dolnoprzepustowy ltr Butterwortha szóstego rz¦du, z jednostkowym wzmocnieniem i cz¦stotliwo±ci¡ odci¦cia fc = 500 Hz. Jak pisano we wst¦pie, tªumienie haªasów pow»ej 500 Hz mija si¦ z celem. Próbkowanie przetworników oraz cz¦stotliwo±¢ Nyquista z niego wynikaj¡ca wynosi

fp = 1 kHz =⇒ fn =

fp
2
= 500 Hz | (4)

wi¦c zaprojektowany ltr speªnia wymagania dotycz¡ce próbkowania. Charakterystyk¦ amplitudow¡ przedstawiono na rysunku 8


Rysunek 8: Charakterystyka amplitudowa zaprojektowanego ltra

2.4.6 Wzmacniacz odwracaj¡cy

Rol¡, któr¡ peªni w wej±ciowym torze analogowym wzmacniacz odwracaj¡cy jest dodanie odpowiedniej skªadowej staªej do sygnaªu. Jak wspominano w sekcji dotycz¡cej zastosowanych przetworników AD, ±rodek zakresu to +2.5 V. Przed wzmacniaczem napi¦cie powinno oscylowa¢ z amplitud¡ równ¡ +2.5 V, wi¦c jedyne co nale»y dodatkowo zrobi¢, to doda¢ skªadow¡ staª¡ o wysoko±ci amplitudy. Aby to zrobi¢, zastosowano wzmacniacz odwracaj¡cy ze staªym sygnaªem na plusie. W wyniku takiej decyzji, równiania wzmacniacza z zasady superpozycji s¡ zdeniowane:

Uodw =

Rf

Rin

U− = −U− = −Uin | (5)

Unodw = 1 +

Rf

Rin

U+ = 2U+ = 2Uc | (6)

Je»eli Uc = 1.25 V, to z 6 mamy +2.5 V dodanej skªadowej staªej, czyli to, co autor chciaª osi¡gn¡¢.

2.4.7 Dolnoprzepustowy ltr pasywny

Z dokumentacji zastosowanych wzmacniaczy operacyjnych (tanie ukªady TL071) oraz praktyki autora wynika, »e dla lepszej stabilno±ci sygnaªu wyj±ciowego takiego wzmacniacza lepiej bezpo±rednio na jego wyj±ciu da¢ pojedynczy, dolnoprzepustowy ltr pasywny. Takie rozwi¡zanie zapewni lepsz¡ stabilno±¢ wzmacniacza. Zastosowany ltr ma fc = 15.9154

Hz. Bezpo±rednio za ltrem zastosowano ponownie ukªad limitera diodowego, tym razem obcinaj¡cego wyj±cie toru do zakresu przetwornika, czyli +5 V.

2.5 Wyj±cie

Sekcj¦ wyj±ciowych torów analogowych przedstawiono na rysunku 9. 1 | 2 | 3 | 4 | 5 | 6

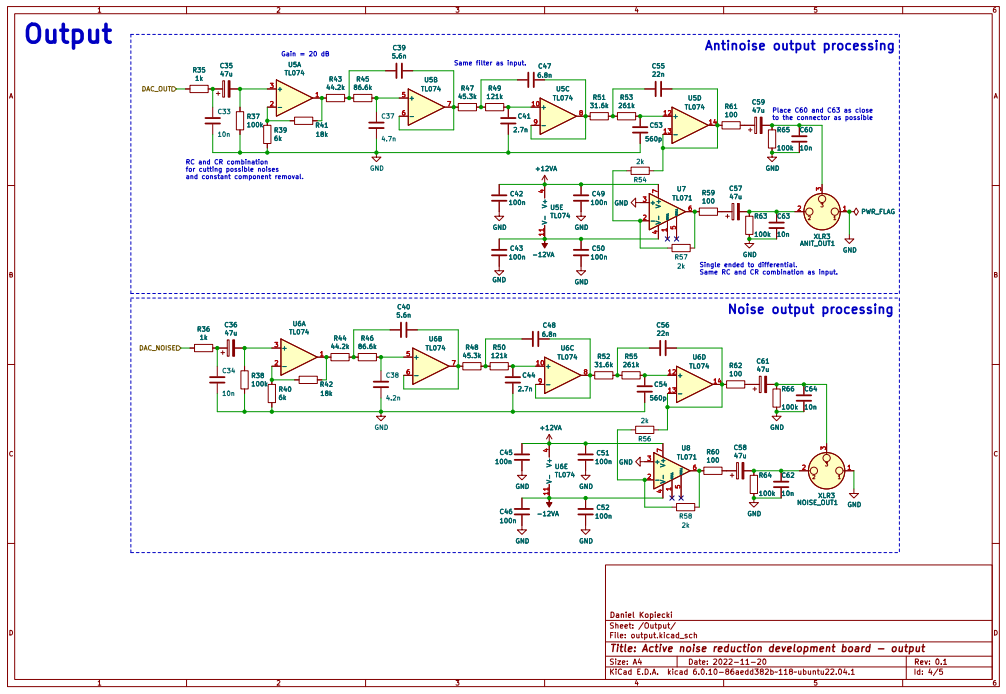
[picture p311: figure]
File: output.kicad_sch; Sheet: /Output/; Daniel Kopiecki GND GND; 100n GND; -12VA C43 100n GND; TL074 GND GND; GND; 100 NULL 1; NULL 5; NULL 1; 3 ANIT_OUT1 XLR3 PWR_FLAG; 10n GND; R63 100kGND; 100 GND; 4.2n GND; 3 NOISE_OUT1 XLR3 GND GND; 100k DAC_NOISE DAC_OUT; Single ended to differential.; Same RC and CR combination as input.; Antinoise output processing; Place C60 and C63 as close to the connector as possible; Noise output processing; Output; Gain = 20 dB RC and CR combination; for cutting possible noises and constant component removal.; Same filter as input.; 100k C59 47u GND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

D Date: 2022-11-20 KiCad E.D.A. kicad 6.0.10-86aedd382b~118~ubuntu22.04.1 Size: A4 | Rev: 0.1
Id: 4/5 Title: Active noise reduction development board - output

Rysunek 9: Sekcja torów analogowych - wyj±cie

Jak mo»na zauwa»y¢ z 9, tory analogowej sekcji wyj±ciowej skªadaj¡ si¦ z nast¦pujacych elementów:

1. Pasywny ltr dolnoprzepustowy i górnoprzepustowy.
2. Wzmacniacz nieodwracaj¡cy.
3. Aktywny ltr dolnoprzepustowy.
4. Sterownik pojedynczy-ró»nicowy.
5. Pasywny ltr dolnoprzepustowy i górnoprzepustowy.

2.5.1 Pasywny ltr dolnoprzepustowy i górnoprzepustowy

Rol¡ zaimplementowanych ltrów jest odci¡cie wysokocz¦stliwo±ciowych znieksztaªce« powstaªych w wyniku dziaªania przetwornika DA oraz mo»liwej skªadowej staªej. Jak wspominano w sekcji wej±ciowych torów analogowych, niski wska¹nik CMRR zastosowanych wzmacniaczy dla wysokich cz¦stotliwo±ci mo»e skutkowa¢ niechciany znieksztaªceniami w dalszej sekcji przetwarzania, je»eli bezpo±rednio na wej ±ciu pojawi¡ si¦ niechciane wysokocz¦stotliwo±ciowe skªadowe.

2.5.2 Wzmacniacz nieodwracaj¡cy

Zastosowany wzmacniacz peªni jedynie rol¦ wzmocnienia i wynosi one tyle samo, ile wynosiªo na wej±ciu (20 dB). Warto wspomnie¢, »e sygnaª wyj±ciowy po przetworzeniu tra na gªo±niki aktywne (ze swoim wbudowanym wzmacniaczem), wi¦c dla prostoty ukªadu zrezygnowano z implementacji wzmacniacza mocy, pozostawiaj¡c jedynie napi¦ciowy.

2.5.3 Aktywny ltr dolnoprzepustowy

Zastosowany ltr rekonstrukcyjny jest identyczny jak w sekcji wej±ciowej. Jest to typowa praktyka przy projektowaniu tego typu ukªadów analogow-cyfrowych.

2.5.4 Sterownik pojedynczy-ró»nicowy

Jako, »e sygnaª wyj±ciowy ma tra¢ na zª¡cza XLR, nale»y zapewni¢ jego ró»nicow¡ reprezentacj¦. W tym celu zastosowano wzmacniacz ró»nicowy, odwracaj¡cy pocz¡tkowy sygnaª wyj±ciowy o π rad. Taka para ró»nicowa traa nast¦pnie na kombinacj¦ ltrów RC i CR, aby zapewni¢ analogicznie lepsz¡ stabilno±¢ ltru oraz odci¦cie mo»liwych zakªóce« sygnaªu wyj±ciowego, pochodz¡cych z sekcji przetwarzania jak i z mo»liwych paso»ytniczych pojemno±ci dªugiego przewodu wyj±ciowego.

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

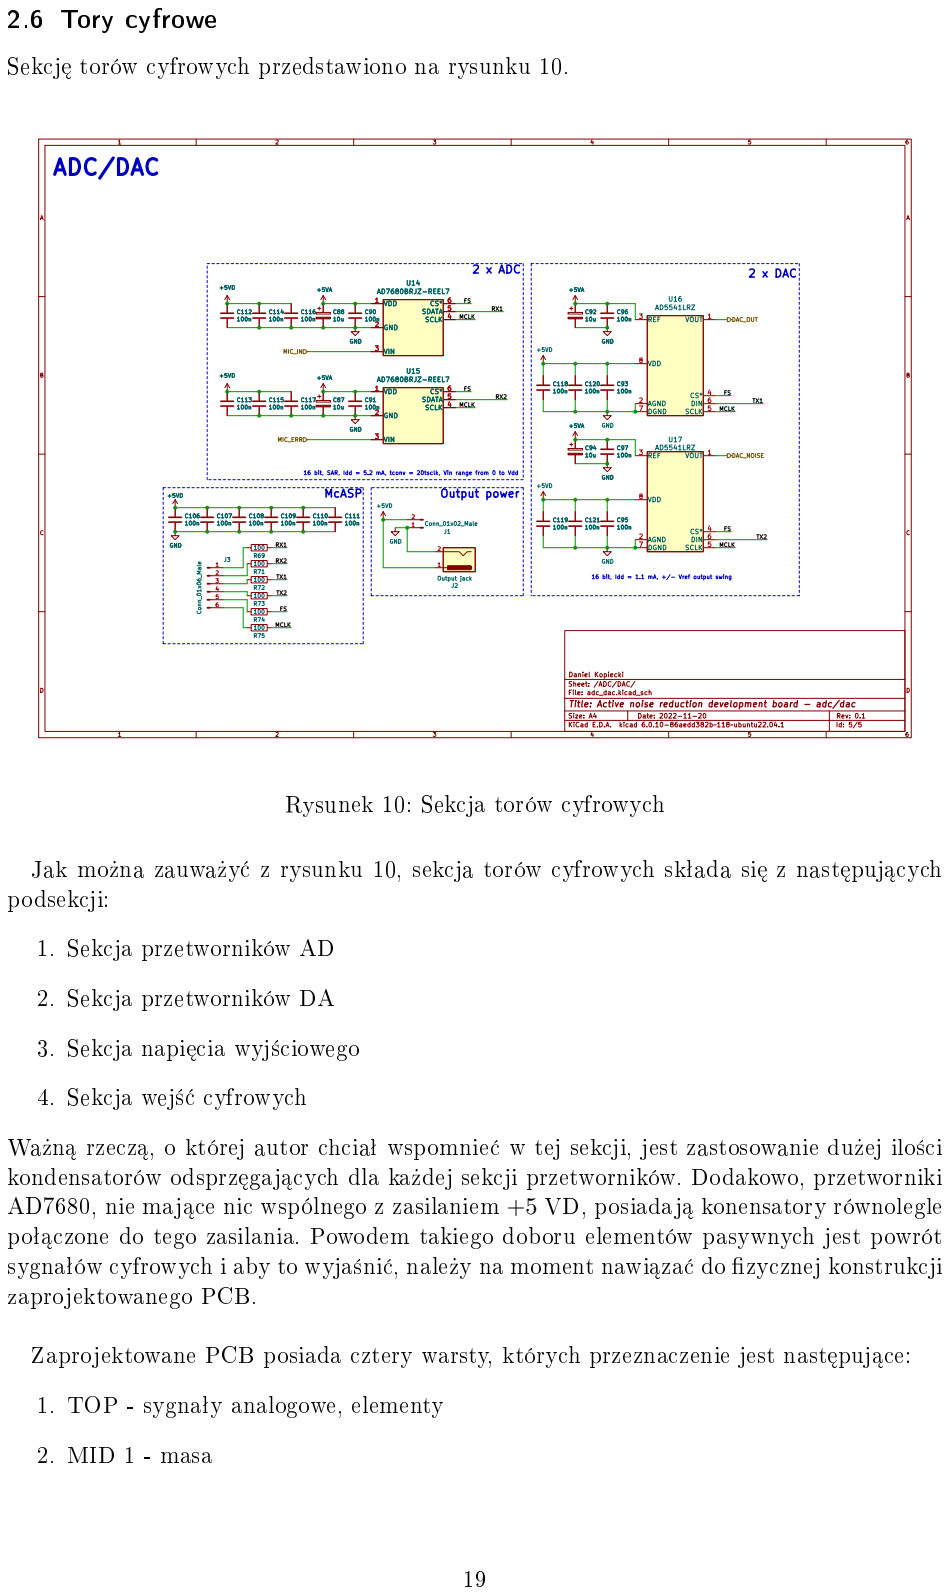
[picture p312: page 19]

3. MID 2 - zasilania
4. BOTTOM - sygnaªy cyfrowe

Jak mo»na wnioskowa¢ z przedstawionego rozmieszczenia, standardowa referencja dla sygnaªów cyfrowych (masa) jest od nich stosunkowo daleko. Z pozycji Henry'ego W. Otta Electromagnetic Capability Engineering mo»na dowiedzie¢ si¦, »e powrotem i referencj¡ dla szybkozmiennych sygnaªów cyfrowych jest masa, ale mo»e te» by¢ warstwa zasilania. Te rozwi¡zanie przedstawiono na rysunku 11.

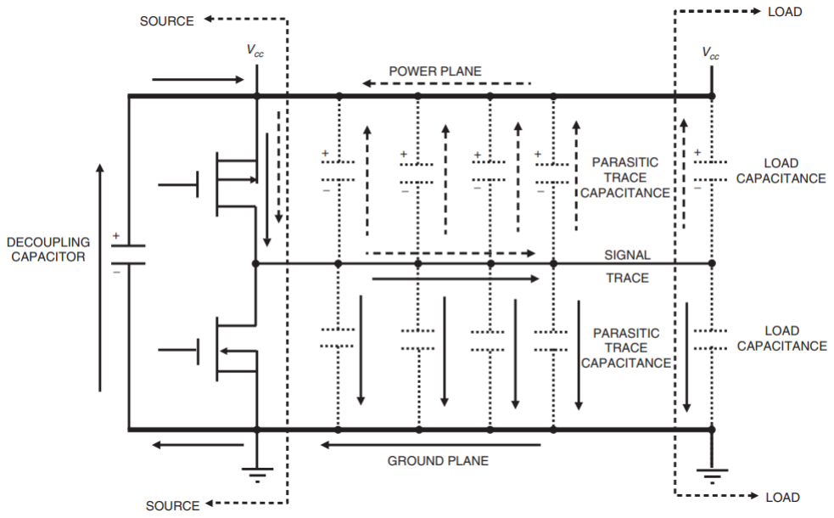
[picture p313: figure]

Rysunek 11: Rozpªyw pr¡dów sygnaªów cyfrowych

W projektowanym przypadku warstwa zasilania jest bezpo±rednio pod sygnaªami cyfrowymi i dobrze jest, aby pr¡dy sygnaªów cyfrowych byªy w stosunku do niej odniesione i ni¡ wracaªy. Aby to uzyska¢, bezpo±rednio pod sygnaªami cyfrowymi wylano pªaszczyzn¦ zasilania +5 VD oraz poª¡czono j¡ przez kondensatory o pojemno±ci 100 nF z wartstw¡ doln¡ w miejsach bardzo bliskich poprowadzonych ±cie»ek. Wynikiem takiego rozwi¡zania jest powrót sygnaªów cyfrowych wªa±nie pªaszczyzn¡ zasilania od docelowych ukªadów, do wej±cia tych sygnaªów, przez które nast¦pnie tra¡ na mas¦ docelowej jednostki obliczeniowej. subsubsectionSekcja przetworników AD Sekcja skªada si¦ z dwóch przetworników analogowo-cyfrowych, AD7680 z kondenstatorami odsprz¦gaj¡cymi oraz doprowadzonymi odpowiednimi sygnaªami. Jak wspominano we wst¦pie tej sekcji implementacji, kondensatory odsprz¦gaj¡ce doª¡czone s¡ równie» w tym przypadku do zasilania +5 VD, aby umo»liwi¢ powrót przez warstw¦ zasilania.

2.6.1 Sekcja przetworników DA

Sekcja skªada si¦ z dwóch przetworników cyfrowo-analogowych AD5541 wraz z kondensatorami odsprz¦gaj¡cymi oraz doprowadzonymi odpowiednimi sygnaªami.

2.6.2 Sekcja napi¦cia wyj±ciowego

Sekcja skªada si¦ ze zª¡cza Barell Jack oraz dwóch standardowych pinów m¦skich, na które doprowadzone jest zasilanie +5 VD oraz mas¦. Ta sekcja ma zadanie zapewni¢ zasilanie gªównej jednostce obliczeniowej.

2.7 Sekcja wej±¢ cyfrowych

Sekcja skªada si¦ z szcze±ciu standardowych pinów m¦skich oraz omawianych wcze±niej kondensatorów poª¡czonych mi¦dzy pªaszczyzna +5 VD, a mas¡. Na liniach sygnaªowych zastosowano równie» rezystory teminuj¡ce, z powodu wysokiego rise-time sygnaªów (unikni¦cie oscylacji na liniach cyfrowych).

## 3 Projekt PCB

Poszczególne sekcje projektu PCB zostaªy umieszczone jako zaª¡cznik i spakowane jako archiwum (plik pcb.zip).

## 4 BOM - bills of materials

Z racji dªugiej listy elementów, lista zostaªa wygenerowana automatycznie z projektu i umieszczona jako zaª¡cznik (plik bom.csv).

## 5 Rezultaty

Uzyskano prototyp przedstawiono na rysunku 12


Rysunek 12: Zdj¦cie zaprojektowanego prototypu

## 6 Bibliograa

W trakcie projektowania ukªadu korzystano z nast¦puj¡cych pozycji

1. Henry W. Ott, Electromagnetic Capabillity Enegineering
2. Horowitz Paul, Hill Windeld, Sztuka Elektroniki, cz. 1 i 2
3. U. Tietze, Ch. Schenk, Ukªady póªprzewodnikowe
4. Tomasz P. Zieli«ski, Cyfrowe przetwarzanie sygnaªów. Od teorii do zastosowa«
5. Noty dokumentacyjne poszczególnych ukªadów
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
