kopiecki/anc/docs/polsl/final/build/main.pdf

# Egzamin dyplomowy

# Układ aktywnego tłumienia hałasu pod nadzorem j ądra systemu Linux z rozszerzeniami real-time

# Daniel Kopiecki

### Politechnika Sl ąska ´

### Wydział Automatyki, Elektroniki i Informatyki

# 18 listopada 2023

Daniel Kopiecki | Politechnika Sl ąska Wydział Automatyki, Elektroniki i Informatyki ´

Egzamin dyplomowy

# Cel pracy

# Skonstruowanie prostego układu aktywnej redukcji hałasu w oparciu o samodzielnie zaprojektowan ą elektronikę, wykorzystuj ąc system operacyjny ogólnego przeznaczenia z j ądrem zawieraj ącym

rozszerzenia do pracy w czasie rzeczywistym.

Projekt układu mozna podzieli ˙ | c na: ´
1 | Częsć sprzętow ą ´ | — płytkę drukowan ą pracuj ąc ą jako
zewnętrzna karta pomiarowa.
2 | Częsć programow ą ´ | — zmodyfikowany system operacyjny wraz

# z aplikacj ą działaj ąc ą w przestrzeni uzytkownika. ˙

Najwazniejsze zało ˙ | zenia projektowe ˙

# Wykonanie analogowego układu elektronicznego w postaci płytki drukowanej, zdolnego do przetworzenia dwóch

wejsciowych i dwóch wyj ´ | sciowych kanałów audio do postaci ´

# cyfrowej wraz z ich dostarczeniem do wybranej jednostki

obliczeniowej.

# Wykorzystanie j ądra wyposazonego w rozszerzenia do pracy w ˙

czasie rzeczywistym wraz z weryfikacj ą ich działania.

# Implementacja aplikacji w przestrzeni uzytkownika realizuj ącej ˙ proces aktywnej redukcji hałasu wraz z narzędziami do testów i

symulacji.

# Wykorzystanie ogólnodostępnych i otwartoźródłowych rozwi ązan.´

# Architektura systemu


## Rysunek: Architektura skonstruowanego systemu

# Częsć sprzętowa ´

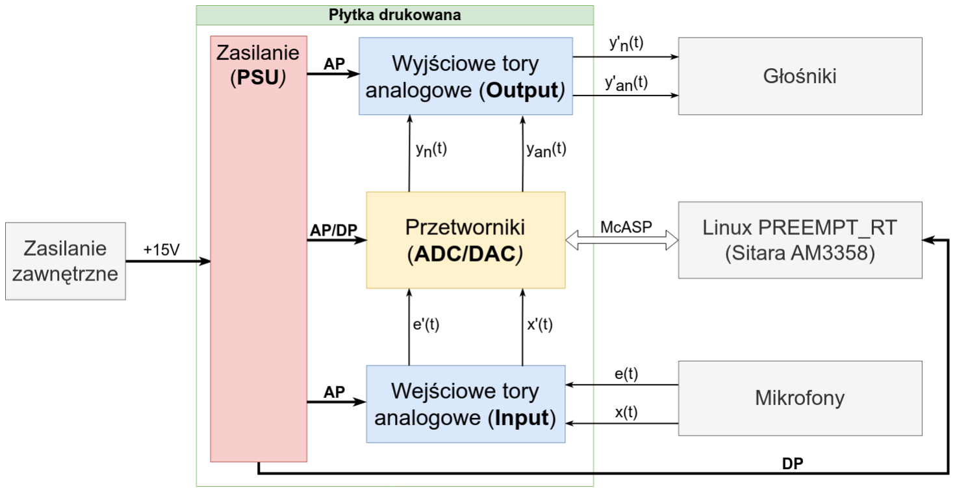
[picture p315: figure]

## Rysunek: Częsć sprzętowa — architektura ´

# Częsć sprzętowa — zasilania ´


## Rysunek: Diagram zasilan czę ´ sci sprzętowej ´

# Częsć sprzętowa — tory analogowe ´

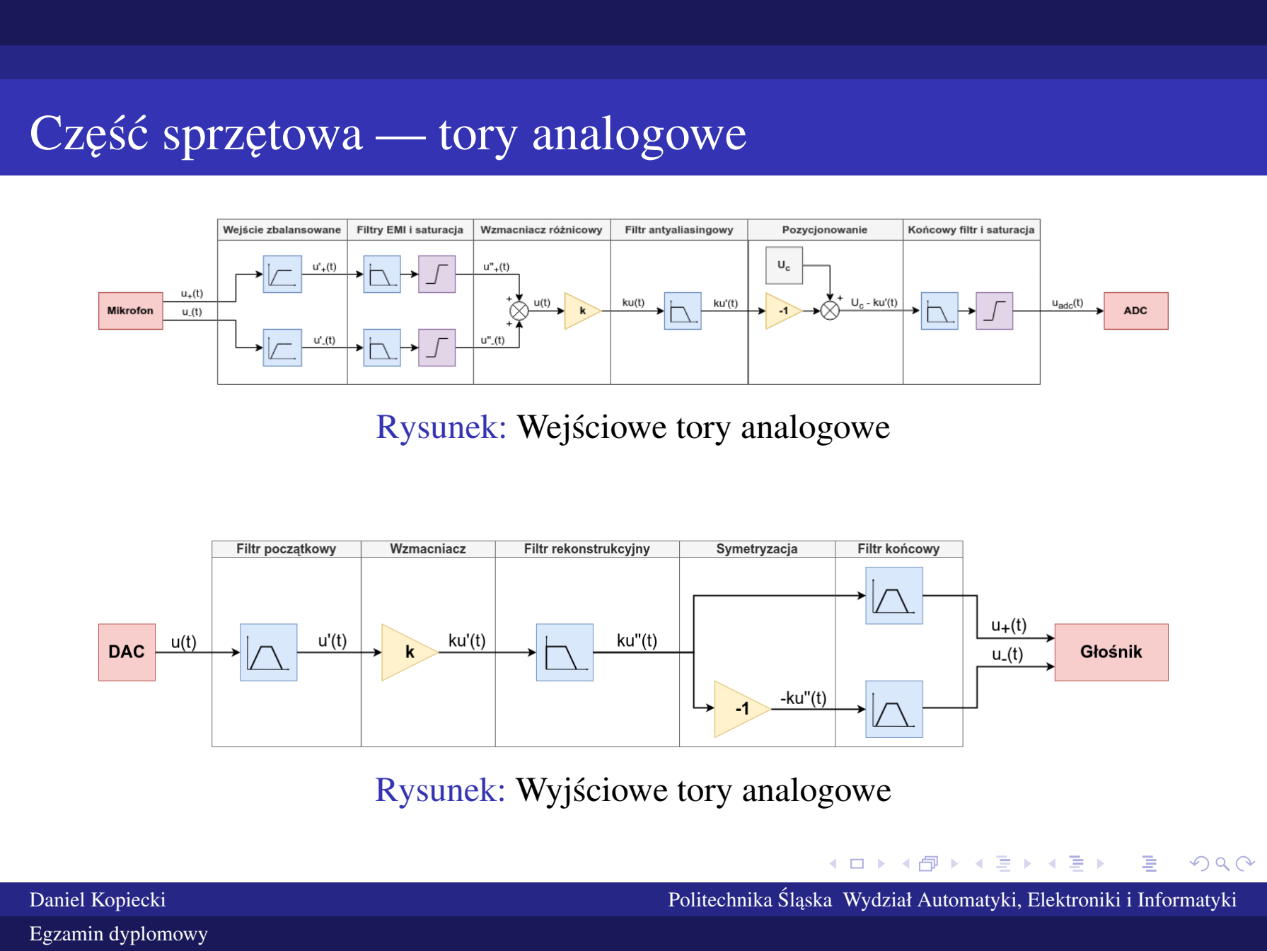
[picture p316: page 7]

## Rysunek: Wejsciowe tory analogowe ´

## Rysunek: Wyjsciowe tory analogowe ´

# Częsć sprzętowa — przetworniki ´

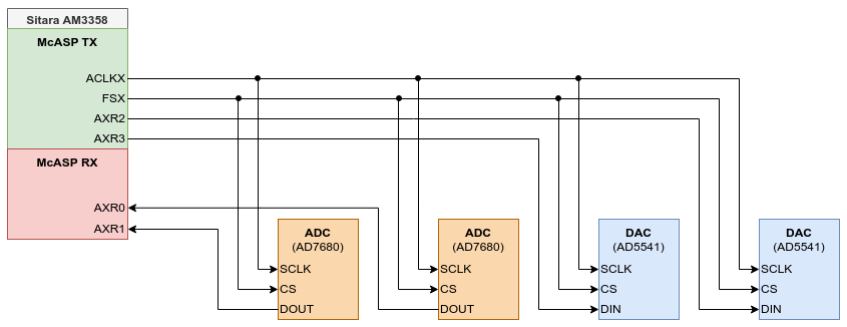
[picture p317: figure]

## Rysunek: Sekcja przetworników

# Częsć programowa ´


## Rysunek: Architektura programowa

# Częsć programowa — aplikacja ´


## Rysunek: Przebieg działania aplikacji

# Rezultaty — karta pomiarowa


## Rysunek: Karta pomiarowa

# Rezultaty — pomiary z wykorzystaniem karty

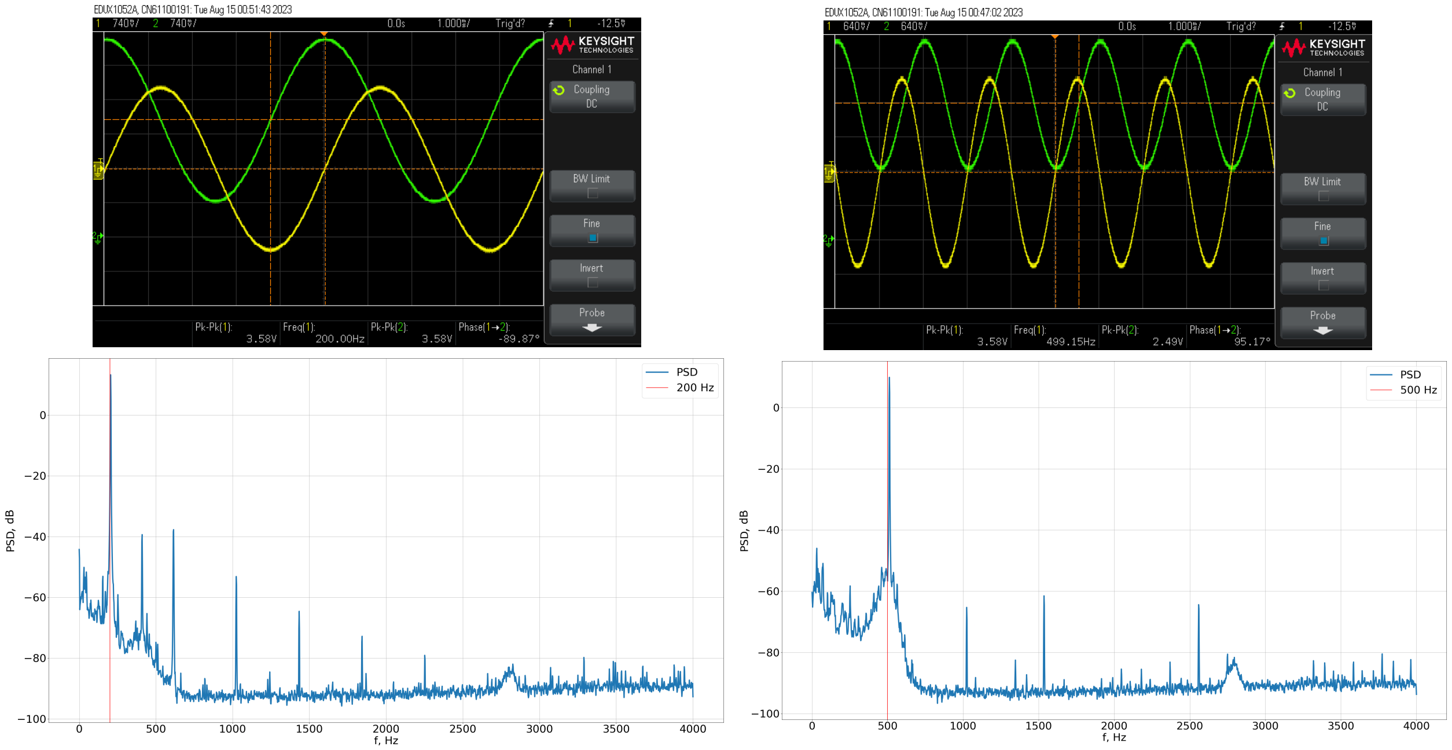
[picture p318: figure]

Rysunek: Sinusoida 200 Hz | Rysunek: Sinusoida 500 Hz

# Stanowisko pomiarowe


## Rysunek: Stanowisko pomiarowe

# Przykładowe przebiegi błedu dla sygnałów testowych

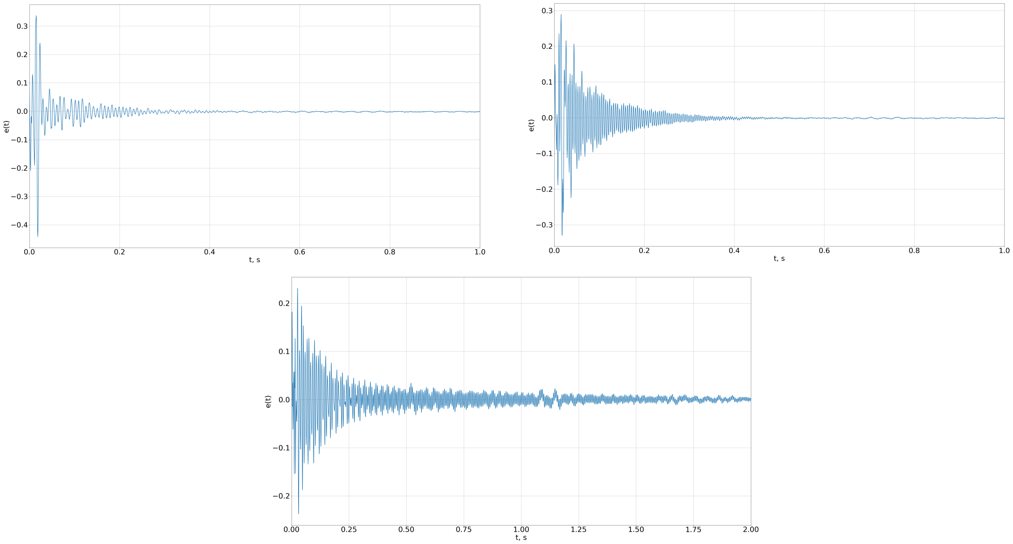
[picture p319: figure]

Rysunek: Przebiegi referencyjne e(n) dla sygnałów testowych.

# Przebiegi błędu — j ądro bez RT

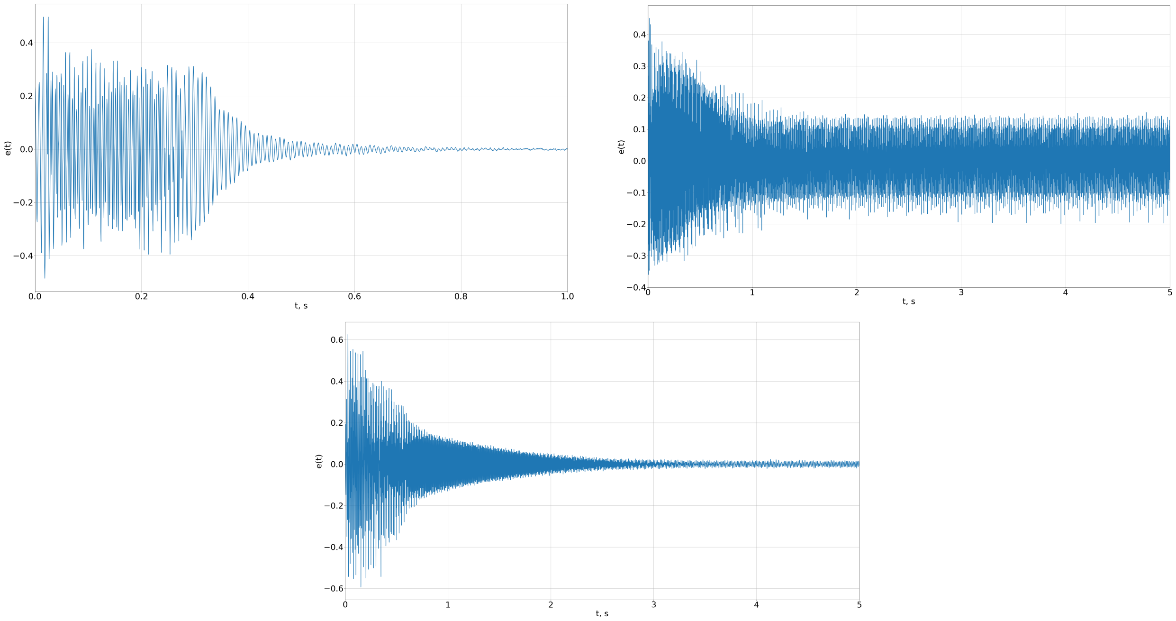
[picture p320: figure]

Rysunek: Przebiegi referencyjne e(n) dla sygnałów testowych.

# Losowe pobudzenia sinusoidalne

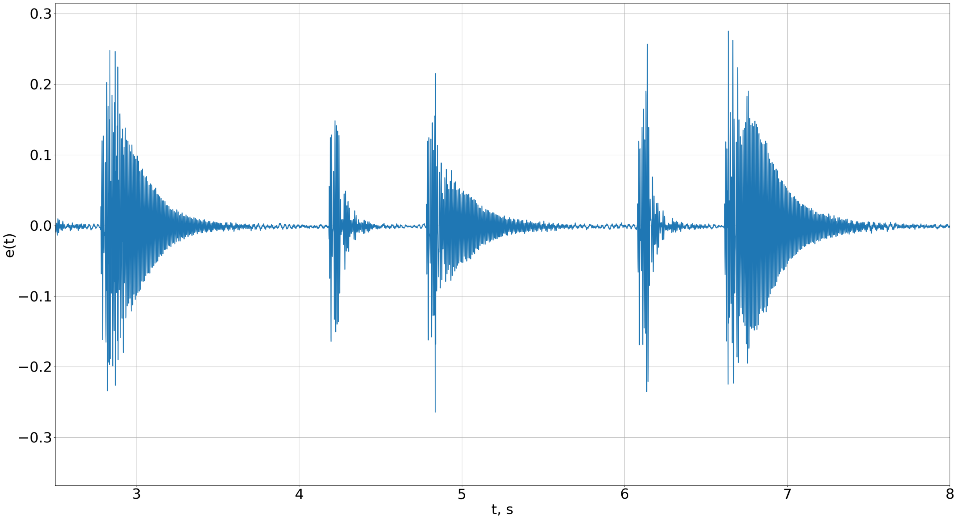
[picture p321: figure]

## Rysunek: Eksperyment — losowe pobudzenia sinusoidalne

# Hałas szerokopasmowy

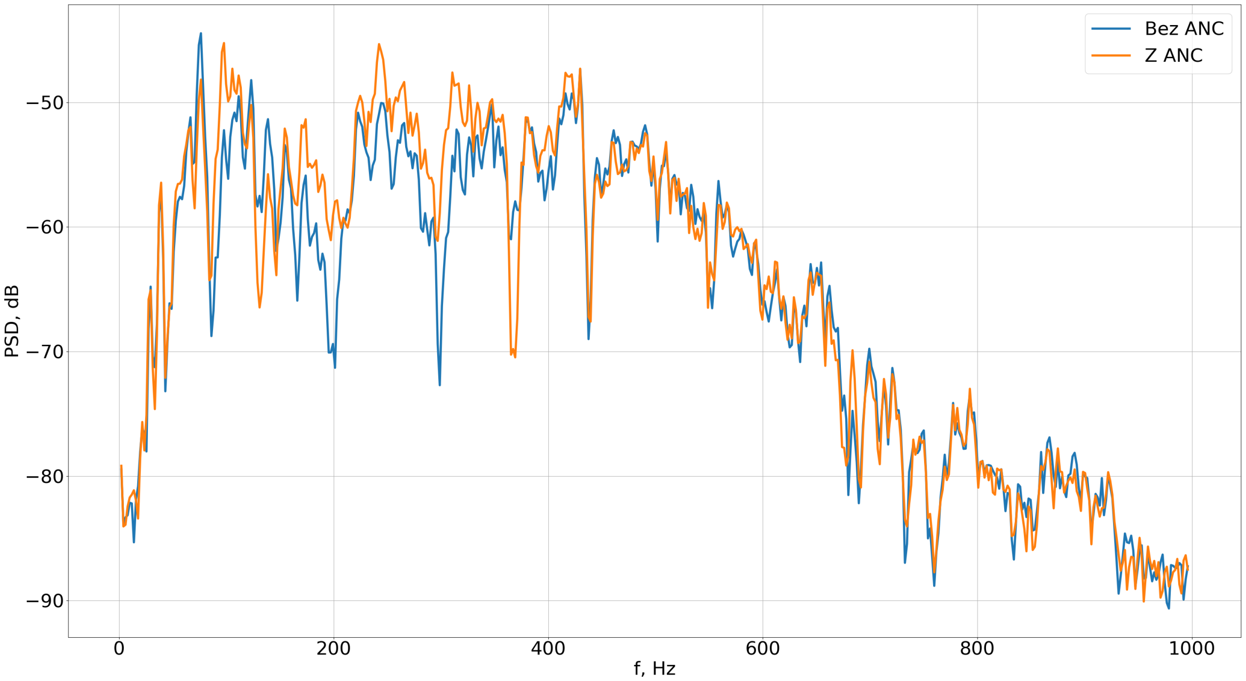
[picture p322: figure]

## Rysunek: Eksperyment — hałas losowy

# Hałasy rzeczywiste — młyny kulowe


## Rysunek: Eksperyment — młyny kulowe

# Hałasy rzeczywiste — pompy wody

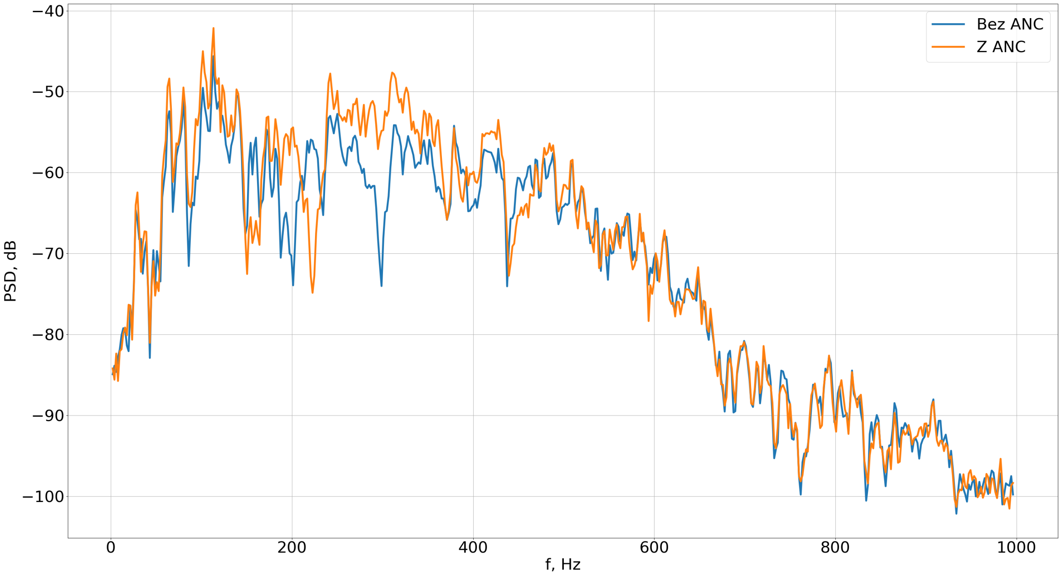
[picture p323: figure]

## Rysunek: Eksperyment — pompy wody

# Badania

Parametry — wielkosć kroku adaptacji, długo ´ | sć filtra, ´
częstotliwosć próbkowania, długo ´ | sć fragmentu, poziom ´
priorytetu, wytyczna planisty.

# Rezultaty — system jest w stanie tłumic sygnały ´ w ąskopasmowe o około 15 dB do załozonego pasma (500 Hz), ˙

jednak nie radzi sobie z szerokopasmowymi.

# Powody — duze opóźnienia, buforowanie, zbyt wolna adaptacja, ˙

latencja systemu operacyjnego.
Mozliwe usprawnienia ˙ | — uproszczenie elektroniki,

# nadpróbkowanie, leaky LMS, urównoleglenie niektórych

operacji.

# Serdecznie dziękuję za uwagę
