kopiecki/anc/docs/polsl/sd2/build/main.pdf

## Seminarium dyplomowe, 2

Układ aktywnego tłumienia hałasu pod nadzorem j ˛adra systemu Linux z rozszerzeniami real-time

Daniel Kopiecki

Politechnika Sl ˛aska ´

22 sierpnia 2023

Daniel Kopiecki (Politechnika Sl ˛aska) ´ | Seminarium dyplomowe, 2 | 22 sierpnia 2023 | 1 / 1

## Aktywne tłumienie hałasu

Główna idea
Aktywne tłumienie hałasu (ang. Active noise control, ANC) polega na niwelowaniu hałasu w oparciu o zasad˛e superpozycji.
Za pomoc ˛a specjalistycznej aparatury elektroakustycznej generowany jest sygnał o takiej samej amplitudzie, lecz przeciwnej fazie do sygnału tłumionego.

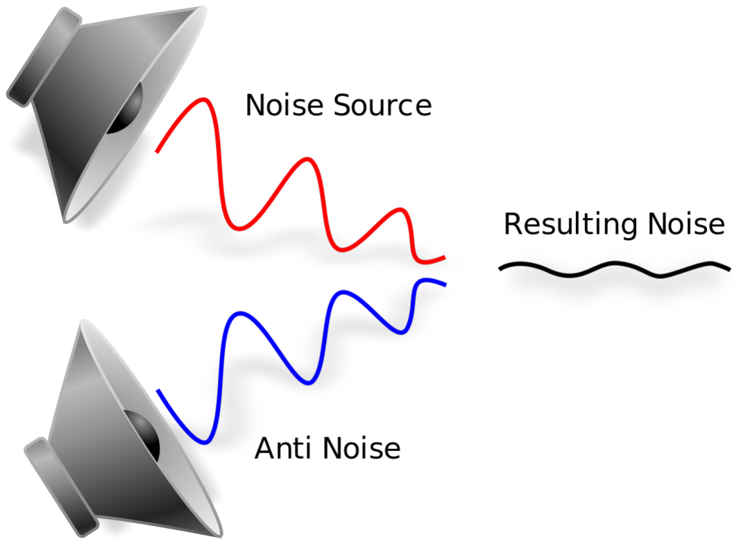
[picture p324: figure]

Rysunek: Główna idea aktywnego tłumienia hałasu

Daniel Kopiecki (Politechnika Sl ˛aska) ´ | Seminarium dyplomowe, 2 | 22 sierpnia 2023 | 2 / 1

Ograniczenia
Aktywne tłumienie hałasu jest stosowane głównie do tłumienia sygnałów o cz˛estotliwosciach relatywnie niskich (zazwyczaj mniejszych ´ niz 500 Hz). ˙
Jest to spowodowane wysok ˛a wydajnosci ˛a i niskimi kosztami ´ zastosowan pasywnych dla tego typu sygnałów (tłumiki, wygłuszacze). ´
Wraz ze wzrostem cz˛estotliwosci tłumionego sygnału ro ´ | snie ´
cz˛estotliwos´c próbkowania projektowanego układu wraz ze ´ skomplikowaniem algorytmiki i modelów matematycznych.

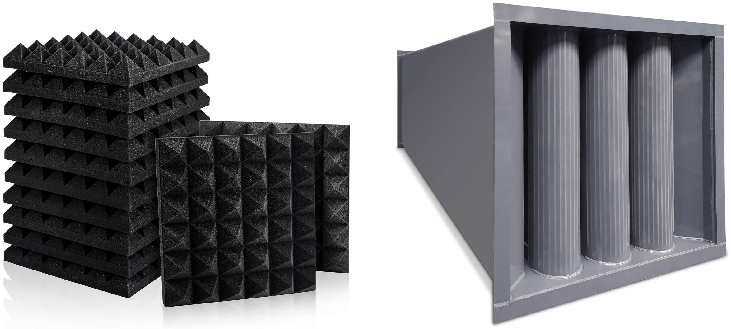
[picture p325: figure]

(a) Pianka akustyczna | (b) Wytłumiacz
Daniel Kopiecki (Politechnika Sl ˛aska) ´ | Seminarium dyplomowe, 2 | 22 sierpnia 2023 | 3 / 1

Zastosowania
Z przykładowych zastosowan mo ´ | zna jednak wyró ˙ | zni ˙ c:´
1 | Przestrzenne, akustyczne ANC:
- Hałas rozchodz ˛acy si˛e kanałami (wentylacja, ogrzewanie, rurociagi)
- Generowanie przestrzennych stref ciszy (hałas w pomieszczeniu)
- Ochrona słuchu
2 | Hydroakustyczne ANC (łowienie ryb, aktywne tłumienie fal wodnych)
3 | Wibracyjne ANC (ang. Active vibration control, AVC)


(a) ANC | (b) AVC
Daniel Kopiecki (Politechnika Sl ˛aska) ´ | Seminarium dyplomowe, 2 | 22 sierpnia 2023 | 4 / 1

Od ogółu do szczegółu

Sposób realizacji aktywnego tłumienia hałasu akustycznego z perspektywy
sterowania mozna podzieli ˙ | c na dwa typy: ´
1 | Sterowanie z p˛etl ˛a sprz˛ezenia w przód (ang. ˙ | feedforward control) -
| sygnał tłumiony jest mierzony bezposrednio przy ´zródle (pomiar ´
referencyjny), przed jego propagacj ˛a wzdłóz toru podstawowego w ˙ kierunku toru wtórnego (wymagane s ˛a dwa czujniki akustyczne).
2 | Sterowanie z p˛etl ˛a sprz˛ezenia w tył (ang. ˙ | feedback control) - sygnał
tłumiony nie jest mierzony przy ´zródle, lecz po propagacji wzdłóz toru ˙ (wymagany jest jeden czujnik akustyczny).
Daniel Kopiecki (Politechnika Sl ˛aska) ´ | Seminarium dyplomowe, 2 | 22 sierpnia 2023 | 5 / 1

Od ogółu do szczegółu
Sterowanie z p˛etl ˛a sprz˛ezenia w przód mo ˙ | zna jednak znowu ˙ | z podzieli ˙ | c na ´
dwa podtypy:
Szerokopasmowe sterowanie z p˛etl ˛a sprz˛ezenia w przód ˙

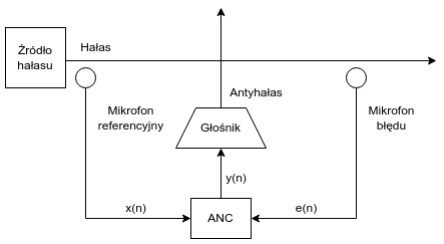
[picture p326: figure]

Rysunek: Szerokopasmowe ANC ze sterowaniem w przód

Daniel Kopiecki (Politechnika Sl ˛aska) ´ | Seminarium dyplomowe, 2 | 22 sierpnia 2023 | 6 / 1

Od ogółu do szczegółu

W ˛askopasmowe sterowanie z p˛etl ˛a sprz˛ezenia w przód ˙

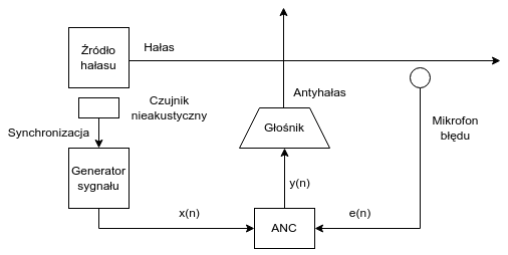
[picture p327: figure]

Rysunek: W ˛askopasmowe ANC ze sterowaniem w przód

Daniel Kopiecki (Politechnika Sl ˛aska) ´ | Seminarium dyplomowe, 2 | 22 sierpnia 2023 | 7 / 1

Od ogółu do szczegółu

Sterowanie z p˛etl ˛a sprz˛ezenia w tył ˙

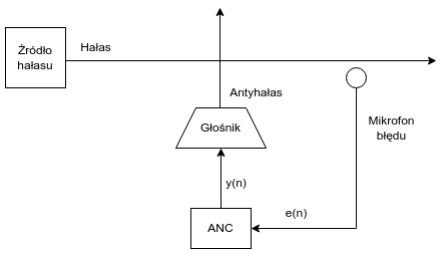
[picture p328: figure]

Rysunek: ANC ze sterowaniem w tył

Daniel Kopiecki (Politechnika Sl ˛aska) ´ | Seminarium dyplomowe, 2 | 22 sierpnia 2023 | 8 / 1

Od ogółu do szczegółu

W ramach projektu realizowane jest:
Szerokopasmowe sterowanie z p˛etl ˛a sprz˛ezenia w przód ˙

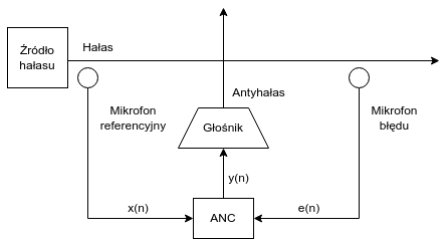
[picture p329: figure]

Rysunek: Szerokopasmowe ANC ze sterowaniem w przód

Zacznijmy wi˛ec omawiac temat w j˛ezyku automatyki. ´

Daniel Kopiecki (Politechnika Sl ˛aska) ´ | Seminarium dyplomowe, 2 | 22 sierpnia 2023 | 9 / 1

Od ogółu do szczegółu

Zaczynamy z jedynie blokiem b˛ed ˛acym modelem toru podstawowego.

Rysunek: Wyprowadzenie schematu, 0

Daniel Kopiecki (Politechnika Sl ˛aska) ´ | Seminarium dyplomowe, 2 | 22 sierpnia 2023 | 10 / 1

Od ogółu do szczegółu

Modelowanie dynamiki w omawianym temacie uogólnione zostaje do
filtrów SOI (skonczona odpowied´z impulsowa, ang. ´ | Finite impulse
response, FIR).
Tego typu modele s ˛a najcz˛esniej stosowane w zagadnieniach zwi ˛azanych ´ z aktywnym tłumieniem hałasu, poniewaz s ˛a zawsze stabilne, ˙ stosunkowo łatwe w implementacji jak i posiadaj ˛a liniow ˛a odpowied´z fazow ˛a.
Daniel Kopiecki (Politechnika Sl ˛aska) ´ | Seminarium dyplomowe, 2 | 22 sierpnia 2023 | 11 / 1

Filtr SOI
Postac filtru SOI (sko ´ | nczona odpowied´z impulsowa) dana jest zale ´ | zno ˙ sci ˛a: ´

W(z

−1

) = Y(z

−1
)
X(z⁻¹)

=

L

X⁻¹

l=0

wlz

−l
(1)

gdzie:
wl - współczynnik filtra o numerze l.
L - rz ˛ad filtra (ilos´c współczynników, długo ´ | s´c odpowiedzi impulsowej) ´
z

−l
- opó´znienie o l próbek
W zwi ˛azku z tym, wyjscie filtra SOI ´ | y(n) dane jest:

y(n) =

L

X⁻¹

l=0

wlx(n − l) =⇒ y(n) = w

T
x(n) | (2)

w =

h
w0 | w1 | · · · wL−1

iT
(3)

x(n) = h
x(n) x(n − 1) · · · x(n − L + 1)

iT
(4)
Daniel Kopiecki (Politechnika Sl ˛aska) ´ | Seminarium dyplomowe, 2 | 22 sierpnia 2023 | 12 / 1

Filtr SOI

Przykładowa implementacja w j˛ezyku C:

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

return y ;
}

Struktura circ_fifo jest kolejk ˛a.
Metoda circ_fifo_peek zwraca najnowsz ˛a próbk˛e opó´znion ˛a o i. Parameter cnt stosowany jest w przypadku wykonywania filtracji na buforach.
Wprowadza dodatkowe opó´znienie ("przesuwa" cał ˛a kolejk˛e).
Daniel Kopiecki (Politechnika Sl ˛aska) ´ | Seminarium dyplomowe, 2 | 22 sierpnia 2023 | 13 / 1

Od ogółu do szczegółu

Uzupełnijmy schemat o elementy pomiarowe i aktuatory.

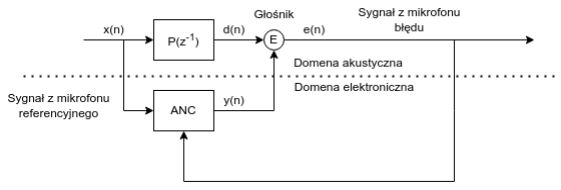
[picture p330: figure]

Rysunek: Wyprowadzenie schematu, 1

Daniel Kopiecki (Politechnika Sl ˛aska) ´ | Seminarium dyplomowe, 2 | 22 sierpnia 2023 | 14 / 1

Od ogółu do szczegółu

Jak wyznaczyc transmitancj˛e ´ | P(z

−1
)?

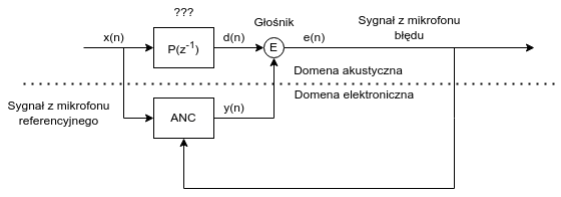
[picture p331: figure]

Rysunek: Wyprowadzenie schematu, 2

Jest to bardzo trudne. Transmitancja P(z

−1
) zmienia si˛e w czasie i zazwyczaj nie sposób przewidziec charakterystyki tych zmian. ´
Daniel Kopiecki (Politechnika Sl ˛aska) ´ | Seminarium dyplomowe, 2 | 22 sierpnia 2023 | 15 / 1

Od ogółu do szczegółu
Jezeli wi˛ec transmitancja ˙ | P(z

−1
) jest zalezna od czasu i nieprzewidywalna, ˙ potrzebny jest mechanizm estymacji jej parametrów na bi˛ez ˛aco. ˙

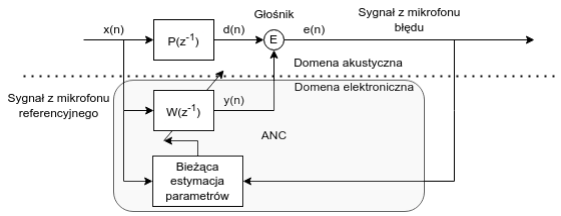
[picture p332: figure]

Rysunek: Wyprowadzenie schematu, 3

Wprowadzamy wi˛ec filtr W(z

−1
| ) b˛ed ˛acy biez ˛ac ˛a estymacj ˛a obiektu ˙ | P(z

−1
).
Jak wyznaczyc bi˛e ´ | zace parametry tego modelu? ˙
Daniel Kopiecki (Politechnika Sl ˛aska) ´ | Seminarium dyplomowe, 2 | 22 sierpnia 2023 | 16 / 1

Algorytm LMS

Jednym z najbardziej znanych algorytmów słuz ˛acej do bi˛e ˙ | z ˛acej ˙
estymacji parametrów modelu jest algorytm LMS (ang. least mean squares).
Opiera si˛e on na zastosowaniu gradientowej metody najnizszego spadku ˙ (ang. method of steepest descent) do minimalizacji bł˛edu sredniokwadratowego. ´
Bł ˛ad w tym przypadku dany jest zalezno ˙ sci ˛a: ´

e(n) = d(n) − y(n) = d(n) − w

T
x(n) | (5)
d(n) to wyjscie estymowanego na bi˛e ´ | zaco, nieznanego modelu (w ˙
analizowanym wypadku nieznanego obiektu P(z

−1
) opisuj ˛acego
dynamik˛e toru podstawowego, którym propaguje si˛e hałas).
y(n) to wyjscie modelu ´ | W(z

−1
).
Daniel Kopiecki (Politechnika Sl ˛aska) ´ | Seminarium dyplomowe, 2 | 22 sierpnia 2023 | 17 / 1

Algorytm LMS
Algorytmy estymuj ˛ace na biez ˛aco parametry modelu nosz ˛a nazw˛e ˙ algorytmów adaptacyjnych, a filtry (modele) powstałe na skutek ich zastosowania filtrami adaptacyjnymi.
Zaniechaj ˛ac wyprowadzania, z literatury w analizowanym przypadku algorytm LMS dany jest nast˛epuj ˛ac ˛a zalezno ˙ sci ˛a: ´
| w(n + 1) = w(n) + µx(n)e(n) | | (6)

w(n) = h
w0(n) w1(n) · · · wL−1(n)

iT
(7)

x(n) = h
x(n) x(n − 1) · · · x(n − L + 1)

iT
(8)

gdzie µ to "krok" algorytmu, który musi spełniac okre ´ slone warunki ´ stabilnosci. ´
Wynikiem działania algorytmu jest wi˛ec nowy wektor współczynników filtra W(z

−1
) (nowa odpowied´z impulsowa).
Daniel Kopiecki (Politechnika Sl ˛aska) ´ | Seminarium dyplomowe, 2 | 22 sierpnia 2023 | 18 / 1

Proces realizacji filtra adaptacyjnego mozna przedstawi ˙ | c nast˛epuj ˛acymi ´
krokami:
1 | Dobranie długosci filtra ´ | W(z −1
) L, kroku µ oraz pocz ˛atkowej odpowiedzi impulsowej w(0).
2 | Obliczenie wyjscia filtra ´ | W(z

−1
) zgodnie z zalezno ˙ sci ˛a: ´

y(n) =

L

X⁻¹

l=0

wl(n)x(n − l) | (9)
3 | Obliczenie bł˛edu:
e(n) = d(n) − y(n) | (10)
4 | Aktualizacja parametrów filtra W(z

−1
) z wykorzystaniem algorytmu LMS:
wl(n + 1) = wl(n) + µx(n − l)e(n), | l = 0, 1, . . . , L − 1 | (11)
Daniel Kopiecki (Politechnika Sl ˛aska) ´ | Seminarium dyplomowe, 2 | 22 sierpnia 2023 | 19 / 1

Od ogółu do szczegółu

Maj ˛ac wi˛ec aparat obliczeniowy do aktualizacji parametrów filtra W(z

−1
)
zaktualizujmy schemat.

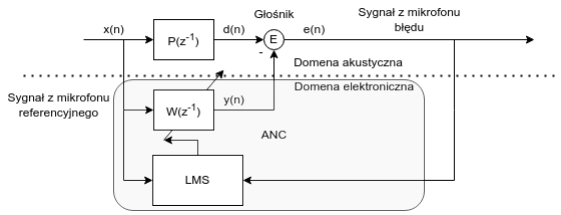
[picture p333: figure]

Rysunek: Wyprowadzenie schematu, 4

Daniel Kopiecki (Politechnika Sl ˛aska) ´ | Seminarium dyplomowe, 2 | 22 sierpnia 2023 | 20 / 1

Analizuj ˛ac schemat, mozna zapisa ˙ | c:´

E(z

−1
) = D(z

−1
) − Y(z

−1
) = P(z

−1
)X(z

−1
) − W(z

−1
)X(z

−1
) | (12)
Idealnie, jezeli ˙ | W(z

−1
) b˛edzie zbiezny, to: ˙

E(z

−1
) = 0 =⇒ P(z

−1
) = W(z

−1
) | (13)

Z czego, gdy X(z

−1
) ̸= 0 wynika:
y(n) = d(n) =⇒ e(n) = d(n) − y(n) = 0 | (14)

Zerowy bł ˛ad swiadczy o idealnym tłumieniu hałasu. ´

Daniel Kopiecki (Politechnika Sl ˛aska) ´ | Seminarium dyplomowe, 2 | 22 sierpnia 2023 | 21 / 1

Od ogółu do szczegółu

Sprawa nie jest jednak tak prosta jak si˛e wydaje.
Komplikacj ˛a jest fakt, ze obydwa sygnały ˙ | x(n) jak i e(n) s ˛a mierzone za
pomoc ˛a czujników akustycznych (mikrofonów), do których sygnał docieraj ˛ac i odchodz ˛ac przebywa pewn ˛a drog˛e.
Dodatkowo, wyjscie liczonego filtra ´ | y(n) jest wstrzykiwane w
srodowisko za pomoc ˛a gło ´ | snika. ´
Wszystkie wyszczególnione tutaj elementy posiadaj ˛a swoj ˛a dynamik˛e i zaniechanie ich opisów powoduje gorsz ˛a zbiezno ˙ s´c algorytmu ´ adaptacyjnego, a co za tym idzie, gorsze tłumienie.
Daniel Kopiecki (Politechnika Sl ˛aska) ´ | Seminarium dyplomowe, 2 | 22 sierpnia 2023 | 22 / 1

Od ogółu do szczegółu
Uzupełnijmy wi˛ec schemat o dodatkowe dynamiki opisane w slajd(n)z

−1

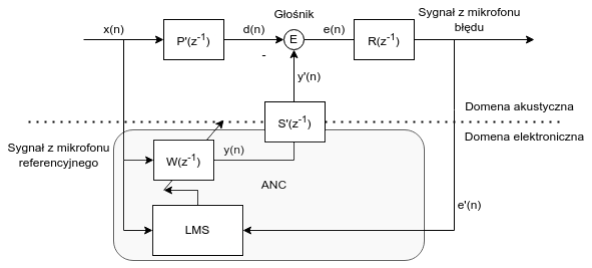
[picture p334: figure]

Rysunek: Wyprowadzenie schematu, 5

S

′
(z

−1
) reprezentuje dynamik˛e toru od wyjscia filtra adaptacyjnego ´
W(z

−1
) do "w˛ezła sumacyjnego" w domenie akustycznej (układ DA, filtr
rekonstrukcyjny, wzmacniacz mocy, głosnik, tor d´zwi˛eku z gło ´ | snika). ´
R(z

−1
) reprezentuje dynamik˛e toru od "w˛ezła sumacyjnego" w domenie
akustycznej do wejscia filtra adaptycjnego ´ | W(z

−1
) (tor akustyczny do
mikrofonu bł˛edu, filtr antyaliasingowy, układ AC).
Daniel Kopiecki (Politechnika Sl ˛aska) ´ | Seminarium dyplomowe, 2 | 22 sierpnia 2023 | 23 / 1

Od ogółu do szczegółu

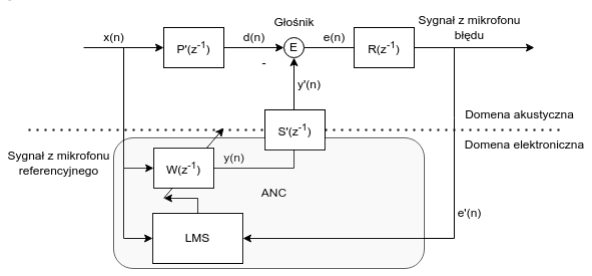
[picture p335: figure]

Rysunek: Wyprowadzenie schematu, 5

Transmitancj˛e toru podstawowego (ang. primary path) mozna wi˛ec ˙ teraz zapisac:´
P(z

−1
) = P

′
(z

−1
)R(z

−1
) | (15)

Uwzgl˛ednienie nowych dynamik powoduje wprowadzenie poj˛ecia transmitancji toru wtórnego (ang. secondary path):

S(z

−1
) = S

′
(z

−1
)R(z

−1
) | (16)
Daniel Kopiecki (Politechnika Sl ˛aska) ´ | Seminarium dyplomowe, 2 | 22 sierpnia 2023 | 24 / 1

Od ogółu do szczegółu

Rysunek: Wyprowadzenie schematu, 5

W tym przypadku, bł ˛ad E(z

−1
) zdefiniowany jest nast˛epuj ˛aco:

E(z

−1
) = R(z

−1
)[P

′
(z

−1
) − S

′
(z

−1
)W(z

−1
)]X(z

−1
) | (17)
Daniel Kopiecki (Politechnika Sl ˛aska) ´ | Seminarium dyplomowe, 2 | 22 sierpnia 2023 | 25 / 1

Od ogółu do szczegółu

Rysunek: Wyprowadzenie schematu, 5

I tutaj równiez, je ˙ | zeli ˙ | W(z

−1
) jest zbiezne, to: ˙

E(z

−1
) = 0 =⇒ W(z

−1

) = P

′
(z

−1
)
S

′(z⁻¹)

(18)

Wynika z tego, ze filtr adaptacyjny ˙ | W(z

−1
) musi nie tylko na bi˛ez ˛aco ˙
estymowac parametry transmitancji toru ´ | P

′
(z

−1
), ale równiez odwraca ˙ | c´
transmitancj˛e toru S

′
(z

−1
).
Daniel Kopiecki (Politechnika Sl ˛aska) ´ | Seminarium dyplomowe, 2 | 22 sierpnia 2023 | 26 / 1

Od ogółu do szczegółu

Rysunek: Wyprowadzenie schematu, 5

Niemozliwym jest jednak kompensowa ˙ | c opó´znienie ´ | S

′
(z

−1
), jezeli ˙
P

′
(z

−1
) nie zawiera przynajmniej takiego samego lub mniejszego. Jest to znacz ˛ace ograniczenie szerokopasmowych systemów ANC ze sprz˛ezeniem w przód. ˙
Dodatkowo, jezeli istnieje taka cz˛estotliwo ˙ | s´c, dla której ´ | S

′
(ω) = 0, to
filtr adaptacyjny staje si˛e niestabilny.
Daniel Kopiecki (Politechnika Sl ˛aska) ´ | Seminarium dyplomowe, 2 | 22 sierpnia 2023 | 27 / 1

Od ogółu do szczegółu

Upros´cmy jednak schemat, bazuj ˛ac na obserwacji, ze tor ´ | P(z

−1
) jak i
S(z

−1
) posiadaj ˛a wspólny składnik w postaci transmitancji R(z

−1
).

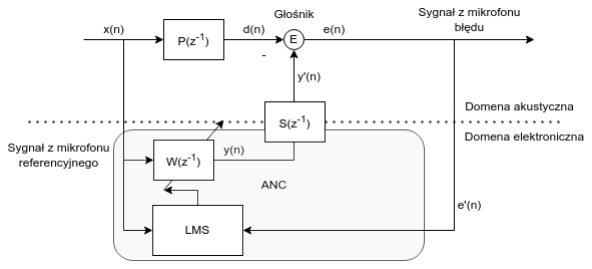
[picture p336: figure]

Rysunek: Wyprowadzenie schematu, 6

Daniel Kopiecki (Politechnika Sl ˛aska) ´ | Seminarium dyplomowe, 2 | 22 sierpnia 2023 | 28 / 1

Od ogółu do szczegółu

Rysunek: Wyprowadzenie schematu, 6

W takim przypadku bł ˛ad E(z

−1
) dany jest:

E(z

−1
) = [P(z

−1
) − S(z

−1
)W(z

−1
)]X(z

−1
) | (19)

W(z

−1

) = P(z

−1
)
S(z⁻¹)
| (20)
Daniel Kopiecki (Politechnika Sl ˛aska) ´ | Seminarium dyplomowe, 2 | 22 sierpnia 2023 | 29 / 1

Od ogółu do szczegółu

Filtr adaptacyjny musi modelowac wi˛ec zale ´ | zno ˙ s´c´ P(z

−1
) jak i S(z

−1
)

−1

Jest to bardzo trudne zadanie. Modelowanie S(z

−1
)

−1
za pomoc ˛a filtru SOI prowadzi do relatywnie
długich rz˛edów. Dodatkowo, jezeli filtr ˙ | S(z

−1
) posiada własciwo ´ sci ´ pasmowozaporowe dla pewnych cz˛estotliwos´ci, ich wytłumienie w ´
koncowym rozrachunku mo ´ | ze okaza ˙ | c si˛e niemo ´ | zliwe. ˙
Jezeli opó´znienie ˙ | P(z

−1
) nie jest mniejsze lub równe opó´znieniu S(z

−1
),
zadania tego nie sposób zrealizowac.´
Czy istnieje zatem jakis sposób, ´ | zeby kompensowa ˙ | c wpływ ´ | S(z

−1
) i
adaptowac si˛e jedynie do zmieniaj ˛acej si˛e charakterystki toru ´ podstawowego P(z

−1
)?
Daniel Kopiecki (Politechnika Sl ˛aska) ´ | Seminarium dyplomowe, 2 | 22 sierpnia 2023 | 30 / 1

Od ogółu do szczegółu

Spróbujmy przeanalizowac spraw˛e z punktu widzenia algorytmu LMS: ´ Bład w takiej sytuacji dany jest:

e(n) = d(n) − y

′
(n) = d(n) − s

T
(n)y(n) | (21)

e(n) = d(n) − y

′
(n) = d(n) − s

T
(n)[w

T
(n)x(n)] | (22)

w(n) = h
w0(n) w1(n) · · · wLw−1(n)

iT
| (23)

s(n) = h
s0(n) s1(n) · · · sLs−1(n)

iT
| (24)

x(n) = h
x(n) x(n − 1) · · · x(n − Lw + 1)

iT
| (25)
Daniel Kopiecki (Politechnika Sl ˛aska) ´ | Seminarium dyplomowe, 2 | 22 sierpnia 2023 | 31 / 1

Alogrytm FXLMS

Jezeli dla takiego bł˛edu ˙ | e(n) wyprowadzimy algorytm LMS, otrzymamy:
w(n + 1) = w(n) + µx’(n)e(n) | (26)

x’(n) = s

T
(n)x(n) | (27)

Niestety nie znamy odpowiedzi impulsowej s

T
(n), jednak zakładaj ˛ac, ze˙
tor wtórny jest duzo mniej skomplikowany i zmienny ni ˙ | z tor ˙
podstawowy, mozemy zidentyfikowa ˙ | c t˛e odpowied´z nieadaptacyjnie ´
aparatem identyfikacji procesów.
w(n + 1) = w(n) + µx’(n)e(n) | (28)

x’(n) = ˆs

T
(n)x(n) | (29)

Tak zmodyfikowany algorytm LMS nosi nazw˛e algorytmu FXLMS, od
filtracji wejscia (ang. ´ | filtered-x least means squares).
Daniel Kopiecki (Politechnika Sl ˛aska) ´ | Seminarium dyplomowe, 2 | 22 sierpnia 2023 | 32 / 1

Od ogółu do szczegółu

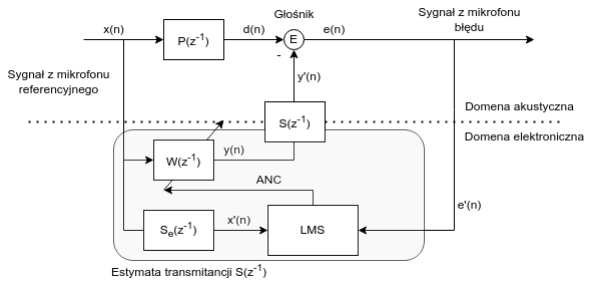
[picture p337: figure]

Rysunek: Wyprowadzenie schematu, FXLMS

Daniel Kopiecki (Politechnika Sl ˛aska) ´ | Seminarium dyplomowe, 2 | 22 sierpnia 2023 | 33 / 1

Od ogółu do szczegółu

Jak identyfikowac´ S(z

−1
)?
Mozna to robi ˙ | c aktywnie i ´ | pasywnie.
Z pasywnych metod mozna wyró ˙ | zni ˙ c:´
- Identyfikacj˛e odpowiedzi impulsowej metod ˛a korelacyjn ˛a:
| | ˆs(n) = Rxy(n)
λ²

(30)

W tym przypadku na wejscie identyfikowanego obiektu podajemy biały ´
| szum o wariancji λ

2
. Liczymy funkcj˛e korelacji wejscia z wyj ´ | sciem, a ´
nast˛epnie dzielimy j ˛a przez wariancj˛e λ

2
Z perspektywy ANC, puszczany jest biały szum z głosnika maj ˛acego ´
emitowac antyhałas. Jest on próbkowany wraz z wyj ´ | sciem, czyli sygnałem ´
nagranym przy pomocy mikrofonu błedu. Tak powstałe wektory
pomiarowe słuz ˛a nast˛epnie do wyznaczenia zale ˙ | zno ˙ s´c´ ˆs(n).
Daniel Kopiecki (Politechnika Sl ˛aska) ´ | Seminarium dyplomowe, 2 | 22 sierpnia 2023 | 34 / 1

Od ogółu do szczegółu

Wykorzystanie doswiadczalnego estymatora transmitancji: ´

Sˆ(jω) = Yˆ(jω)
Xˆ(jω)

(31)

Liczona jest transformata Fouriera wejscia i wyj ´ | scia, a nast˛epnie ´
transformaty s ˛a przez siebie dzielone. Zalezno ˙ s´c´ ˆs(n) otrzymujemy poprzez zastosowanie odwrotnej transformaty na zalezno ˙ sci ´ Sˆ(jω).

Zastosowanie algorytmu LMS. Obserwowanie aktualizowanych parametrów i zatrzymanie obliczen w przypadku, kiedy osi ˛agn ˛a one ´ odpowiedni poziom zbiezno ˙ sci. ´

Daniel Kopiecki (Politechnika Sl ˛aska) ´ | Seminarium dyplomowe, 2 | 22 sierpnia 2023 | 35 / 1

Od ogółu do szczegółu
Posiadaj ˛ac zidentyfikowan ˛a odpowied´z impulsow ˛a ˆs(n), proces implementacji algorytmu FXLMS realizuj ˛acego zadanie aktywnego tłumienia hałasu mozna ˙ opisac nast˛epuj ˛aco: ´
Zebrac sygnały ´ | x(n) i e(n) z mikrofonu referencyjnego i bł˛edu.
Obliczyc antyhałas zgodnie z zale ´ | zno ˙ sci ˛a: ´

y(n) =

L

Xw−1

l=0

wl(n)x(n − l) | (32)
Pusci ´ c antyhałas ´ | y(n) na głosniku. ´
Przefiltrowac sygnał ´ | x(n) przez zidentyfikowan ˛a odpowied´z impulsow ˛a
ˆs(n).

x

′
(n) =

L

Xs−1

l=0

ˆsl(n)x(n − l) | (33)
Daniel Kopiecki (Politechnika Sl ˛aska) ´ | Seminarium dyplomowe, 2 | 22 sierpnia 2023 | 36 / 1

Od ogółu do szczegółu

Zaktualizowac parametru filtru adaptacyjnego ´ | W(z

−1
) zgodnie z
algorytmem FXLMS:

wl(n + 1) = wl(n) + µx

′
(n − l)e(n) | (34)
Powtórzyc wy ´ | zej przedstawiony proces dla kolejnej iteracji. ˙
Daniel Kopiecki (Politechnika Sl ˛aska) ´ | Seminarium dyplomowe, 2 | 22 sierpnia 2023 | 37 / 1

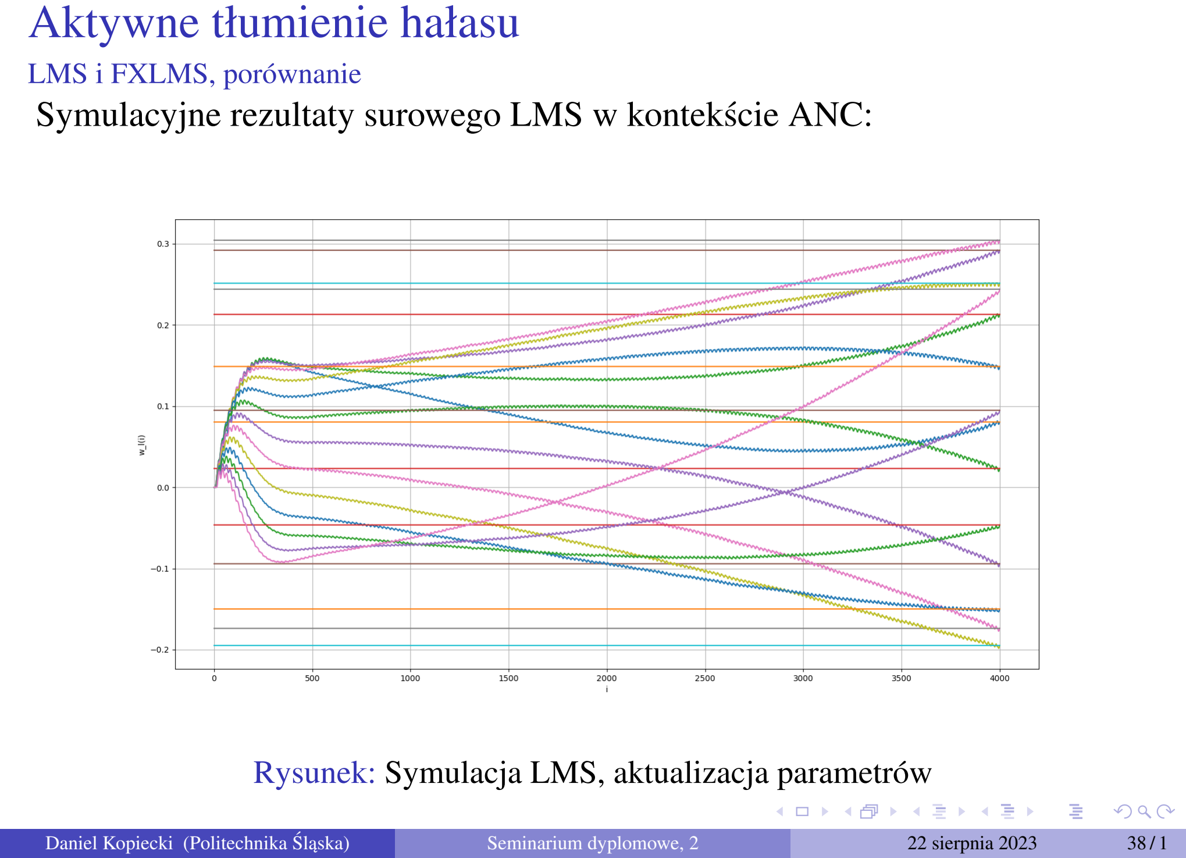
[picture p338: page 38]

LMS i FXLMS, porównanie
Symulacyjne rezultaty surowego LMS w kontekscie ANC: ´

Rysunek: Symulacja LMS, aktualizacja parametrów

Daniel Kopiecki (Politechnika Sl ˛aska) ´ | Seminarium dyplomowe, 2 | 22 sierpnia 2023 | 38 / 1

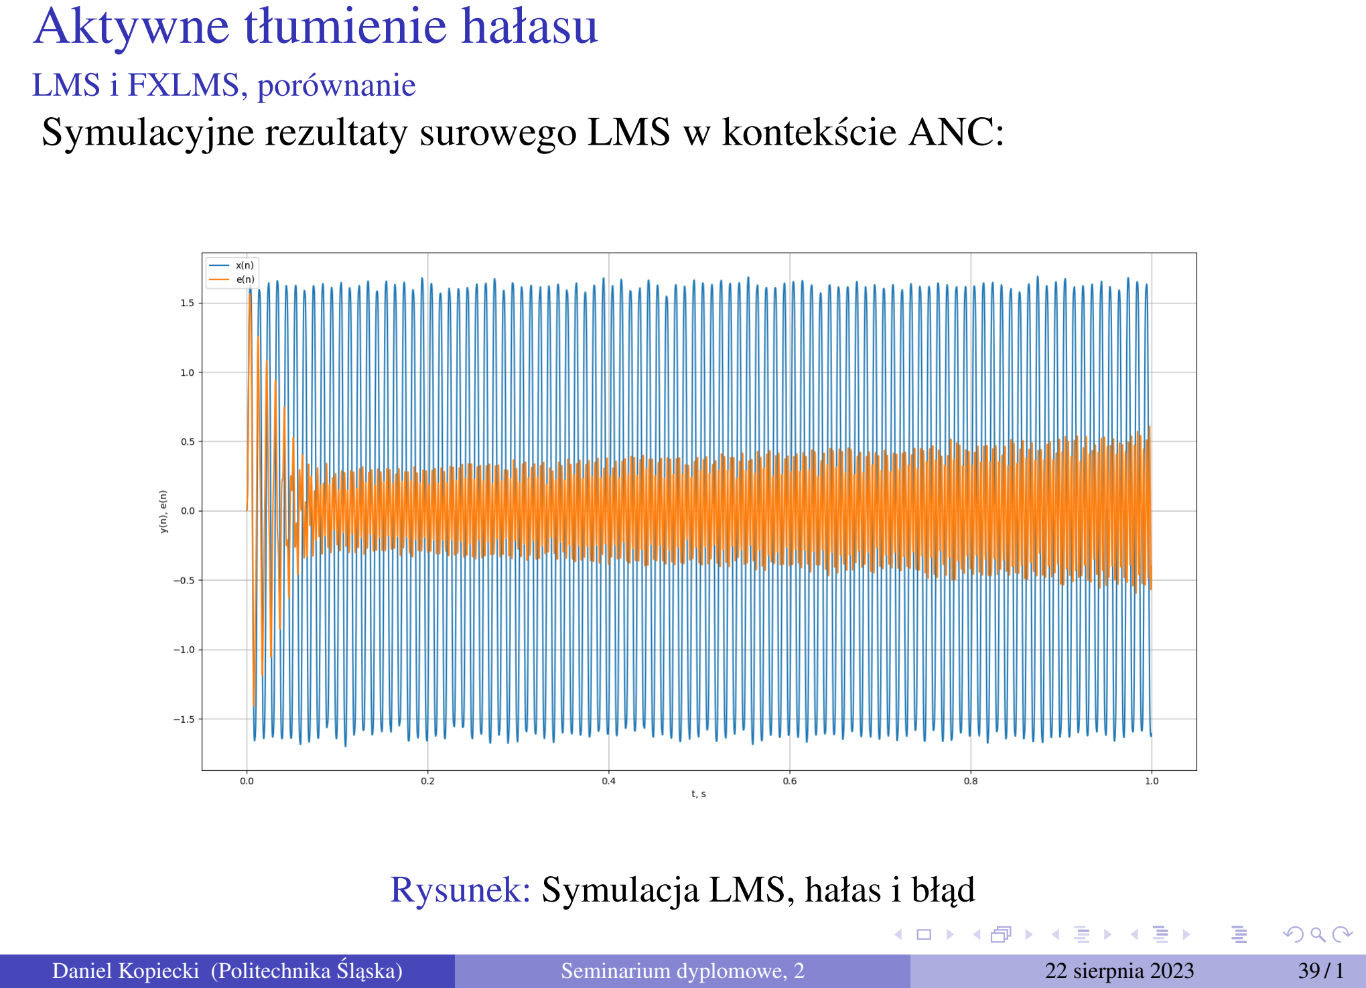
[picture p339: page 39]

LMS i FXLMS, porównanie
Symulacyjne rezultaty surowego LMS w kontekscie ANC: ´

Rysunek: Symulacja LMS, hałas i bł ˛ad

Daniel Kopiecki (Politechnika Sl ˛aska) ´ | Seminarium dyplomowe, 2 | 22 sierpnia 2023 | 39 / 1

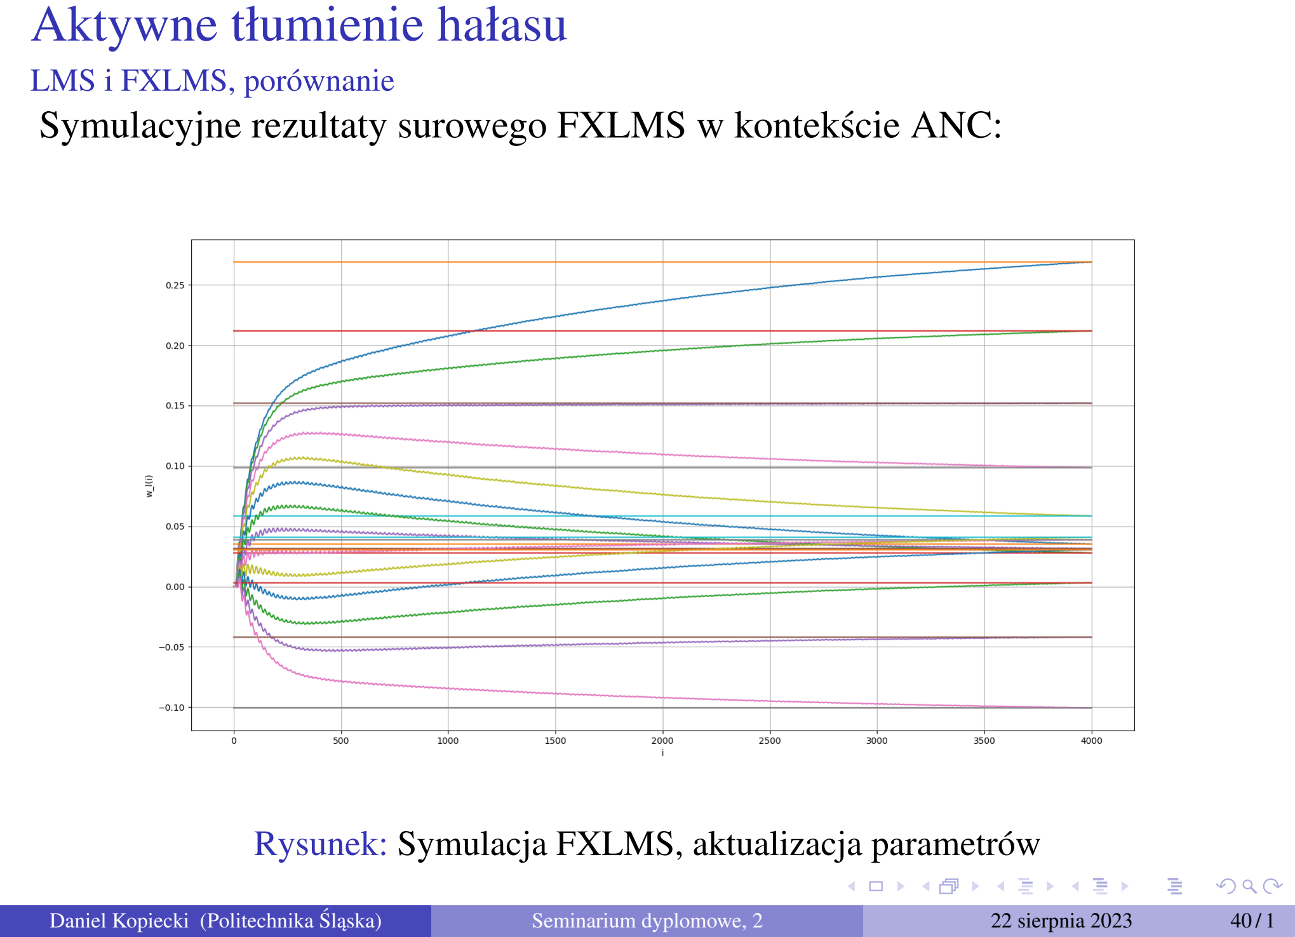
[picture p340: page 40]

LMS i FXLMS, porównanie
Symulacyjne rezultaty surowego FXLMS w kontekscie ANC: ´

Rysunek: Symulacja FXLMS, aktualizacja parametrów

Daniel Kopiecki (Politechnika Sl ˛aska) ´ | Seminarium dyplomowe, 2 | 22 sierpnia 2023 | 40 / 1

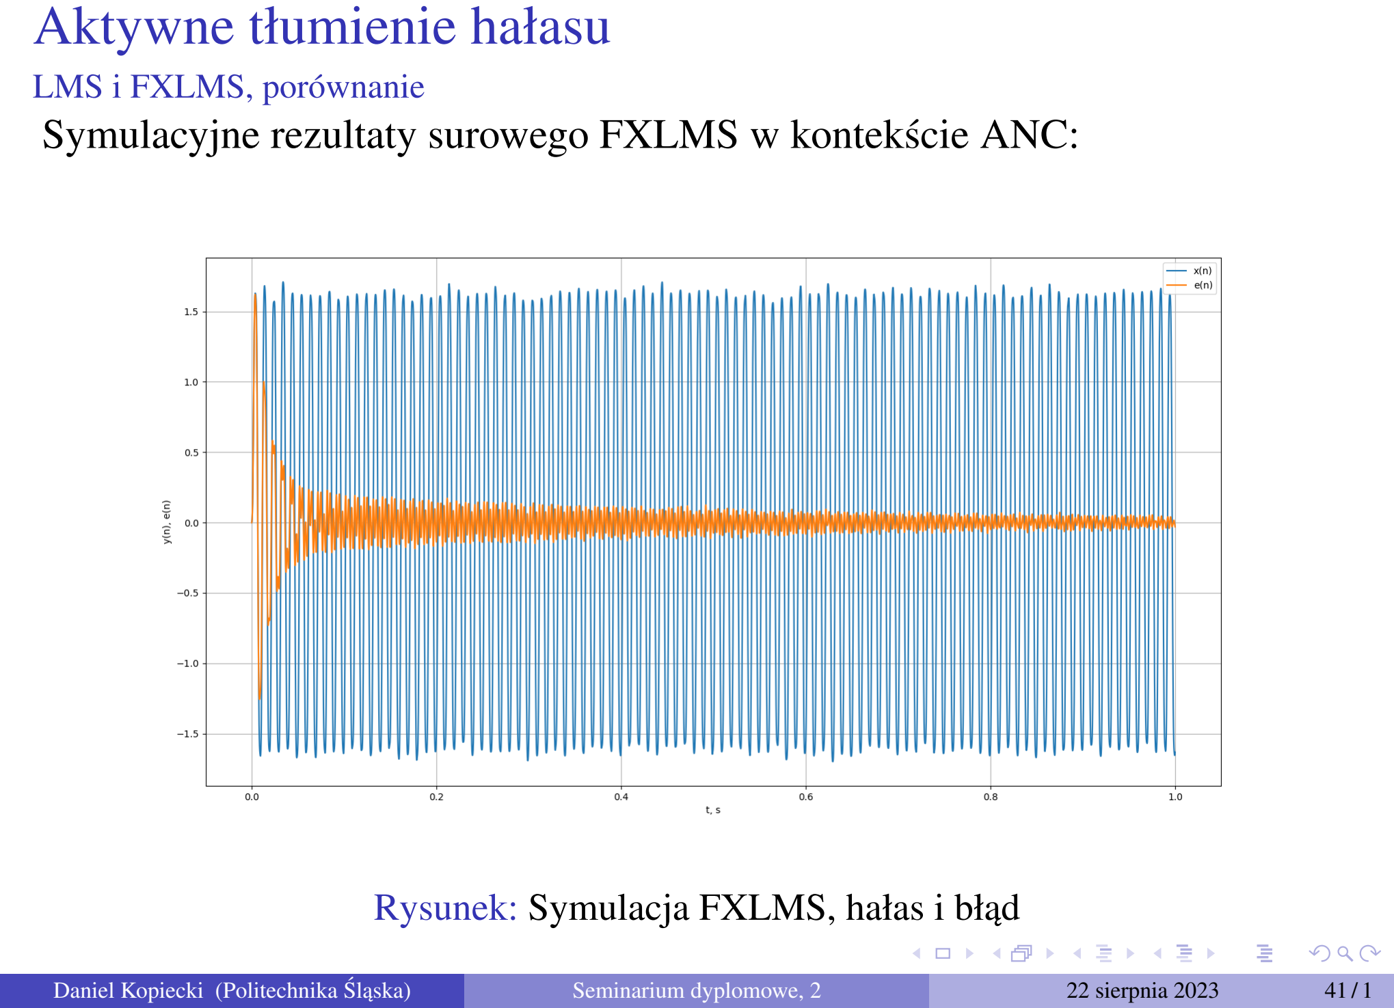
[picture p341: page 41]

LMS i FXLMS, porównanie
Symulacyjne rezultaty surowego FXLMS w kontekscie ANC: ´

Rysunek: Symulacja FXLMS, hałas i bł ˛ad

Daniel Kopiecki (Politechnika Sl ˛aska) ´ | Seminarium dyplomowe, 2 | 22 sierpnia 2023 | 41 / 1

## Wykorzystane materiały

Active Noise Control Systems: Algorithms and DSP Implementations, Sen Maw Kuo and Dennis R. Morgan, 1996
Cyfrowe przetwarzanie sygnałów, A.V. Oppenheim, R.W. Schaffer, Wydawnictwa Ł ˛acznosci i Telekomunikacji ´

Serdecznie dzi˛ekuj˛e za uwag˛e

Daniel Kopiecki (Politechnika Sl ˛aska) ´ | Seminarium dyplomowe, 2 | 22 sierpnia 2023 | 42 / 1
