kopiecki/anc/docs/polsl/sd3/build/sd_kopiecki_3.pdf

## Seminarium dyplomowe, 3

Układ aktywnego tłumienia hałasu pod nadzorem j ądra systemu Linux z rozszerzeniami real-time

Daniel Kopiecki

Politechnika Sl ąska ´

29 maja 2023

Daniel Kopiecki (Politechnika Sl ąska) ´ | Seminarium dyplomowe, 3 | 29 maja 2023 | 1 / 25

## Słowem wstępu - system operacyjny

System operacyjny w najprostszej definicji to oprogramowanie
zarz ądzaj ące systemem komputerowym.
Z punktu widzenia uzytkownika, stanowi ˙ | srodowisko, pozwalaj ące na ´
interakcję z komputerem bez zrozumienia i znajomosci działania ´
urz ądzenia na poziomie sprzętowym.
W uogólnieniu system operacyjny zajmuje się:
1 Planowanie i przydziałem czasu procesora na wykonanie poszczególnych zadan (programów). ´
2 | Kontrol ą i przydziałem pamięci na zadania (programy).
3 | Synchronizacj ą zadan (programów). ´
4 | Obsług ą zasobów sprzętowych, zapewnieniem jednolitego interfejsu
kontroli nad nim.
Daniel Kopiecki (Politechnika Sl ąska) ´ | Seminarium dyplomowe, 3 | 29 maja 2023 | 2 / 25

## Słowem wstępu - system operacyjny

Przyjęto, ze system operacyjny dzieli się na trzy elementy: ˙
- J ądro - kontrola zadan i zasobów (sprzęt, pamię ´ | c, czas procesora). ´
- Powłoka - interakcja uzytkownika z j ądrem. ˙
- System plików - sposób strukturyzacji danych na nosniku. ´

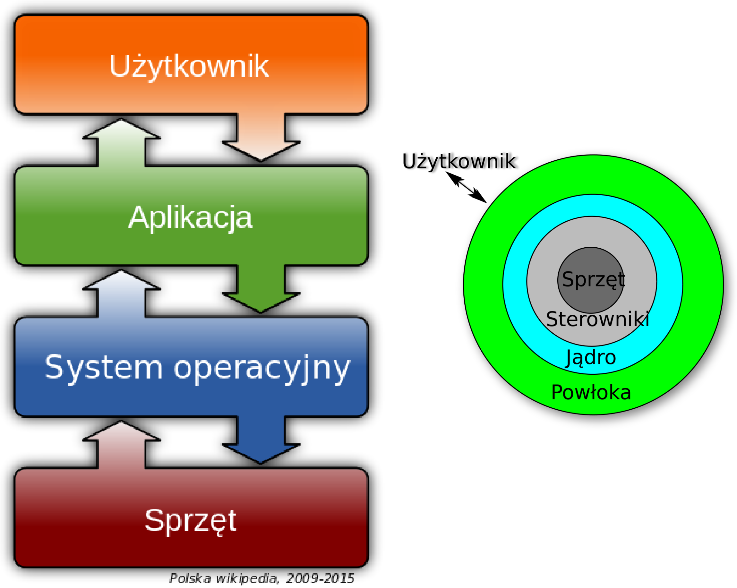
[picture p342: figure]

Rysunek: System operacyjny

Daniel Kopiecki (Politechnika Sl ąska) ´ | Seminarium dyplomowe, 3 | 29 maja 2023 | 3 / 25

## J ądro systemu operacyjnego

J ądro systemu operacyjnego to program, który posiada pełn ą kontrolę nad wszystkim co dzieje się w systemie komputerowym.
Kod tego programu jest umiejscowiony w odpowiednim, chronionym przed zapisem obszarze pamięci, a ładowany jest przy uruchomieniu
systemu z uzyciem ˙ | bootloader’a.
Istniej ą rózne architektury j ądra, z których wyró ˙ | zni ˙ c mo ´ | zna: ˙
- Monolityczne - j ądro stanowi jeden, duzy program (systemy ˙ uniksopodobne, lecz nie tylko) pracuj ący w trybie j ądra.
- Mikroj ądro - monolit zostaje podzielony na mniejsze moduły, z których
częsć pracuje w ´ | trybie uzytkownika ˙ | komunikujac się z serwerami
(posrednikami). ´
- Nanoj ądro - jeszcze większe podzielenie na moduły.
- Hybrydowe - kompromis pomiędzy monolitem, a modularyzacj ą.
Daniel Kopiecki (Politechnika Sl ąska) ´ | Seminarium dyplomowe, 3 | 29 maja 2023 | 4 / 25

## J ądro systemu operacyjnego

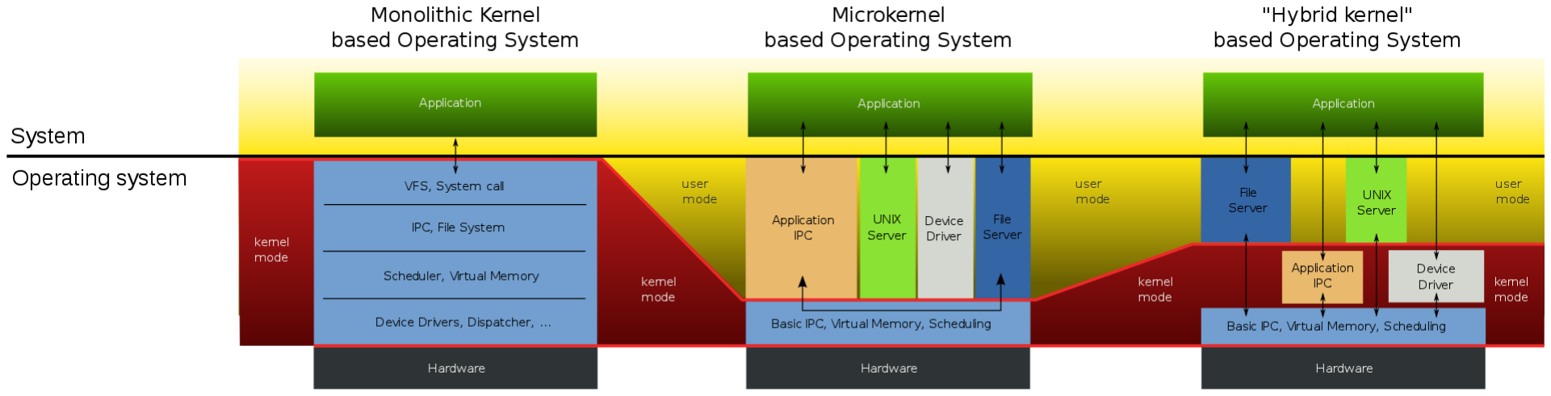
[picture p343: figure]

Rysunek: Schematy interakcji

Monolit - j ądro UNIX (np. BSD), Linux, MS-DOS Mikro/nano - QNX, Mach
Hybryda - Windows NT/2000/XP/Vista/7/8/10/11
Daniel Kopiecki (Politechnika Sl ąska) ´ | Seminarium dyplomowe, 3 | 29 maja 2023 | 5 / 25

## J ądro monolityczne

Cechuje się wysok ą wydajnosci ą, poniewa ´ | z jedynym po ˙ | srednikiem ´
między zasobami, a aplikacjami, jest własnie j ądro. ´
J ądro zapewnia względnie wysokopoziomowe API do interakcji z zasobami (własciwie samoistnie je definiuje). ´
Interakcje z j ądrem odbywaj ą się poprzez wywoływania systemowe (ang. system call).

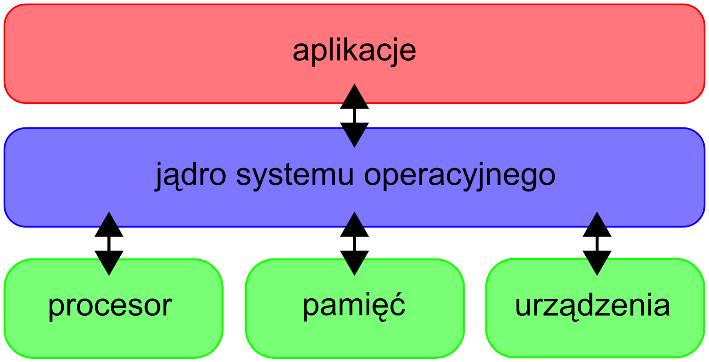
[picture p344: figure]

Rysunek: Schemat interakcji - j ądro monolityczne

Dodatkow ą mozliwo ˙ sci ą w tego typu architekturze jest dodawanie ´ sterowników j ądra jako ładowalnych modułów (ang. loadable kernel modules).

Daniel Kopiecki (Politechnika Sl ąska) ´ | Seminarium dyplomowe, 3 | 29 maja 2023 | 6 / 25

Łamanie trybu uzytkownika ( ˙ | breaking user’s space)

Rozwi ązaniem krytykowanym przez duz ą rzeszę programistów jest ˙ oddzielanie kwestii systemowych do pracy w trybie uzytkownika (j ądra ˙ hybrydowe).
Tego typu rozwi ązanie nie dosć,´ ze powoduje przeogromne problemy z ˙ zachowaniem kompatybilnosci wstecznej, to jeszcze całkowicie ´ uzaleznia programistów pracuj ących pod danym systemem operacyjnym ˙ od jego wersji.
W słowach Linusa Torvaldsa (LKML)
Breaking user programs simply isn’t acceptable. (. . . ) We know that people use old binaries for years and years, and that making a new release doesn’t mean that you can just throw that out. You can trust us. Przykładem moze by ˙ c stara gra komputerowa (zazwyczaj ´ zaprojektowana do działania pod pewnym systemem operacyjnym), której uruchomienie dzisiaj jest wyj ątkowo trudne z powodu braku kompatybilnosci. ´
Daniel Kopiecki (Politechnika Sl ąska) ´ | Seminarium dyplomowe, 3 | 29 maja 2023 | 7 / 25

## POSIX

POSIX (ang. Portable Operating System Interface for UNIX, IEEE 1003) to standard oprogramowania systemu operacyjnego, w który skład wchodzi:
- Interfejs programistyczny (<unistd.h>, read, write, fork, pipe...).
- Interfejs uzytkownika, przykładowo polecenia powłoki ˙ | echo, cat, grep.
- Własciwo ´ | sci powłoki. ´
Pojęcie powstało na wskutek prób standaryzacji róznych odmian ˙ systemu operacyjnego UNIX.

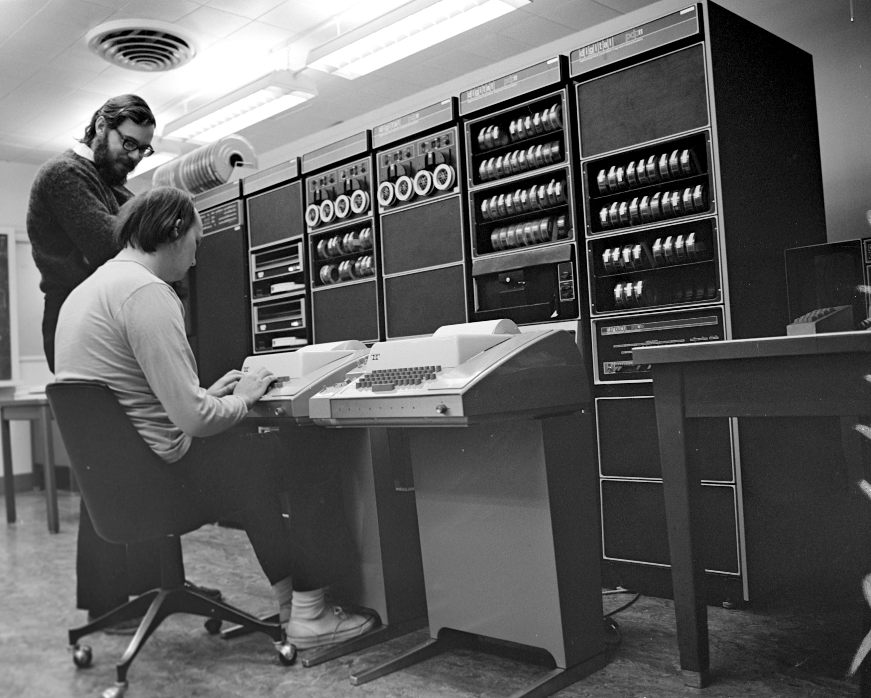
[picture p345: figure]

Daniel Kopiecki (Politechnika Sl ąska) ´ | Seminarium dyplomowe, 3 | 29 maja 2023 | 8 / 25

## J ądro Linux

Linux to j ądro systemu operacyjnego stworzone pocz ątkowo przez Linusa Torvaldsa w 1991 roku.
Jest oparte na licencji GNU General Public License v2 i pocz ątkowo stanowiło wolny odpowiednik systemu UNIX.
Jest j ądrem monolitycznym i uniksopodobnym (jest w większosci ´ zgodne ze standardem POSIX).

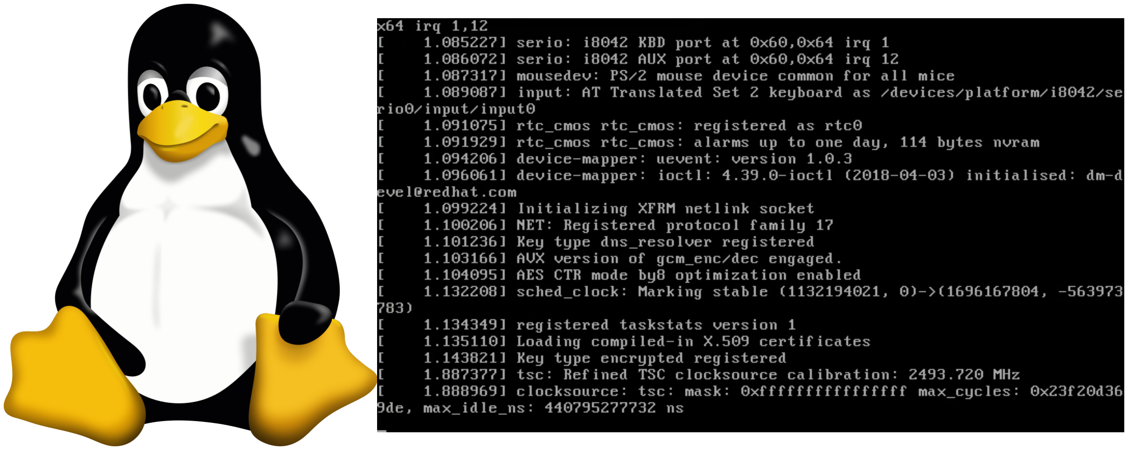
[picture p346: figure]

Rysunek: J ądro systemu Linux

W poł ączeniu z narzędziami i bibliotekami systemowymi z projektu
GNU, otrzymuje się kompletny system operacyjny GNU/Linux.
Daniel Kopiecki (Politechnika Sl ąska) ´ | Seminarium dyplomowe, 3 | 29 maja 2023 | 9 / 25

## Wbudowany GNU/Linux

Z powodu wszechstronnosci i otwartych kodów źródłowych, system ´ operacyjny GNU/Linux jest szeroko wykorzystywany w systemach wbudowanych.
Kod źródłowy moze by ˙ | c portowany na ró ´ | zne architektury. ˙
Z racji wszechostronnosci systemu system mo ´ | zna modyfikowa ˙ | c´
usuwaj ąc i dodawaj ąc moduły.
Pozwala to na tworzenie dedykowanych systemów operacyjnych stworzonych na potrzeby tworzonych urz ądzen.´

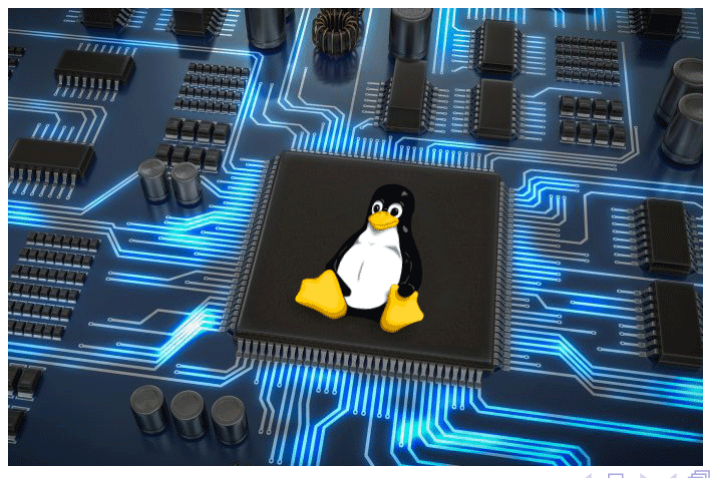
[picture p347: figure]

Daniel Kopiecki (Politechnika Sl ąska) ´ | Seminarium dyplomowe, 3 | 29 maja 2023 | 10 / 25

## Wbudowany GNU/Linux - ograniczenia

System GNU/Linux nie jest systemem czasu rzeczywistego.
Jest to znacz ące ograniczenie, przeszkadzaj ące w wykorzystaniu systemu do urz ądzen realizuj ących zadania krytyczne, gdzie wymagany ´ jest w pełni deterministyczny czas realizacji.
Powstało jednak sporo projektów skupiaj ących się na przyblizeniu/dostosowaniu systemu GNU/Linux do systemu czasu ˙ rzeczywistego.
Jednym z najczęsciej wykorzystywanych rozwi ąza ´ | n jest projekt ´
Real-Time Linux, znany sci ´ slej jako zestaw łatek (ang. ´ | patch) j ądra o
nazwie PREEMPT_RT.

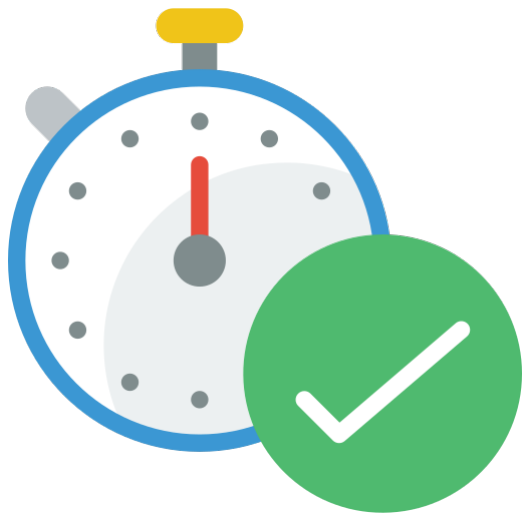
[picture p348: figure]

Daniel Kopiecki (Politechnika Sl ąska) ´ | Seminarium dyplomowe, 3 | 29 maja 2023 | 11 / 25

## System czasu rzeczywistego, RTC (ang. Real-time

### computing)

Aby mozna stwierdzi ˙ | c było, ´ | ze system jest systemem czasu ˙
rzeczywistego, poza logiczn ą prawidłowosci ą wykonanych akcji, musi ´
on równiez gwarantowa ˙ | c okre ´ | slony czas ich realizacji. ´
Zwazaj ąc na okre ˙ | slony czas realzacji, systemy czasu rzeczywistego ´
przyjęło się dzielic na: ´
- Hard real-time - przekroczenie limitu czasowego traktowane jest jak awaria systemu.
- Firm real-time - przekroczenie limitu czasowego skutkuje dyskredytacj ą wykonywanego zadania.
- Soft real-time - przekroczenie limitu czasowego skutkuje obnizeniem ˙ priorytetu wykonywanego zadania (ang. usefulness of a result degrades). W przypadku systemów jednozadaniowych sprawa jest trywialna, jednak komplikuje się, kiedy w grę wchodzi wielozadaniowosć.´
Systemy operacyjne s ą wielozadaniowe.
Daniel Kopiecki (Politechnika Sl ąska) ´ | Seminarium dyplomowe, 3 | 29 maja 2023 | 12 / 25

## Planowanie i wywłaszczenie

J ądro systemu Linux implementuje planistę (ang. scheduler), którego zadaniem jest szeregowanie zadan w systemie (procesy, w ątki). ´
Tryb pracy planisty w j ądrze Linux moze by ˙ | c wybrany przez ´
uzytkownika. Domy ˙ | slnym jest CFS (ang. ´ | Completely Fair Scheduler) i
jego wybranie wynika z deklaracji zadania jako SCHED_NORMAL. Zadania s ą uruchamiane na podstawie ich priorytetu. Planista iteruje po obsługiwanych zadaniach i w pierwszej kolejnosci uruchamia te z ´ największym priorytetem.
J ądro systemu Linux zapewnia wywłaszczenie zadania z poziomu przestrzeni uzytkownika. ˙
Daniel Kopiecki (Politechnika Sl ąska) ´ | Seminarium dyplomowe, 3 | 29 maja 2023 | 13 / 25

## Wywłaszczenie

Wywłaszczenie (ang. preemption) to akcja tymczasowego zatrzymania aktualnie wykonywanego zadania, maj ąca na celu wykonanie innego, zazwyczaj o większym priorytecie.
Po wykonaniu zadania przerywaj ącego, następuje powrót do wczesniej wykonanywanego. Akcję zatrzymania nazywa się przerwaniem.

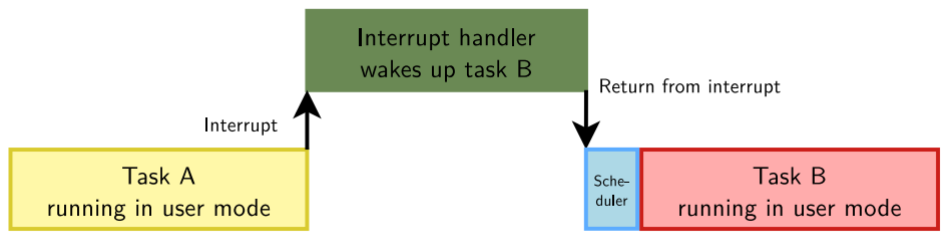
[picture p349: figure]

Daniel Kopiecki (Politechnika Sl ąska) ´ | Seminarium dyplomowe, 3 | 29 maja 2023 | 14 / 25

## Wywłaszczenie

W j ądrze systemu Linux domyslnie wywłaszczone mog ą zosta ´ | c jedynie ´
zadania pochodz ące z przestrzeni uzytkownika. ˙
Oznacza to, ze je ˙ zeli przerwanie nadejdzie w trakcie wykonywania przez ˙ zadanie wywołania systemowego, to takie przerwanie nie zostanie
obsłuzone do momentu zako ˙ | nczenia zawołania systemowego. ´

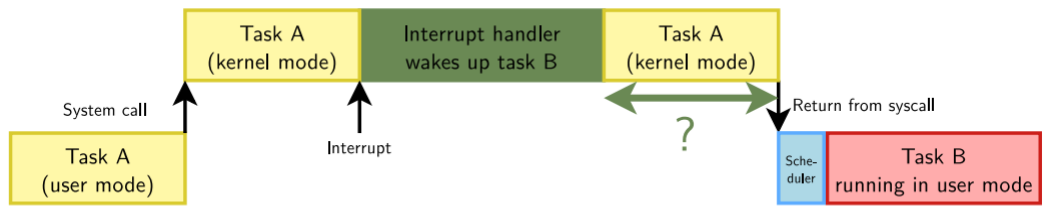
[picture p350: figure]

Daniel Kopiecki (Politechnika Sl ąska) ´ | Seminarium dyplomowe, 3 | 29 maja 2023 | 15 / 25

## Wywłaszczenie

Dodatkowo, kazde zadanie z przestrzeni u ˙ | zytkownika mo ˙ | ze zosta ˙ | c´
wywłaszczone przez przerwanie sprzętowe. W trakcie obsługi takiego przerwania zablokowana jest obsługa innych.
Oznacza to, ze mało wa ˙ | zne przerwania sprzętowe mog ą wywłaszczy ˙ | c´
wazne, krytyczne czasowo zadania czasu rzeczywistego. ˙

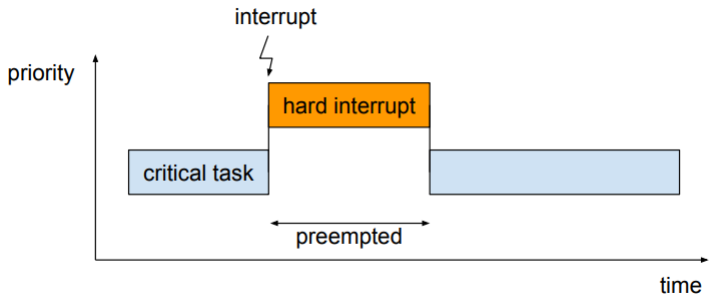
[picture p351: figure]

Daniel Kopiecki (Politechnika Sl ąska) ´ | Seminarium dyplomowe, 3 | 29 maja 2023 | 16 / 25

## Wywłaszczenie

Jakby tego było mało, istnieje jeszcze szereg problemów z synchronicznym dostępem do zasobów.
Moze zaistnie ˙ | c sytuacja, kiedy niekrytyczne zadanie blokuje (ang. ´
mutex) dostęp do zasobów zadaniu krytycznemu.

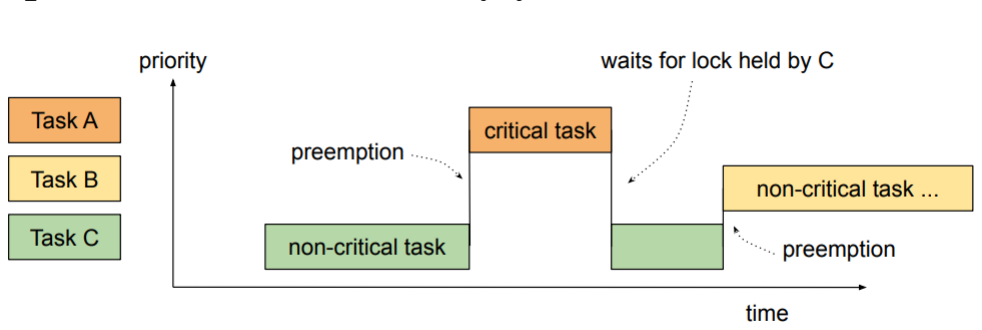
[picture p352: figure]

Krytyczne zadanie A musi uzyskac dostęp do zasobów blokowanych ´ przez zadanie C (niski priorytet).
Planista więc uruchamia zadanie C, aby odblokowac dostęp. ´
W tym czasie zadanie C zostaje wywłaszczone przez zadanie B o wyzszym priorytecie, ale niekrytyczne. ˙
Taki problem nosi nazwę inwersji priorytetów (ang. priority inversion).
Daniel Kopiecki (Politechnika Sl ąska) ´ | Seminarium dyplomowe, 3 | 29 maja 2023 | 17 / 25

## Projekt PREEMPT_RT

Zestaw łatek PREEMPT_RT celuje w mozliwo ˙ sci wywłaszczenia ´ wszystkich zadan realizowanych w systemie, nawet tych wykonywanych ´ z przestrzeni j ądra.
Jako, ze j ądro Linux umo ˙ | zliwia korzystania z innych planistów ni ˙ | z˙
domyslne, istnieje mo ´ | zliwo ˙ | sć zast ąpienia domy ´ | slnych wytycznych ´
planisty na wspieranie rozszerzen czasu rzeczywistego. ´
Jako, ze projekt PREEMPT_RT oferuje jedynie zestaw łatek, interfejs ˙ programistyczny POSIX/Linux pozostaje niezmienny.
Umozliwa to korzystanie z systemu w tradycyjny sposób jak i ˙ wykonywanie krytycznych zadan równolegle w opraciu o planistę z ´ rozszerzeniami czasu rzeczywistego.
Daniel Kopiecki (Politechnika Sl ąska) ´ | Seminarium dyplomowe, 3 | 29 maja 2023 | 18 / 25

## Projekt PREEMPT_RT

Kilka funkcji łatkek PREEMPT_RT:
- Wywłaszczenie zadan z przestrzeni j ądra. ´
- Liczniki wysokiej rozdzielczosci (ang. ´ | High resolution timers).
- W ątkow ą realizację przerwan sprzętowych. ´
- Implementację blokad w trybie czasu rzeczywistego (do synchronizacji zadan). ´
- Planistę opartego o algorytm Earliest-Deadline First.
- Rozwi ązanie problemu inwersji priorytetów poprzez zastosowanie dziedziczenia priorytetu.
Jako, ze czas wykonania zadania jest bardzo trudny do predykcji, celem ˙ jest minimalizacja latencji pomiędzy reakcj ą na wykonanie zadania.

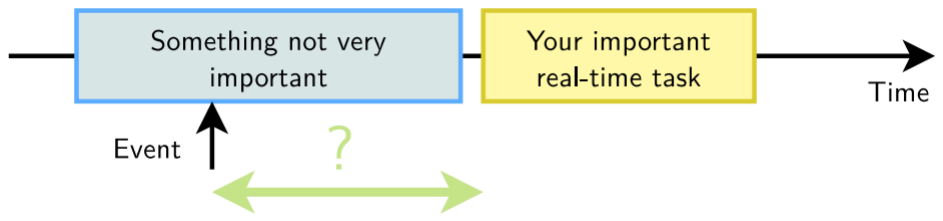
[picture p353: figure]

Daniel Kopiecki (Politechnika Sl ąska) ´ | Seminarium dyplomowe, 3 | 29 maja 2023 | 19 / 25

## Projekt PREEMPT_RT

W ątkowa realizacja przerwan sprzętowych. ´

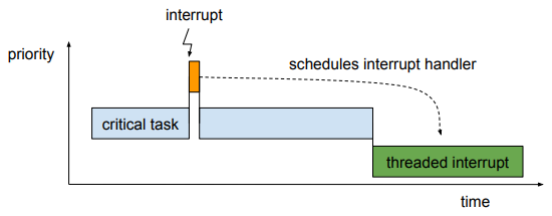
[picture p354: figure]

Dziedziczenie priorytetu.

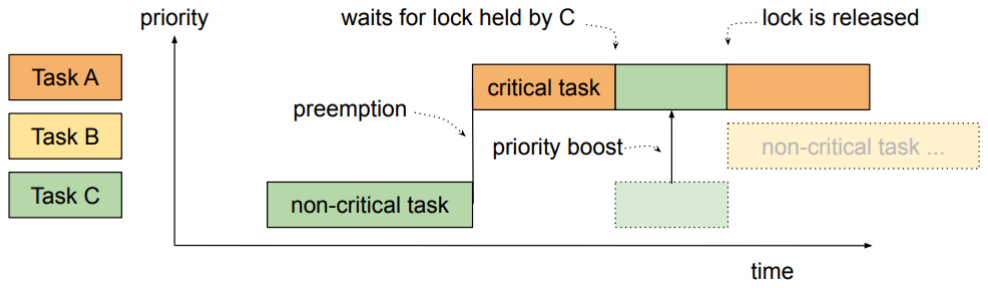
[picture p355: figure]

Krytyczne zadanie A musi uzyskac dostęp do zasobów blokowanych przez ´ zadanie C. W zwi ązku z tym, priorytet zadania C jest zwiększany do priorytetu zadania A.

Daniel Kopiecki (Politechnika Sl ąska) ´ | Seminarium dyplomowe, 3 | 29 maja 2023 | 20 / 25

## Embedded GNU/Linux, PREEMPT_RT - Proces uruchamiania, kolejnosć´

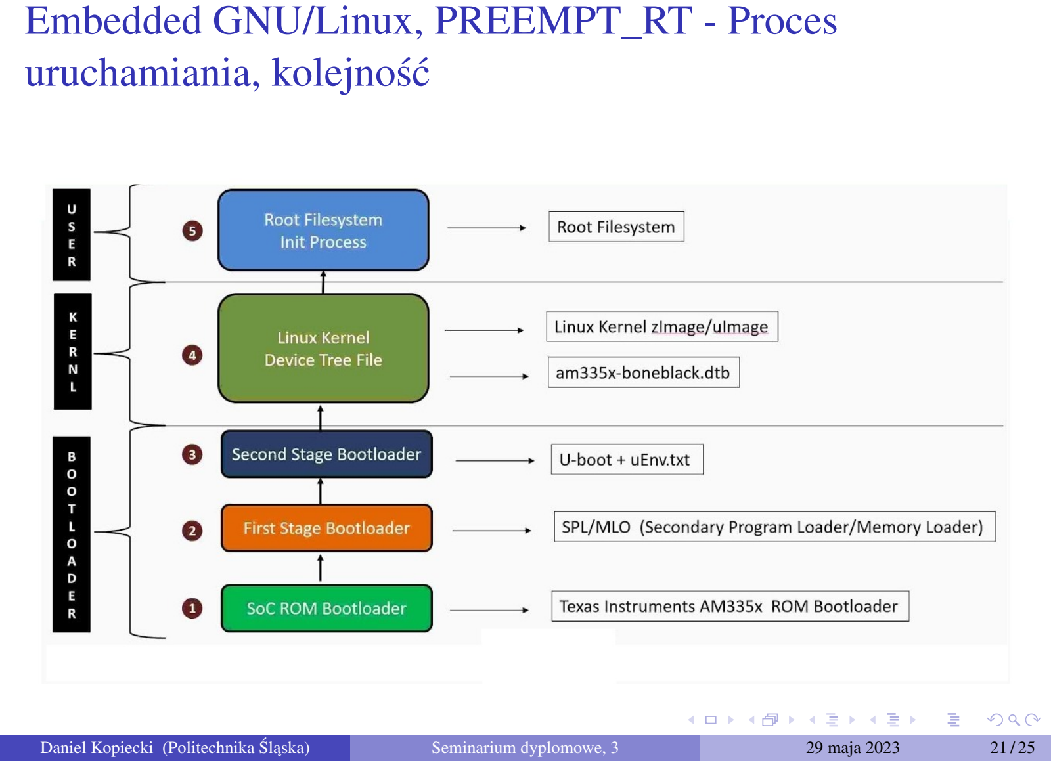
[picture p356: page 21]

Daniel Kopiecki (Politechnika Sl ąska) ´ | Seminarium dyplomowe, 3 | 29 maja 2023 | 21 / 25

## Embedded GNU/Linux - przygotowywanie nosnika ´

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

sudo mkfs . v f a t / dev / kartaSD1 −n uboot sudo mkfs . e x t 4 / dev / kartaSD2 −L k e r n e l sudo mkfs . e x t 4 / dev / kartaSD3 −L r o o t f s

Daniel Kopiecki (Politechnika Sl ąska) ´ | Seminarium dyplomowe, 3 | 29 maja 2023 | 22 / 25

## Embedded GNU/Linux, PREEMPT_RT - bootloader

Das U-Boot (ang. the Universal Boot Loader) - główny, otwartoźródłowy bootloader uzywany w zastosowaniach embedded GNU/Linux. ˙

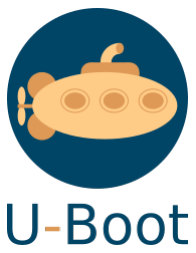
[picture p357: figure]

Kompilacja i kofiguracja bootloader’a:

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

## Embedded GNU/Linux, PREEMPT_RT - j ądro i system plików

Kompilacja i konfiguracja j ądra:

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

Rozpakowanie gotowego systemu plików:

$ mkdir −p r o o t f s
$ cd r o o t f s
$ wget h t t p s : / / www. rcn −ee . com / r o o t f s / e e w i k i / minfs / ubuntu − 2 0 . 0 4 . 5 . t a r . xz $ t a r − xf ubuntu −20.04.5 − minimal −armhf −2022 −12 −20. t a r . xz
$ rm ubuntu −20.04.5 − minimal −armhf −2022 −12 −20. t a r . xz
$ cp − r * / media / u s e r / r o o t f s
Daniel Kopiecki (Politechnika Sl ąska) ´ | Seminarium dyplomowe, 3 | 29 maja 2023 | 24 / 25

## Materiały źródłowe

https://www.linux.org/
https://bootlin.com/
https://archive.kernel.org/oldwiki/rt.wiki.kernel.org/https://wiki.linuxfoundation.org/realtime/start

Dziękuję za uwagę

Daniel Kopiecki (Politechnika Sl ąska) ´ | Seminarium dyplomowe, 3 | 29 maja 2023 | 25 / 25
