kopiecki/anc/docs/polsl/sd1/build/sd1_full_kopiecki.pdf

## Seminarium dyplomowe

Układ aktywnego tłumienia hałasu pod nadzorem j ądra systemu Linux z rozszerzeniami real-time

Daniel Kopiecki

Politechnika Sl ąska ´

22 marca 2023

Daniel Kopiecki (Politechnika Sl ąska) ´ | Seminarium dyplomowe | 22 marca 2023 | 1 / 23

## Częsć sprzętowa ´

Uproszczony schemat architektury


Rysunek: Architektura sprzętowa

Daniel Kopiecki (Politechnika Sl ąska) ´ | Seminarium dyplomowe | 22 marca 2023 | 2 / 23

# Warstwa przednia +5VDC

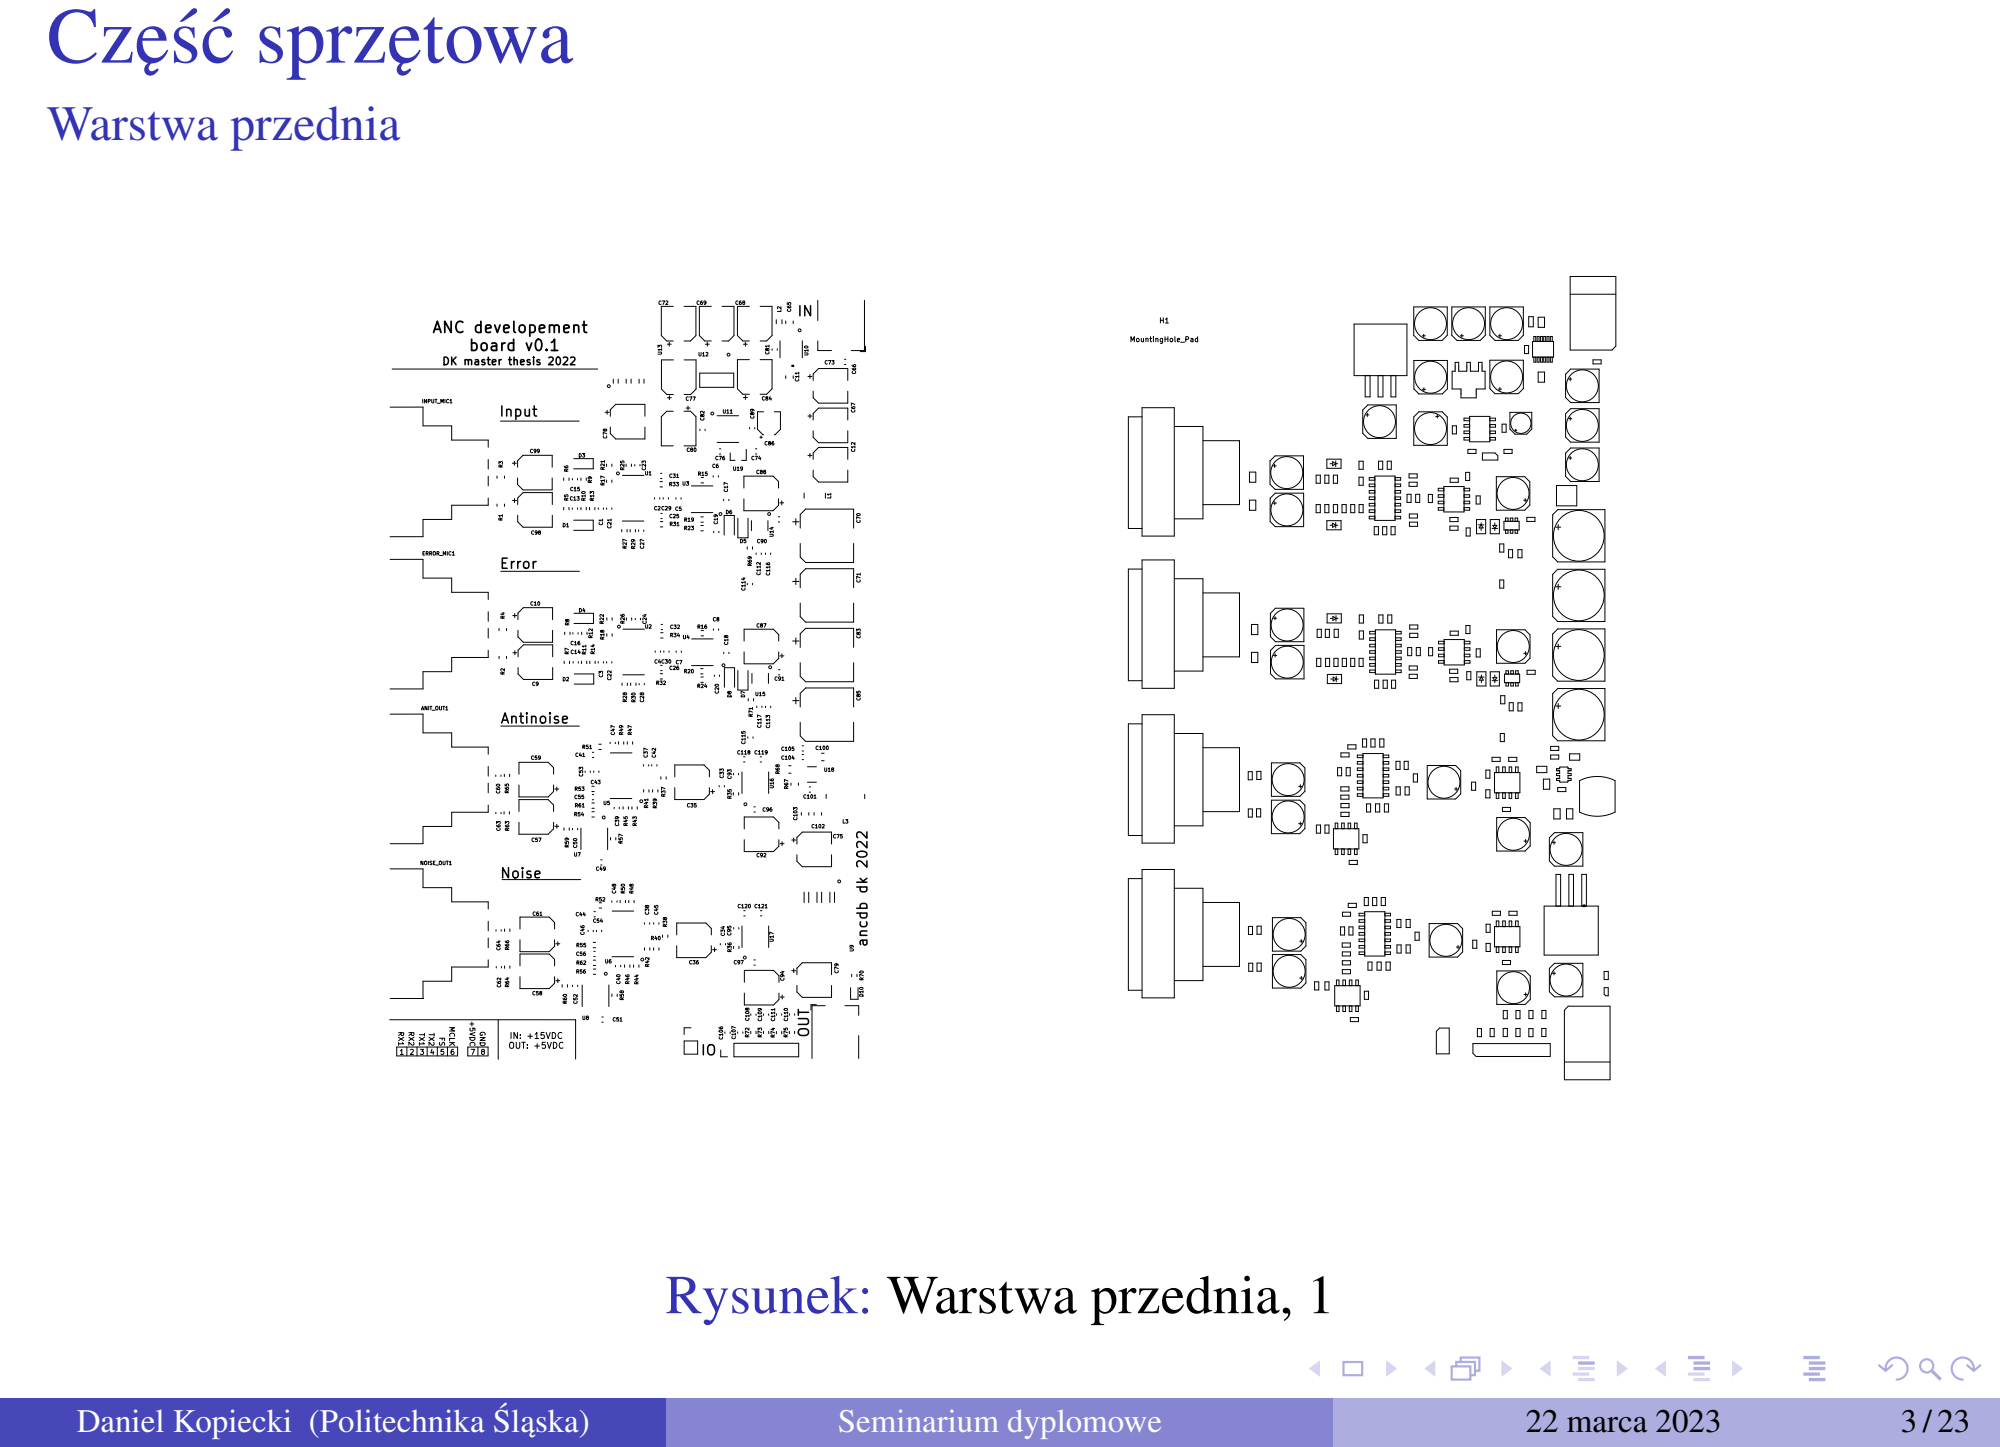
[picture p362: page 3]

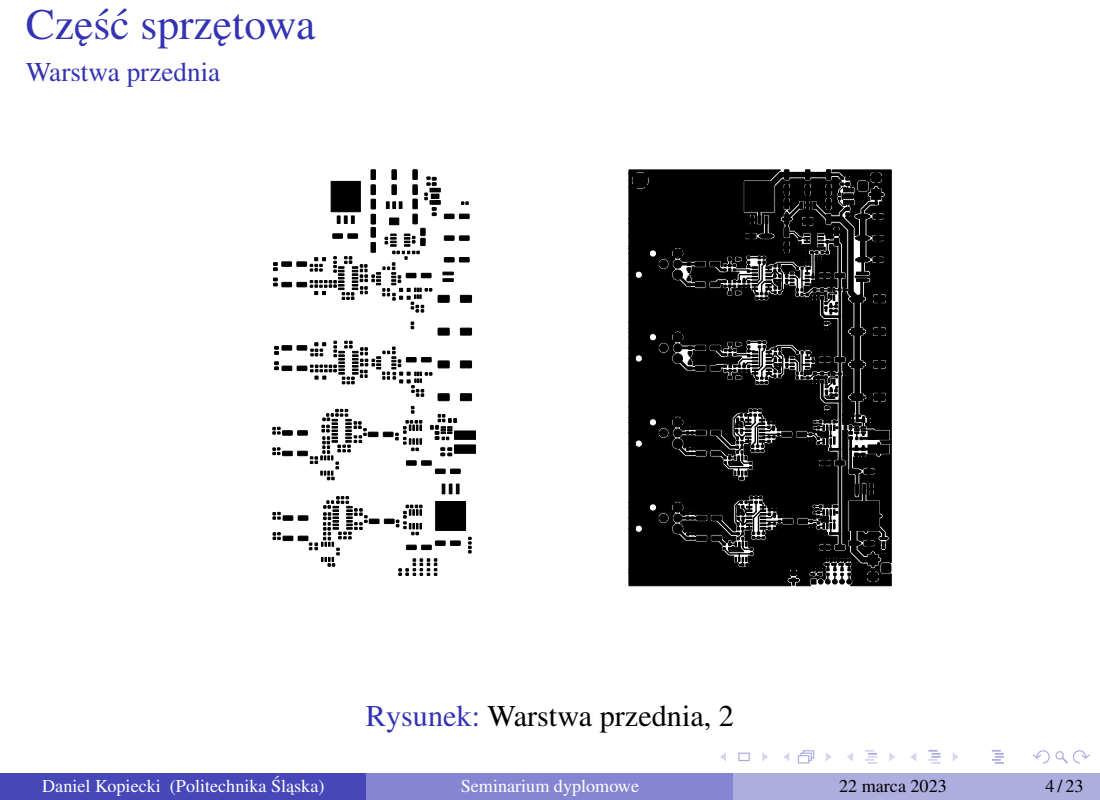
[picture p363: page 4]
Warstwa przednia; Daniel Kopiecki (Politechnika Sl ąska) ´; Seminarium dyplomowe; 22 marca 2023

Rysunek: Warstwa przednia, 2

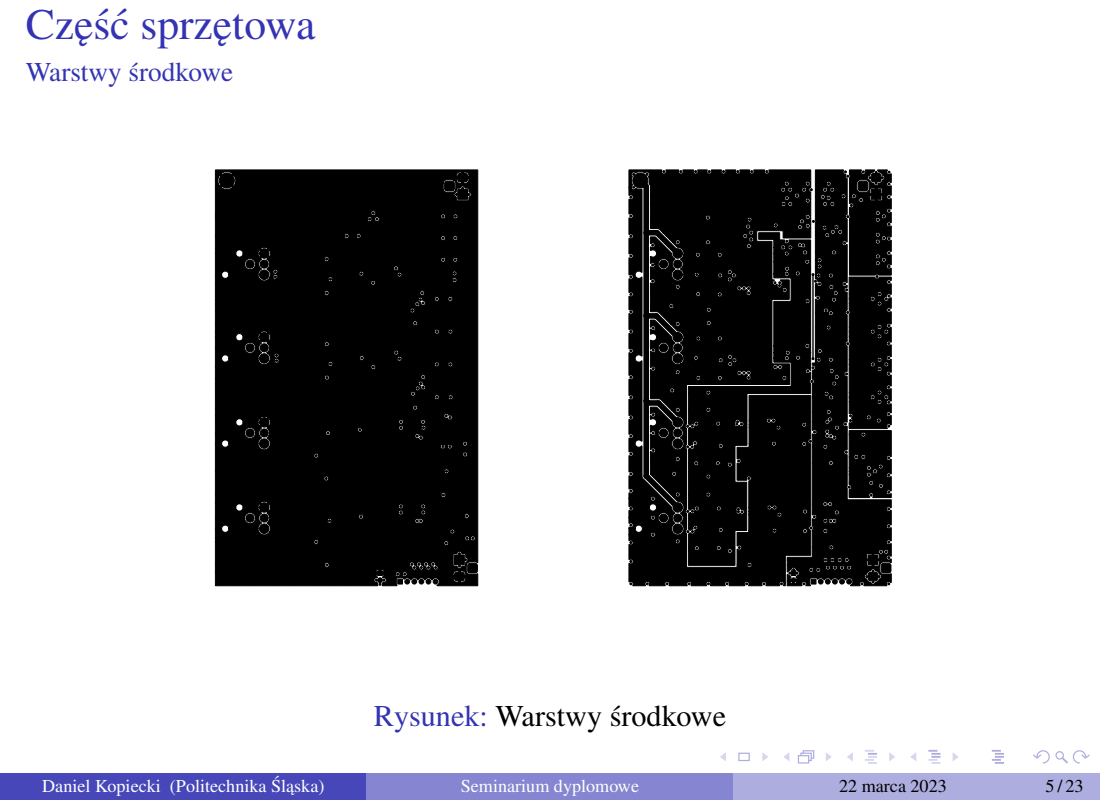
[picture p364: page 5]
Warstwy srodkowe ´; Daniel Kopiecki (Politechnika Sl ąska) ´; Seminarium dyplomowe; 22 marca 2023

Rysunek: Warstwy srodkowe ´

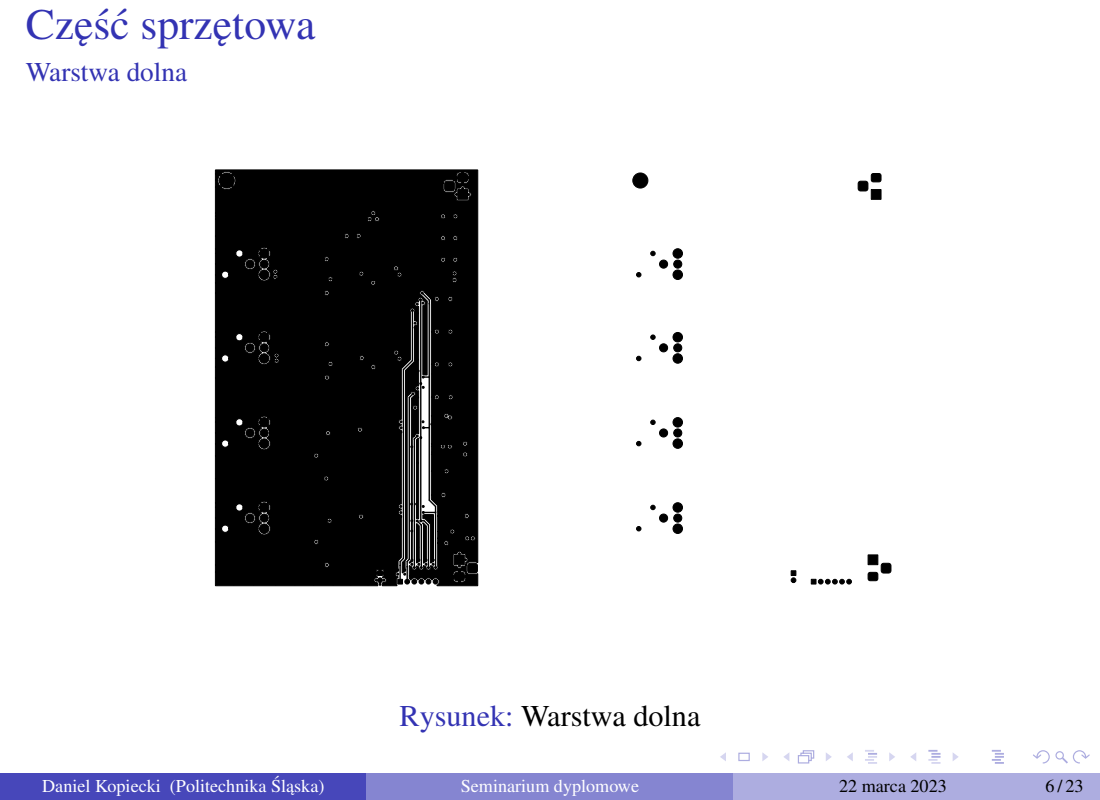
[picture p365: page 6]
Warstwa dolna; Daniel Kopiecki (Politechnika Sl ąska) ´; Seminarium dyplomowe; 22 marca 2023

Rysunek: Warstwa dolna

Kilka ciekawych kwestii implementacyjnych

Wszystko wpływa na wszystko
Odległosć pomiędzy ´ | scie ´ | zkami ma ˙ | kolosalne znaczenie
Kwestie obligatoryjne - rozłozenie warst ( ˙ | stackup) oraz umiejscowienie
komponentów

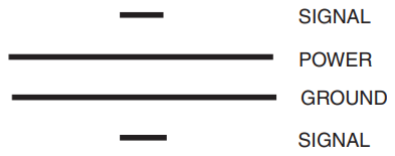
[picture p366: figure]

Daniel Kopiecki (Politechnika Sl ąska) ´ | Seminarium dyplomowe | 22 marca 2023 | 7 / 23

Kilka ciekawych kwestii implementacyjnych
Płaszczyzn ą odniesienia dla relatywnie szybkich sygnałów cyfrowych
moze w równym stopniu by ˙ | c płaszczyzna masy, jak i płaszczyzna ´
zasilania
Z Henry W. Ott, Electromagnetic Compatibility Engineering - układ scalony nie jest źródłem pr ądu sam w sobie, lecz stanowi jedynie jego sterownik. Prawdziwym źródłem jest kondensator odsprzęgaj ący lub/i
pasozytnicza pojemno ˙ | sć pomiędzy ´ | scie ´ | zkami/płaszczyznami. ˙


Rysunek: Mozliwe drogi sygnałów cyfrowych ˙

Daniel Kopiecki (Politechnika Sl ąska) ´ | Seminarium dyplomowe | 22 marca 2023 | 8 / 23

Wykorzystywany protokół cyfrowy
Bardzo wazn ą kwesti ą implementacyjn ą jest opracowanie ˙ synchronicznego próbkowania wszystkich przetworników. Aby to uzyskac, konieczny jest protokół cyfrowy, który zapewni zegar, ´ odpowiedni ą manipulację selektorem, dwie linie RX oraz dwie linie TX.

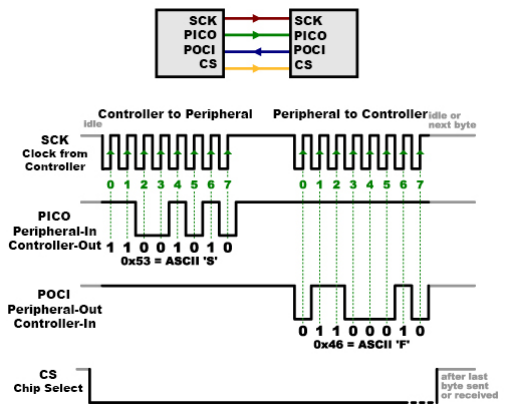
[picture p367: figure]

Rysunek: Protokół SPI - Serial Peripheral Interface

Daniel Kopiecki (Politechnika Sl ąska) ´ | Seminarium dyplomowe | 22 marca 2023 | 9 / 23

Protokół cyfrowy - mozliwe rozwi ązania ˙

McASP - protokół cyfrowy opracowany przez Texas Instruments w celu interakcji z wielokanałowymi kartami dźwiękowymi - podejscie ´ optymalne

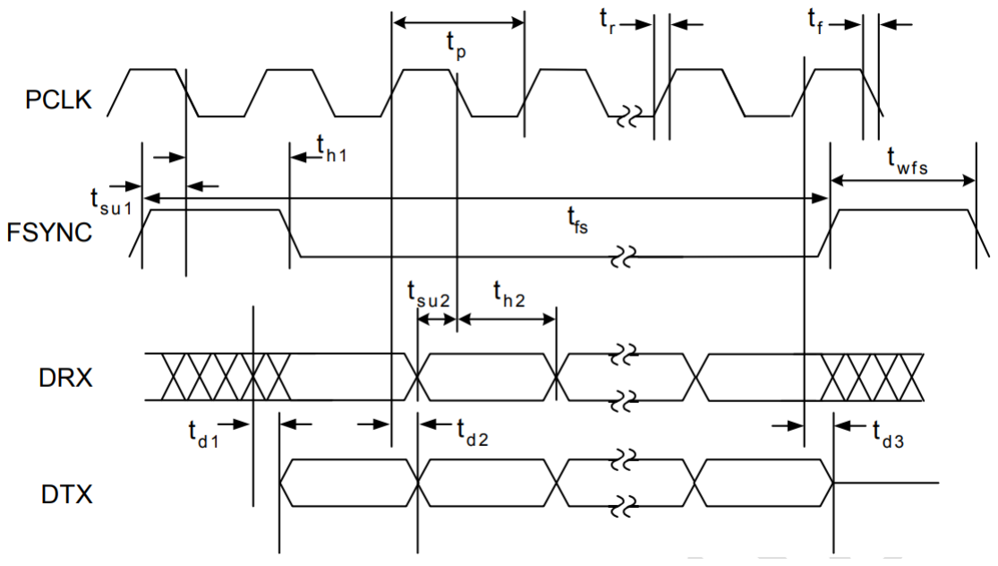
[picture p368: figure]

Rysunek: Protokół McASP - Multichannel Audio Serial Port

Daniel Kopiecki (Politechnika Sl ąska) ´ | Seminarium dyplomowe | 22 marca 2023 | 10 / 23

Protokół cyfrowy - mozliwe rozwi ązania ˙

Bit banging - metoda transmisji danych oparta na implementacji dedykowanego protokołu cyfrowego z wykorzystaniem dwustanowych
pinów wejsciowo-wyj ´ | sciowych ( ´ | GPIOs) - podejscie ´ | ostateczne.
Wymaga implementacji sterownika na najnizszym poziomie. ˙
Daniel Kopiecki (Politechnika Sl ąska) ´ | Seminarium dyplomowe | 22 marca 2023 | 11 / 23

## Częsć sprzętowo-programowa ´

Protokół cyfrowy - bit banging, przykład

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

gpio_low (SD_CLK ) ;
d e l a y ( ) ;
g p i o _ h i g h (SD_CLK ) ;

d a t a <<= 1u ;
}

gpio_low ( SD_CS ) ;
}
Daniel Kopiecki (Politechnika Sl ąska) ´ | Seminarium dyplomowe | 22 marca 2023 | 12 / 23

## Częsć programowa ´

ALSA

Na chwilę obecn ą wybrana została scie ´ | zka ˙ | optymalna.
Tak jak pisano wczesniej, protokół McASP wykorzystywany jest do ´ interakcji z kartami dźwiękowymi.
Głównym srodowiskiem do interakcji z urz ądzeniami audio pod ´ systemem operacyjnym GNU/Linux jest ALSA (Advanced Linux Sound Architecture)

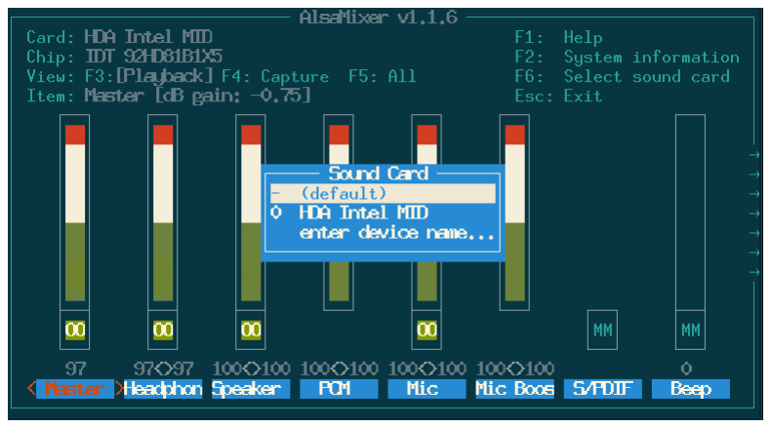
[picture p369: figure]

Rysunek: ALSA - widok aplikacji AlsaMixer ($ alsamixer)

Daniel Kopiecki (Politechnika Sl ąska) ´ | Seminarium dyplomowe | 22 marca 2023 | 13 / 23

## Częsć programowa ´

ALSA
ALSA udostępnia duze, niskopoziomowe API do interakcji z kartami ˙
dźwiękowymi z poziomu przestrzeni uzytkownika ( ˙ | userspace).
Plik nagłówkowy biblioteki nosi nazywę asoundlib.h a sama biblioteka libasound

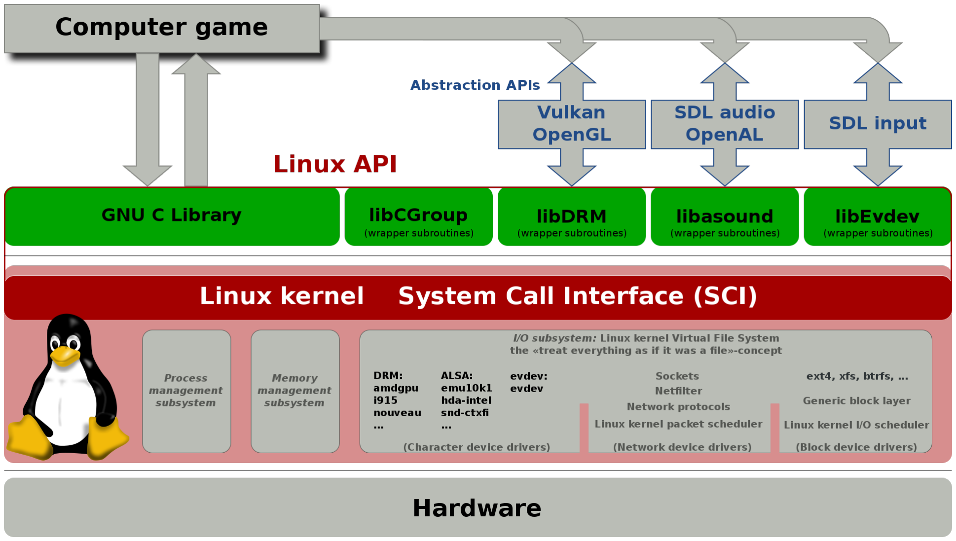
[picture p370: figure]

Daniel Kopiecki (Politechnika Rysunek: Sl ąska) ´ | Schemat interkacji j ądro - przestrze Seminarium dyplomowe | n u ´ zytkownika ˙ | 22 marca 2023 | 14 / 23

## Częsć programowa ´

Cyfrowa reprezentacja dźwięku

Cyfrow ą reprezentacj ą dźwięku, wykorzystywan ą przez srodowisko ´ ALSA jest modulacja pulsowo-kodowa (PCM - Pulse Code Modulation)


Rysunek: Modulacja pulsowo-kodowa

Daniel Kopiecki (Politechnika Sl ąska) ´ | Seminarium dyplomowe | 22 marca 2023 | 15 / 23

## Częsć programowa ´

ALSA
ALSA korzysta ze specjalnego nazewnictwa urz ądzen dźwiękowych ´
dostępnych dla uzytkownika. Mog ą to by ˙ | c rzeczywiste urz ądzenia (karty ´
dźwiękowe), lub ich wirtualne reprezentacje.
W przypadku fizycznych urz ądzen, korzysta się z formatu ´ | hw:i,j, gdzie i
oznacza numer karty, a j numer urz ądzenia kontrolowanego przez kartę, czyli przypkładowo zestawu głosników lub mikrofonu. ´
W przpyadku wirtualnych urz ądzen, korzysta się z formatu ´ | plughw:i, j.

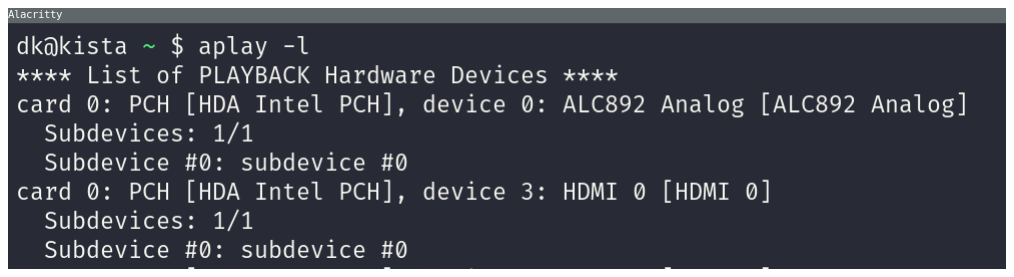
[picture p371: figure]

Rysunek: Rezultat polecenia aplay -l

Daniel Kopiecki (Politechnika Sl ąska) ´ | Seminarium dyplomowe | 22 marca 2023 | 16 / 23

## Częsć programowa ´

ALSA - lokowanie próbek
Na poziomie sterownika j ądra sprzętu audio, ALSA tworzy bufor
cykliczny, którego długosć mo ´ | zna modyfikowa ˙ | c u ´ zywaj ąc ˙
udostępnionego API.
Jezeli bufor jest zapełniony, sterownik j ądra generuje przerwanie. Rolę ˙ obsługi przerwania obejmuje DMA (Direct Memory Access), które nieblokuj ąco przenosi próbki z bufora sterownika do bufora aplikacji.

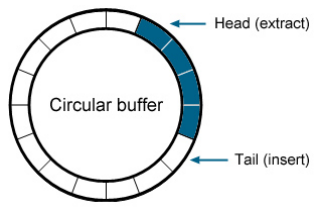
[picture p372: figure]

Rysunek: Bufor cykliczny

Daniel Kopiecki (Politechnika Sl ąska) ´ | Seminarium dyplomowe | 22 marca 2023 | 17 / 23

## Częsć programowa ´

ALSA - lokowanie próbek
Bufor tworzony przez sterownik j ądra zapełniany jest przez fragmenty (lub okresy, periods).
Fragmenty składaj ą się z okreslonej liczby ´ | ramek (frames).
Ramka składa się z próbek dla kazdego kanału karty dźwiękowej (liczba ˙ kanałów moze by ˙ c wyspecifikowana, tak jak format próbki). ´

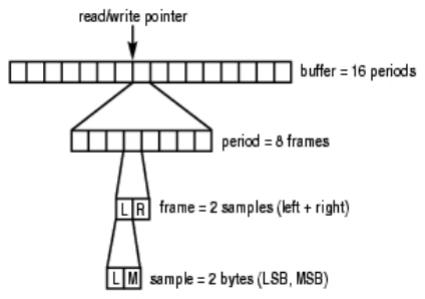
[picture p373: figure]

Rysunek: Podział danych

Daniel Kopiecki (Politechnika Sl ąska) ´ | Seminarium dyplomowe | 22 marca 2023 | 18 / 23

## ALSA - bufory

Jezeli aplikacja jest uruchomiona, to dane w nieprzerwany sposób s ą ˙ transportowane z/do bufora cyklicznego sterownika j ądra do/z bufora aplikacji.
W przypadku odczytywania danych (capture), jezeli nie s ą one ˙ odpowiednio szybko czytane, to moze doj ˙ sć do sytuacji, kiedy dane w ´ buforze cyklicznym zostan ą nadpisane nowymi. Taka sytuacja nosi nazwę buffer overrun.
W przypadku zapisywania danych (playback), jezeli nie s ą one ˙ odpowiednio szybko wysyłane, to moze doj ˙ sć do odwrotnej sytuacji, ´ czyli bufor cykliczny w pewnym momencie się całkowicie oprózni. Taka ˙ sytuacja nosi nazwę buffer underrun.
Daniel Kopiecki (Politechnika Sl ąska) ´ | Seminarium dyplomowe | 22 marca 2023 | 19 / 23

## Częsć programowa ´

ALSA - latencja

Bardzo waznym pojęciem zwi ązanym z przetwarzaniem sygnału audio ˙ jest latencja
Latencja to nic innego jak opóźnienie, które towarzyszy sygnałowi audio od momentu trafienia na wejscie systemu do jego opuszczenia. ´
W srodowisku ´ | ALSA latencja definiowana jest następuj ąc ą zalezno ˙ sci ą: ´
| TL = nfFrb
| fsPrb

(1)

gdzie nf - ilosć fragmentów, ´ | Frb - rozmiar fragmentu w bajtach, fs -
częstotliwosć próbkowania, ´ | Prb - rozmiar próbki w bajtach.
Licznik równania to nic innego jak zadeklarowany rozmiar bufora w bajtach, czyli całe wyrazenie odpowiada czasowi potrzebnemu na ˙ przesłanie całego bufora (zbuforowaniu danych).
Daniel Kopiecki (Politechnika Sl ąska) ´ | Seminarium dyplomowe | 22 marca 2023 | 20 / 23

## Częsć programowa ´

ALSA - latencja

Przykładowo
Chc ąc odtworzyc dźwięk z szesnatostobitowego systemu stereo (dwa ´
kanały, głosnik lewy i prawy, próbki po 16 bitów ´ | = 2 bajty) z typow ą
częstotliwosci ą audio równ ą 44100 kHz, nasza ´ | ramka ma rozmiar 4
bajtów (dwie dwu-bajtowe próbki, jedna na kanał). Deklaruj ąc rozmiar fragmentu na 2048 ramek, otrzymujemy długosć´ fragmentu w bajtach równ ą 8192 bajtów.
Deklaruj ąc rozmiar bufora na dwa fragmenty, otrzymujemy rozmiar bufora równy 16384 bajtów.
Zbuforowanie tych danych, definiuj ące latencję, w tak skonstruowanym systemie zajmie 16384
44100∗4 ≈ 0.093 s.
Daniel Kopiecki (Politechnika Sl ąska) ´ | Seminarium dyplomowe | 22 marca 2023 | 21 / 23

## Częsć programowa ´

ALSA - przykładowy prosty program

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

snd_pcm_t * pcm_handle = NULL;
i n t e r r o r | = snd_pcm_open(&pcm_handle , pcm_name , stream , 0 ) ;
i f ( e r r o r < 0)
return e r r o r ;

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

snd_pcm_drain ( pcm_handle ) ;
snd_pcm_close ( pcm_handle ) ;
}
Daniel Kopiecki (Politechnika Sl ąska) ´ | Seminarium dyplomowe | 22 marca 2023 | 22 / 23

## Wykorzystane materiały

Henry W. Ott, Electromagnetic Compatibillity Engineering Strona domowa projektu ALSA
Jeff Tranter, Introduction to Sound Programming with ALSA, (https://www.linuxjournal.com/article/6735) Linux Journal
Daniel Kopiecki (Politechnika Sl ąska) ´ | Seminarium dyplomowe | 22 marca 2023 | 23 / 23
