kopiecki/anc/docs/polsl/temporary_project/build/images/iira-functional.png

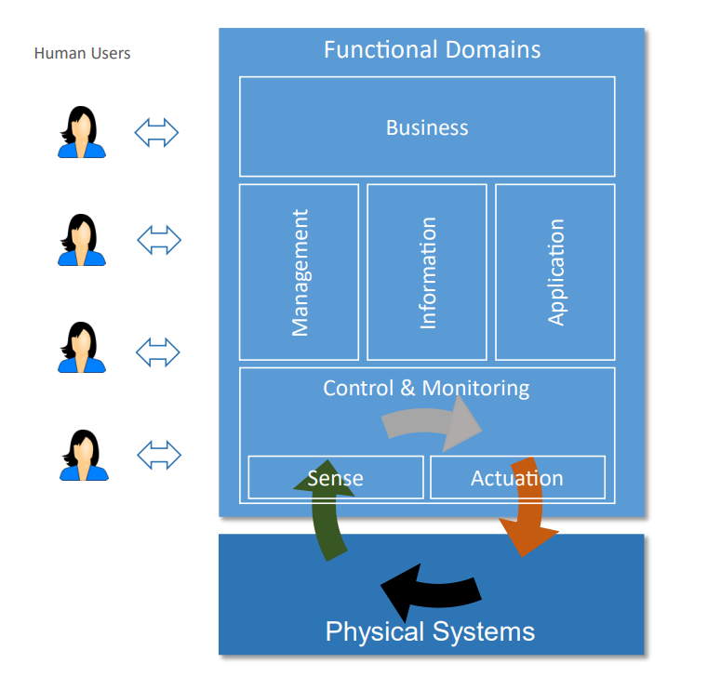
docs/polsl/temporary_project/build/images/iira-functional.png
