kopiecki/anc/docs/polsl/temporary_project/build/images/iira-usage.png

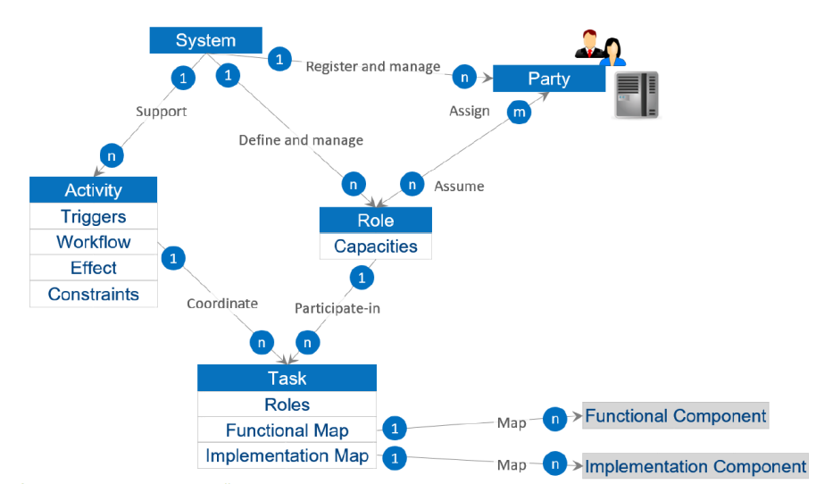
docs/polsl/temporary_project/build/images/iira-usage.png
