kopiecki/anc/docs/polsl/temporary_project/build/images/iira-visions.png

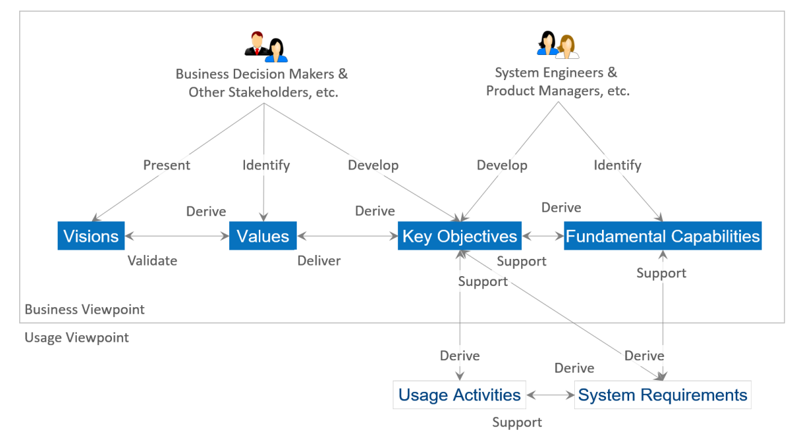
docs/polsl/temporary_project/build/images/iira-visions.png
