kopiecki/anc/docs/polsl/thesis/graf/verification/alpha_120hz_1.png

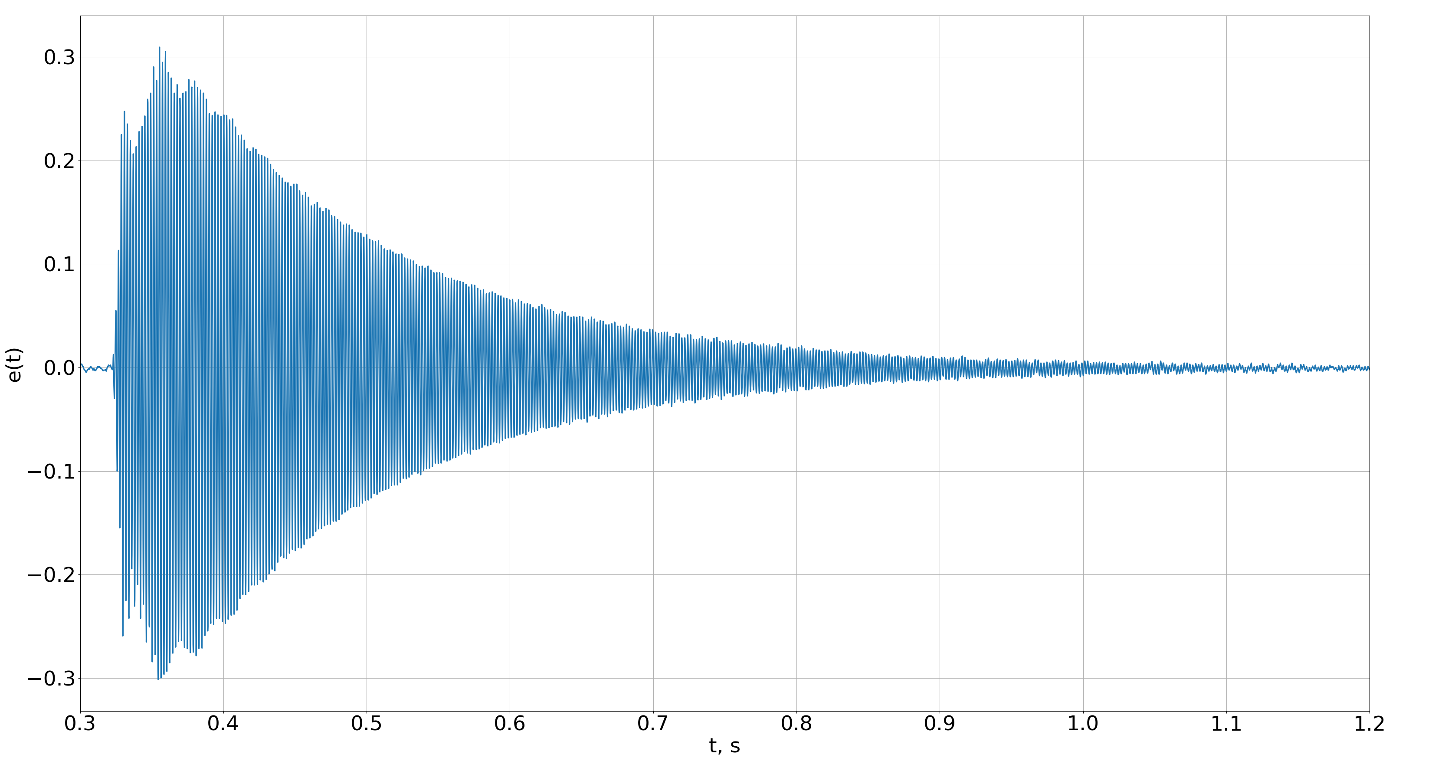
docs/polsl/thesis/graf/verification/alpha_120hz_1.png
