kopiecki/anc/docs/polsl/thesis/graf/verification/alpha_120hz_2.png

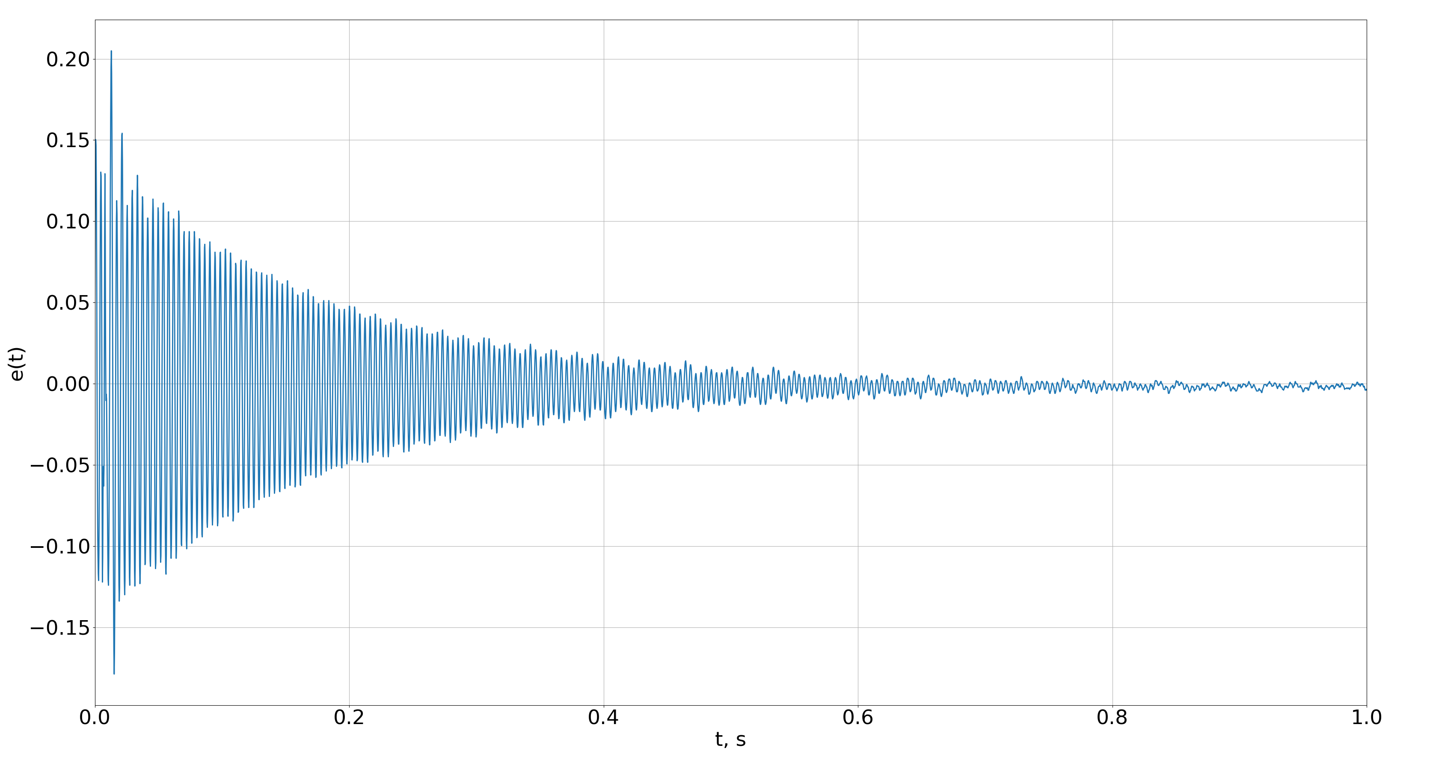
docs/polsl/thesis/graf/verification/alpha_120hz_2.png
