kopiecki/anc/docs/polsl/thesis/graf/verification/alpha_120hz_4.png

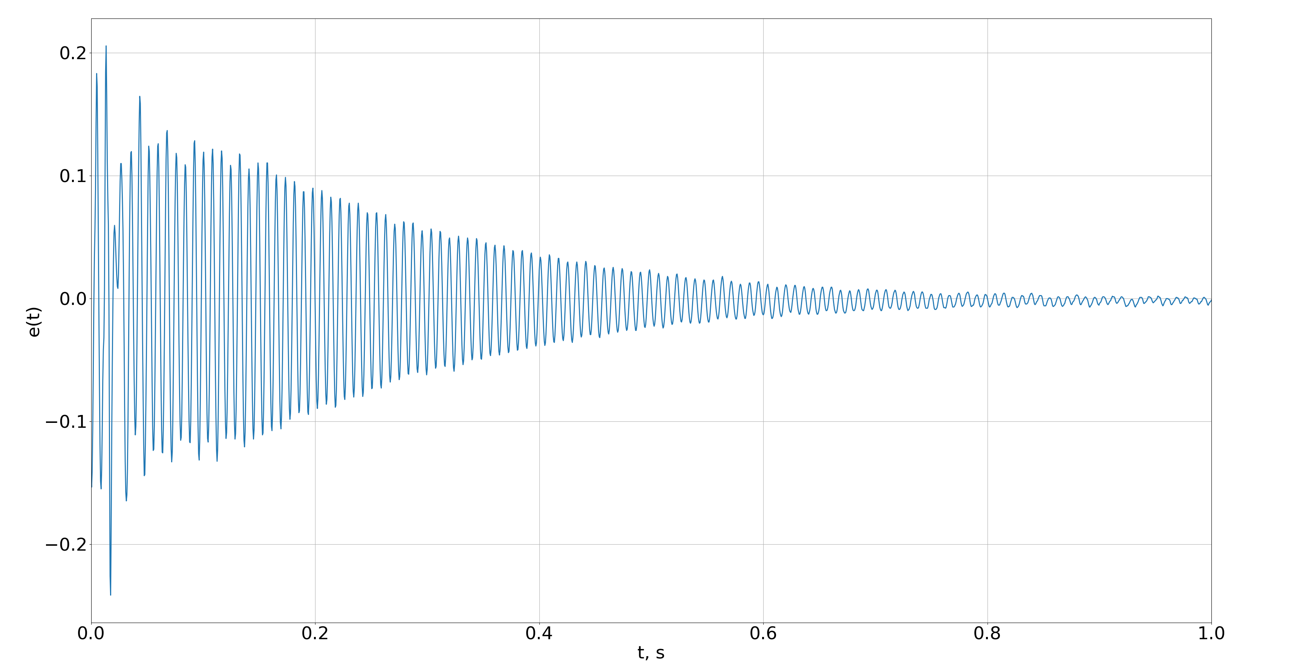
docs/polsl/thesis/graf/verification/alpha_120hz_4.png
