kopiecki/anc/docs/polsl/thesis/graf/verification/alpha_120hz_5.png

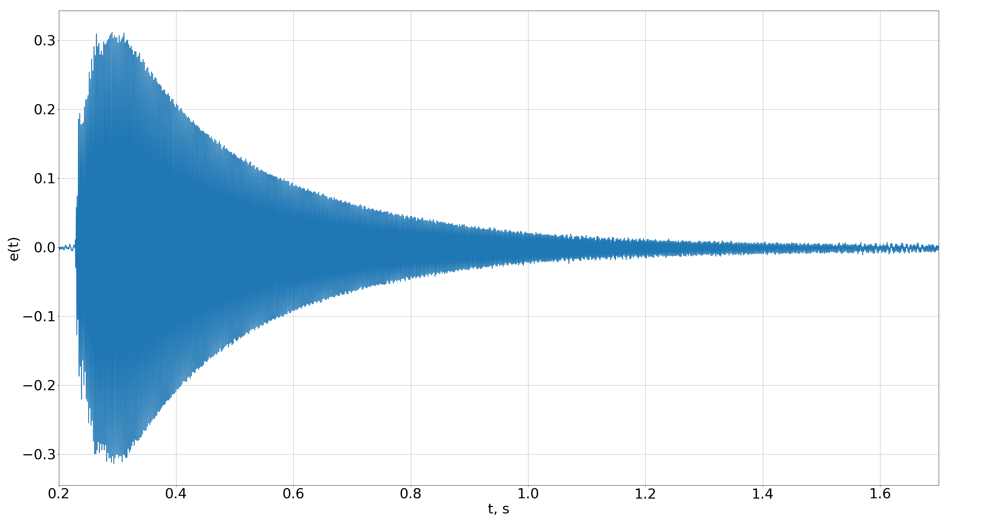
docs/polsl/thesis/graf/verification/alpha_120hz_5.png
