kopiecki/anc/docs/polsl/thesis/graf/verification/alpha_120hz_25.png

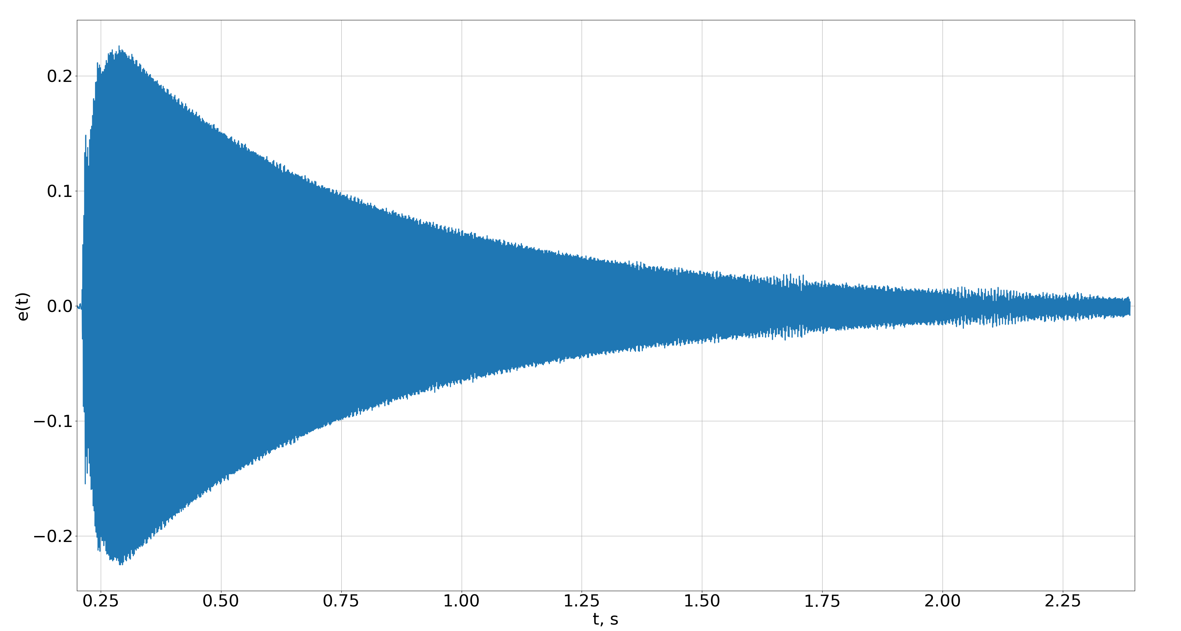
docs/polsl/thesis/graf/verification/alpha_120hz_25.png
