kopiecki/anc/docs/polsl/thesis/graf/verification/alpha_120hz_75.png

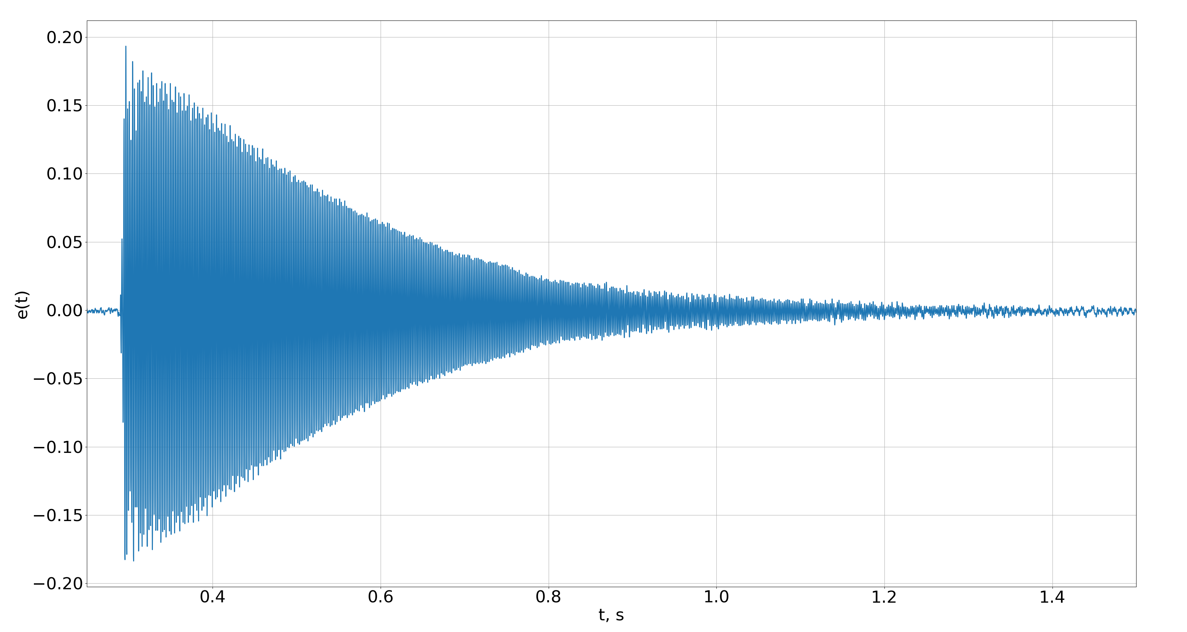
docs/polsl/thesis/graf/verification/alpha_120hz_75.png
