kopiecki/anc/docs/polsl/thesis/graf/verification/alpha_sum_4.png

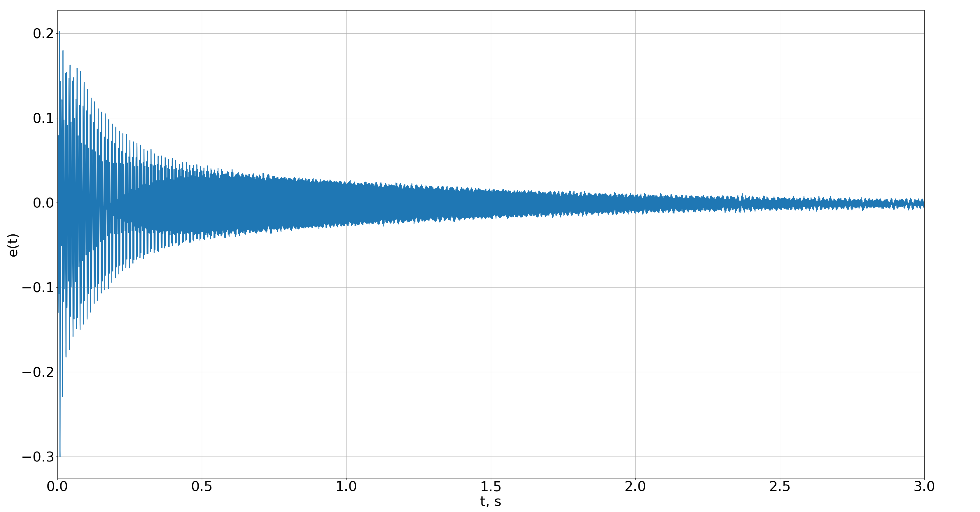
docs/polsl/thesis/graf/verification/alpha_sum_4.png
