kopiecki/anc/docs/polsl/thesis/graf/verification/alpha_sum_6.png

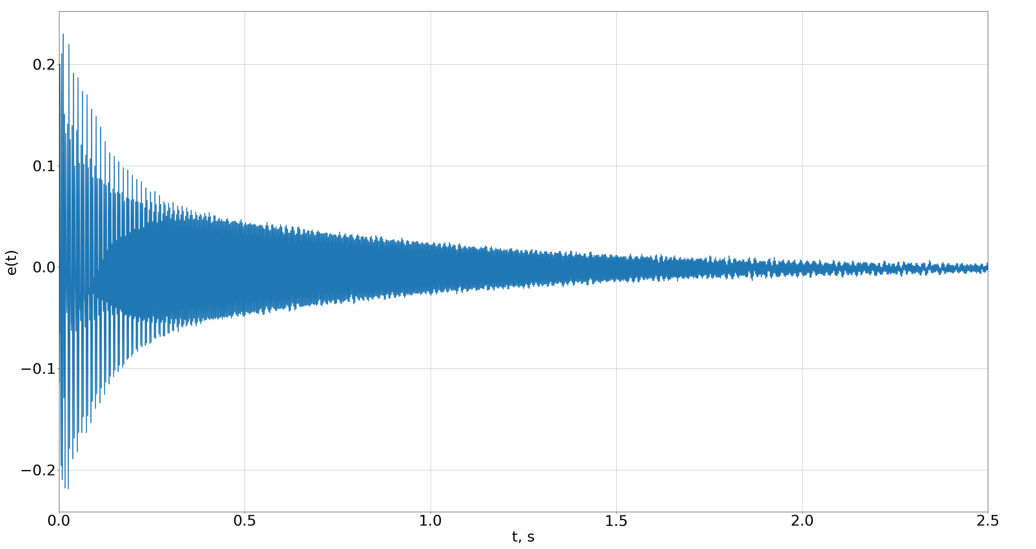
docs/polsl/thesis/graf/verification/alpha_sum_6.png
