kopiecki/anc/docs/polsl/thesis/graf/verification/anc_opc.png

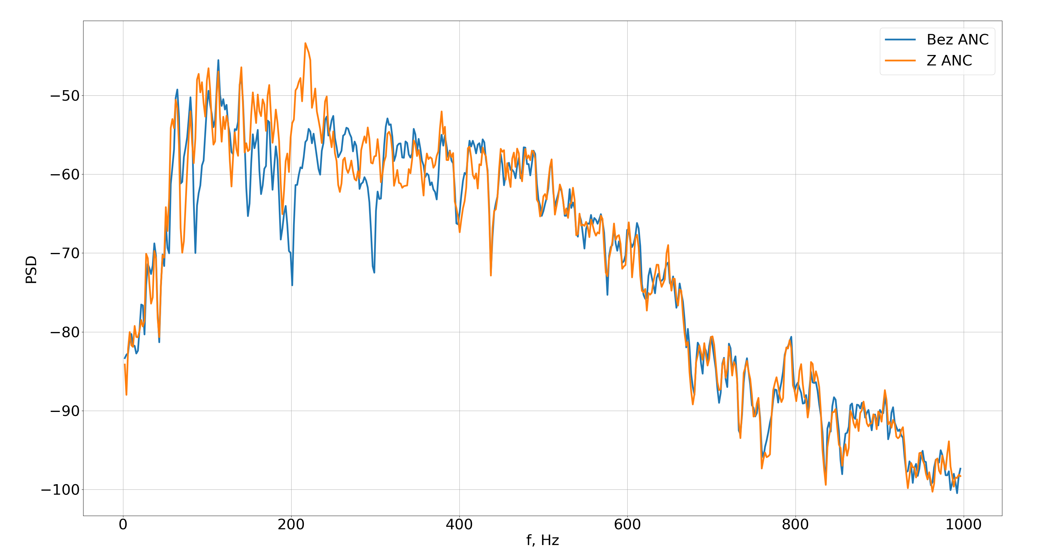
docs/polsl/thesis/graf/verification/anc_opc.png
