kopiecki/anc/docs/polsl/thesis/graf/verification/anc_rand.png

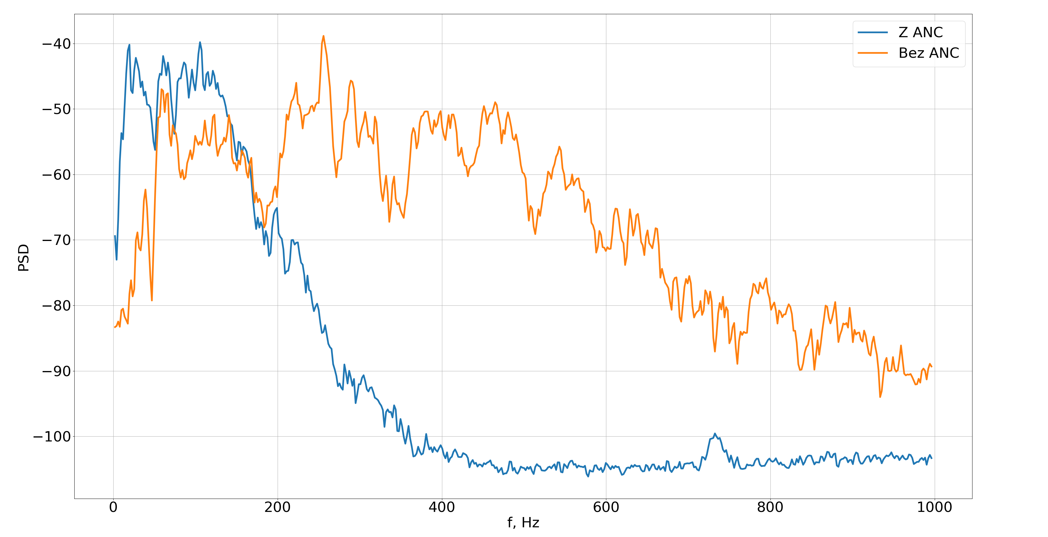
docs/polsl/thesis/graf/verification/anc_rand.png
