kopiecki/anc/docs/polsl/thesis/graf/verification/anc_rand_0.png

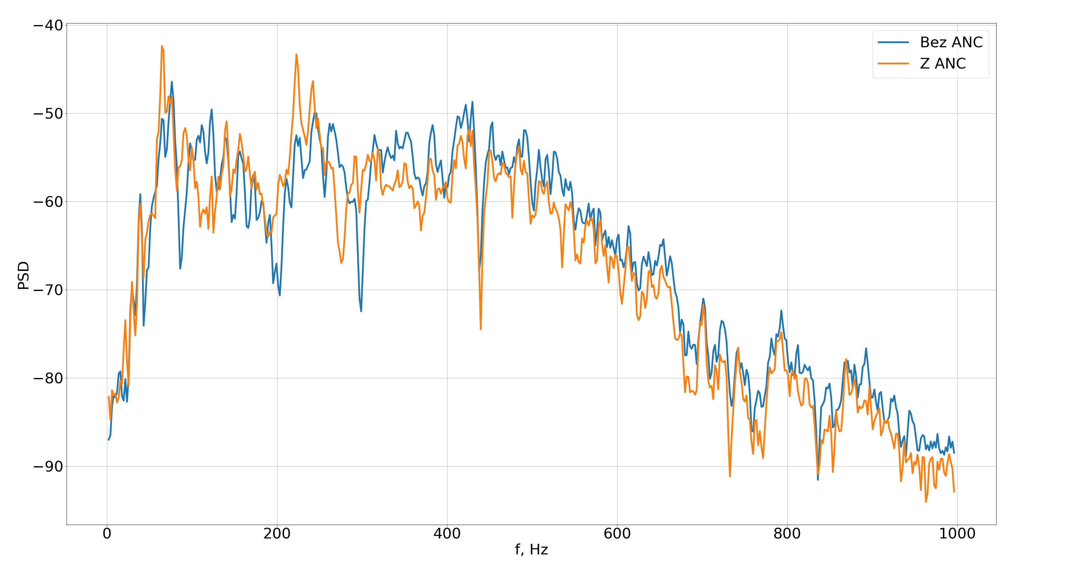
docs/polsl/thesis/graf/verification/anc_rand_0.png
