kopiecki/anc/docs/polsl/thesis/graf/verification/anc_rand_1.png

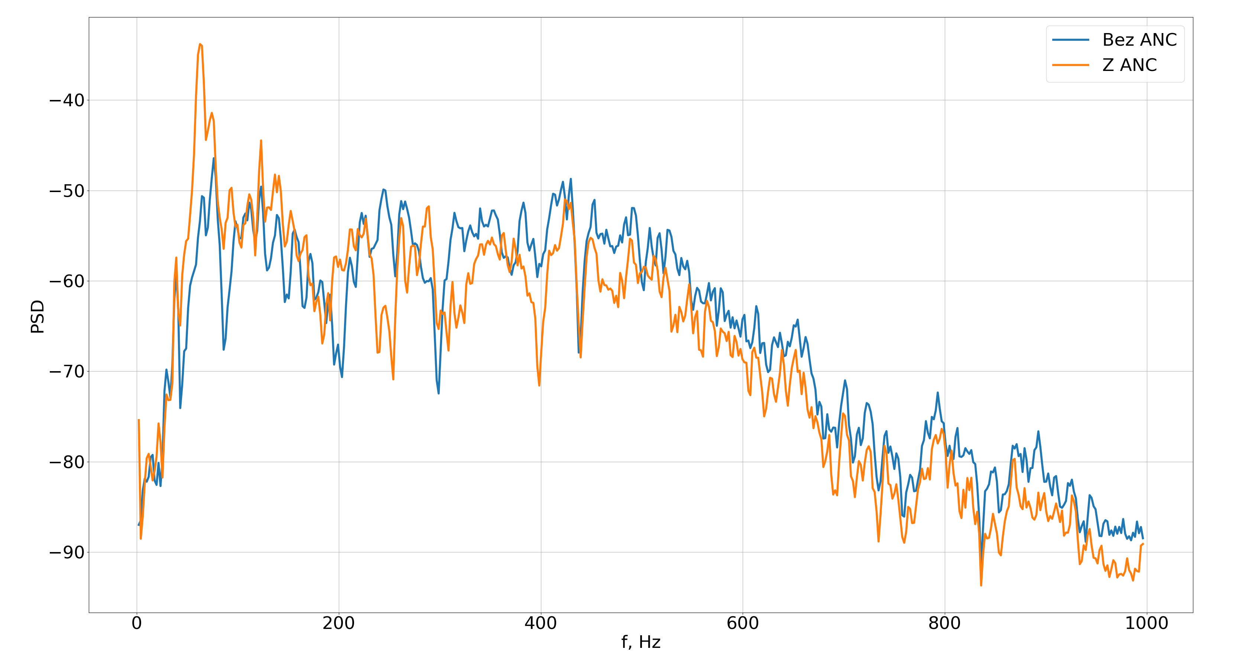
docs/polsl/thesis/graf/verification/anc_rand_1.png
