kopiecki/anc/docs/polsl/thesis/graf/verification/ident_0.png

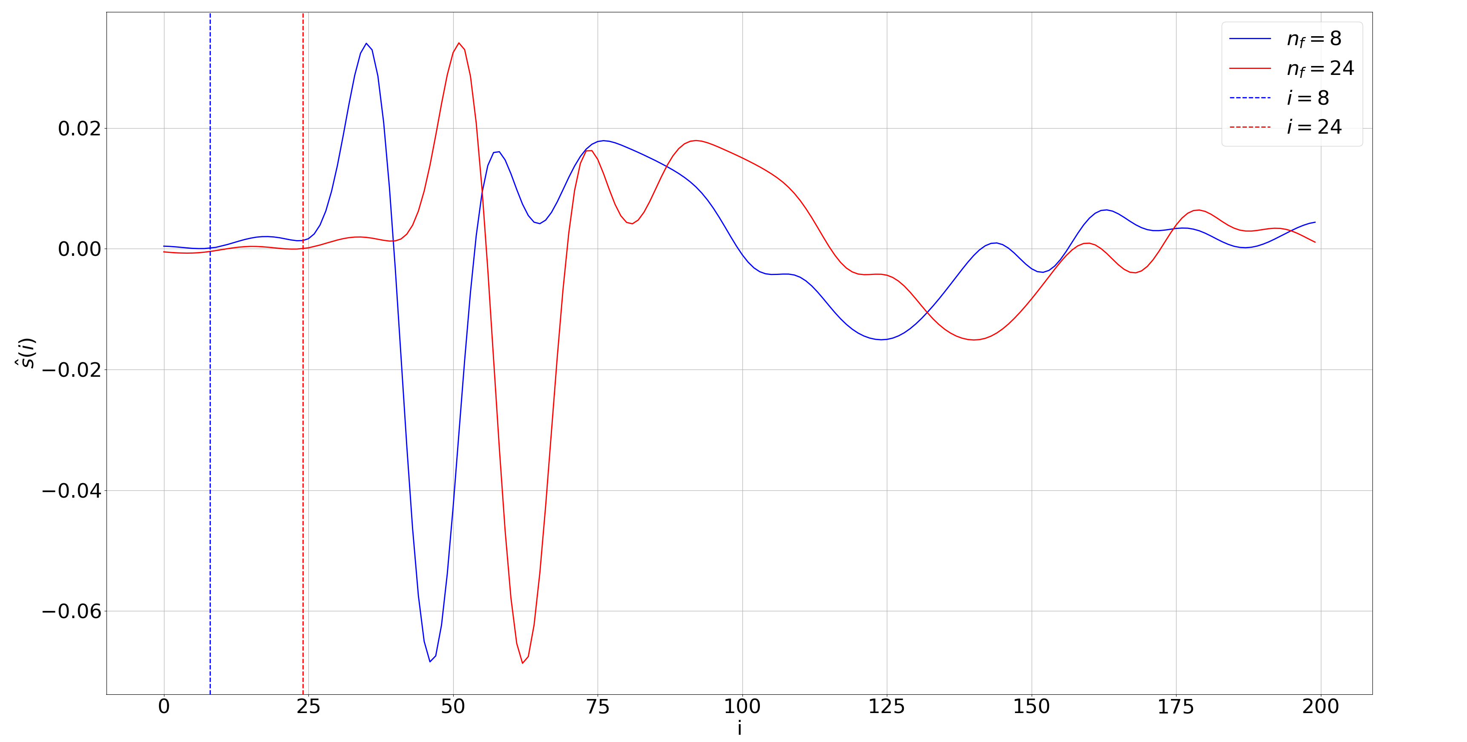
docs/polsl/thesis/graf/verification/ident_0.png
