kopiecki/anc/docs/polsl/thesis/graf/verification/ident_1.png

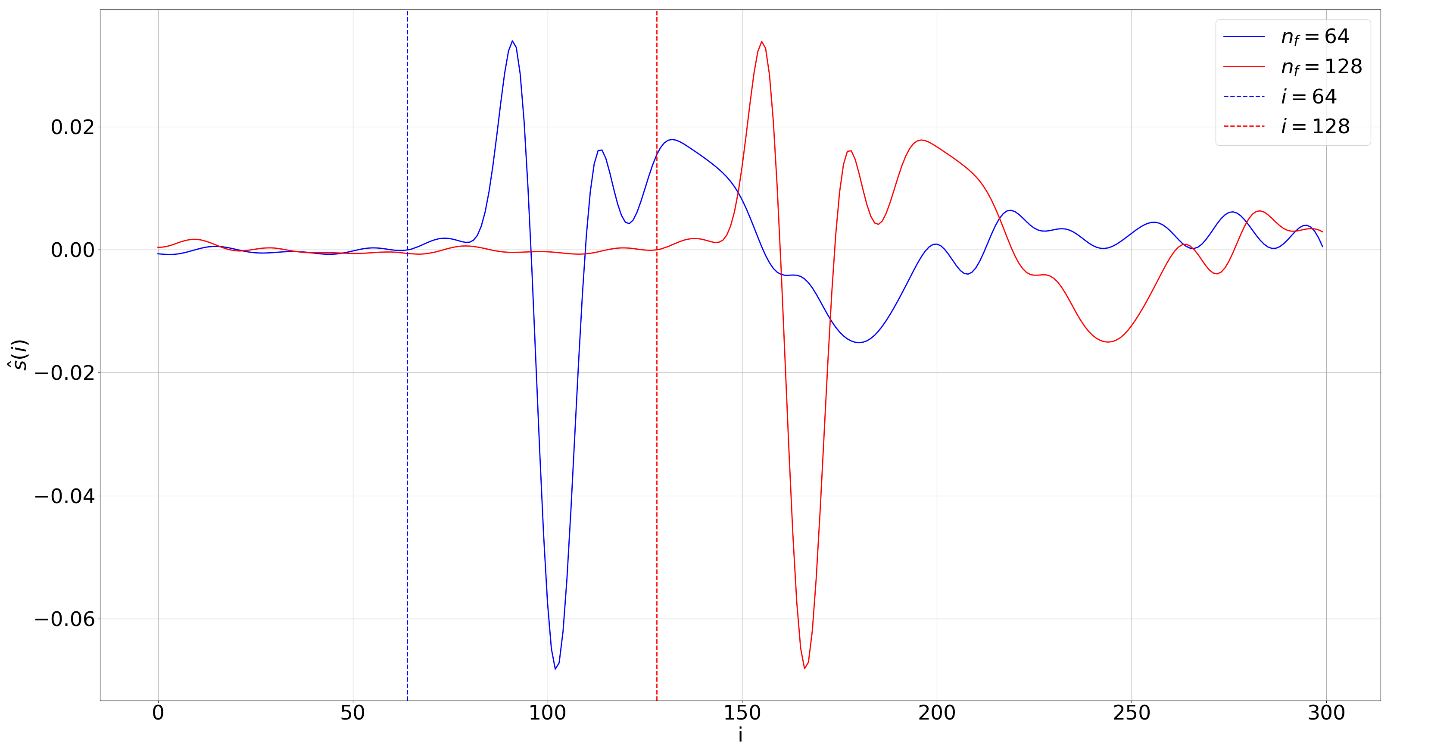
docs/polsl/thesis/graf/verification/ident_1.png
