kopiecki/anc/docs/polsl/thesis/graf/verification/mlyny.png

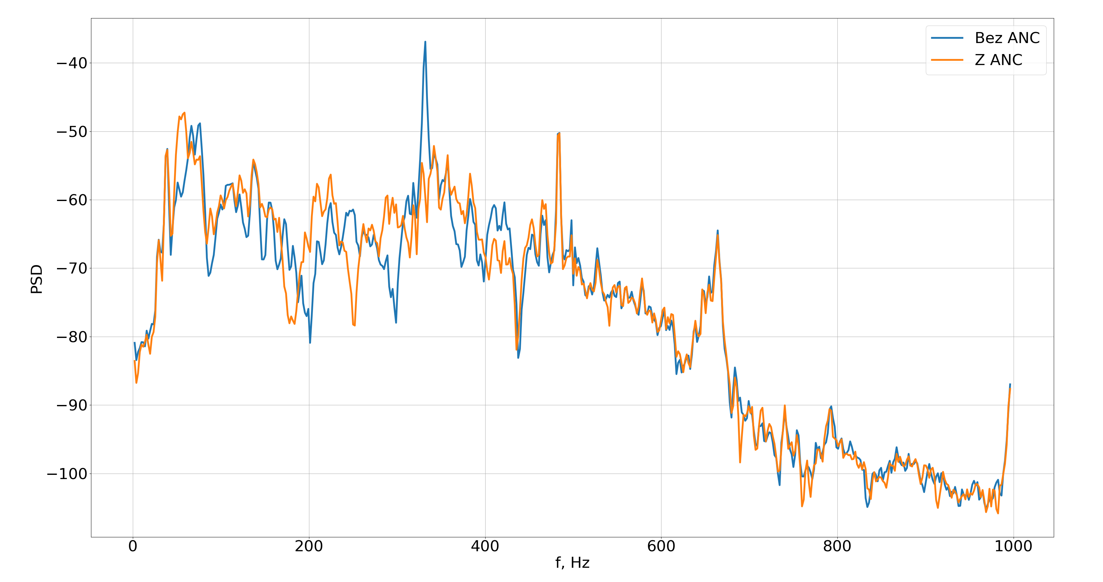
docs/polsl/thesis/graf/verification/mlyny.png
