kopiecki/anc/hardware/schemes/schematic.pdf

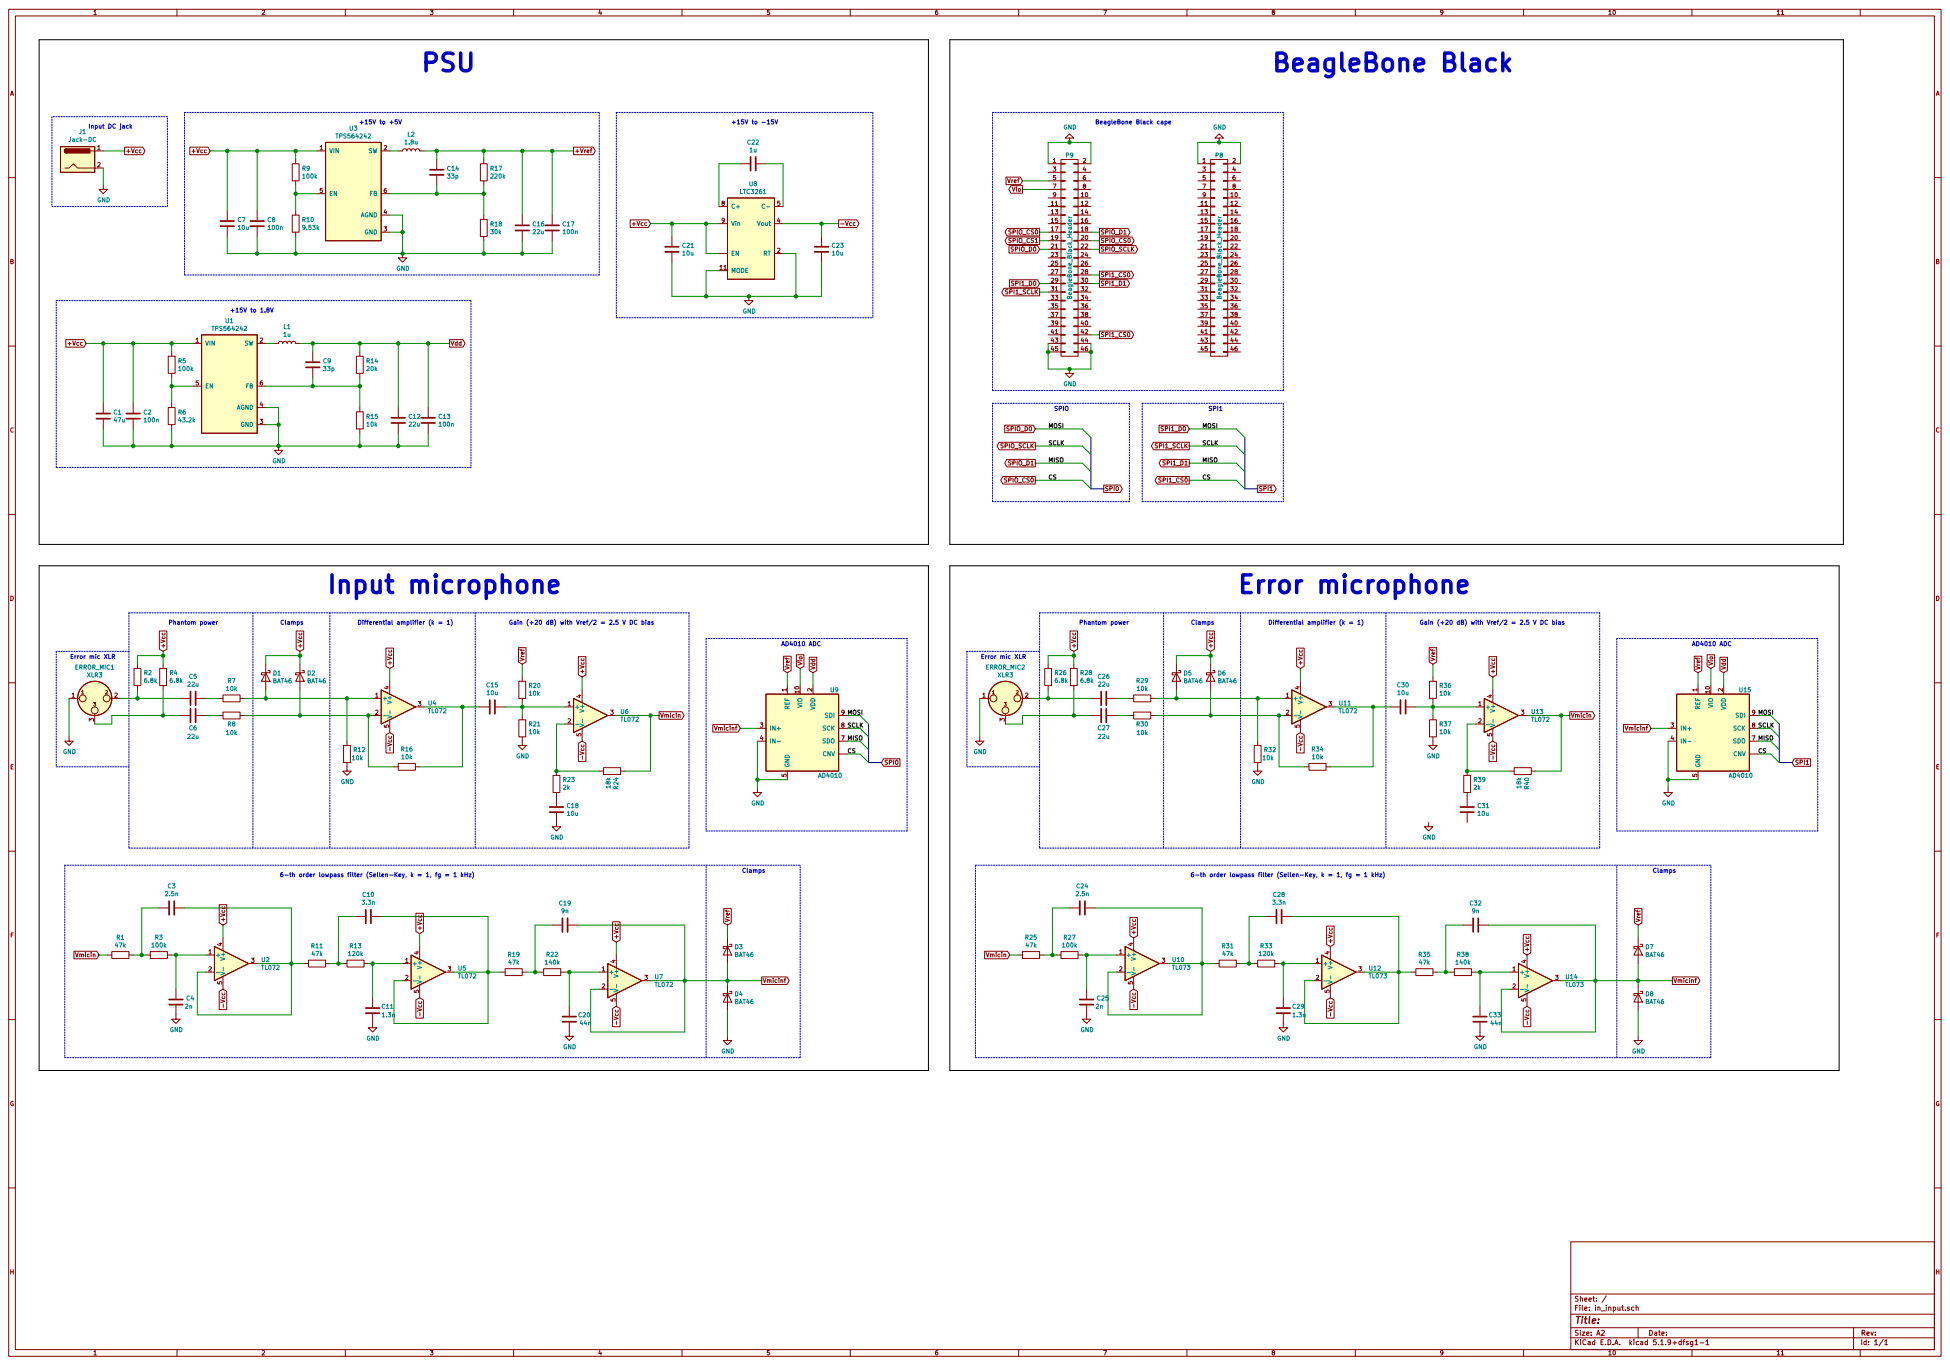
[picture p398: page 1]

+15V to +5V Input DC jack
Jack-DC

Gain (+20 dB) with Vref/2 = 2.5 V DC bias

SCLK Clamps Error mic XLR

5 SDO 7 SCK 8 SDI 9 CNVU9 AD4010 GND

6-th order lowpass filter (Sellen-Key, k = 1, fg = 1 kHz)
