kopiecki/anc/electronics/schemes/in_input.pdf

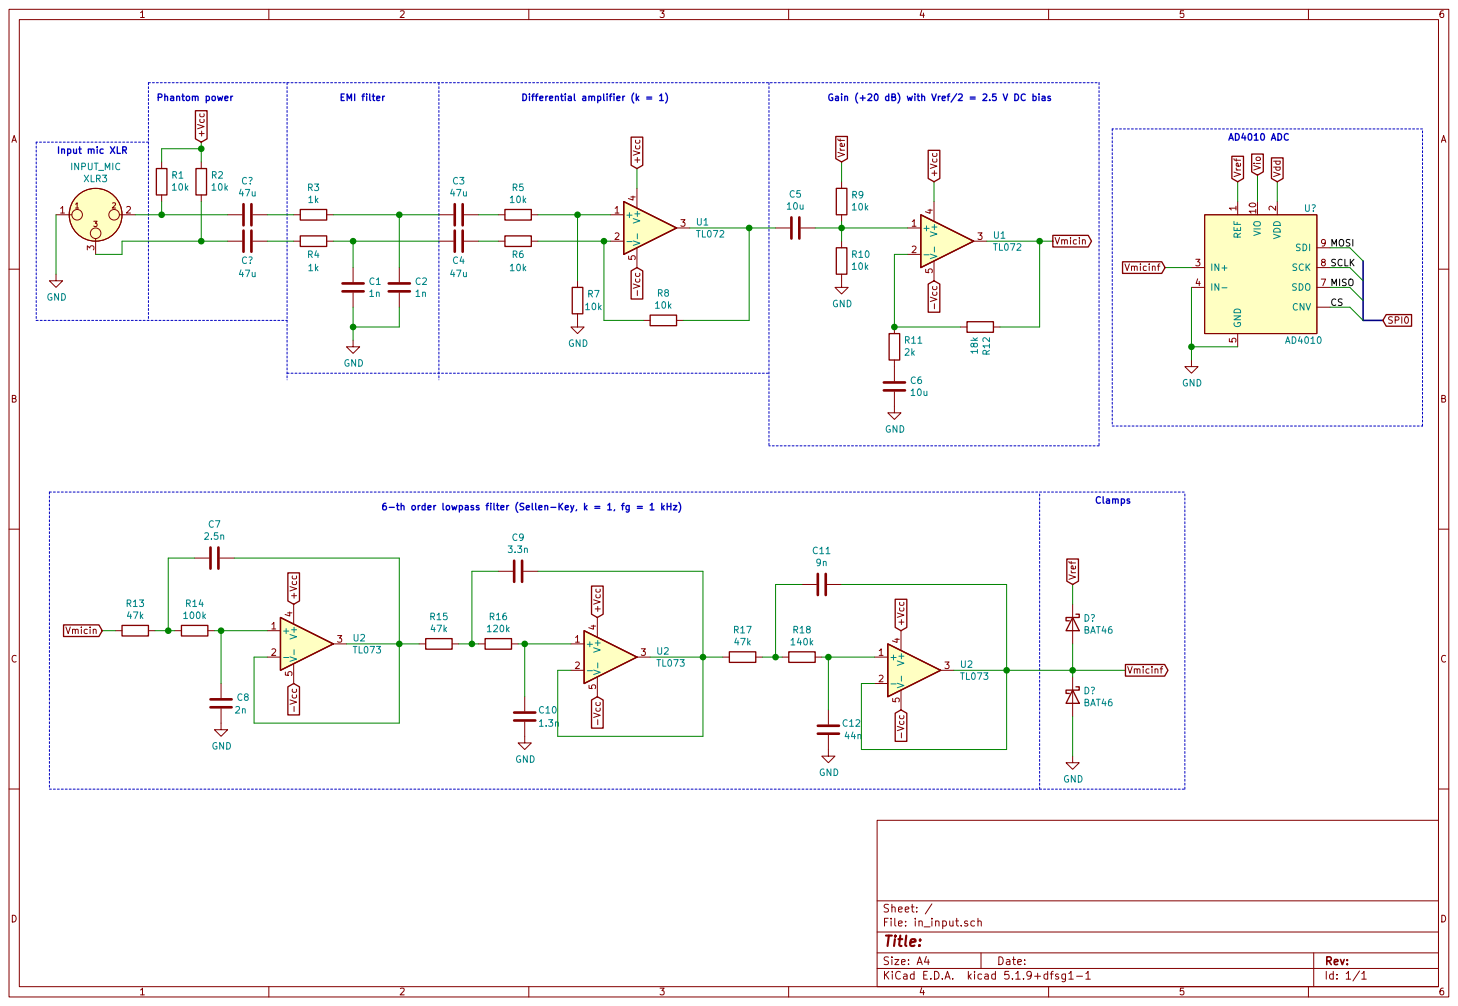
[picture p399: page 1]

5 SDO 7 SCK 8 SDI 9 CNVU? AD4010 R7

6-th order lowpass filter (Sellen-Key, k = 1, fg = 1 kHz)
