kopiecki/anc/electronics/schemes/psu.pdf

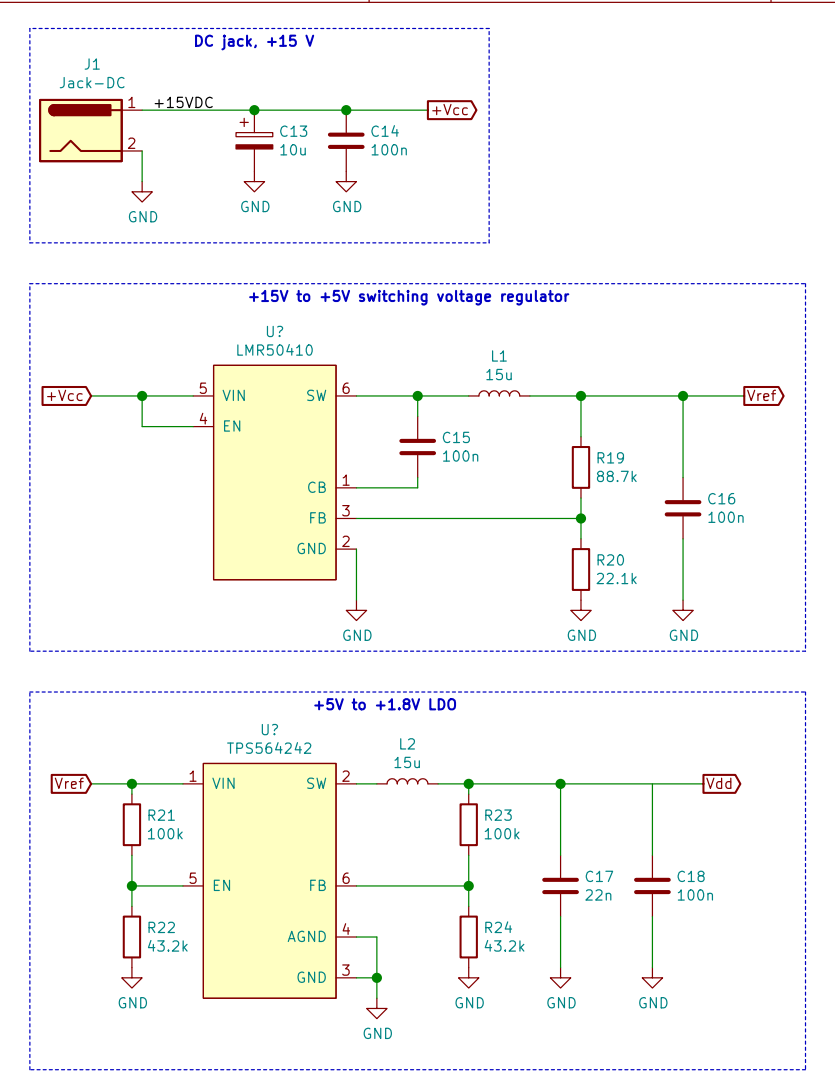
[picture p400: page 1]

+15V to +5V switching voltage regulator +5V to +1.8V LDO
