kopiecki/anc/in_input.pdf

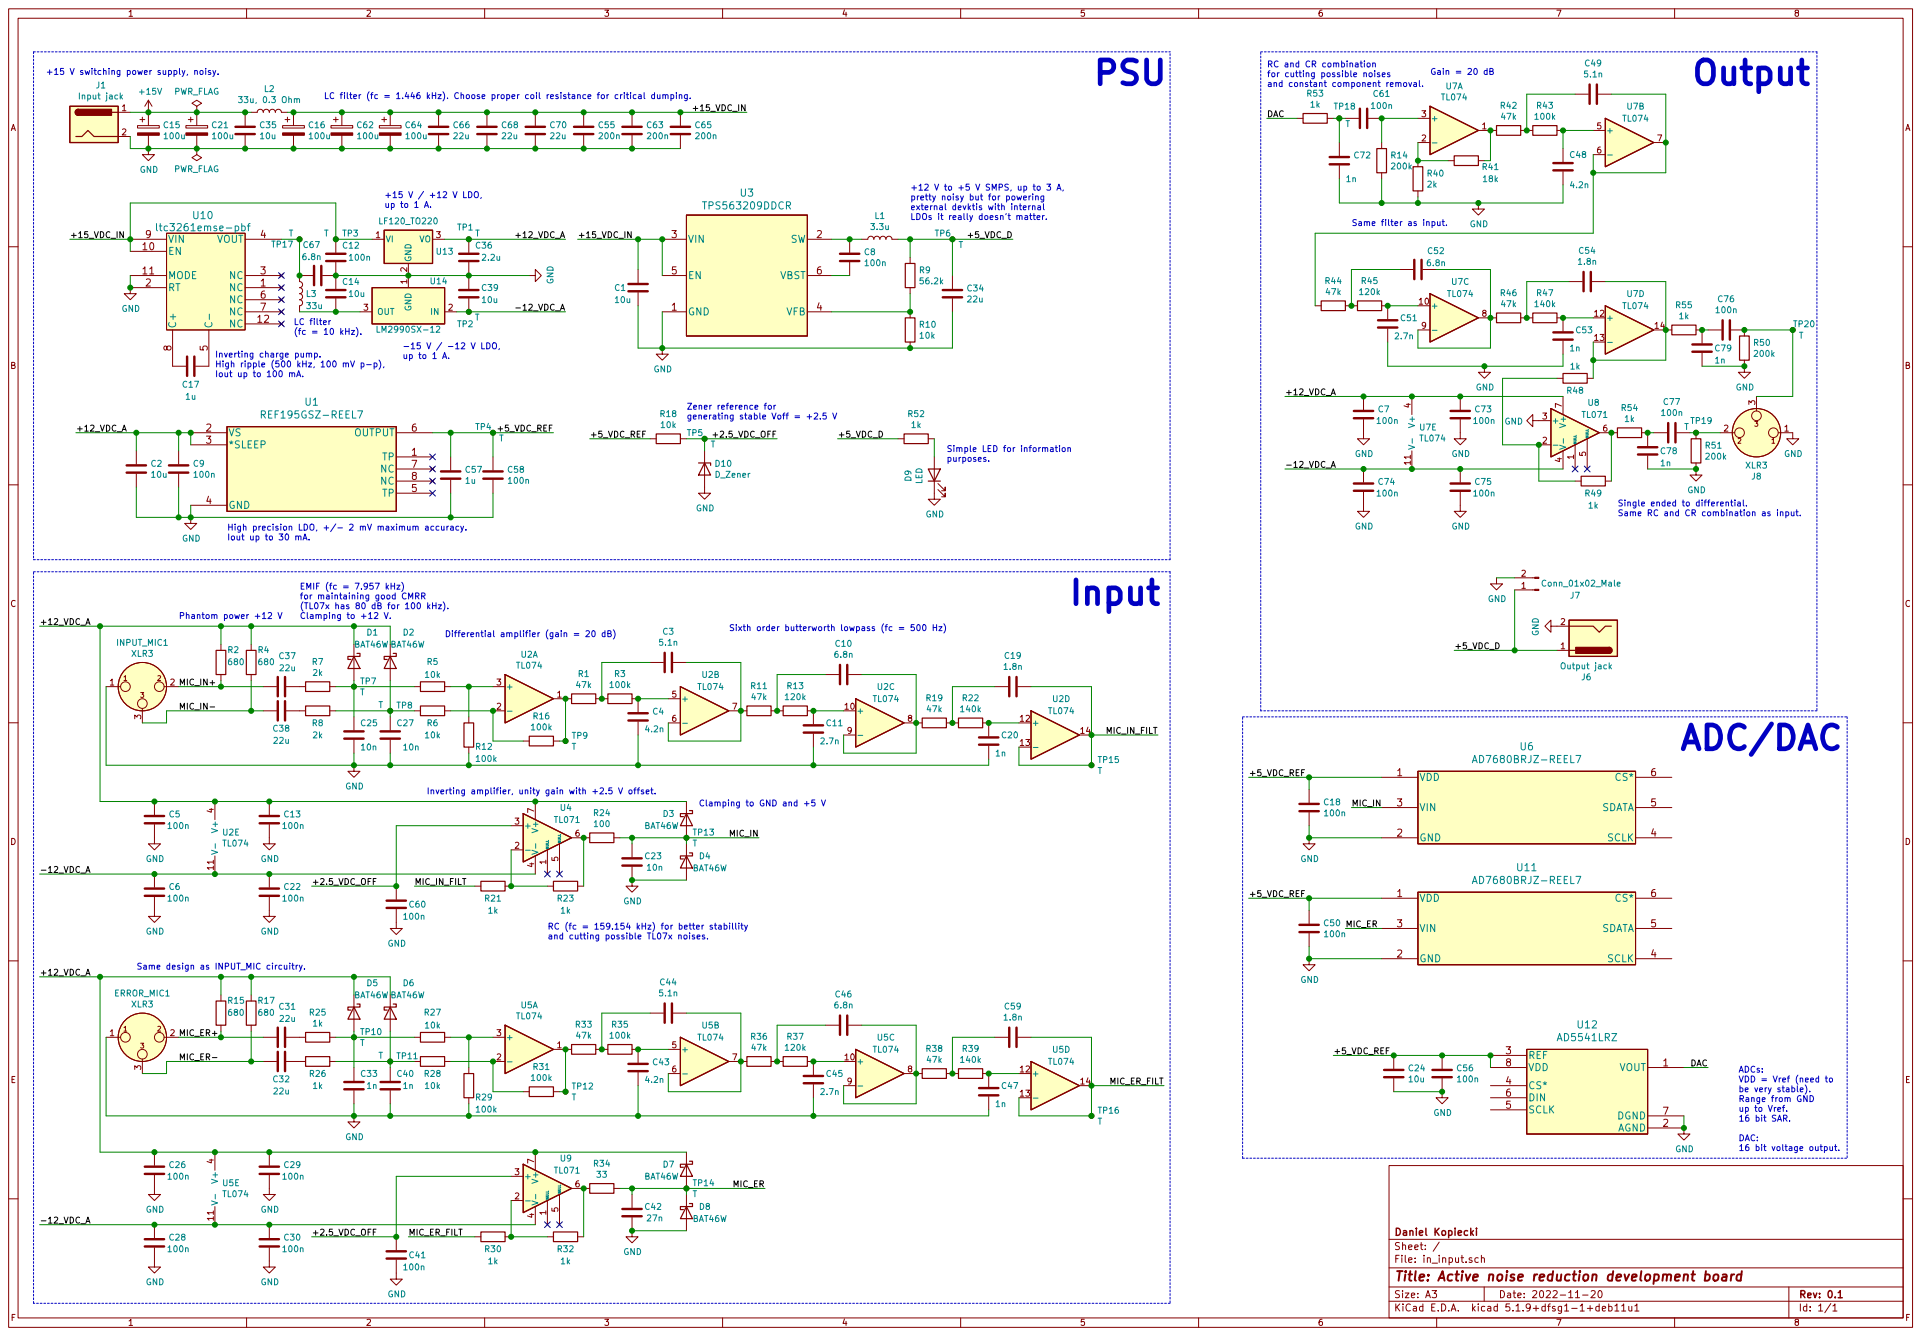
[picture p401: page 1]

+15 V switching power supply, noisy.

for cutting possible noises
and constant component removal.

LC filter (fc = 1.446 kHz). Choose proper coil resistance for critical dumping.

+12 V to +5 V SMPS, up to 3 A,
pretty noisy but for powering external devktis with internal LDOs it really doesn't matter.

Same filter as input.

Inverting charge pump.
High ripple (500 kHz, 100 mV p-p),
Iout up to 100 mA.

purposes. Zener reference for generating stable Voff = +2.5 V

Simple LED for information

Single ended to differential.
Same RC and CR combination as input.

High precision LDO, +/- 2 mV maximum accuracy.
Iout up to 30 mA.

EMIF (fc = 7.957 kHz)
for maintaining good CMRR
(TL07x has 80 dB for 100 kHz).
Clamping to +12 V.

Sixth order butterworth lowpass (fc = 500 Hz)

Differential amplifier (gain = 20 dB)

3 ERROR_MIC1 XLR3 GND VDD 1 GND 2 VIN 3 SCLK

Inverting amplifier, unity gain with +2.5 V offset.

Clamping to GND and +5 V

RC (fc = 159.154 kHz) for better stabillity
and cutting possible TL07x noises.

Same design as INPUT_MIC circuitry.

ADCs: VDD = Vref (need to

be very stable).
Range from GND
up to Vref. 16 bit SAR. DAC: 16 bit voltage output.

File: in_input.sch Sheet: / Daniel Kopiecki

Id: 1/1 Title: Active noise reduction development board
