kopiecki/anc/docs/after_review.pdf

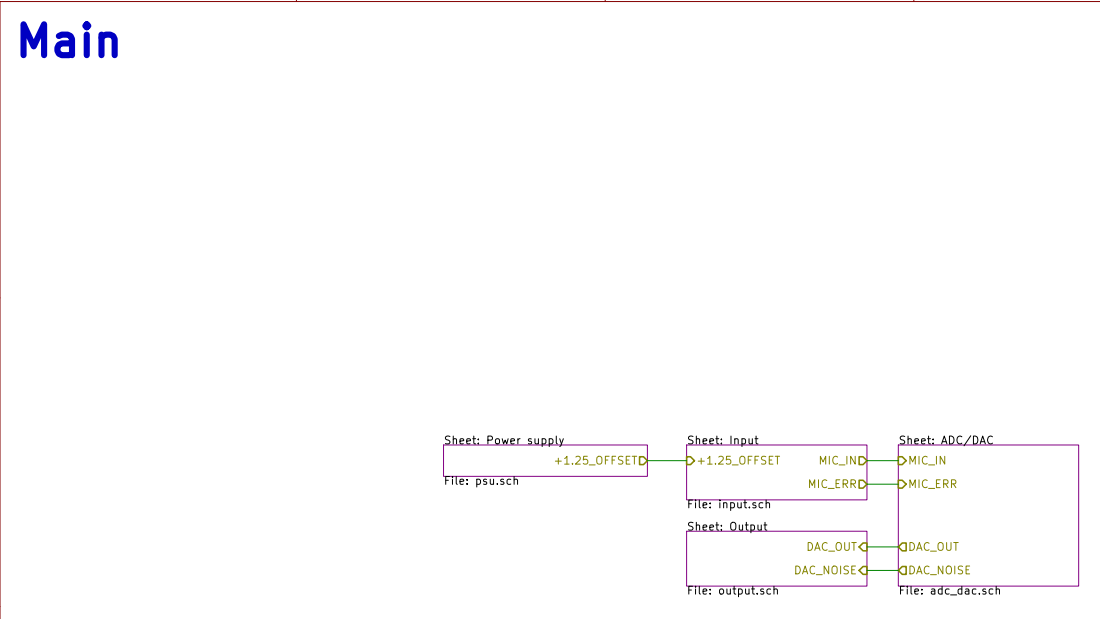
[picture p402: page 1]

File: main.sch Sheet: / Daniel Kopiecki

Id: 1/5 Title: Active noise reduction development board - main

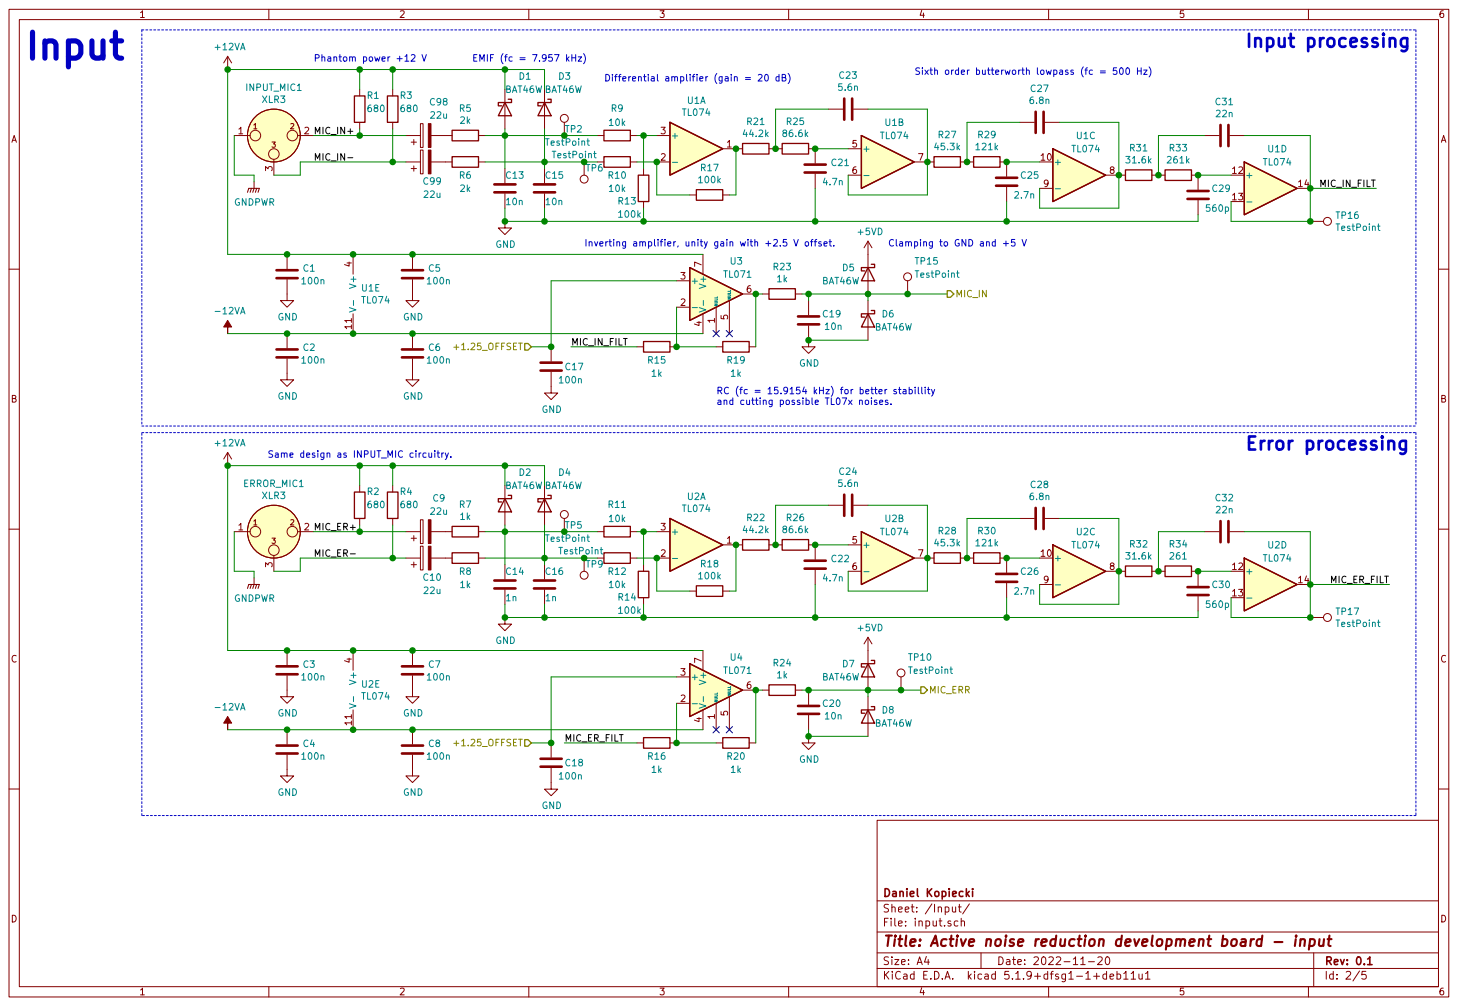
[picture p403: page 2]

and cutting possible TL07x noises.

Same design as INPUT_MIC circuitry.

Daniel Kopiecki
Sheet: /Input/
File: input.sch
Id: 2/5 Title: Active noise reduction development board - input

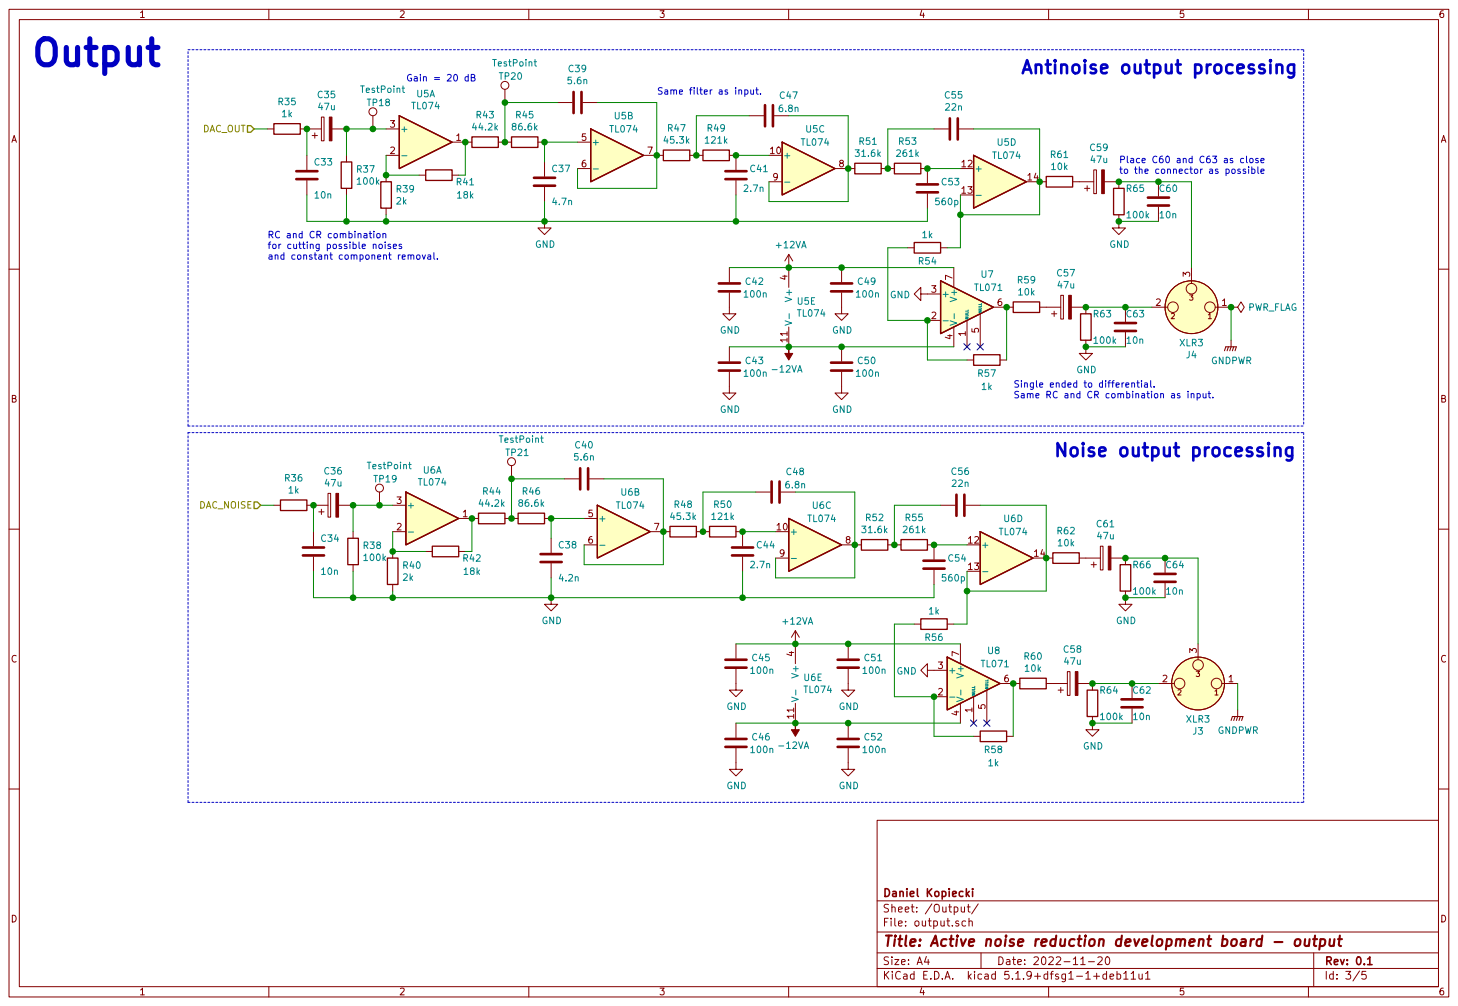
[picture p404: page 3]

and constant component removal.Gain = 20 dB

Same filter as input.

to the connector as possible RC and CR combination

Place C60 and C63 as close

for cutting possible noises

Single ended to differential.
Same RC and CR combination as input.

Sheet: /Output/
File: output.sch
Id: 3/5 Title: Active noise reduction development board - output

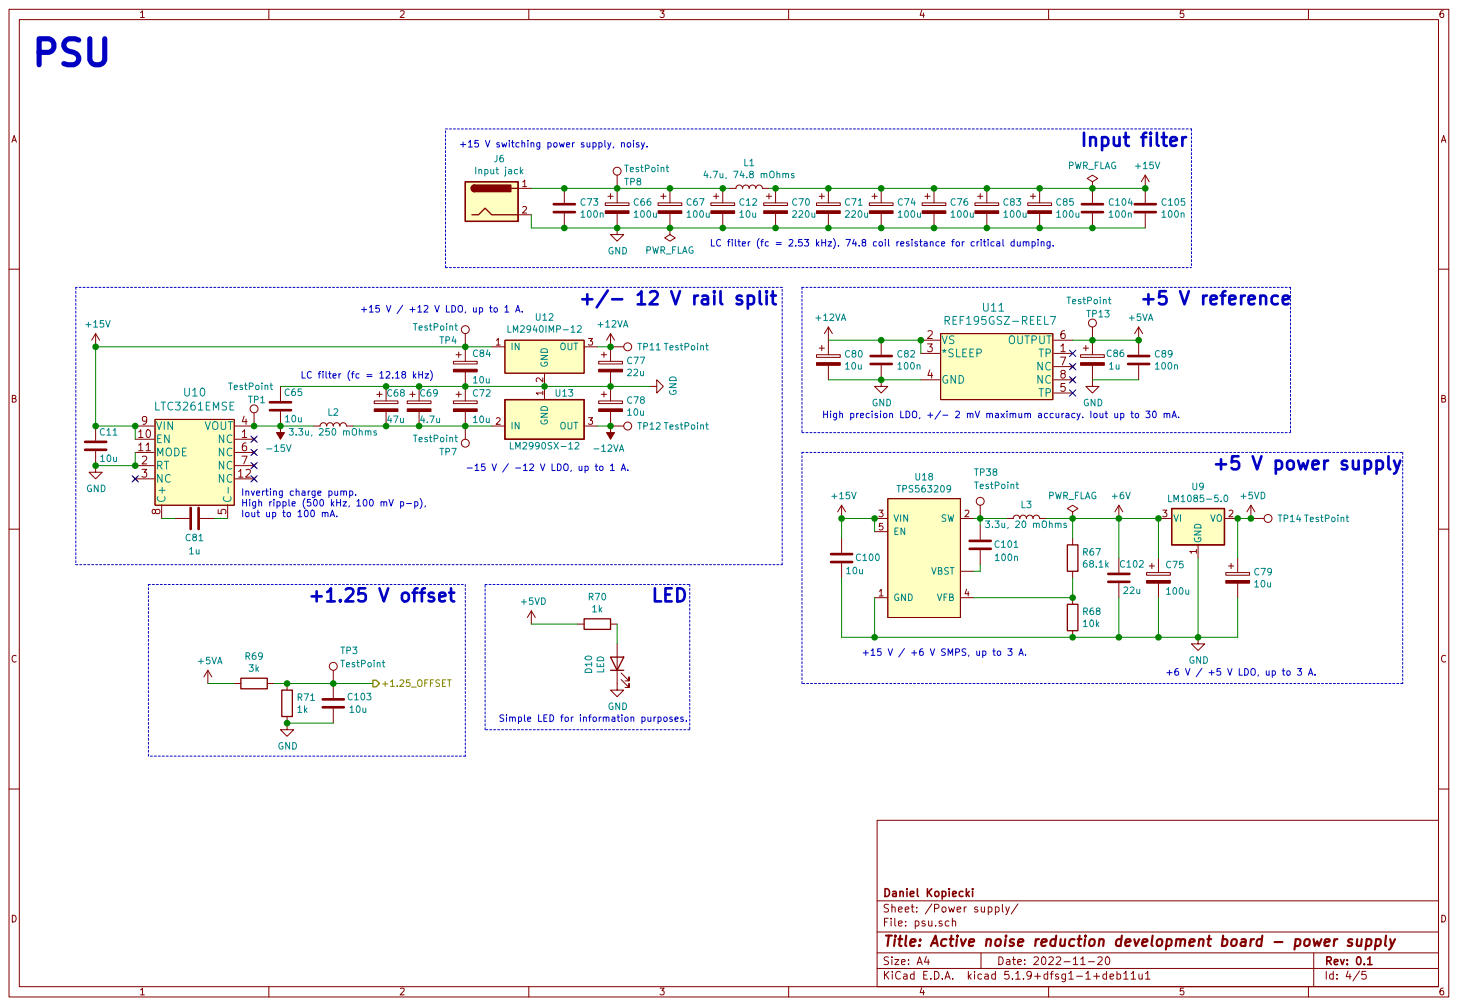
[picture p405: page 4]

LC filter (fc = 2.53 kHz). 74.8 coil resistance for critical dumping.

LC filter (fc = 12.18 kHz)

High precision LDO, +/- 2 mV maximum accuracy. Iout up to 30 mA.

Inverting charge pump.
High ripple (500 kHz, 100 mV p-p),
Iout up to 100 mA.

Simple LED for information purposes.

Sheet: /Power supply/
File: psu.sch
Id: 4/5 Title: Active noise reduction development board - power supply

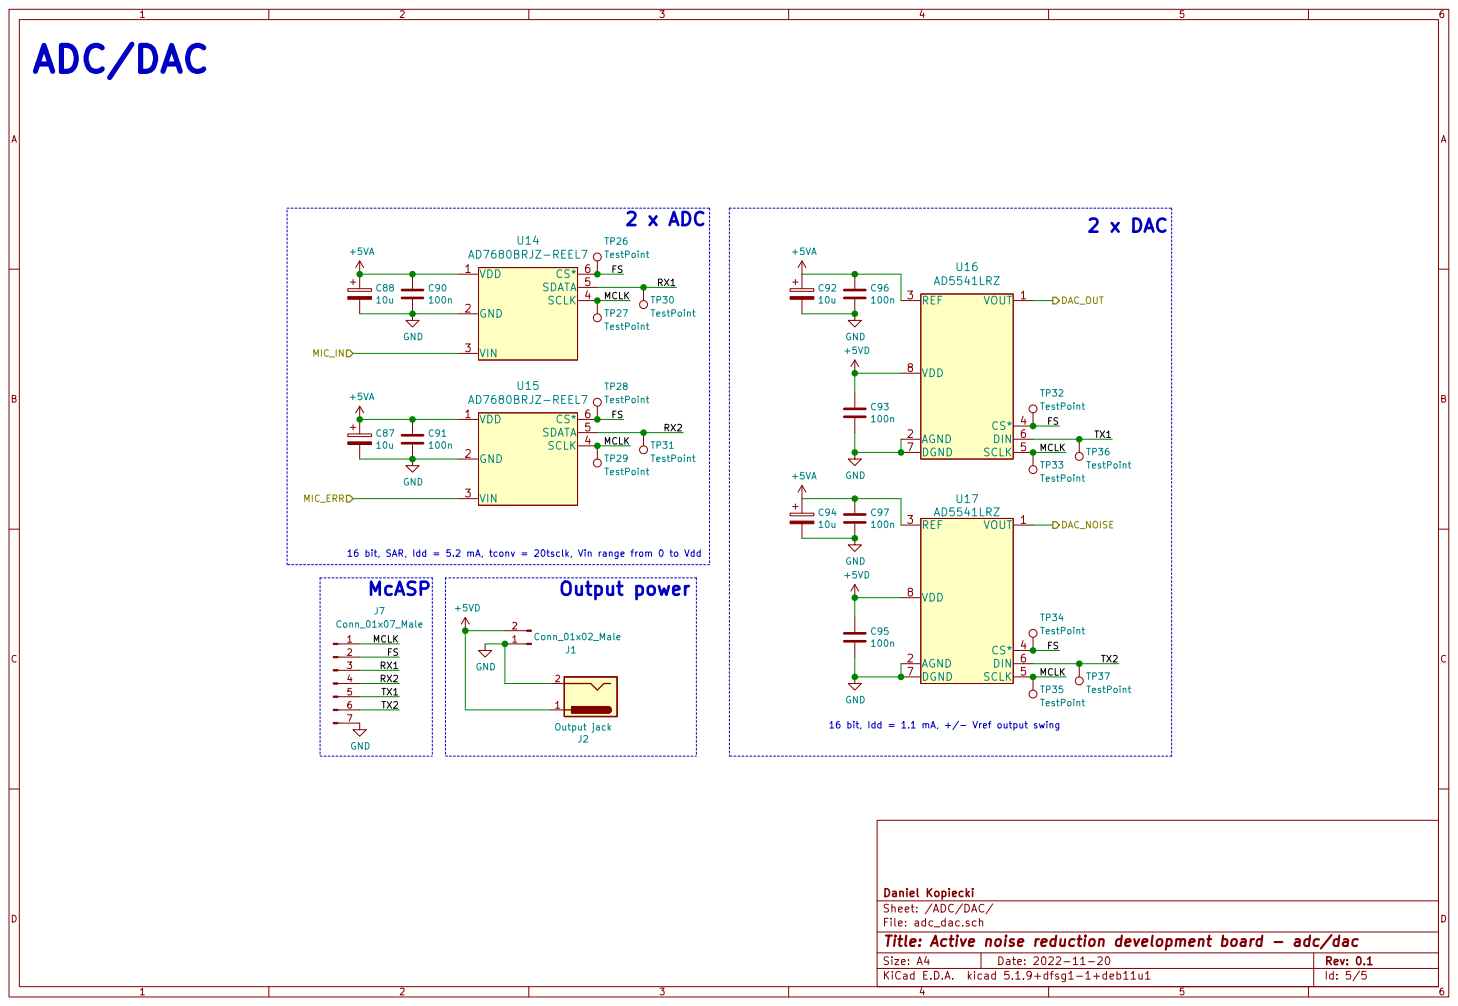
[picture p406: page 5]

16 bit, SAR, Idd = 5.2 mA, tconv = 20tsclk, Vin range from 0 to Vdd
McASP

16 bit, Idd = 1.1 mA, +/- Vref output swing

File: adc_dac.sch Sheet: /ADC/DAC/ Daniel Kopiecki

Id: 5/5 Title: Active noise reduction development board - adc/dac
