kopiecki/anc/docs/pre_review.pdf

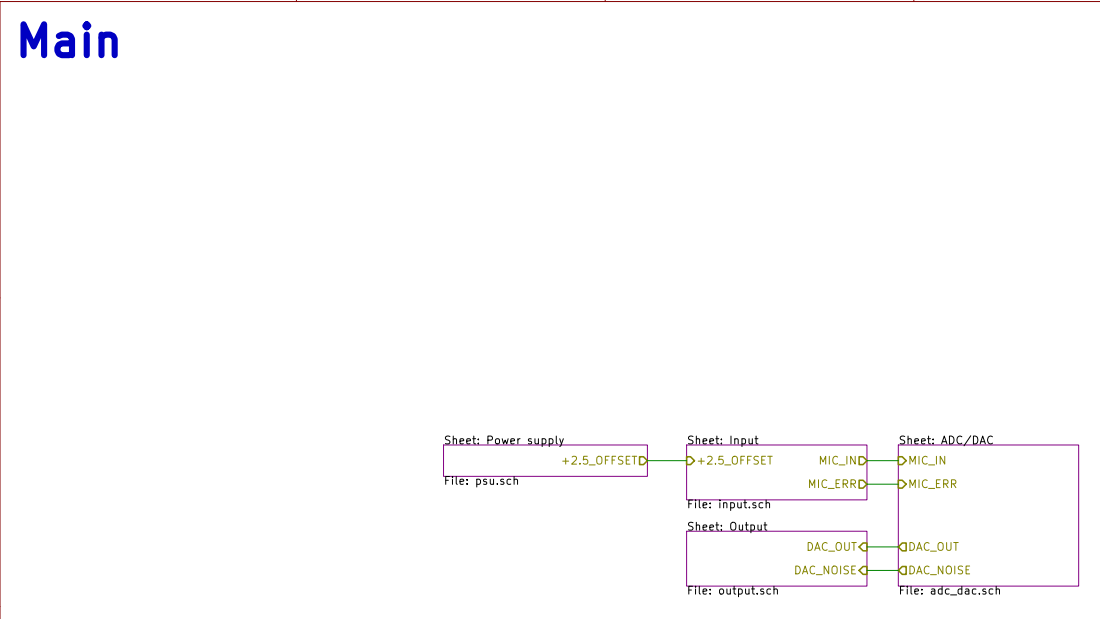
[picture p407: page 1]

File: main.sch Sheet: / Daniel Kopiecki

Id: 1/5 Title: Active noise reduction development board - main

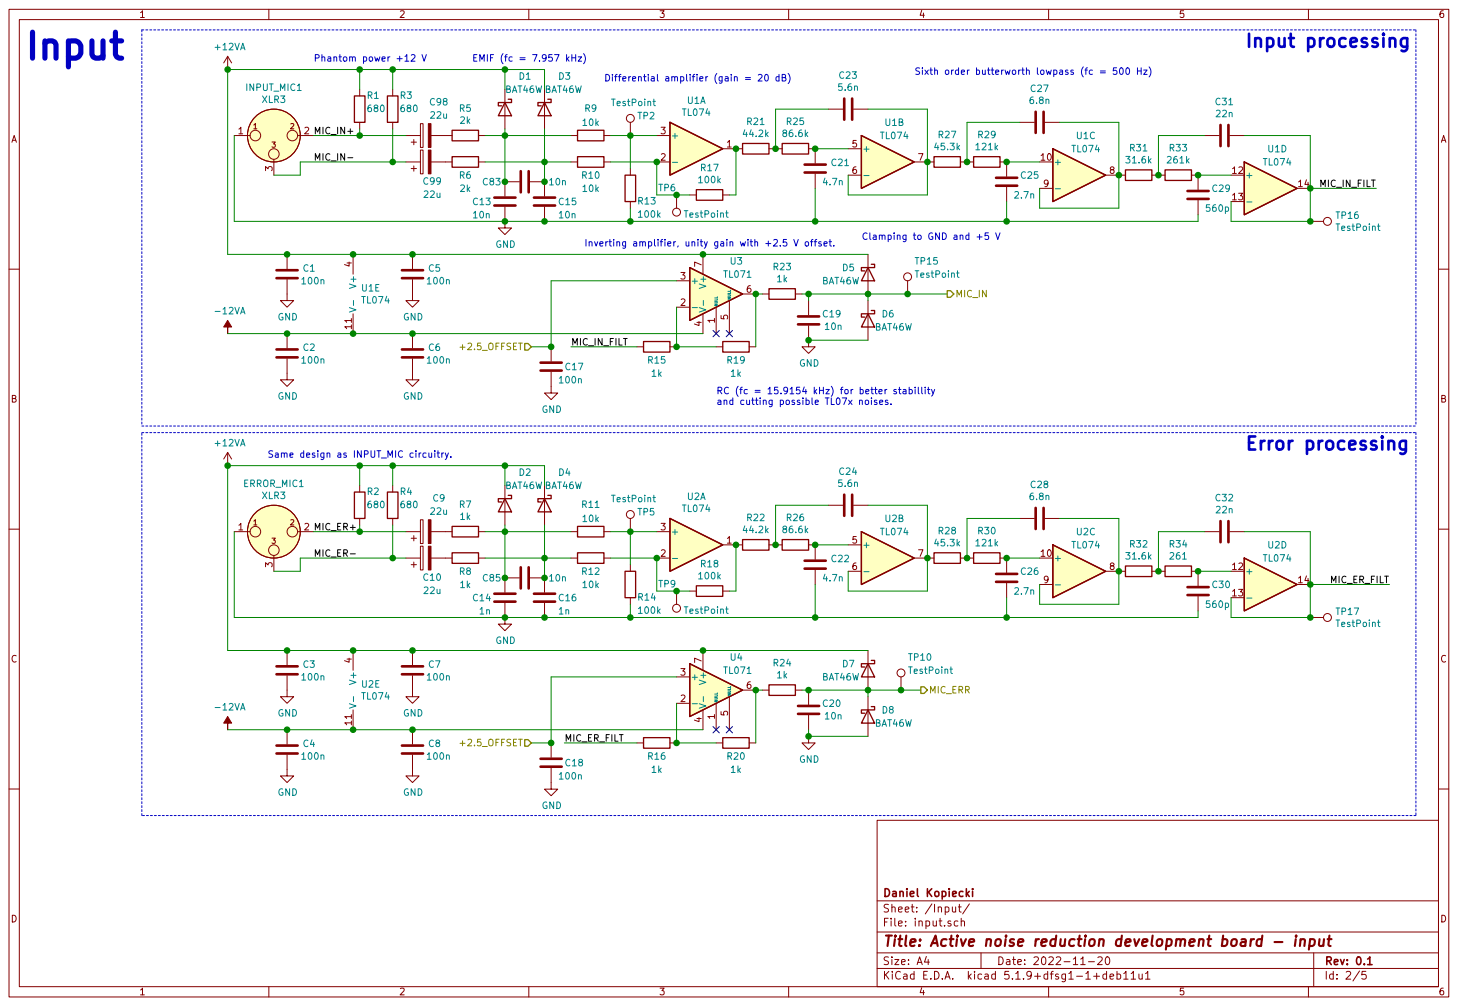
[picture p408: page 2]

Sixth order butterworth lowpass (fc = 500 Hz) Differential amplifier (gain = 20 dB)

Clamping to GND and +5 V Inverting amplifier, unity gain with +2.5 V offset.

and cutting possible TL07x noises.

Same design as INPUT_MIC circuitry.

GND GND

Daniel Kopiecki
Sheet: /Input/
File: input.sch
Id: 2/5 Title: Active noise reduction development board - input

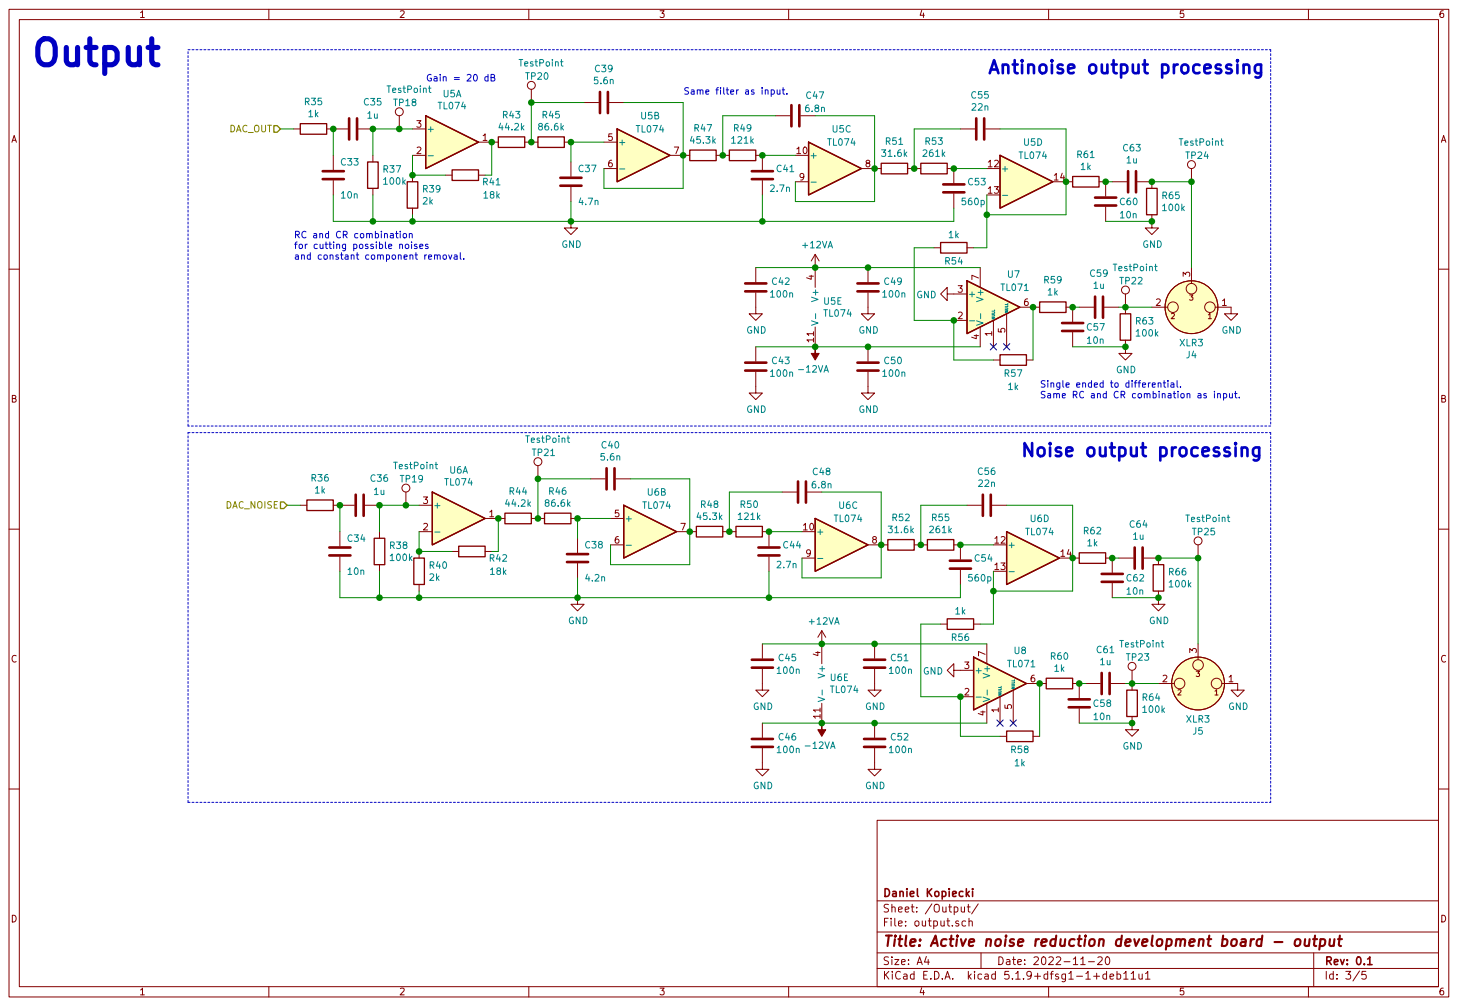
[picture p409: page 3]

Same filter as input.

RC and CR combination
for cutting possible noises
and constant component removal.

Single ended to differential.
Same RC and CR combination as input.

Sheet: /Output/
File: output.sch
Id: 3/5 Title: Active noise reduction development board - output

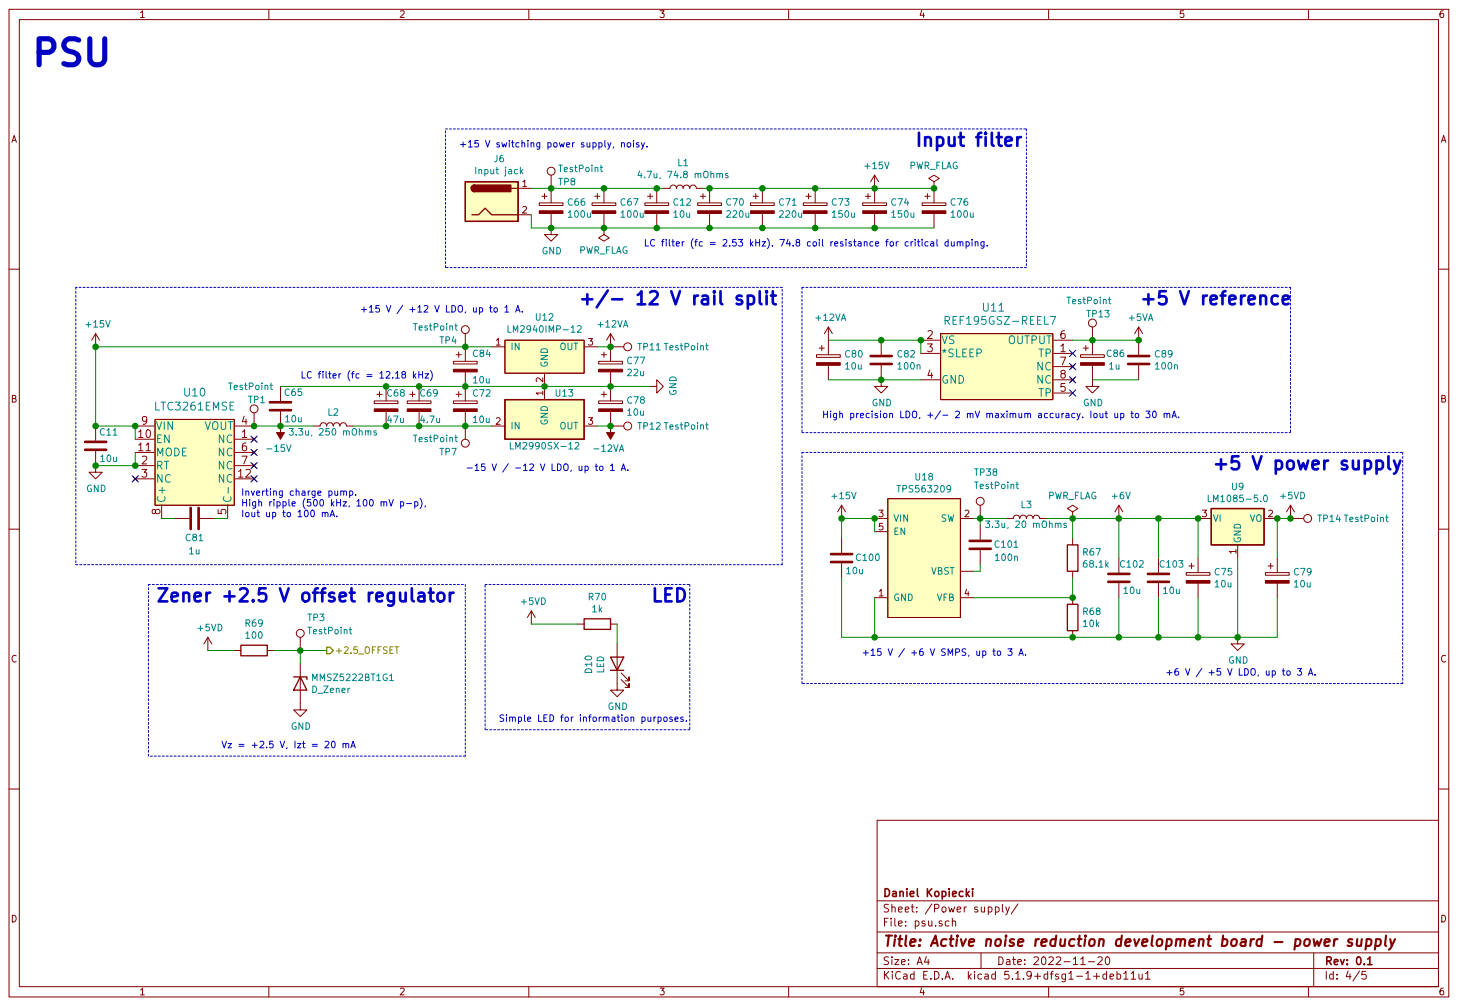
[picture p410: page 4]

+15 V switching power supply, noisy.

LC filter (fc = 2.53 kHz). 74.8 coil resistance for critical dumping.

10u GND
High precision LDO, +/- 2 mV maximum accuracy. Iout up to 30 mA.

LC filter (fc = 12.18 kHz)
3.3u, 250 mOhms C65

Inverting charge pump.
+15V MMSZ5222BT1G1 D_Zener R69
High ripple (500 kHz, 100 mV p-p),
Iout up to 100 mA.

Simple LED for information purposes.

Daniel Kopiecki
Sheet: /Power supply/
File: psu.sch
Id: 4/5 Title: Active noise reduction development board - power supply


16 bit, SAR, Idd = 5.2 mA, tconv = 20tsclk, Vin range from 0 to Vdd
McASP

16 bit, Idd = 1.1 mA, +/- Vref output swing

File: adc_dac.sch Sheet: /ADC/DAC/ Daniel Kopiecki

Id: 5/5 Title: Active noise reduction development board - adc/dac
