kopiecki/anc/hardware/in_input.pdf

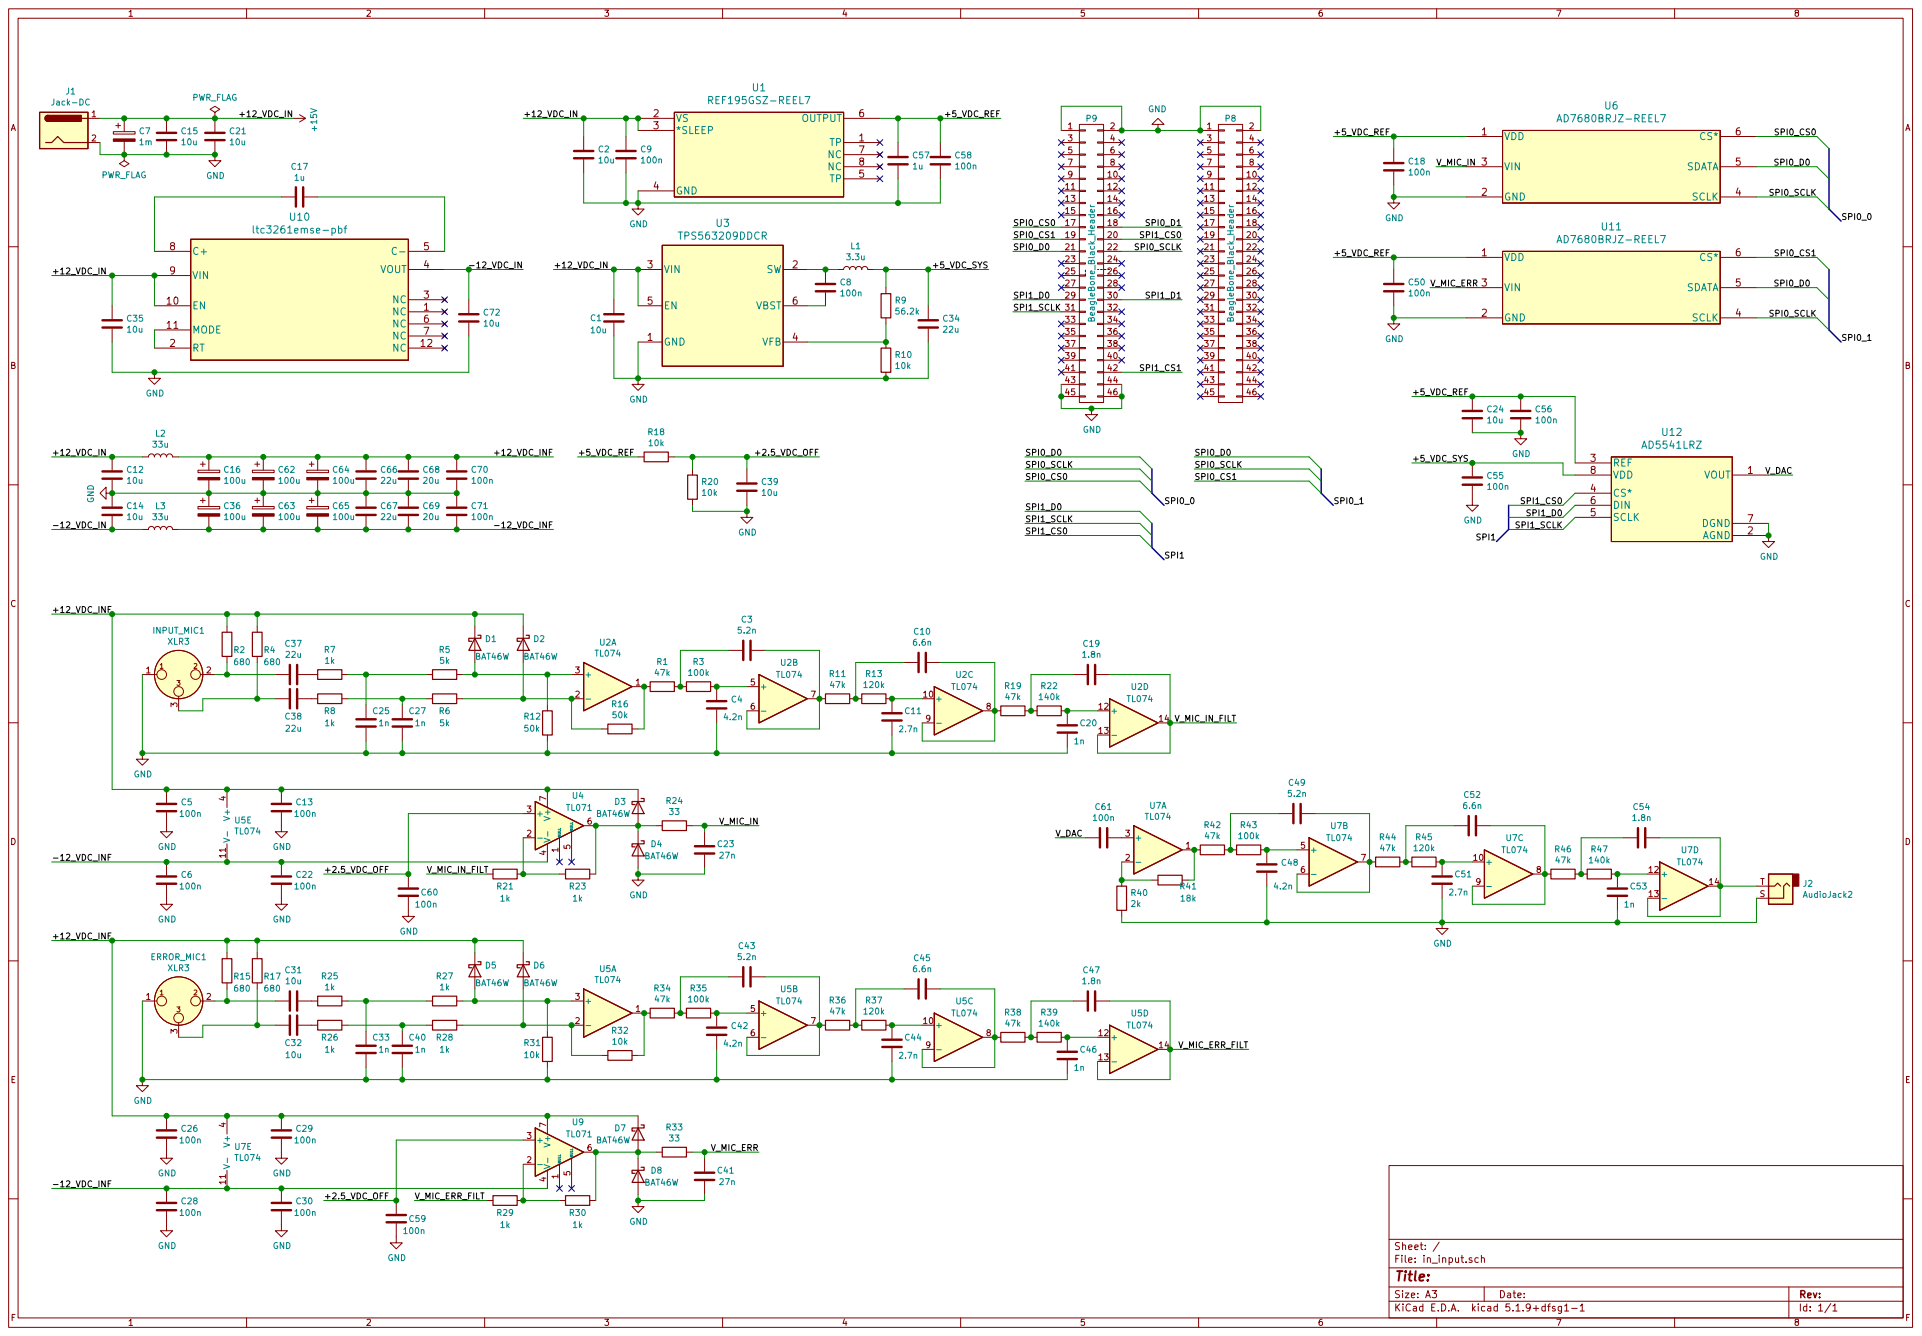
[picture p411: page 1]
