kopiecki/anc/electronics/schemes/bbb.pdf

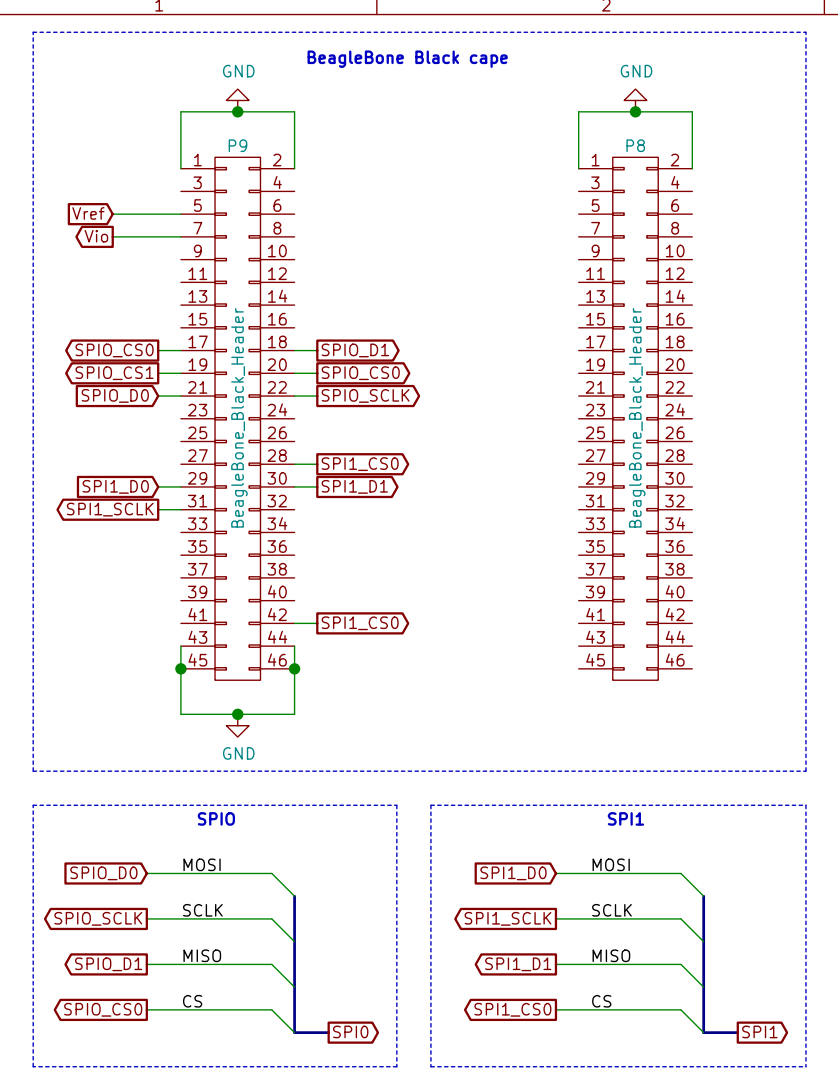
[picture p412: page 1]
