kopiecki/anc/docs/polsl/sd1/build/pdfs/main-F_Paste.pdf

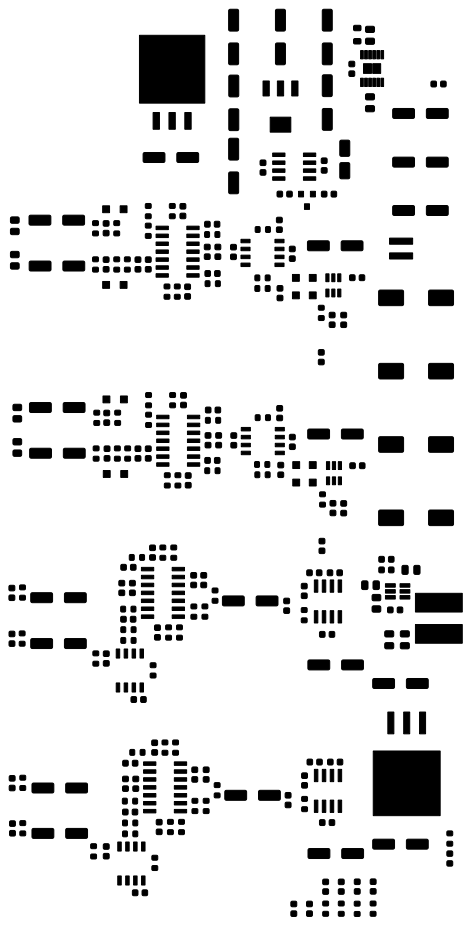
[picture p413: page 1]
