kopiecki/anc/docs/main-B_Cu.pdf

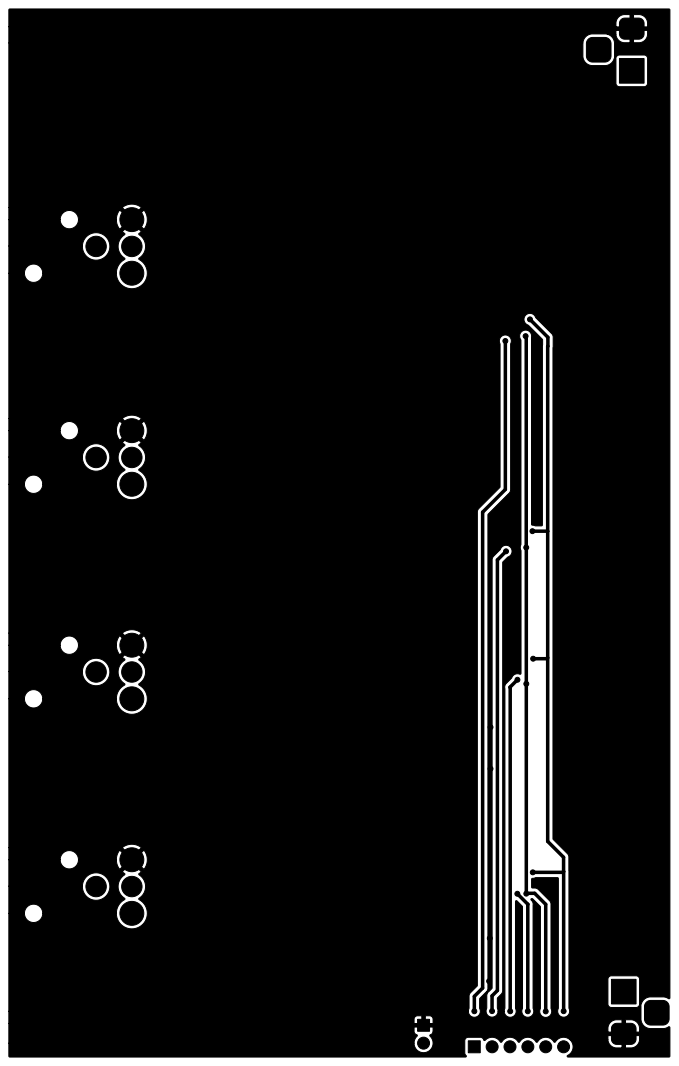
[picture p414: page 1]
