kopiecki/anc/docs/main-B_Mask.pdf

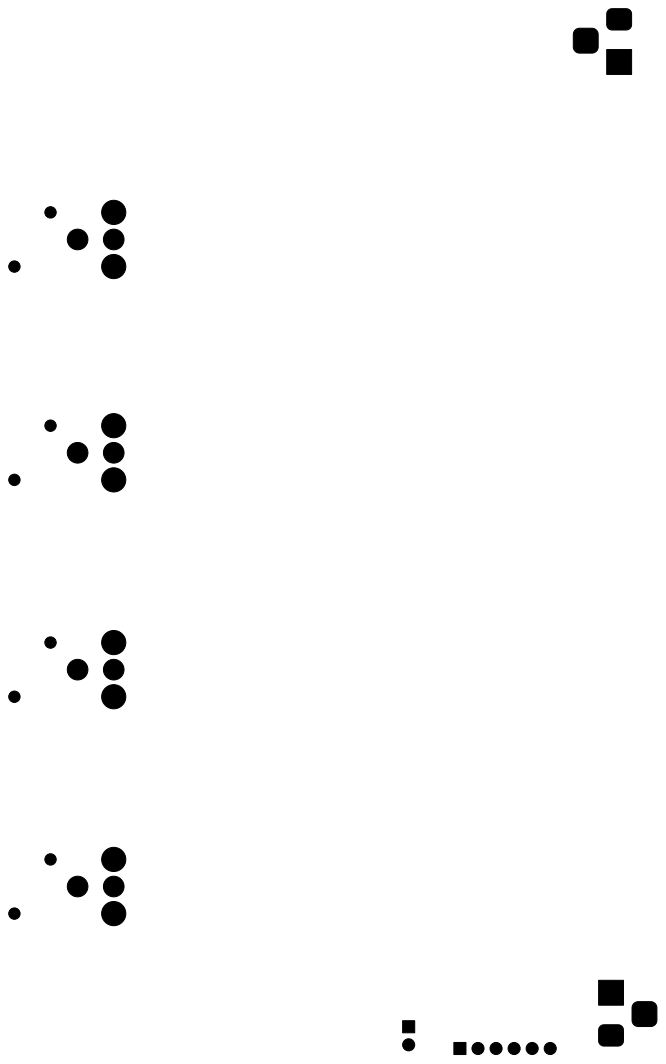
[picture p415: page 1]
