kopiecki/anc/docs/main-F_Cu.pdf

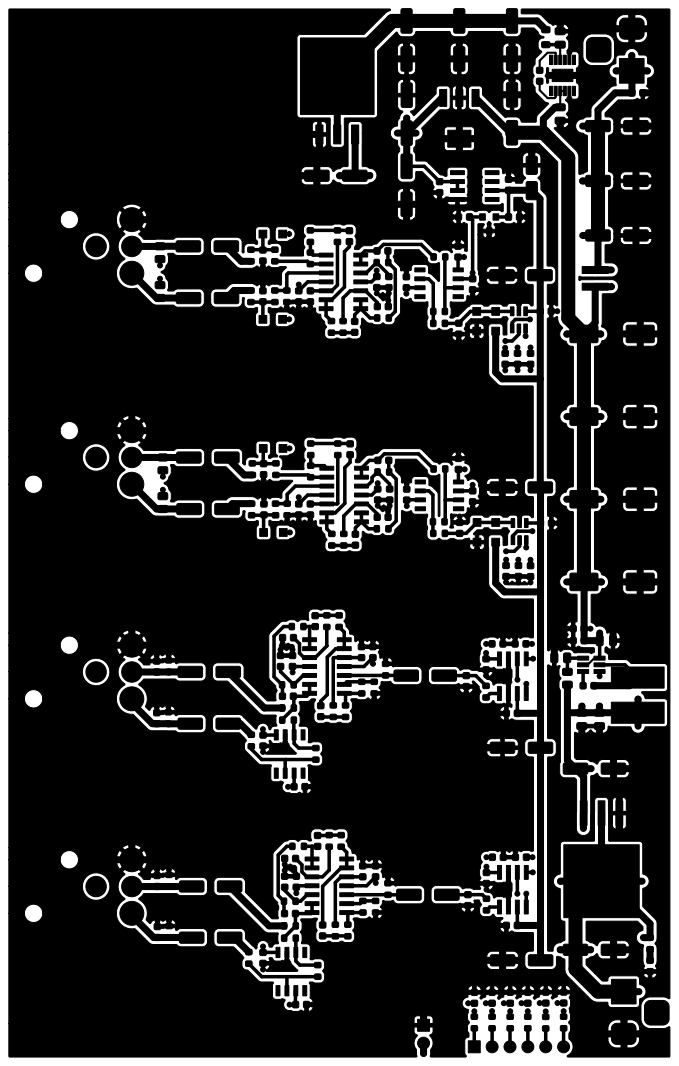
[picture p416: page 1]
