kopiecki/anc/docs/main-F_Fab.pdf

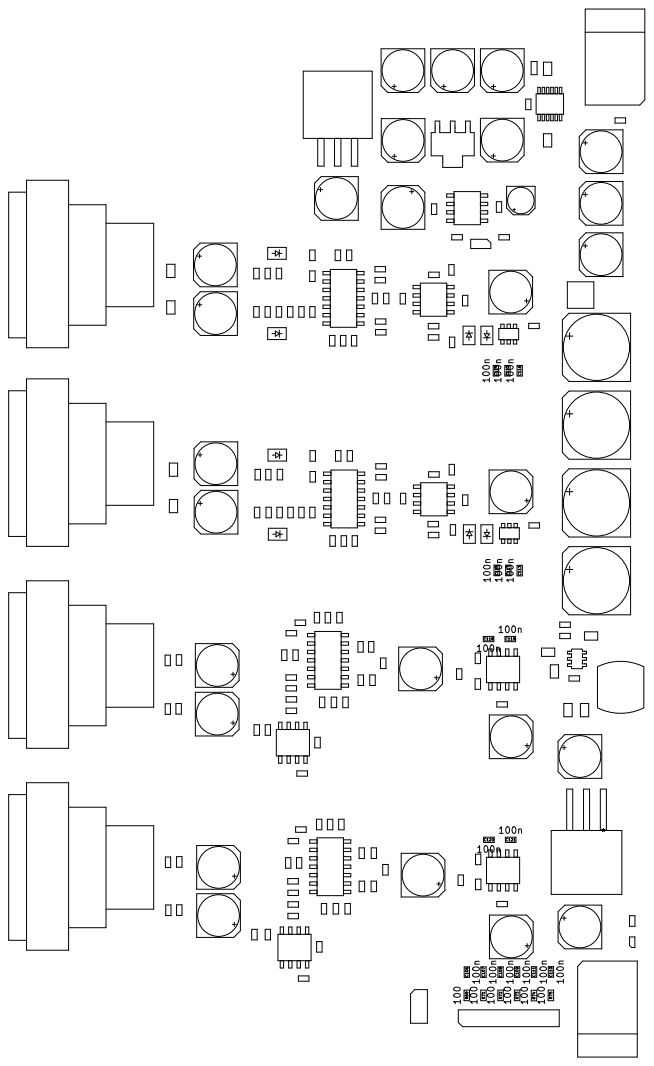
[picture p417: page 1]
