kopiecki/anc/docs/main-F_Mask.pdf

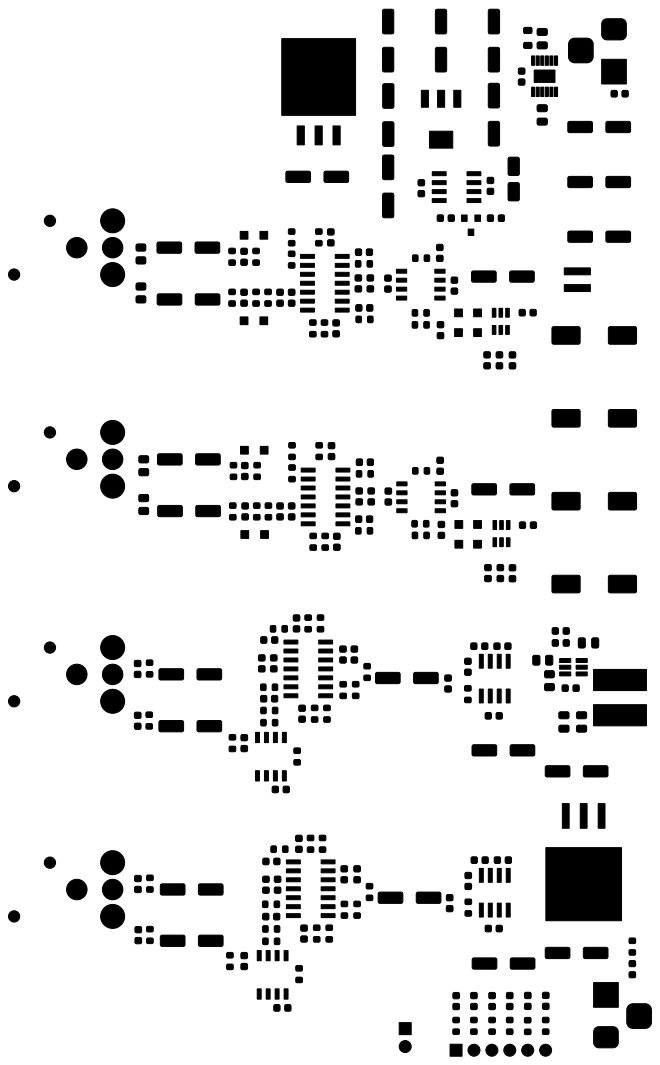
[picture p418: page 1]
