kopiecki/anc/docs/main-F_Paste.pdf

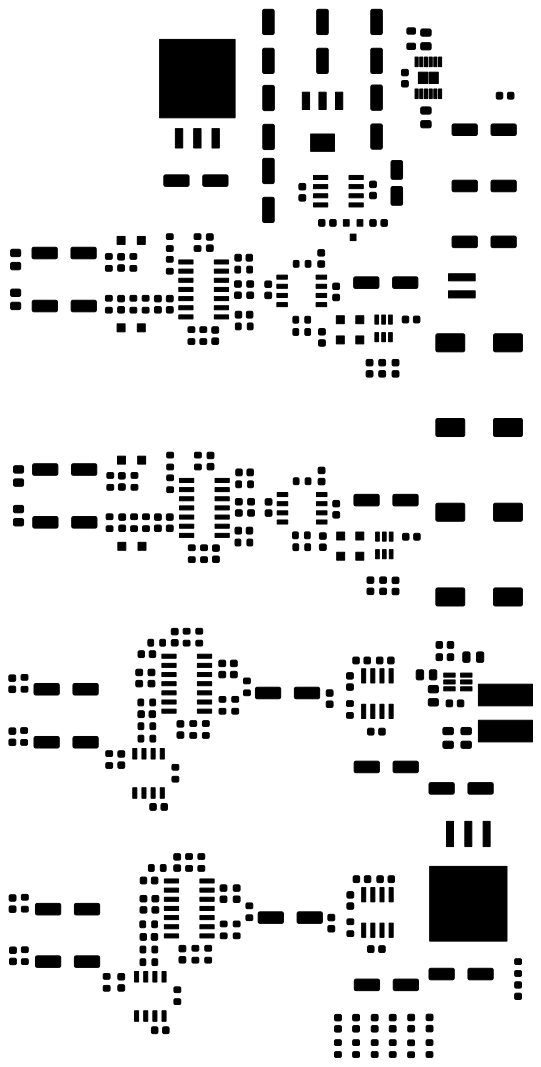
[picture p419: page 1]
