kopiecki/anc/docs/main-F_Silkscreen.pdf

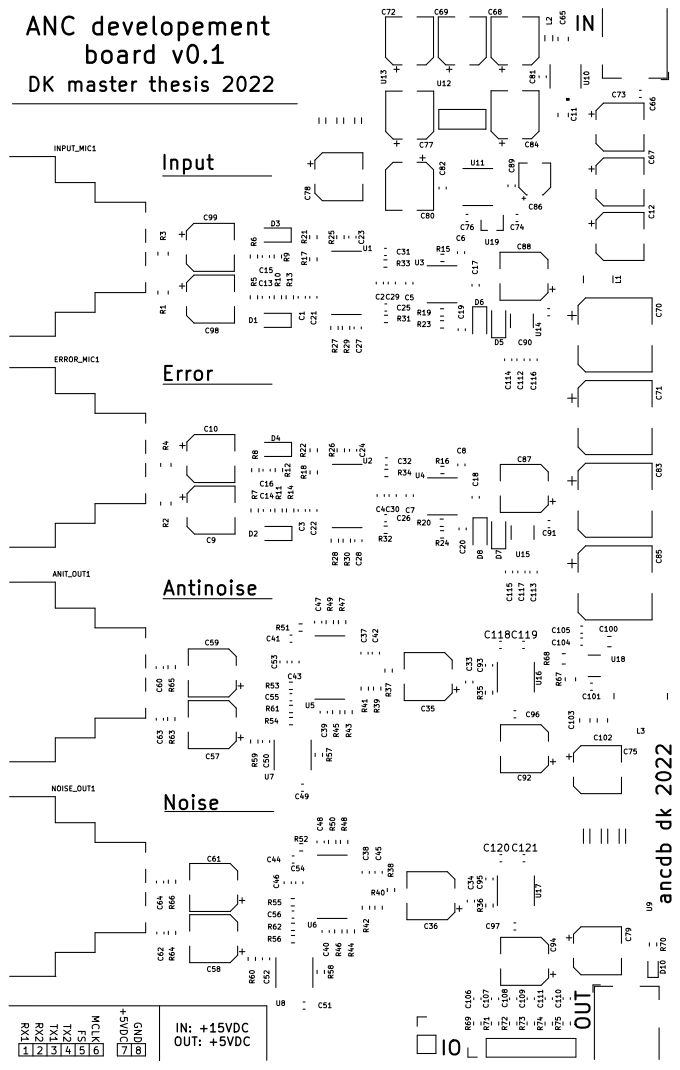
[picture p420: page 1]
