kopiecki/anc/docs/main-In1_Cu.pdf

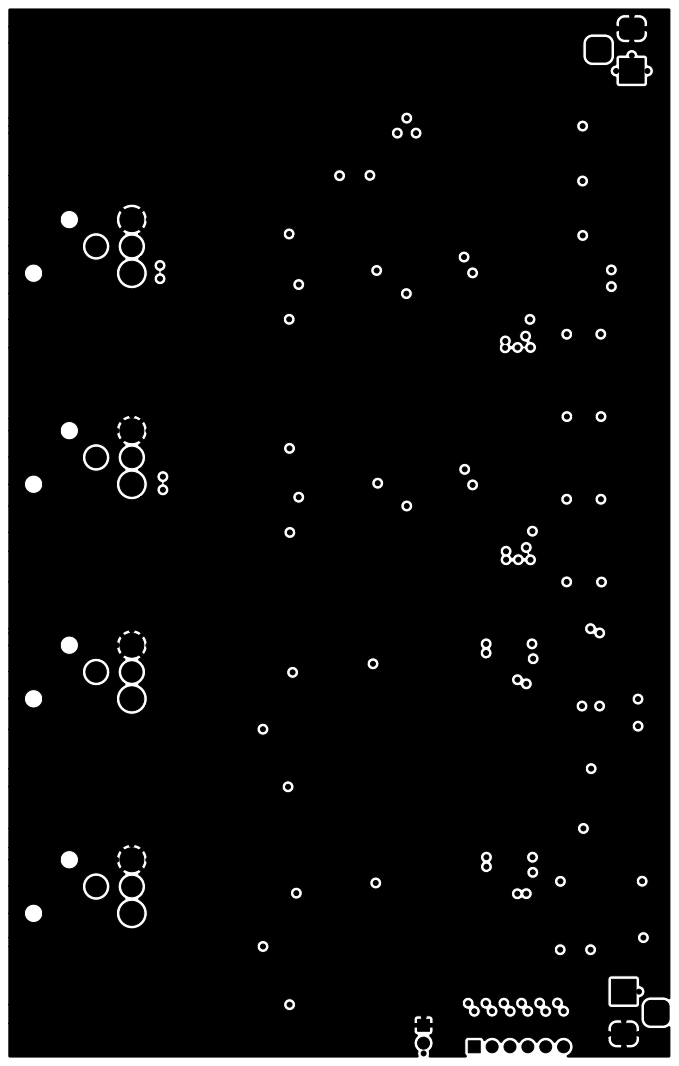
[picture p421: page 1]
