kopiecki/anc/docs/main-In2_Cu.pdf

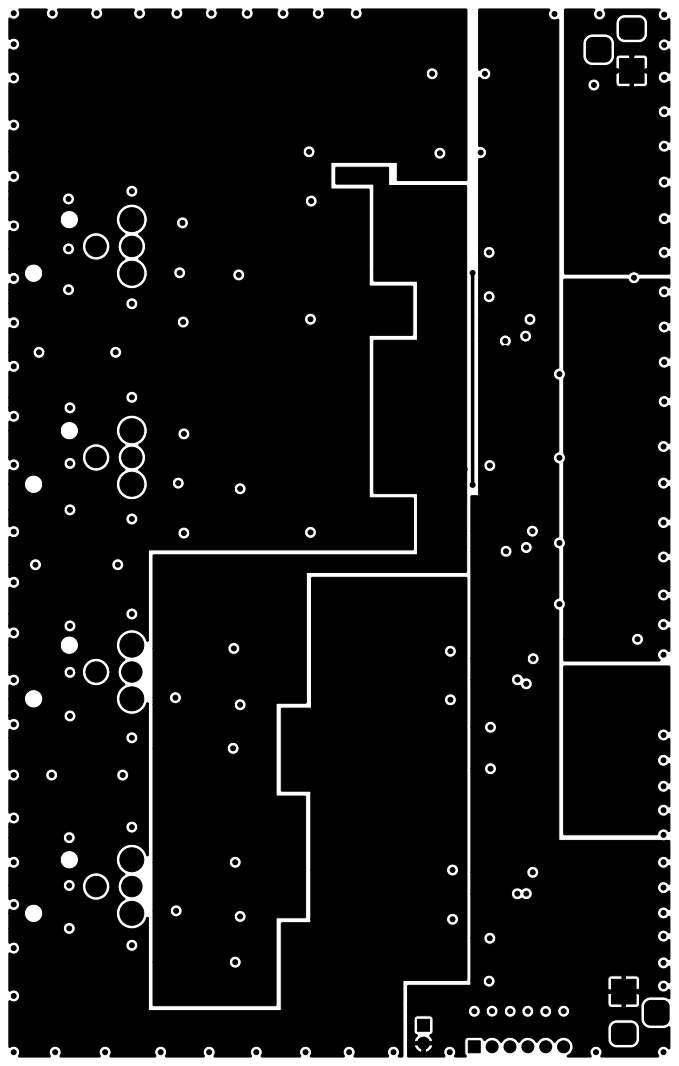
[picture p422: page 1]
