kopiecki/anc/docs/main-F_SilkS.pdf

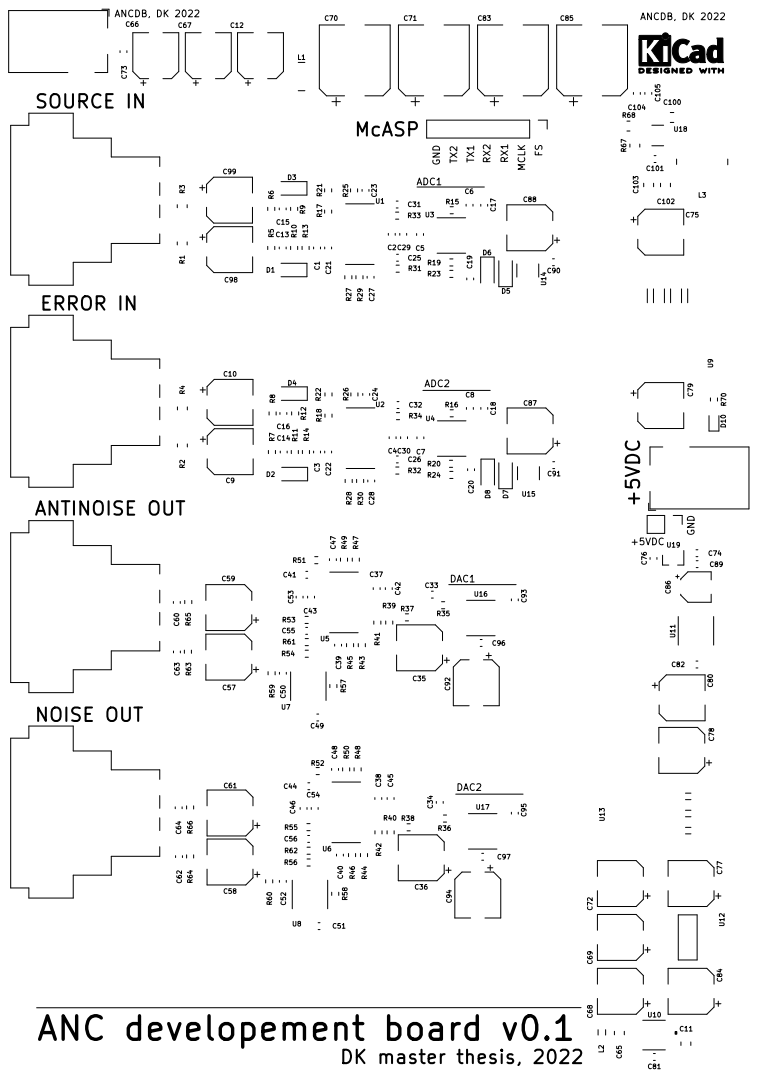
[picture p423: page 1]
