kopiecki/anc/docs/polsl/sd2/pdfs/main-B_Cu.pdf

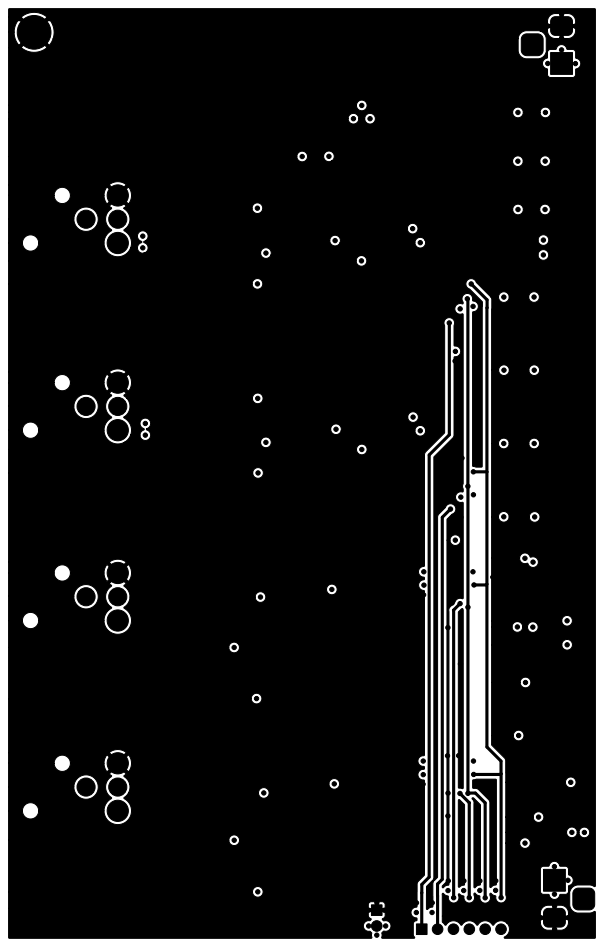
[picture p424: page 1]
