kopiecki/anc/docs/polsl/sd2/pdfs/main-F_Fab.pdf

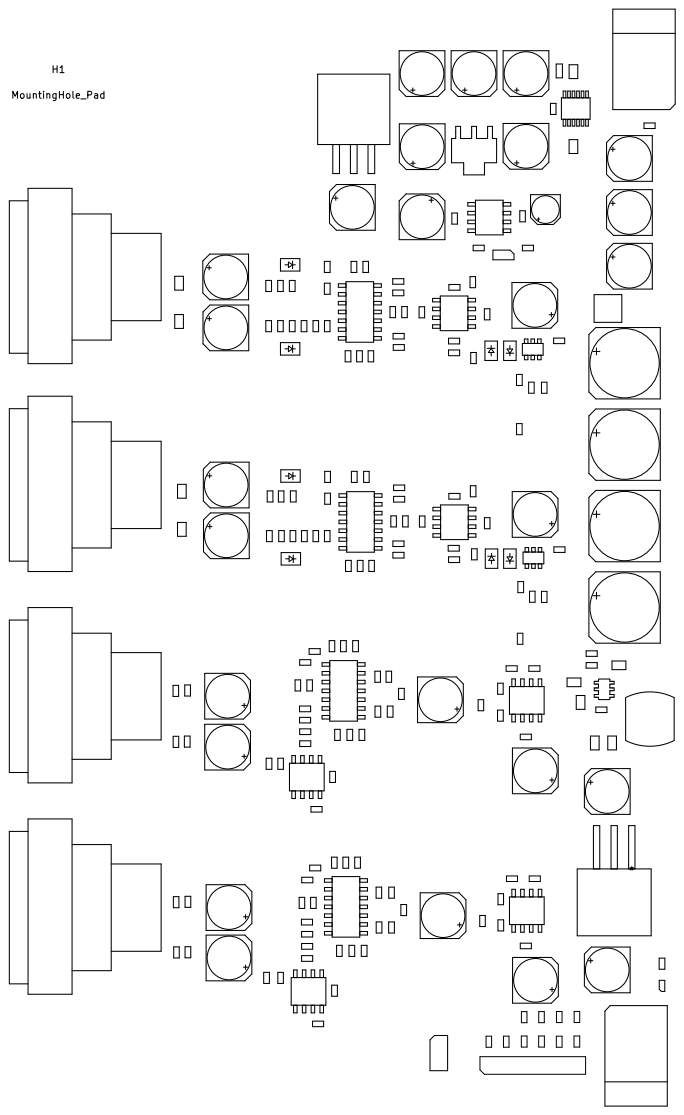
[picture p425: page 1]
