kopiecki/anc/docs/polsl/sd2/pdfs/main-In1_Cu.pdf

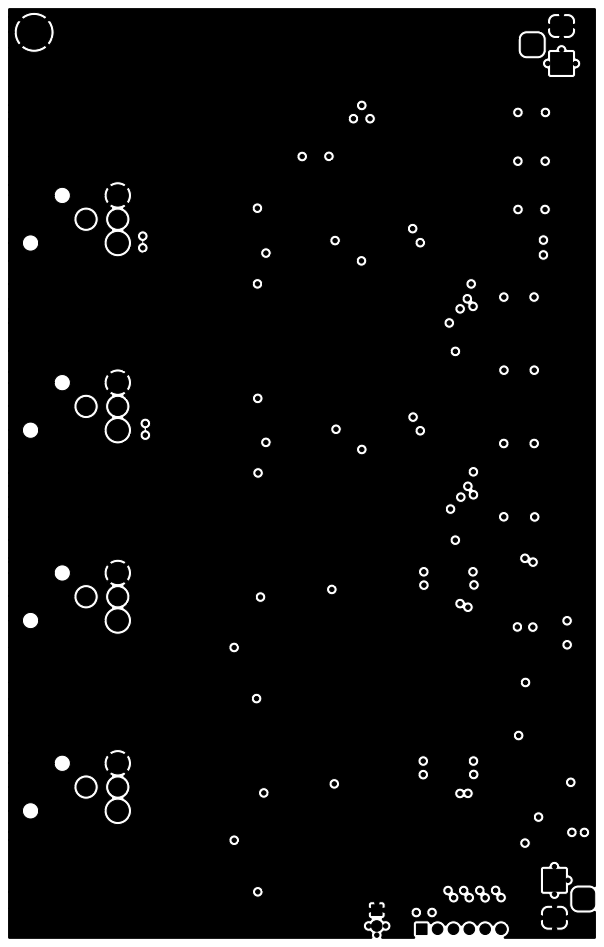
[picture p426: page 1]
