kopiecki/anc/docs/polsl/sd1/pdfs/main-B_Mask.pdf

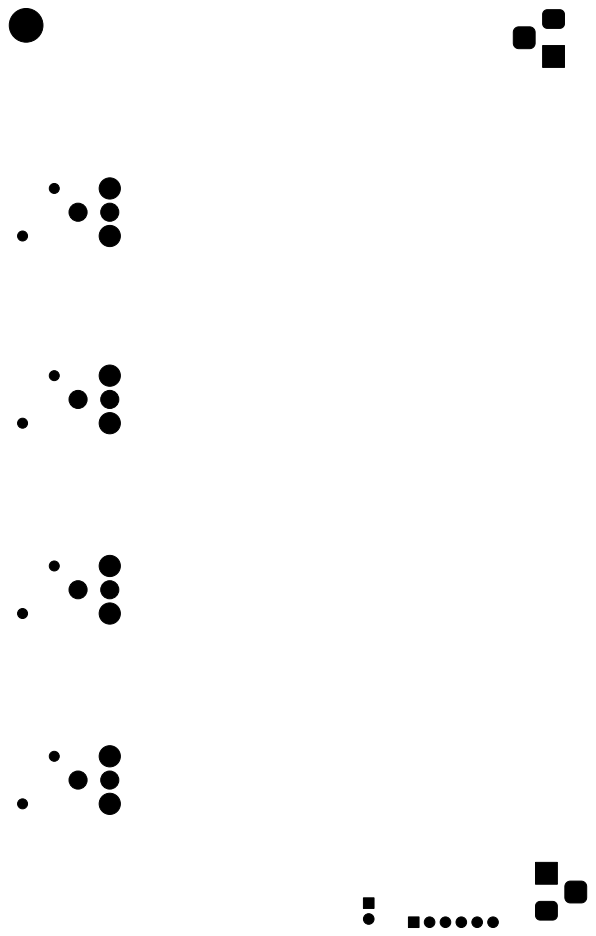
[picture p427: page 1]
