kopiecki/anc/docs/polsl/sd1/pdfs/main-F_Cu.pdf

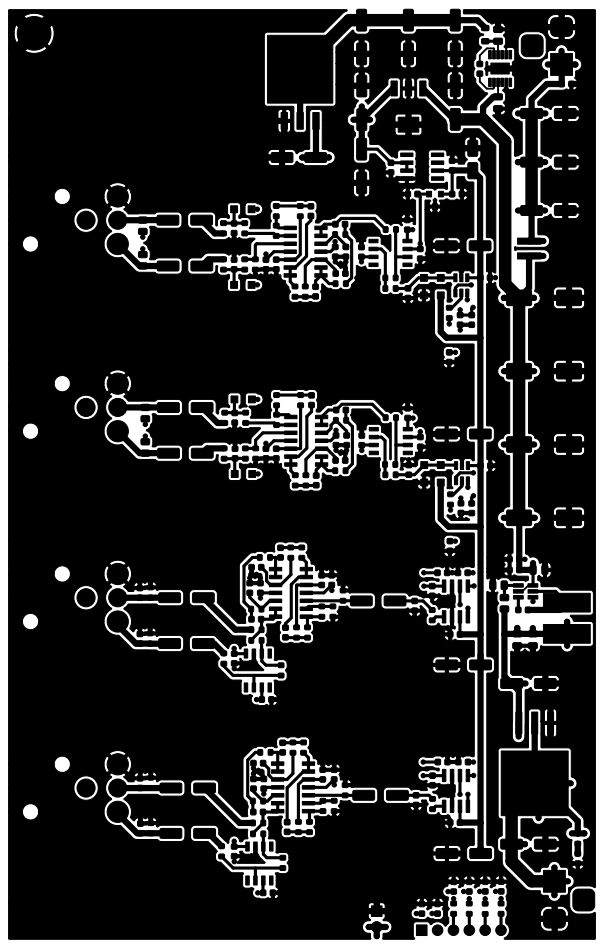
[picture p428: page 1]
