kopiecki/anc/docs/polsl/sd1/pdfs/main-F_Mask.pdf

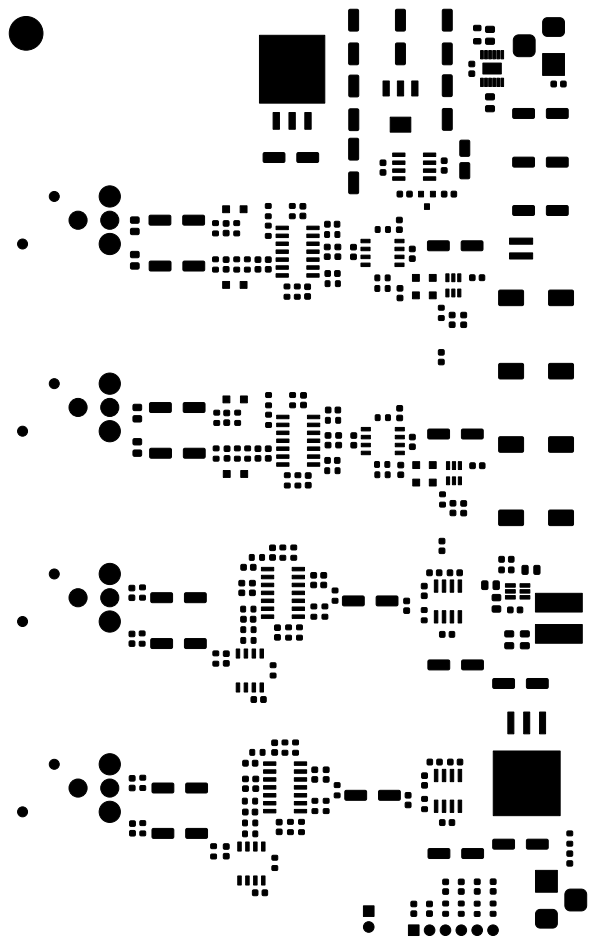
[picture p429: page 1]
