kopiecki/anc/docs/polsl/sd1/pdfs/main-F_Silkscreen.pdf

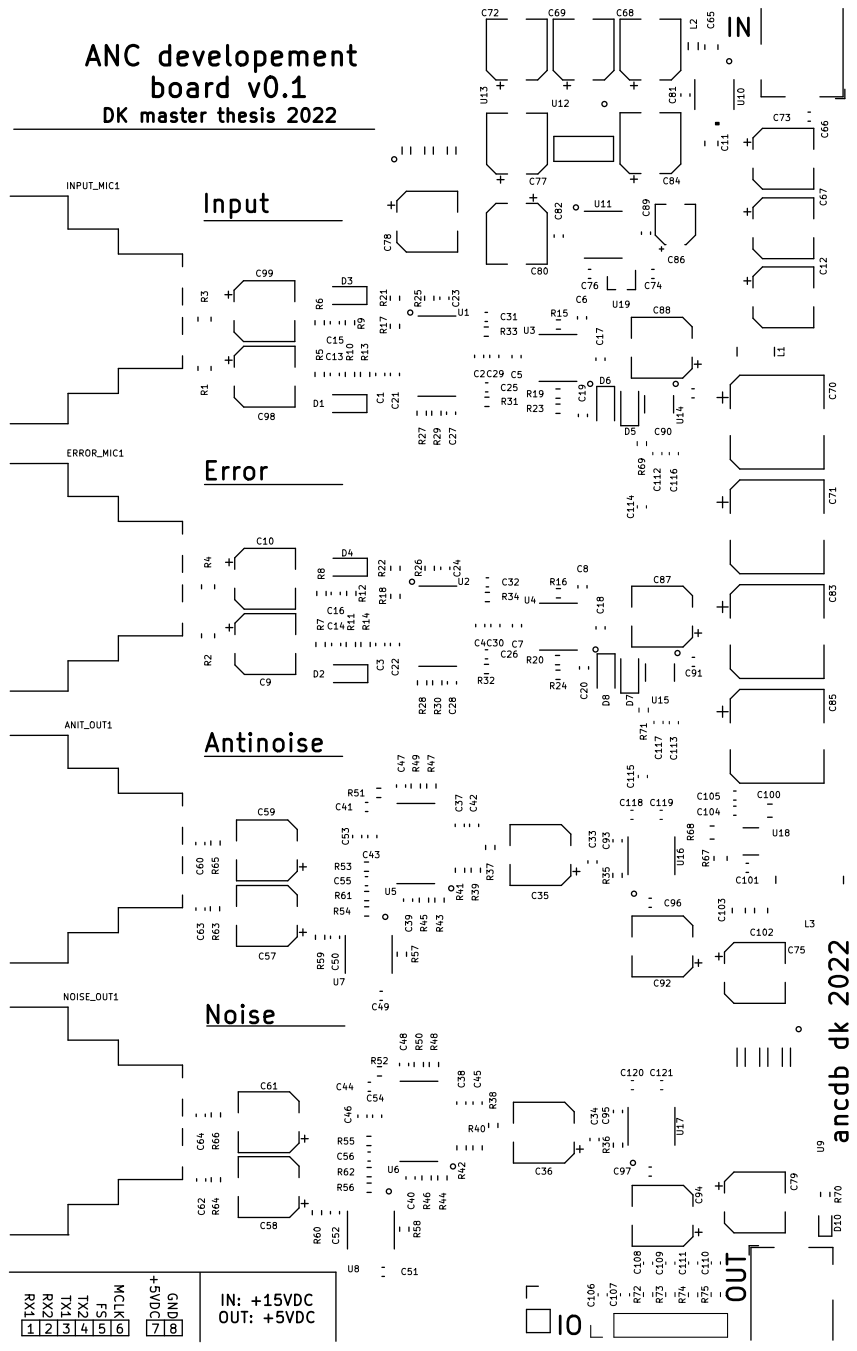
[picture p430: page 1]
