kopiecki/anc/docs/polsl/sd1/pdfs/main-In2_Cu.pdf

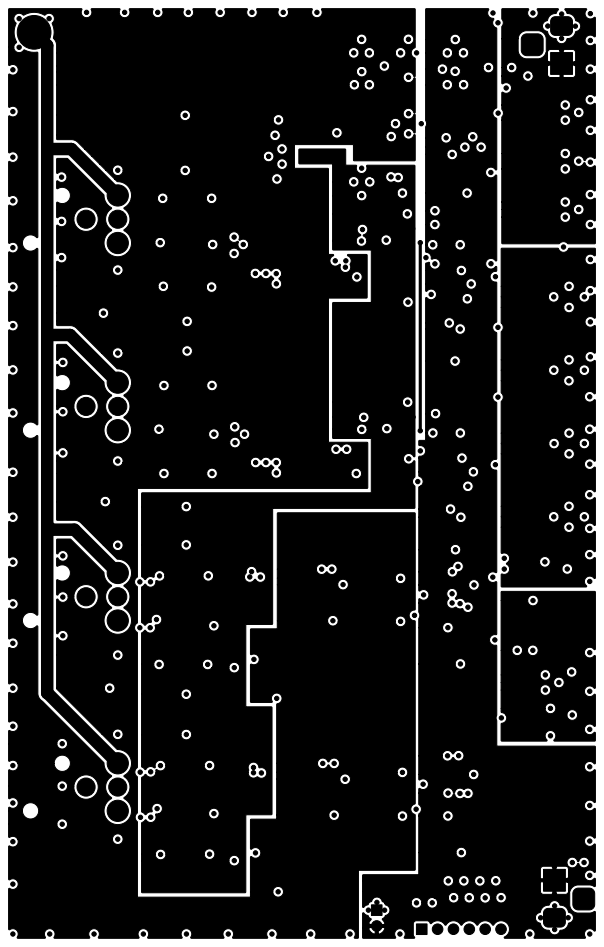
[picture p431: page 1]
