kopiecki/anc/hardware/kicad/main.kicad_pcb

## KiCad design hardware/kicad/main.kicad_pcb (2023-03-20)

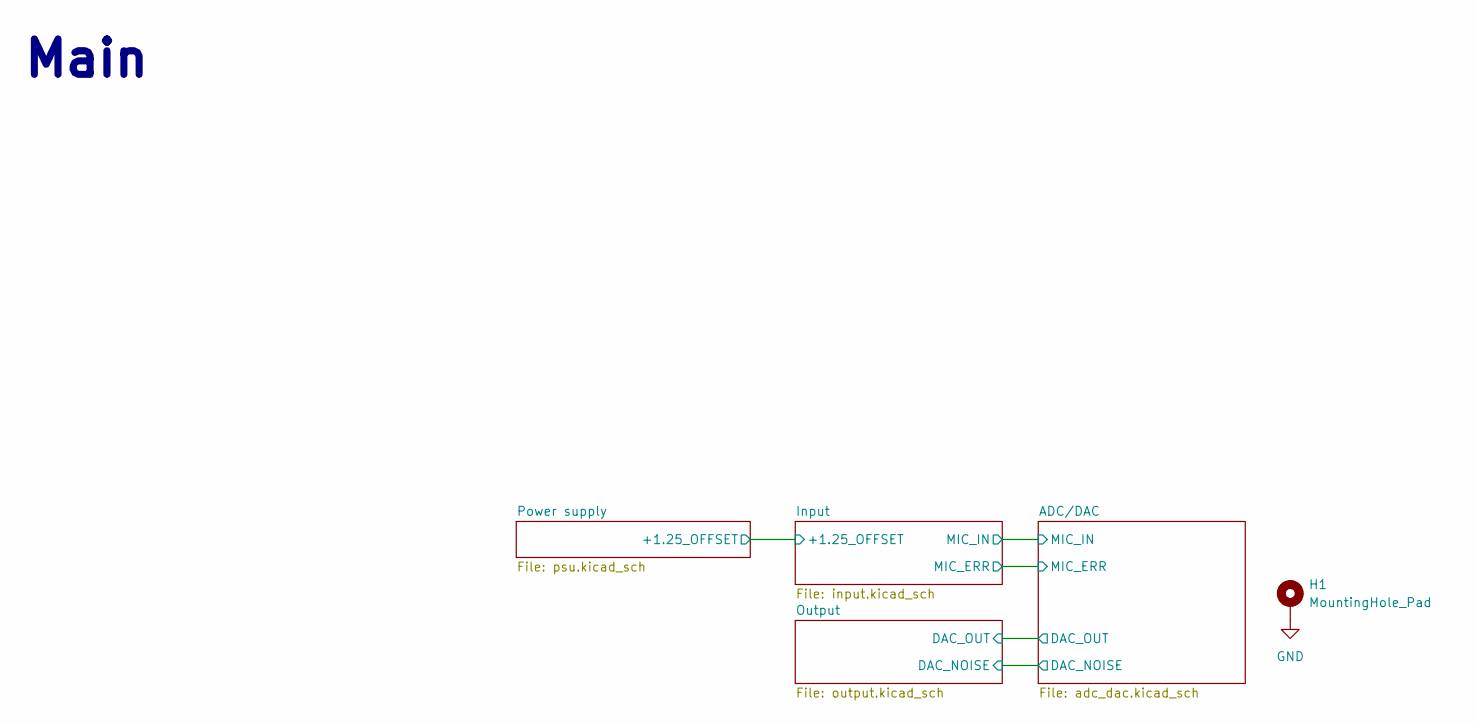
[picture p432: schematic main.kicad_sch, Active noise reduction development board - main]

Parts:
H1: MountingHole_Pad; MountingHole_2.7mm_Pad

Connections:
GND: H1.1; also elsewhere on the board

Notes on the sheet:
Main

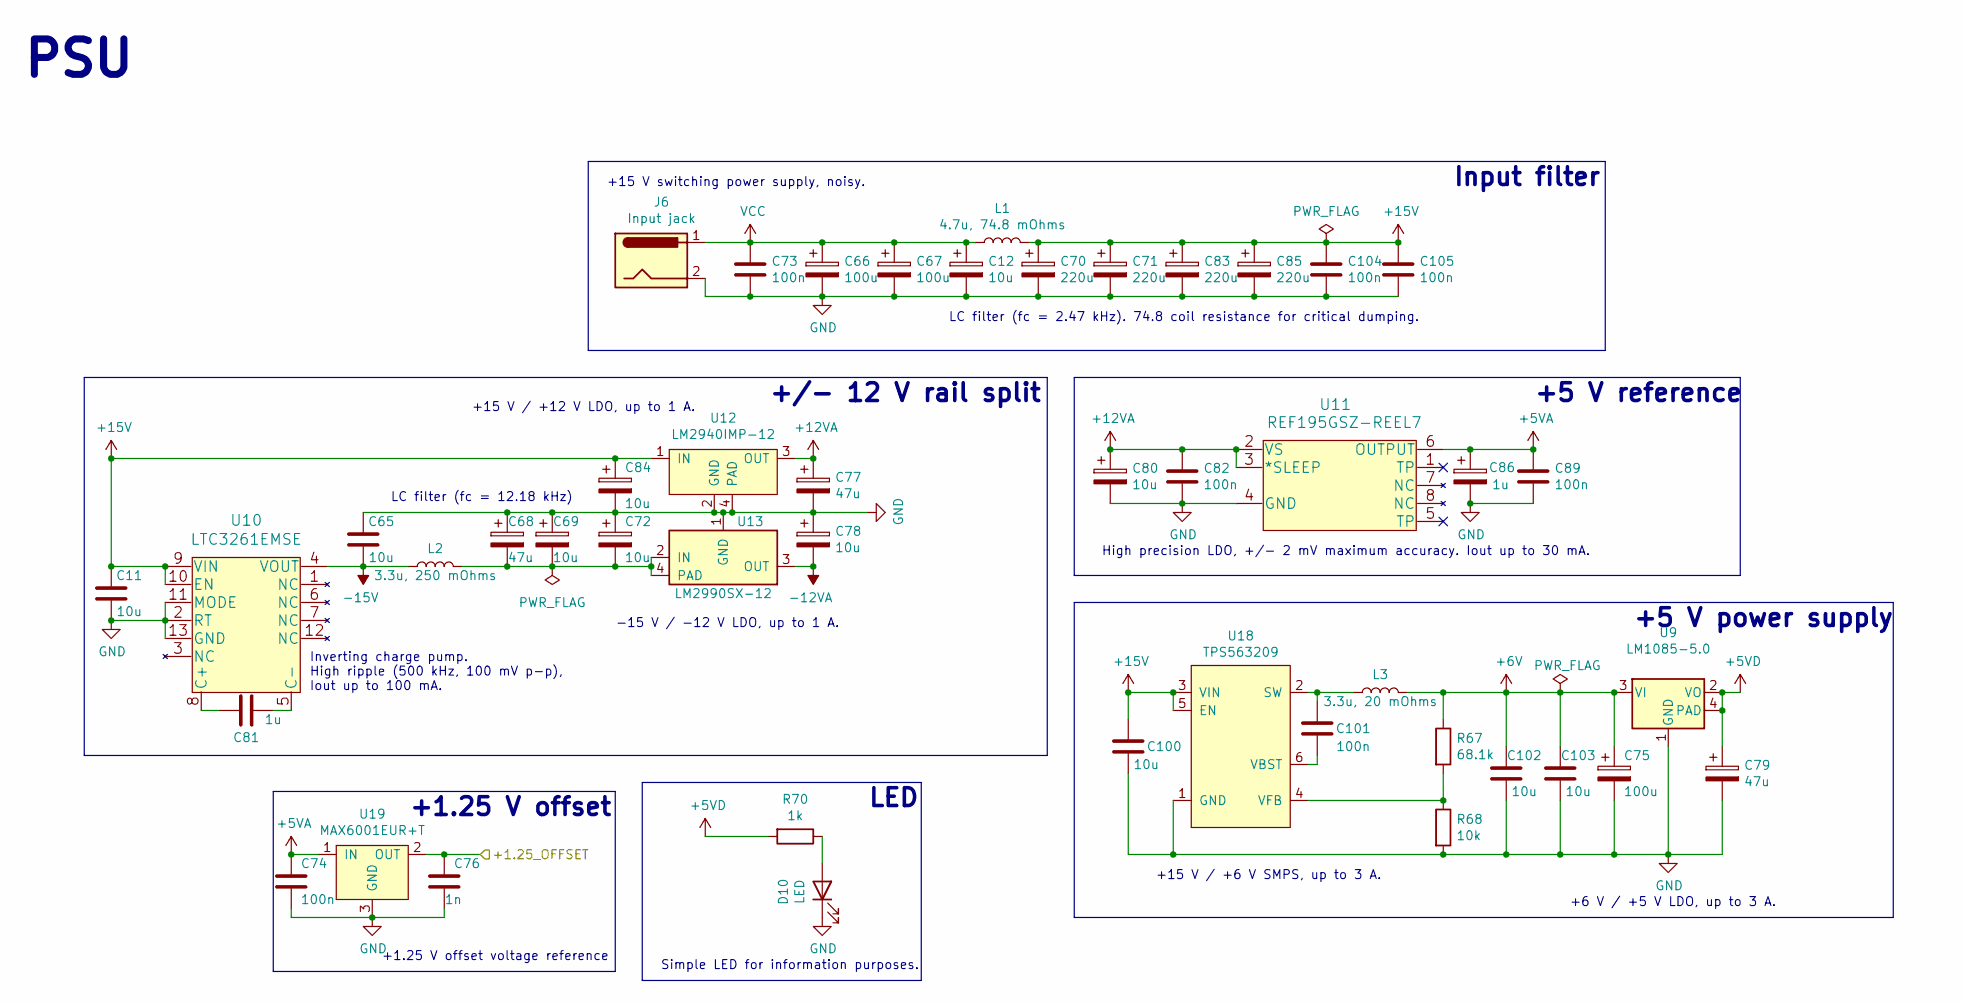
[picture p433: schematic psu.kicad_sch, Active noise reduction development board - power supply]

Parts:
C11, C65, C100, C102, C103: 10u; C_0805_2012Metric
C12, C69, C72, C78, C80, C84: 10u; CP_Elec_6.3x5.8
C66, C67, C75: 100u; CP_Elec_6.3x7.7
C68, C77, C79: 47u; CP_Elec_6.3x7.7
C70, C71, C83, C85: 220u; CP_Elec_10x10
C73, C74, C82, C89, C101, C104, C105: 100n; C_0603_1608Metric
C76: 1n; C_0603_1608Metric
C81: 1u; C_0603_1608Metric
C86: 1u; CP_Elec_4x5.4
D10: LED; LED_0603_1608Metric
J6: Input jack; BarrelJack_Horizontal
L1: 4.7u, 74.8 mOhms; L_Wuerth_MAPI-4020
L2: 3.3u, 250 mOhms; L_0805_2012Metric
L3: 3.3u, 20 mOhms; L_Wuerth_WE-PD2-Typ-L
R67: 68.1k; R_0805_2012Metric
R68: 10k; R_0805_2012Metric
R70: 1k; R_0603_1608Metric
U9: LM1085-5.0; LM1085IS-12&slash_NOPB
U10: LTC3261EMSE; ltc3261emse-pbf
U11: REF195GSZ-REEL7
U12: LM2940IMP-12; LM2940IMP-10&slash_NOPB
U13: LM2990SX-12; LM2990S-12
U18: TPS563209; TPS563209DDCR
U19: MAX6001EUR+T; SOT-23

Connections:
+5VA: C74.1, C86.1, C89.1, U11.6 (OUTPUT), U19.1 (IN); also elsewhere on the board
+5VD: C79.1, R70.2, U9.2 (VO), U9.4 (PAD); also elsewhere on the board
+6V: C75.1, C102.2, C103.2, L3.2, R67.1, U9.3 (VI)
+12VA: C77.1, C80.1, C82.1, U11.2 (VS), U11.3 (*SLEEP), U12.3 (OUT); also elsewhere on the board
+15V: C11.2, C70.1, C71.1, C83.1, C84.1, C85.1, C100.2, C104.1, C105.1, L1.2, U10.9 (VIN), U10.10 (EN), U12.1 (IN), U18.3 (VIN), U18.5 (EN)
-12VA: C78.2, U13.3 (OUT); also elsewhere on the board
-15V: C65.1, L2.1, U10.4 (VOUT)
/Input/+1.25_OFFSET: C76.1, U19.2 (OUT); also elsewhere on the board
GND: C11.1, C12.2, C65.2, C66.2, C67.2, C68.1, C69.1, C70.2, C71.2, C72.1, C73.2, C74.2, C75.2, C76.2, C77.2, C78.1, C79.2, C80.2, C82.2, C83.2, C84.2, C85.2, C86.2, C89.2, C100.1, C102.1, C103.1, C104.2, C105.2, D10.1 (K), J6.2, R68.2, U9.1 (GND), U10.2 (RT), U10.11 (MODE), U10.13 (GND), U11.4 (GND), U12.2 (GND), U12.4 (PAD), U13.1 (GND), U18.1 (GND), U19.3 (GND); also elsewhere on the board
unnamed: C68.2, C69.2, C72.2, L2.2, U13.2 (IN), U13.4 (PAD)
unnamed: C81.1, U10.8 (C+)
unnamed: C81.2, U10.5 (C-)
unnamed: C101.1, U18.6 (VBST)
unnamed: C101.2, L3.1, U18.2 (SW)
unnamed: D10.2 (A), R70.1
unnamed: R67.2, R68.1, U18.4 (VFB)
VCC: C12.1, C66.1, C67.1, C73.1, J6.1, L1.1

Notes on the sheet:
+15 V switching power supply, noisy.
LC filter (fc = 12.18 kHz)
PSU
LED
+15 V / +12 V LDO, up to 1 A.
Simple LED for information purposes.
-15 V / -12 V LDO, up to 1 A.
Inverting charge pump. High ripple (500 kHz, 100 mV p-p), Iout up to 100 mA.
Input filter
LC filter (fc = 2.47 kHz). 74.8 coil resistance for critical dumping.
+5 V power supply
+5 V reference
+6 V / +5 V LDO, up to 3 A.
+/- 12 V rail split
+15 V / +6 V SMPS, up to 3 A.
+1.25 V offset voltage reference
High precision LDO, +/- 2 mV maximum accuracy. Iout up to 30 mA.
+1.25 V offset

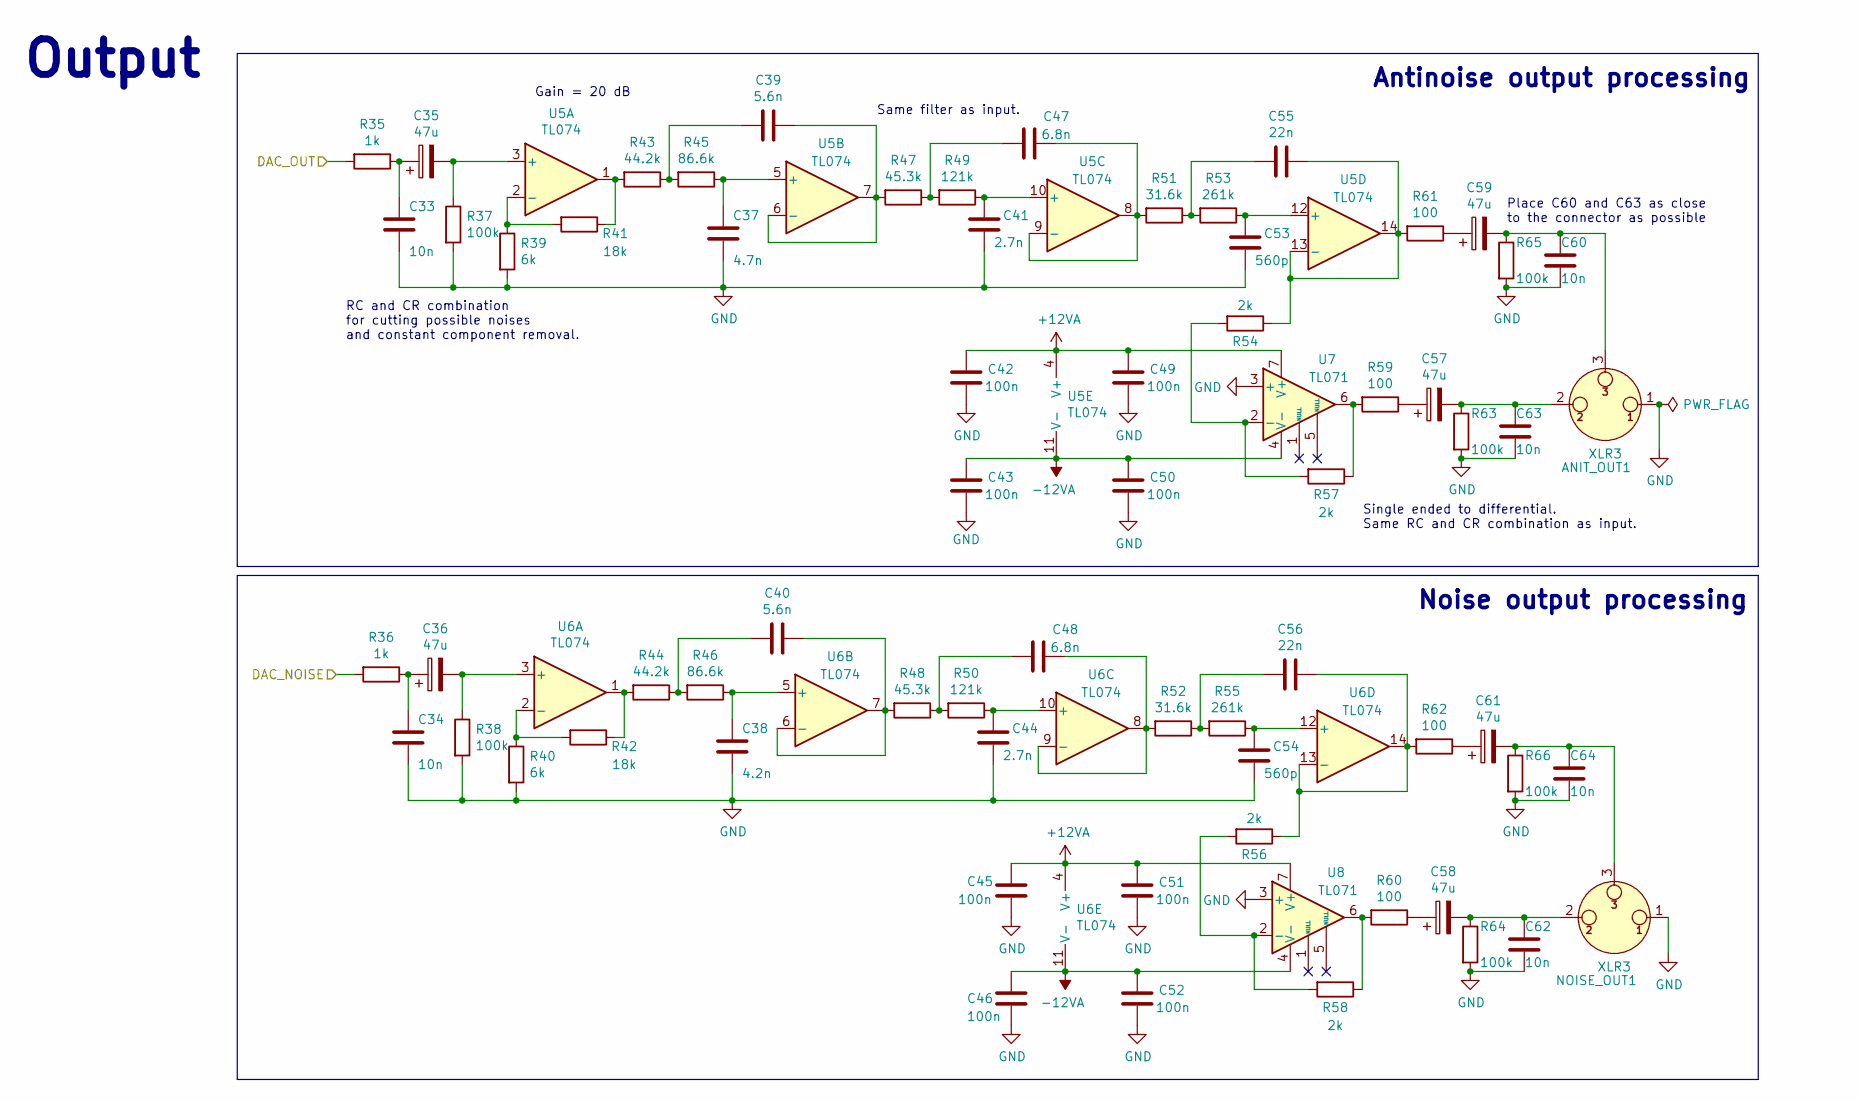
[picture p434: schematic output.kicad_sch, Active noise reduction development board - output]

Parts:
ANIT_OUT1: XLR3; Jack_XLR_Neutrik_NC3MAH-0_Horizontal
C33, C34, C60, C62, C63, C64: 10n; C_0603_1608Metric
C35, C36, C57, C58, C59, C61: 47u; CP_Elec_6.3x7.7
C37: 4.7n; C_0603_1608Metric
C38: 4.2n; C_0603_1608Metric
C39, C40: 5.6n; C_0603_1608Metric
C41, C44: 2.7n; C_0603_1608Metric
C42, C43, C45, C46, C49, C50, C51, C52: 100n; C_0603_1608Metric
C47, C48: 6.8n; C_0603_1608Metric
C53, C54: 560p; C_0603_1608Metric
C55, C56: 22n; C_0603_1608Metric
NOISE_OUT1: XLR3; Jack_XLR_Neutrik_NC3MAH-0_Horizontal
R35, R36: 1k; R_0603_1608Metric
R37, R38, R63, R64, R65, R66: 100k; R_0603_1608Metric
R39, R40: 6k; R_0603_1608Metric
R41, R42: 18k; R_0603_1608Metric
R43, R44: 44.2k; R_0603_1608Metric
R45, R46: 86.6k; R_0603_1608Metric
R47, R48: 45.3k; R_0603_1608Metric
R49, R50: 121k; R_0603_1608Metric
R51, R52: 31.6k; R_0603_1608Metric
R53, R55: 261k; R_0603_1608Metric
R54, R56, R57, R58: 2k; R_0603_1608Metric
R59, R60, R61, R62: 100; R_0603_1608Metric
U5, U6: TL074; TL074CD
U7, U8: TL071; TL071CD

Connections:
+12VA: C42.1, C45.1, C49.1, C51.1, U5.4 (V+), U6.4 (V+), U7.7 (V+), U8.7 (V+); also elsewhere on the board
-12VA: C43.1, C46.1, C50.1, C52.1, U5.11 (V-), U6.11 (V-), U7.4 (V-), U8.4 (V-); also elsewhere on the board
/ADC/DAC/DAC_NOISE: R36.2; also elsewhere on the board
/ADC/DAC/DAC_OUT: R35.2; also elsewhere on the board
GND: ANIT_OUT1.1, C33.2, C34.2, C37.2, C38.2, C41.2, C42.2, C43.2, C44.2, C45.2, C46.2, C49.2, C50.2, C51.2, C52.2, C53.2, C54.2, C60.2, C62.2, C63.2, C64.2, NOISE_OUT1.1, R37.2, R38.2, R39.2, R40.2, R63.2, R64.2, R65.2, R66.2, U7.3 (+), U8.3 (+); also elsewhere on the board
unnamed: ANIT_OUT1.2, C57.2, C63.1, R63.1
unnamed: ANIT_OUT1.3, C59.2, C60.1, R65.1
unnamed: C33.1, C35.1, R35.1
unnamed: C34.1, C36.1, R36.1
unnamed: C35.2, R37.1, U5.3 (+)
unnamed: C36.2, R38.1, U6.3 (+)
unnamed: C37.1, R45.1, U5.5 (+)
unnamed: C38.1, R46.1, U6.5 (+)
unnamed: C39.1, R43.1, R45.2
unnamed: C39.2, R47.2, U5.6 (-), U5.7
unnamed: C40.1, R44.1, R46.2
unnamed: C40.2, R48.2, U6.6 (-), U6.7
unnamed: C41.1, R49.1, U5.10 (+)
unnamed: C44.1, R50.1, U6.10 (+)
unnamed: C47.1, R47.1, R49.2
unnamed: C47.2, R51.2, U5.8, U5.9 (-)
unnamed: C48.1, R48.1, R50.2
unnamed: C48.2, R52.2, U6.8, U6.9 (-)
unnamed: C53.1, R53.1, U5.12 (+)
unnamed: C54.1, R55.1, U6.12 (+)
unnamed: C55.1, R51.1, R53.2
unnamed: C55.2, R54.1, R61.2, U5.13 (-), U5.14
unnamed: C56.1, R52.1, R55.2
unnamed: C56.2, R56.1, R62.2, U6.13 (-), U6.14
unnamed: C57.1, R59.1
unnamed: C58.1, R60.1
unnamed: C58.2, C62.1, NOISE_OUT1.2, R64.1
unnamed: C59.1, R61.1
unnamed: C61.1, R62.1
unnamed: C61.2, C64.1, NOISE_OUT1.3, R66.1
unnamed: R39.1, R41.2, U5.2 (-)
unnamed: R40.1, R42.2, U6.2 (-)
unnamed: R41.1, R43.2, U5.1
unnamed: R42.1, R44.2, U6.1
unnamed: R54.2, R57.2, U7.2 (-)
unnamed: R56.2, R58.2, U8.2 (-)
unnamed: R57.1, R59.2, U7.6
unnamed: R58.1, R60.2, U8.6

Notes on the sheet:
Place C60 and C63 as close to the connector as possible
Output
Gain = 20 dB
RC and CR combination for cutting possible noises and constant component removal.
Single ended to differential. Same RC and CR combination as input.
Noise output processing
Same filter as input.
Antinoise output processing

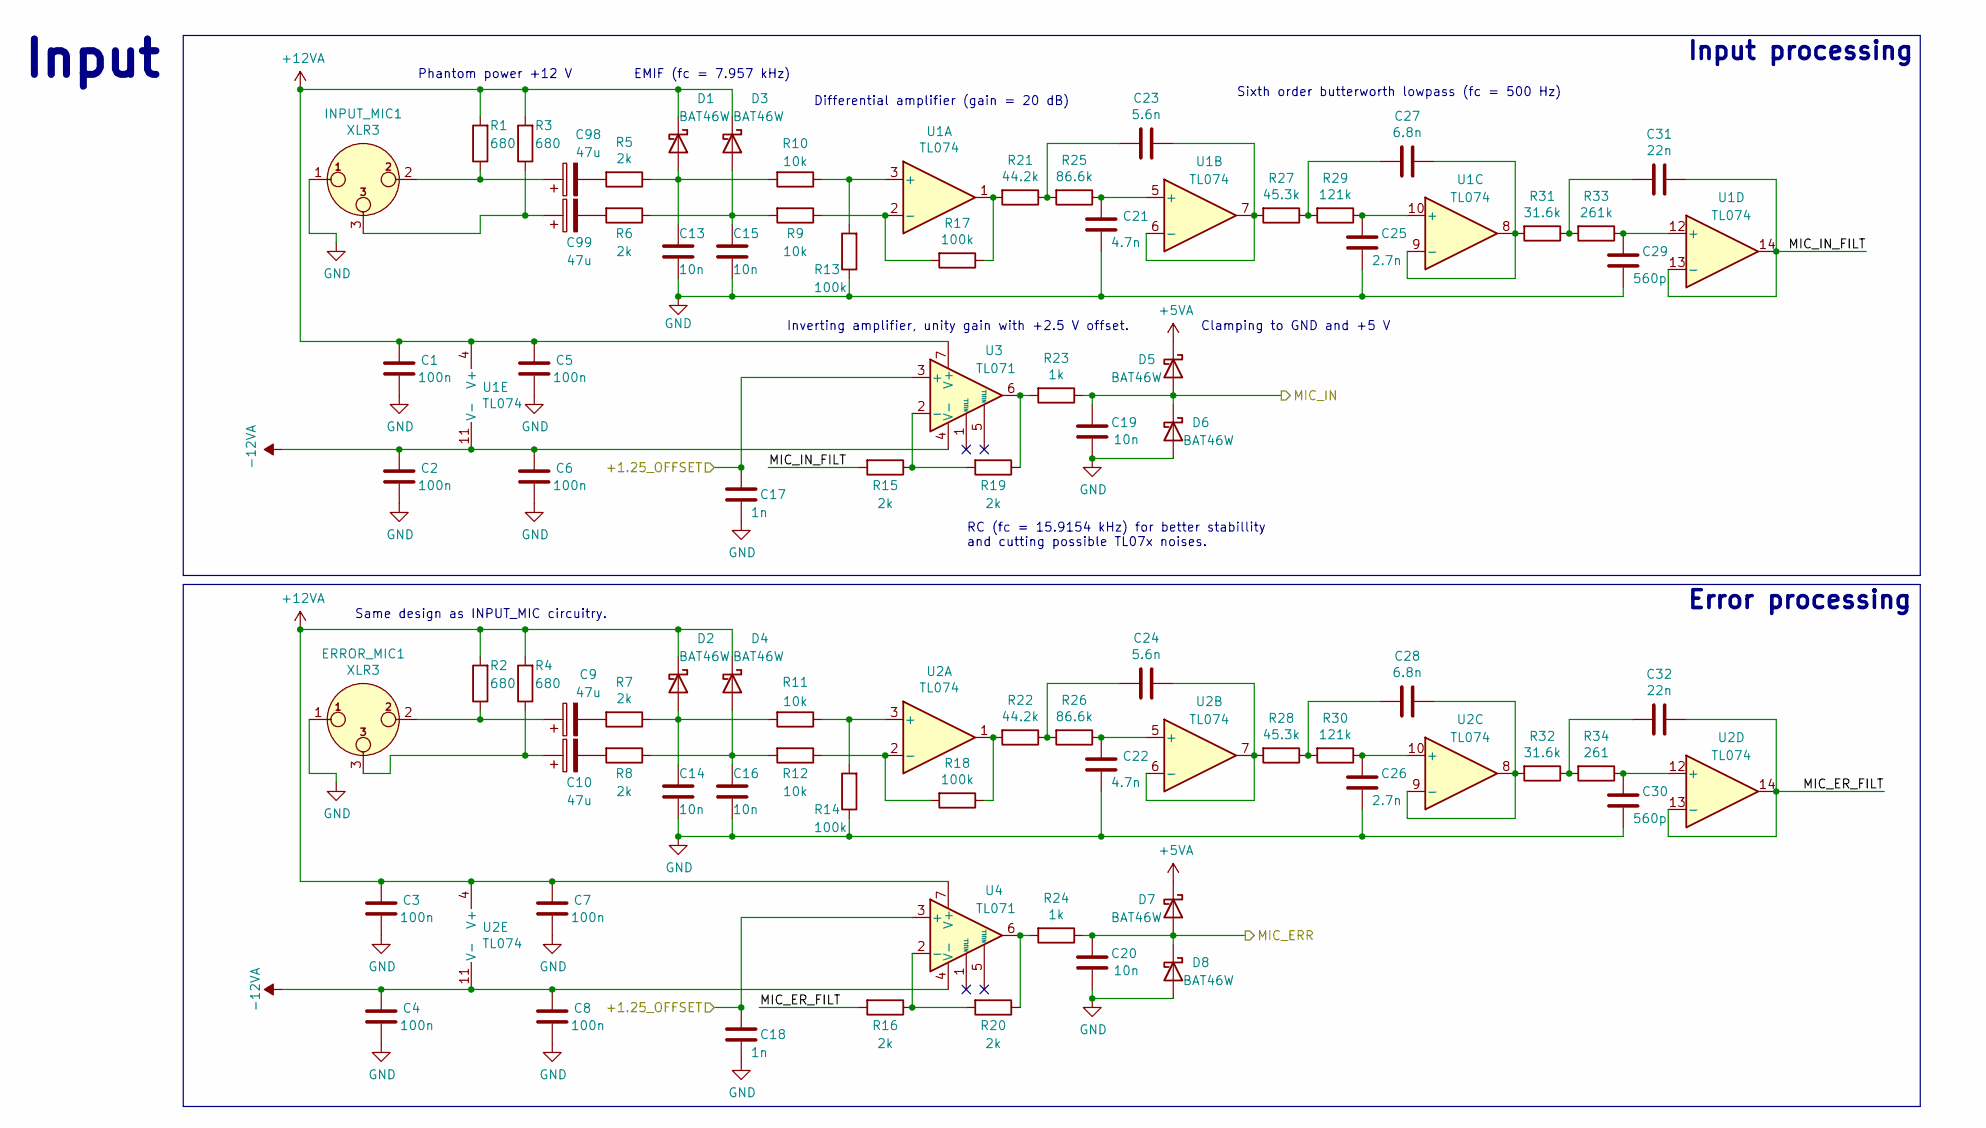
[picture p435: schematic input.kicad_sch, Active noise reduction development board - input]

Parts:
C1, C2, C3, C4, C5, C6, C7, C8: 100n; C_0603_1608Metric
C9, C10, C98, C99: 47u; CP_Elec_6.3x7.7
C13, C14, C15, C16, C19, C20: 10n; C_0603_1608Metric
C17, C18: 1n; C_0603_1608Metric
C21, C22: 4.7n; C_0603_1608Metric
C23, C24: 5.6n; C_0603_1608Metric
C25, C26: 2.7n; C_0603_1608Metric
C27, C28: 6.8n; C_0603_1608Metric
C29, C30: 560p; C_0603_1608Metric
C31, C32: 22n; C_0603_1608Metric
D1, D2, D3, D4, D5, D6, D7, D8: BAT46W; D_SOD-123F
ERROR_MIC1: XLR3; Jack_XLR_Neutrik_NC3MAH-0_Horizontal
INPUT_MIC1: XLR3; Jack_XLR_Neutrik_NC3MAH-0_Horizontal
R1, R2, R3, R4: 680; R_0805_2012Metric
R5, R6, R7, R8, R15, R16, R19, R20: 2k; R_0603_1608Metric
R9, R10, R11, R12: 10k; R_0603_1608Metric
R13, R14, R17, R18: 100k; R_0603_1608Metric
R21, R22: 44.2k; R_0603_1608Metric
R23, R24: 1k; R_0603_1608Metric
R25, R26: 86.6k; R_0603_1608Metric
R27, R28: 45.3k; R_0603_1608Metric
R29, R30: 121k; R_0603_1608Metric
R31, R32: 31.6k; R_0603_1608Metric
R33: 261k; R_0603_1608Metric
R34: 261; R_0603_1608Metric
U1, U2: TL074; TL074CD
U3, U4: TL071; TL071CD

Connections:
+5VA: D5.1 (K), D7.1 (K); also elsewhere on the board
+12VA: C1.1, C3.1, C5.1, C7.1, D1.1 (K), D2.1 (K), D3.1 (K), D4.1 (K), R1.2, R2.2, R3.2, R4.2, U1.4 (V+), U2.4 (V+), U3.7 (V+), U4.7 (V+); also elsewhere on the board
-12VA: C2.1, C4.1, C6.1, C8.1, U1.11 (V-), U2.11 (V-), U3.4 (V-), U4.4 (V-); also elsewhere on the board
/ADC/DAC/MIC_ERR: C20.1, D7.2 (A), D8.1 (K), R24.1; also elsewhere on the board
/ADC/DAC/MIC_IN: C19.1, D5.2 (A), D6.1 (K), R23.1; also elsewhere on the board
/Input/+1.25_OFFSET: C17.1, C18.1, U3.3 (+), U4.3 (+); also elsewhere on the board
/Input/MIC_ER_FILT: C32.2, R16.2, U2.13 (-), U2.14
/Input/MIC_IN_FILT: C31.2, R15.2, U1.13 (-), U1.14
GND: C1.2, C2.2, C3.2, C4.2, C5.2, C6.2, C7.2, C8.2, C13.2, C14.2, C15.2, C16.2, C17.2, C18.2, C19.2, C20.2, C21.2, C22.2, C25.2, C26.2, C29.2, C30.2, D6.2 (A), D8.2 (A), ERROR_MIC1.1, INPUT_MIC1.1, R13.1, R14.1; also elsewhere on the board
unnamed: C9.1, ERROR_MIC1.2, R2.1
unnamed: C9.2, R7.2
unnamed: C10.1, ERROR_MIC1.3, R4.1
unnamed: C10.2, R8.2
unnamed: C13.1, D1.2 (A), R5.1, R10.2
unnamed: C14.1, D2.2 (A), R7.1, R11.2
unnamed: C15.1, D3.2 (A), R6.1, R9.2
unnamed: C16.1, D4.2 (A), R8.1, R12.2
unnamed: C21.1, R25.1, U1.5 (+)
unnamed: C22.1, R26.1, U2.5 (+)
unnamed: C23.1, R21.1, R25.2
unnamed: C23.2, R27.2, U1.6 (-), U1.7
unnamed: C24.1, R22.1, R26.2
unnamed: C24.2, R28.2, U2.6 (-), U2.7
unnamed: C25.1, R29.1, U1.10 (+)
unnamed: C26.1, R30.1, U2.10 (+)
unnamed: C27.1, R27.1, R29.2
unnamed: C27.2, R31.2, U1.8, U1.9 (-)
unnamed: C28.1, R28.1, R30.2
unnamed: C28.2, R32.2, U2.8, U2.9 (-)
unnamed: C29.1, R33.1, U1.12 (+)
unnamed: C30.1, R34.1, U2.12 (+)
unnamed: C31.1, R31.1, R33.2
unnamed: C32.1, R32.1, R34.2
unnamed: C98.1, INPUT_MIC1.2, R1.1
unnamed: C98.2, R5.2
unnamed: C99.1, INPUT_MIC1.3, R3.1
unnamed: C99.2, R6.2
unnamed: R10.1, R13.2, U1.3 (+)
unnamed: R11.1, R14.2, U2.3 (+)
unnamed: R12.1, R18.2, U2.2 (-)
unnamed: R15.1, R19.2, U3.2 (-)
unnamed: R16.1, R20.2, U4.2 (-)
unnamed: R17.1, R21.2, U1.1
unnamed: R9.1, R17.2, U1.2 (-)
unnamed: R18.1, R22.2, U2.1
unnamed: R19.1, R23.2, U3.6
unnamed: R20.1, R24.2, U4.6

Notes on the sheet:
Phantom power +12 V
Same design as INPUT_MIC circuitry.
Differential amplifier (gain = 20 dB)
Sixth order butterworth lowpass (fc = 500 Hz)
RC (fc = 15.9154 kHz) for better stabillity and cutting possible TL07x noises.
Clamping to GND and +5 V
Error processing
Input
Inverting amplifier, unity gain with +2.5 V offset.
Input processing
EMIF (fc = 7.957 kHz)

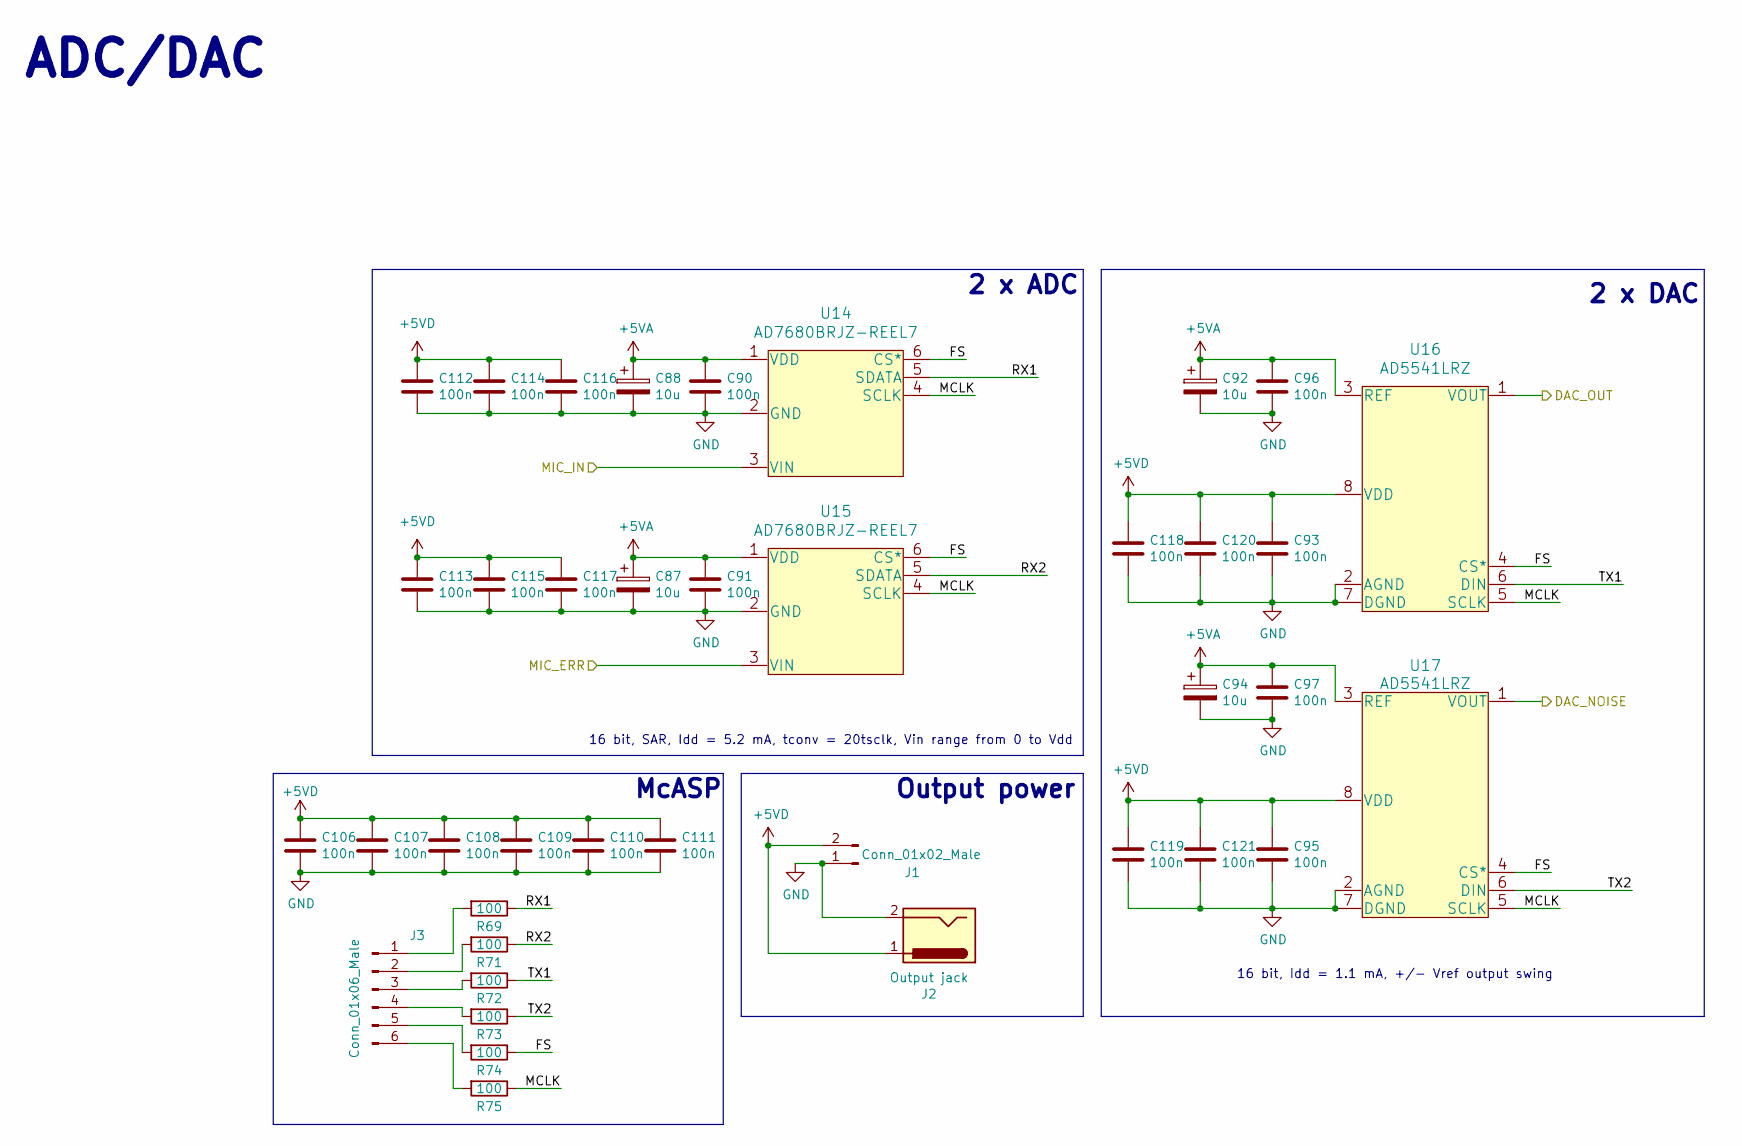
[picture p436: schematic adc_dac.kicad_sch, Active noise reduction development board - adc/dac]

Parts:
C87, C88, C92, C94: 10u; CP_Elec_6.3x5.8
C90, C91, C93, C95, C96, C97, C106, C107, C108, C109, C110, C111, C112, C113, C114, C115, C116, C117, C118, C119, C120, C121: 100n; C_0603_1608Metric
J1: Conn_01x02_Male; PinHeader_1x02_P2.54mm_Vertical
J2: Output jack; BarrelJack_Horizontal
J3: Conn_01x06_Male; PinHeader_1x06_P2.54mm_Vertical
R69, R71, R72, R73, R74, R75: 100; R_0603_1608Metric
U14, U15: AD7680BRJZ-REEL7
U16, U17: AD5541LRZ

Connections:
+5VA: C87.1, C88.1, C90.1, C91.1, C92.1, C94.1, C96.1, C97.1, U14.1 (VDD), U15.1 (VDD), U16.3 (REF), U17.3 (REF); also elsewhere on the board
+5VD: C93.1, C95.1, C106.1, C107.1, C108.1, C109.1, C110.1, C111.1, C112.1, C113.1, C114.1, C115.1, C116.1, C117.1, C118.1, C119.1, C120.1, C121.1, J1.2, J2.1, U16.8 (VDD), U17.8 (VDD); also elsewhere on the board
/ADC/DAC/DAC_NOISE: U17.1 (VOUT); also elsewhere on the board
/ADC/DAC/DAC_OUT: U16.1 (VOUT); also elsewhere on the board
/ADC/DAC/FS: R74.1, U14.6 (CS*), U15.6 (CS*), U16.4 (CS*), U17.4 (CS*)
/ADC/DAC/MCLK: R75.1, U14.4 (SCLK), U15.4 (SCLK), U16.5 (SCLK), U17.5 (SCLK)
/ADC/DAC/MIC_ERR: U15.3 (VIN); also elsewhere on the board
/ADC/DAC/MIC_IN: U14.3 (VIN); also elsewhere on the board
/ADC/DAC/RX1: R69.1, U14.5 (SDATA)
/ADC/DAC/RX2: R71.1, U15.5 (SDATA)
/ADC/DAC/TX1: R72.1, U16.6 (DIN)
/ADC/DAC/TX2: R73.1, U17.6 (DIN)
GND: C87.2, C88.2, C90.2, C91.2, C92.2, C93.2, C94.2, C95.2, C96.2, C97.2, C106.2, C107.2, C108.2, C109.2, C110.2, C111.2, C112.2, C113.2, C114.2, C115.2, C116.2, C117.2, C118.2, C119.2, C120.2, C121.2, J1.1, J2.2, U14.2 (GND), U15.2 (GND), U16.2 (AGND), U16.7 (DGND), U17.2 (AGND), U17.7 (DGND); also elsewhere on the board
unnamed: J3.1, R69.2
unnamed: J3.2, R71.2
unnamed: J3.3, R72.2
unnamed: J3.4, R73.2
unnamed: J3.5, R74.2
unnamed: J3.6, R75.2

Notes on the sheet:
2 x ADC
16 bit, Idd = 1.1 mA, +/- Vref output swing
2 x DAC
16 bit, SAR, Idd = 5.2 mA, tconv = 20tsclk, Vin range from 0 to Vdd
McASP
ADC/DAC
Output power

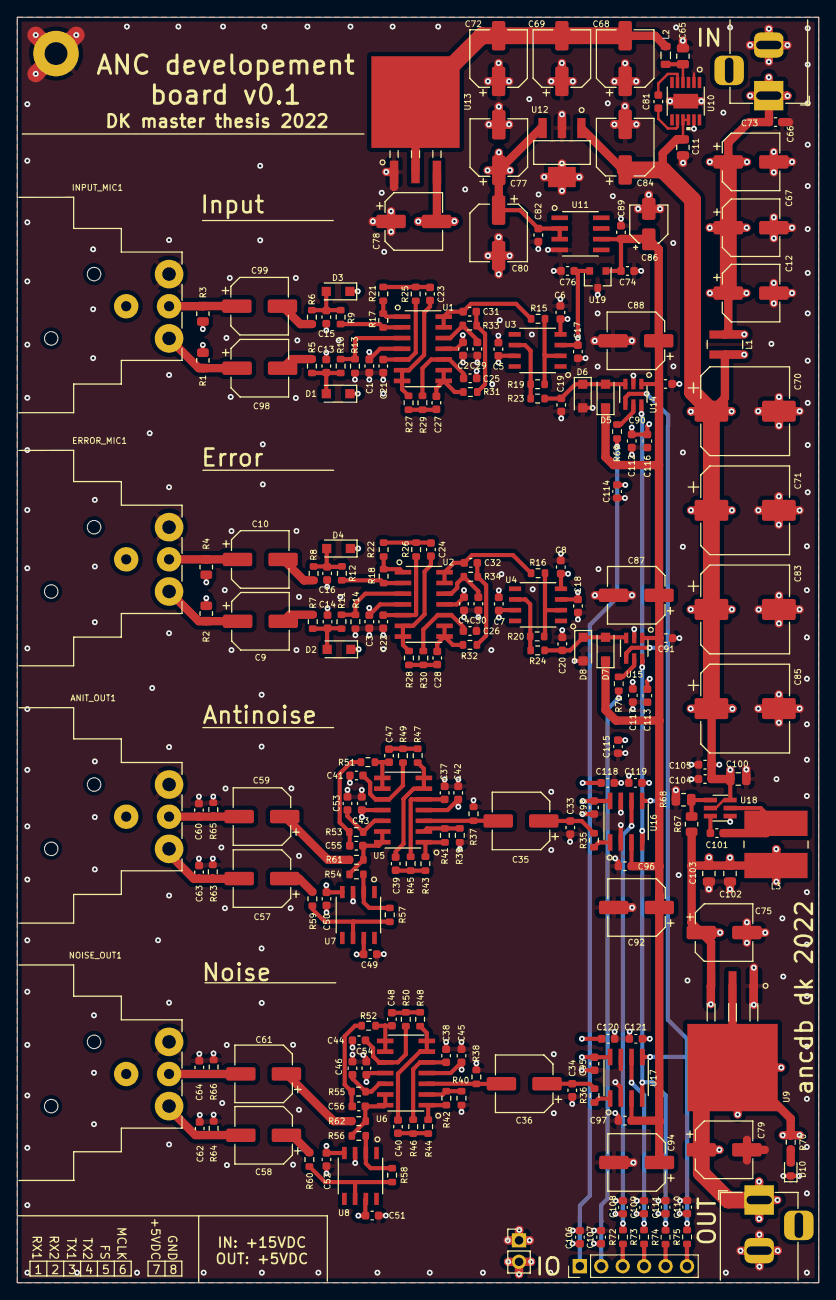
[picture p437: board main.kicad_pcb from above]

Board: 4 copper layers, 95.0 x 150.0 mm, 236 parts (0 on the bottom side), 111 nets.
