kopiecki/anc/hardware/kicad/in_input.kicad_pcb

## KiCad design hardware/kicad/in_input.kicad_pcb (2022-11-15)

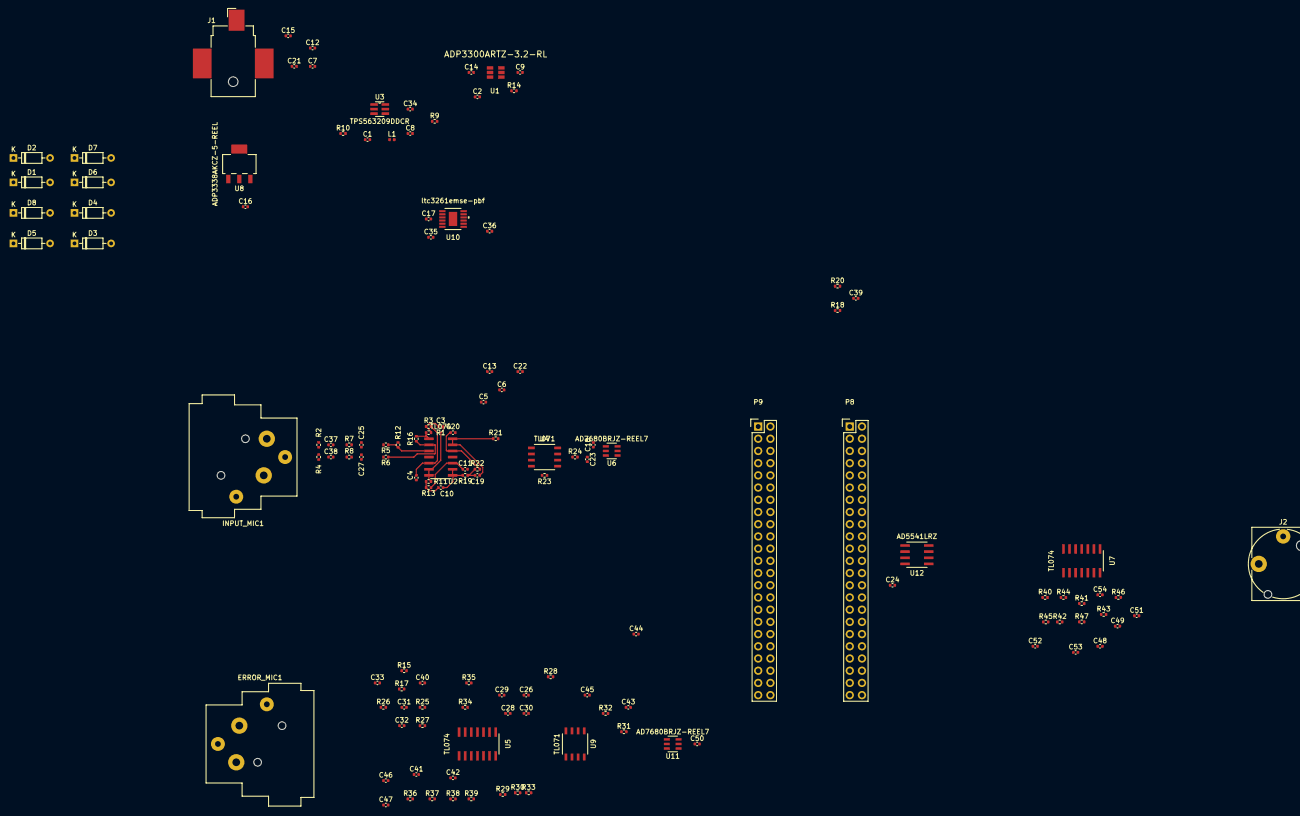
[picture p438: board in_input.kicad_pcb from above]

Board: 2 copper layers, 128 parts (0 on the bottom side), 72 nets.

Parts:
C1, C15, C18, C21, C24, C35, C36, C39, C50: 10u; C_0402_1005Metric
C2, C9: 0.47u; C_0402_1005Metric
C3, C43, C49: 2.5n; C_0402_1005Metric
C4, C42, C48: 2n; C_0402_1005Metric
C5, C6, C8, C13, C22, C26, C28, C29, C30: 100n; C_0402_1005Metric
C7, C12: 1m; C_0402_1005Metric
C10, C45, C52: 3.3n; C_0402_1005Metric
C11, C44, C51: 1.3n; C_0402_1005Metric
C14, C16, C17: 1u; C_0402_1005Metric
C19, C47, C54: 9n; C_0402_1005Metric
C20, C46, C53: 44n; C_0402_1005Metric
C23, C41: 27n; C_0402_1005Metric
C25, C27, C33, C40: 1n; C_0402_1005Metric
C31, C32, C34, C37, C38: 22u; C_0402_1005Metric
D1, D2, D3, D4, D5, D6, D7, D8: BAT46W; D_DO-35_SOD27_P7.62mm_Horizontal
ERROR_MIC1: XLR3; Jack_XLR_Neutrik_NC3FAH2_Horizontal
INPUT_MIC1: XLR3; Jack_XLR_Neutrik_NC3FAH2_Horizontal
J1: Jack-DC; BarrelJack_CUI_PJ-036AH-SMT_Horizontal
J2: AudioJack2; Jack_6.35mm_Neutrik_NJ2FD-V_Vertical
L1: 3.3u; L_0402_1005Metric
P8, P9: BeagleBone_Black_Header; Socket_BeagleBone_Black
R1, R11, R19, R34, R36, R38, R42, R44, R46: 47k; R_0402_1005Metric
R2, R4, R5, R6, R7, R8, R15, R17, R21, R23, R25, R26, R27, R28, R29, R30: 1k; R_0402_1005Metric
R3, R35, R43: 100k; R_0402_1005Metric
R9: 82.5k; R_0402_1005Metric
R10, R12, R16, R18, R20, R31, R32: 10k; R_0402_1005Metric
R13, R37, R45: 120k; R_0402_1005Metric
R14: 330k; R_0402_1005Metric
R22, R39, R47: 140k; R_0402_1005Metric
R24, R33: 33; R_0402_1005Metric
R40: 2k; R_0402_1005Metric
R41: 18k; R_0402_1005Metric
U1: ADP3300ARTZ-3.2-RL; Analog_Devices-ADP3300ARTZ-3.2-RL-Level_A
U2, U5, U7: TL074; TL074CD
U3: TPS563209DDCR
U4, U9: TL071; TL071CD
U6, U11: AD7680BRJZ-REEL7
U8: ADP3338AKCZ-5-REEL
U10: ltc3261emse-pbf
U12: AD5541LRZ

Connections:
+15V: C1.1, C5.1, C7.1, C12.1, C13.1, C15.1, C21.1, C26.1, C29.1, C35.1, D1.1, D2.1, D3.1, D5.1, D6.1, D7.1, J1.1, R2.2, R4.2, R15.2, R17.2, U3.3, U3.5, U4.7, U5.4, U7.4, U9.7, U10.9, U10.10
/+2.5_VDC_OFF: C39.1, R18.1, R20.1, U4.3, U9.3
/+5_VDC_REF: C9.1, C18.1, C24.1, C50.1, R14.1, R18.2, U1.4, U6.1, U11.1, U12.3, U12.8
/+5_VDC_SYS: C16.1, U8.2
/-15_VDC_IN: C6.1, C22.1, C28.1, C30.1, C36.1, U4.4, U5.11, U7.11, U9.4, U10.4
/SPI0_CS0: P9.17, U6.6
/SPI0_CS1: P9.19, U11.6
/SPI0_D0: P9.21, U6.5, U11.5
/SPI0_SCLK: P9.22, U6.4, U11.4
/V_DAC: U7.3, U12.1
/V_MIC_ERR: C41.1, R33.1, U11.3
/V_MIC_ERR_FILT: C47.2, R29.2, U5.13, U5.14
/V_MIC_IN: C23.1, R24.1, U6.3
/V_MIC_IN_FILT: C19.2, R21.2, U2.13, U2.14
GND: C1.2, C2.2, C4.2, C5.2, C6.2, C7.2, C9.2, C11.2, C12.2, C13.2, C14.2, C15.2, C16.2, C18.2, C20.2, C21.2, C22.2, C23.2, C24.2, C25.2, C26.2, C27.2, C28.2, C29.2, C30.2, C33.2, C34.2, C35.2, C36.2, C39.2, C40.2, C41.2, C42.2, C44.2, C46.2, C48.2, C50.2, C51.2, C53.2, D4.2, D8.2, ERROR_MIC1.1, INPUT_MIC1.1, J1.2, J2.S, P9.43, P9.44, P9.45, P9.46, R10.2, R12.1, R20.2, R31.1, R40.2, U1.1, U3.1, U6.2, U8.3, U10.2, U10.11, U11.2, U12.2, U12.7
unnamed: C3.1, R1.1, R3.2
unnamed: C3.2, R11.2, U2.6, U2.7
unnamed: C4.1, R3.1, U2.5
unnamed: C8.1, L1.1, U3.2
unnamed: C8.2, U3.6
unnamed: C10.1, R11.1, R13.2
unnamed: C10.2, R19.2, U2.8, U2.9
unnamed: C11.1, R13.1, U2.10
unnamed: C2.1, C14.1, C34.1, L1.2, R9.1, U1.3, U1.5, U8.1
unnamed: C17.1, U10.5
unnamed: C17.2, U10.8
unnamed: C19.1, R19.1, R22.2
unnamed: C20.1, R22.1, U2.12
unnamed: C25.1, R5.2, R7.1
unnamed: C27.1, R6.2, R8.1
unnamed: C31.1, ERROR_MIC1.2, R15.1
unnamed: C31.2, R25.2
unnamed: C32.1, ERROR_MIC1.3, R17.1
unnamed: C32.2, R26.2
unnamed: C33.1, R25.1, R27.2
unnamed: C37.1, INPUT_MIC1.2, R2.1
unnamed: C37.2, R7.2
unnamed: C38.1, INPUT_MIC1.3, R4.1
unnamed: C38.2, R8.2
unnamed: C40.1, R26.1, R28.2
unnamed: C42.1, R35.1, U5.5
unnamed: C43.1, R34.1, R35.2
unnamed: C43.2, R36.2, U5.6, U5.7
unnamed: C44.1, R37.1, U5.10
unnamed: C45.1, R36.1, R37.2
unnamed: C45.2, R38.2, U5.8, U5.9
unnamed: C46.1, R39.1, U5.12
unnamed: C47.1, R38.1, R39.2
unnamed: C48.1, R43.1, U7.5
unnamed: C49.1, R42.1, R43.2
unnamed: C49.2, R44.2, U7.6, U7.7
unnamed: C51.1, R45.1, U7.10
unnamed: C52.1, R44.1, R45.2
unnamed: C52.2, R46.2, U7.8, U7.9
unnamed: C53.1, R47.1, U7.12
unnamed: C54.1, R46.1, R47.2
unnamed: C54.2, J2.T, U7.13, U7.14
unnamed: D1.2, R5.1, R12.2, U2.3
unnamed: D2.2, R6.1, R16.2, U2.2
unnamed: D3.2, D4.1, R23.1, R24.2, U4.6
unnamed: D5.2, R27.1, R31.2, U5.3
unnamed: D6.2, R28.1, R32.2, U5.2
unnamed: D7.2, D8.1, R30.1, R33.2, U9.6
unnamed: P8.1, P8.2, P9.1, P9.2
unnamed: R1.2, R16.1, U2.1
unnamed: R9.2, R10.1, U3.4
unnamed: R14.2, U1.6
unnamed: R21.1, R23.2, U4.2
unnamed: R29.1, R30.2, U9.2
unnamed: R32.1, R34.2, U5.1
unnamed: R40.1, R41.2, U7.2
unnamed: R41.1, R42.2, U7.1
