kopiecki/anc/software/program/application/main.c

/**
 ******************************************************************************
 * @file    main.c
 * @author  Daniel Kopiecki
 * @date    2022-11-05
 * @brief   <Provide some short description here>
 ******************************************************************************
 */


/* Includes ---------------------------------------------------------------- */


/* Constants and macros ---------------------------------------------------- */
// clang-format off


// clang-format on

/* Private types ----------------------------------------------------------- */


/* Private variables ------------------------------------------------------- */


/* Private functions ------------------------------------------------------- */


/* Exposed API ------------------------------------------------------------- */

int main(int argc, char** argv)
{
    return 0;
}

/**** END OF FILE ****/
