kopiecki/anc/(commit log)

2022-10-27 docs and full schematic
2022-11-09 new schematics
2022-11-15 schematics redux
2022-11-16 LC filter
2022-11-30 schematics fixes
2022-12-19 pcb design
2022-12-19 pcb cleanups
2022-12-20 pcb fixes
2022-12-21 pcb work
2022-12-22 PCB: copper mid
2022-12-26 digital power reference
2023-01-03 GND zone fills on bottom and top, terminating resistors for digital signals
2023-03-18 Basic alsa driver
2023-03-19 Added ALSA sound card driver (WIP)
2023-03-28 Added circural lifo and couple unit tests
2023-03-30 Added couple circ_fifo unit tests
2023-04-18 saved work from couple of days
2023-07-17 work from couple days
2023-07-25 Working on thesis document, added couple hardware chapters
2023-08-15 Removed KiCAD backup files
2023-10-16 Added measurements from couple of days
2023-10-23 Review changes, stage 1
2023-10-24 Review changes, stage 2
2023-10-25 Review changes, stage 2.5
2023-10-26 Review changes, stage 3
2023-10-26 Couple fixes
2023-10-26 Review changes, stage 3.5
2023-10-28 Review changes, stage 4
2023-10-30 Couple review changes
2023-11-17 Added couple lines to final presentation
