kopiecki/anc/(notices)

Notices in the files:
software/software/app/anc/src/main.c:
This program is free software; you can redistribute it and/or modify
it under the terms of the GNU General Public License as published by
the Free Software Foundation; either version 2 of the License, or
(at your option) any later version.
docs/polsl/sd3/build/sd_kopiecki_3.pdf:
Jest oparte na licencji GNU General Public License v2 i pocz ˛atkowo stanowiło wolny odpowiednik systemu UNIX.
parts and their libraries:
Copyright 2021 Accelerated Designs. All rights reserved.
