kopiecki/anc/docs/polsl/temporary_project/build/images/image.jpg

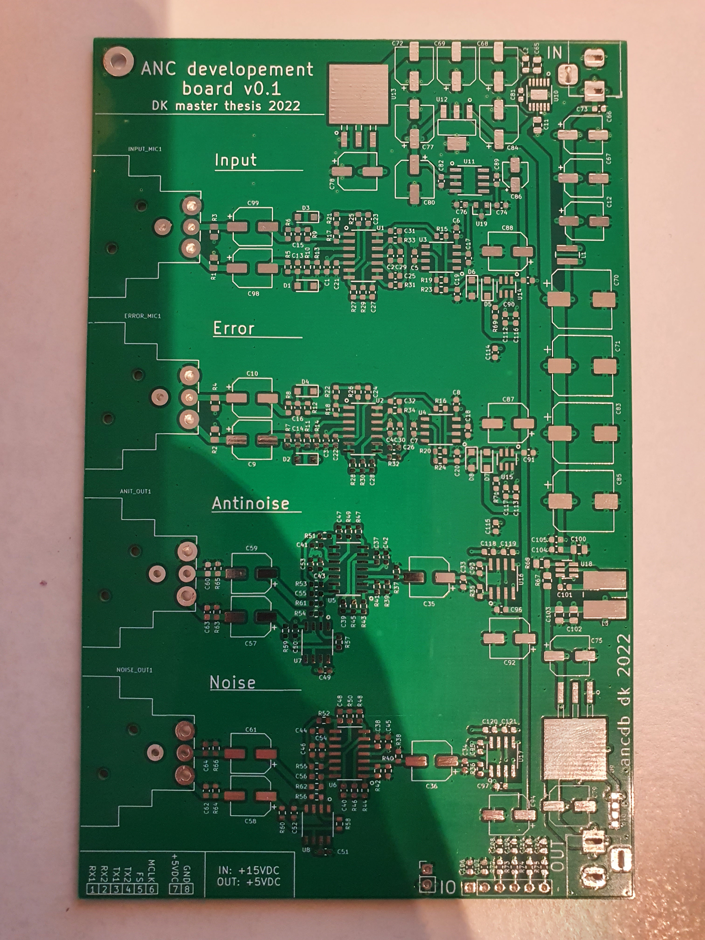
[picture p239: docs/polsl/temporary_project/build/images/image.jpg]
docs/polsl/temporary_project/build/images/image.jpg
